autorope/donkeycar/docs/hardware/trooper-top_plate.dxf

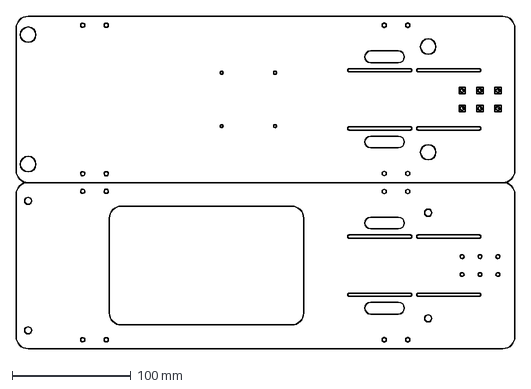
[picture p2: CAD file, 2017-01-28, last stored version]
docs/hardware/trooper-top_plate.dxf
420.0 x 280.0 mm
