autorope/donkeycar/docs/hardware/camera_holder.stl

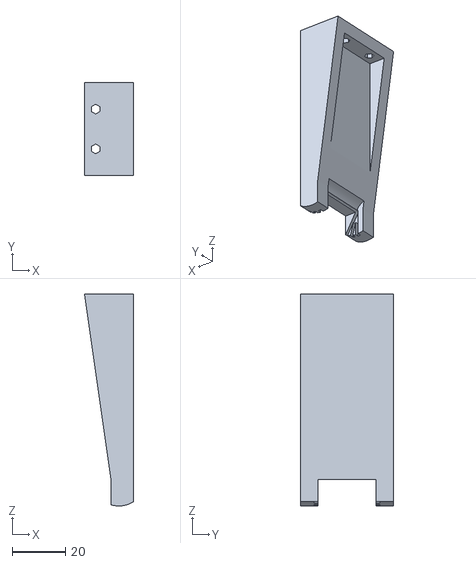
[picture p3: CAD file, 2017-01-10, last stored version]
docs/hardware/camera_holder.stl
18.5 x 35.0 x 80.0
