autorope/donkeycar/docs/hardware/hellion_conquest-roll_bars.stl

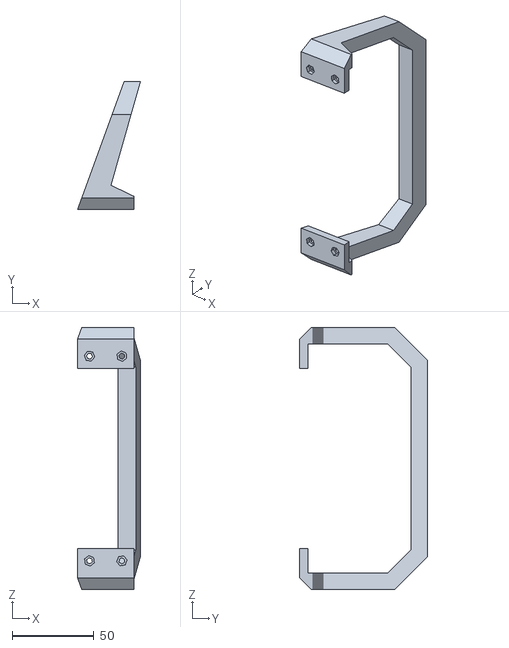
[picture p4: CAD file, 2017-01-10, last stored version]
docs/hardware/hellion_conquest-roll_bars.stl
38.4 x 78.0 x 160.0
