autorope/donkeycar/Hardware/Camera Holder.stl

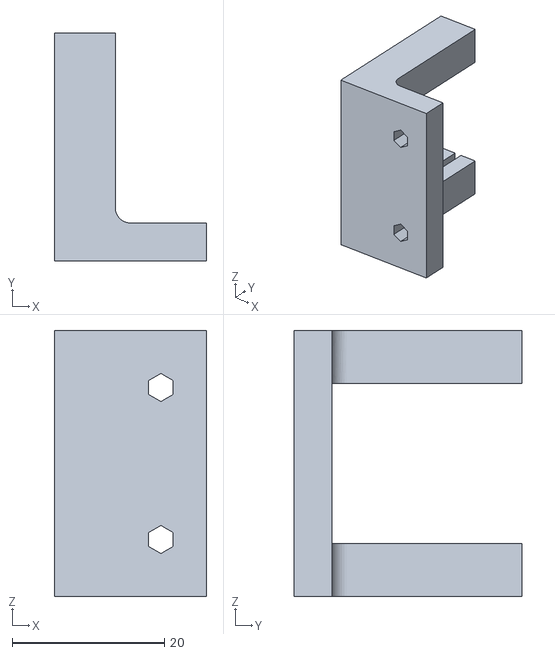
[picture p5: CAD file, 2017-01-10, last stored version]
Hardware/Camera Holder.stl
20.0 x 30.0 x 35.0
