autorope/donkeycar/(list of files, cad)

Other CAD files:
docs/hardware/hellion_conquest-base_plates.dwg
Hardware/Car Top Plate - Helion Conquest.dwg
Hardware/Top And Bottom Plate-Will Car.dwg
docs/hardware/hellion_conquest-top_plate.dwg
hardware/Top And Bottom Plate-Will Car.dwg
