autorope/donkeycar/(threads)

Thread 18 (2017-01-16):

Error while driving. Adafruit servo hat write error.

wroscoe, 2017-01-16:
After driving 10 minutes, the car stopped responding and updating images. This was the error from on the pi.

```
/usr/lib/python3/dist-packages/picamera/encoders.py:545: PiCameraResolutionRoun$
  width, height, fwidth, fheight)))
123
angle: -6   throttle: 46
remote client: {"angle": "-6", "throttle": "46"}
Traceback (most recent call last):
  File "demos/drive_pi.py", line 55, in <module>
    car.start()
  File "/home/pi/code/donkey/donkey/vehicles.py", line 39, in start
    self.steering_actuator.update(angle)
  File "/home/pi/code/donkey/donkey/actuators.py", line 73, in update
    self.pwm.set_pwm(self.channel, 0, pulse)
  File "/home/pi/code/donkey/env/lib/python3.4/site-packages/Adafruit_PCA9685/P$
    self._device.write8(LED0_ON_L+4*channel, on & 0xFF)
  File "/home/pi/code/donkey/env/lib/python3.4/site-packages/Adafruit_GPIO/I2C.$
    self._bus.write_byte_data(self._address, register, value)
  File "/home/pi/code/donkey/env/lib/python3.4/site-packages/Adafruit_PureIO/sm$
    self._device.write(data)
OSError: [Errno 5] Input/output error

```

kclim2, 2017-10-15:
We trying to use arduino to replace the PCA9685 and get similar i2c error. Ant tips to fix the error?

Closed 2017-02-11.

Thread 20 (2017-01-22):

Implement single mixer class instead of separate throttle/steering classes

yconst, 2017-01-22:
A single "mixer" class that handles command distribution to all actuators is more flexible than separate "throttle" and "steering" classes.
For instance in differential or skid steering one should be aware of both the throttle as well as the steering value to assign correct (PWM) values to the actuators

wroscoe, 2017-01-22:
Good point. I think the best place to add this would be as a new vehicle class that provided this awareness for skid steering vehicles in the drive loop. This library has so far focused on cars that steer by angling the front wheels but this would be a great addition. @adammconway may also have thoughts.

adammconway, 2017-01-22:
Hi @yconst are you considering implementing a car based on differential drive using Donkey? am I understanding the request properly? thanks!

yconst, 2017-01-23:
@adammconway yes indeed, I have a differential steering frame available and am thinking of "emulating" the constraints in "regular" car steering by limiting the difference in throttle to the motors on each side/making it proportional to collective throttle.

adammconway, 2017-01-23:
@yconst that is awesome, so glad you are looking to join us.

@wroscoe feels like differential drive should be a different setup... this goes back to how we abstract out the various hardware.  Downstream if we choose to add odometry and other sensors we will also have further differences.  I know that sensors and actuators are separate now, but I think it is possible we will see interplay between them as we add certain sensors.

wroscoe, 2017-01-23:
@yconst this would be great. We were looking to find a vehicle that could compete on the RGB(colored lines) track.

The place to put a new vehicle build would be below the BaseVehicle class here; https://github.com/wroscoe/donkey/blob/master/donkey/vehicles.py#L3 You could inherit the BaseVehicle class and change the drive loop to use the logic specific to the differential drive vehicle.

@adammconway There is no real difference between sensors and actuators. The files are used only for organization.

yconst, 2017-01-25:
@wroscoe , @adammconway I took the liberty of modifying the actuator code to accommodate for mixing. I've pushed the changes in my fork currently:
https://github.com/yconst/donkey/blob/actuator_mixer/donkey/actuators.py

I'm not sure, but I felt an additional level of abstraction between "vehicle" and "hardware" would make for better distribution of tasks. Thus came the mixer class.

There are also changes to the vehicle and demo classes to accommodate the new actuators class.

Please keep in mind, this is all just a concept, nothing is tested yet.

wroscoe, 2017-01-26:
Great!. I made a pull request for this change and will merge once we have both types of cars working on this branch.

yconst, 2017-01-28:
I fixed some errors in the files and separated them in different modules, ie added mixers.py.

Re. actuators, I saw that the current PWM classes inherited from the Adafruit controller base class. I thought that this could be better achieved by composition over inheritance, so in the latest commit I refactored the code a bit, and now the PWM classes take a "controller" as a init parameter. The controller is the fundamental hardware "driver" (in this case the Adafruit controller), and the PWM functionality is abstracted from the hardware.

This way, other controllers (e.g. I'm using a NAVIO hat) can be easily switched without needing to re-write the PWM workings.

Closed 2017-02-09.

Thread 23 (2017-01-25):

Update build instructions.

wroscoe, 2017-01-25:
Include
* How to pick a car + tested models.
* link to ami image
* Wiring diagram + pictures

yconst, 2017-01-27:
Are the current build instructions up to date? Installing to a RPi2 via the docs at https://github.com/wroscoe/donkey/blob/master/docs/01-build_a_car.md and then trying to run drive_pi.py shows an error about missing docopt. Any ideas?

wroscoe, 2017-01-27:
docopt should be installed when you run `pip install -e ../donkey[pi]` in your virtual environment.

That error should be fixable by installing docopt  in your virtual environment
`pip install docopt`

I'm updating the build instructions to be clearer but the current version should work.

wroscoe, 2017-01-27:
@yconst  Here is the in progress build doc. Please suggest update and add pictures. https://docs.google.com/document/d/11IPqZcDcLTd2mtYaR5ONpDxFgL9Y1nMNTDvEarST8Wk/edit#

yconst, 2017-01-27:
Thanks for sharing! I'll sure chime in if I have any suggestions, although I'm still getting to grips with the entirety of the project!

alanwells, 2017-02-07:
@wroscoe Thanks for this great project! I've got my car built up (based on an [ExceedRC Magnet 1/16 scale truck)](http://www.nitrorcx.com/51c853-savared-24-ghz.html) and steering mostly works (angles are a little off wheels move left/right), but throttle doesn't work at all. The error code on the ESC indicates abnormal throttle signal, so I'm thinking it's a PWM calibration issue. I noticed there was some stubbed out calibration code in the `actuators.py`, do you have any suggestions on where to start on figuring out the correct values?

Also, I have a few notes from going thru the donkey install process on car and server. Do you prefer to receive them as suggestions to the Google Doc or in comments here?

Here are a few pics of the build. The 1/16th scale is a bit cramped but it worked out OK. Happy to take better pics for the build document if it's helpful:

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

wroscoe, 2017-02-07:
That car looks awesome.

For doc suggestions please make them in the Google Doc. https://docs.google.com/document/d/11IPqZcDcLTd2mtYaR5ONpDxFgL9Y1nMNTDvEarST8Wk/edit#

@adammconway will know more about ESC settings but i'd using script that loops through all possible ESC values to find the correct range. If the motor is brushed it will likely need to be calibrated by setting full, 0, reverse throttle values. before using.

alanwells, 2017-02-08:
@wroscoe @adammconway got the throttle calibration issue sorted out. I was making the mistake of turning on the ESC before I had the pilot running on the pi, so the ESC couldn't self-calibrate. I added the Exceed Magnet to the tested vehicle list on the google doc.

Closed 2017-02-09.

Thread 55 (2017-03-02):

Improve small screen UI of vehicle control page

alanwells, 2017-03-02:
Here are some initial thoughts on improvements that I think could be made here:
- Switch to gyroscopic control of vehicle steering and throttle (instead of nipple.js), as this will free up significant screen real estate for other controls. The `DeviceOrientationEvent` API seems to have sufficient cross-platform browser support that it could be used reliably on most iOS and Android phones. More info here: https://developer.mozilla.org/en-US/docs/Web/API/DeviceOrientationEvent
- figure out what the "dead zone" of control should be at the middle of the throttle and steering ranges to make it easy to get to zero throttle/zero steering angle without requiring too precise of a device position. i found I had to figure this out with trial and error on an actual device to get a good feel for it
- optimize the layout for widescreen positioning (more intuitive to hold the phone horizontally when you are using the device position as a steering wheel)
- add an easily accessible start/stop button to the screen to avoid the car running off when you set the phone down :wink:
- Take advantage of the extra on-screen real estate to include controls for:
  - Pilot mode selection
  - Model selection
  - Start/Stop recording toggle

wroscoe, 2017-03-02:
This sounds so much better. Additional control to add is to start and name new session.

I think I'm getting worse ad driving with the current joystick.

Closed 2017-04-25.

Thread 57 (2017-03-02):

Implement odometry with hall effect sensor

alanwells, 2017-03-02:
The plan is to attempt an odometer setup inspired by [this post](https://sites.google.com/site/wayneholder/self-driving-rc-car/mechanical-odometry-and-speed-control).

Here's my initial take on how this might work:
- Mount hall effect sensor to car. @adammconway suggested attempting to sense the motor directly, which would imply mounting the sensor in an axial orientation relative to the motor.
- If we can't accurately sense the motor directly, use small magent(s) mounted on the drive shaft or a gear in the drivetrain and mount sensor in an appropriate place given the location of the magnets.
- Connect hall effect sensor signal pin to one of the Pi's GPIO pins that supports interrupt handling
- Connect hall effect power and ground to the corresponding pins on the servo hat

Reading the sensor:
- Configure the interrupt on the Pi with a [callback function](http://raspi.tv/2013/how-to-use-interrupts-with-python-on-the-raspberry-pi-and-rpi-gpio-part-2) (aka ISR - interrupt service routine) that is called when the sensor signal pin changes state. The minimum here would be to read a single state change (RISING or FALLING), additional precision could be achieved by configuring the interrupt to track both rising and falling changes.
- Inside the ISR, update variables for tracking state changes (those that will need to be read by the drive loop will need to be global):
  - (local) Timestamp of previous state change
  - (global) Time elapsed between previous state change and current state change
  - (global) Total count of state changes

Calculating distance and speed:
- Distance traveled will be informed by the relationship between the point in the drive train that is being monitored by the hall effect sensor and the physical distance traveled by the car for 1 cycle (or one half cycle if we monitor both rising and falling edges) of the hall effect sensor signal. We'll need some constant to tie these two together (something like "feet per hall sensor state change"), which will be vehicle specific. Perhaps this is a new addition to the vehicle config file?
- Velocity will be calculated using the distance above divided by the elapsed time that was recorded in the ISR. Calculating speed using the time elapsed from only the most recent sensor cycle would yield the most recent velocity, but we might find that averaging this over several cycles to yield an average velocity over a slightly longer time period would smooth out the data a bit. Let's start with the 1 cycle calculation and then we can adjust if needed.

Sending distance and velocity back to server:
- TBD @wroscoe do you have any thoughts here?

@wroscoe @adammconway does the above approach sound reasonable to you? Do you have preferences on the units used for distance and velocity?

adammconway, 2017-03-02:
Hi @alanwells, this seems to make sense... I will try something similar for the brushless motor, which might be easier because the rotor is actually a magnet.

As I have thought about how a brushed motor works, it may be hard to get this to work (at a specific location on the can, the coil probably only rotates 60 or 120 degrees, this may not be a big enough change in the b field to trigger the hall effect sensor.  Anyways... still worth experimenting.

What I found with my ESC tests for the brushless motor controller (not the sensored one) was that there is Hysteresis between acceleration and deceleration, this probably means that you will need to implement a pretty aggressive control loop.  I would suggest a PID loop, just keep in mind that this requires a lot of fiddling with the various Gains to get this to work.  I am happy to help with this/code the PID.

alanwells, 2017-03-03:
I failed to notice that the [hall effect sensor from SparkFun](https://www.sparkfun.com/products/9312) will need a level shifter to work directly with the pi's 3.3V logic level pins. I don't have the level shifter parts on hand, so I won't be able to test this tomorrow at the track day. I will bring the parts I ordered, if any of you have a level shifter ([something like this](https://www.sparkfun.com/products/12009)), we might be able to get it hooked up.

alanwells, 2017-03-03:
@adammconway Thanks for the advice here. I've never implemented a PID loop, your help would be much appreciated.

alanwells, 2017-05-08:
@adammconway @wroscoe I have my hall effect sensor mounted and the circuit is working w/ state changes triggered by magnets mounted on the drive shaft. Now it's on to the software side. I think there are at least four pieces to this:

1) Additions to vehicle.ini that enables odometry and defines the wheel circumference to use for distance calculations.
2) An interrupt that counts the wheel rotations and timing data using the output from the hall effect sensor and stores the data in a (global?) variable that can be accessed by the main drive loop
3) A method that calculates velocity based on the last n number of wheel revolutions (as tracked by the interrupt), the timestamps of those state changes, and the circumference of the wheel provided in vehicle.ini.
4) A PID controller class. I think this needs to take current PWM, current velocity, and target velocity as inputs, and should output the new PWM value.
5) Possibly some feedback mechanism to pass velocity (and distance traveled?) back to the server for display in the controller UI, and to be used for labeling images (so we can attempt to train the model to infer velocity w/o hall effect sensor).

Questions for you guys:
1) Does the above description sound reasonable? Are there any modifications that you would suggest?
2) Should we calculate velocity based on only the last rotation or average it over a number of rotations (possibly less precise but likely also less noisy?)
3) From an architecture perspective, it seems like the PID controller should be it's own class, which will then be an optional input into the initialization of vehicle object created [here](https://github.com/wroscoe/donkey/blob/master/scripts/drive.py#L62) in `drive.py` (optional because not every car will have odometry). Does this sound right?

adammconway, 2017-05-08:
I think a float that is something like rising and falling edges per meter or something like that would make sense… I can imagine designs that will have multiple pulses per revolution and also there is a gear ratio between input into the differential and output.

wroscoe, 2017-08-14:
I believe this was implemented with a rotory encoder and is included as a part.

Closed 2017-08-14.

Thread 76 (2017-03-22):

Error starting drive.py

rlyons20, 2017-03-22:
I've tested my motors, using the Adafruit example scripts, and everything is working.

When I get to the last step of starting the remote control, this is the response:

`Traceback (most recent call last):
  File "scripts/drive.py", line 32, in <module>
    mythrottlecontroller = dk.actuators.PCA9685_Controller(cfg['throttle_actuator_channel'])
  File "/home/bob/donkey/donkey/actuators.py", line 34, in __init__
    self.pwm = Adafruit_PCA9685.PCA9685()
  File "/home/bob/donkey/env/lib/python3.4/site-packages/Adafruit_PCA9685/PCA9685.py", line 75, in __init__
    self.set_all_pwm(0, 0)
  File "/home/bob/donkey/env/lib/python3.4/site-packages/Adafruit_PCA9685/PCA9685.py", line 111, in set_all_pwm
    self._device.write8(ALL_LED_ON_L, on & 0xFF)
  File "/home/bob/donkey/env/lib/python3.4/site-packages/Adafruit_GPIO/I2C.py", line 114, in write8
    self._bus.write_byte_data(self._address, register, value)
  File "/home/bob/donkey/env/lib/python3.4/site-packages/Adafruit_PureIO/smbus.py", line 236, in write_byte_data
    self._device.write(data)
OSError: [Errno 5] Input/output error`

wroscoe, 2017-03-22:
I haven't seen this error before but others (outside this project) have had that error:
* http://stackoverflow.com/questions/30325351/ioerror-errno-5-input-output-error-while-using-smbus-for-analog-reading-thr
* https://www.raspberrypi.org/forums/viewtopic.php?f=44&t=17295

I suspect you have a process already using the I2C that conflicts with the attempted write. Try restarting "sudo restart' the pi.

rlyons20, 2017-03-22:
I've restarted a bunch :(

I am using this stepper hat (https://www.adafruit.com/products/2348), instead of the one you spec in your build. Think that might be a problem?

wroscoe, 2017-03-22:
Yes. Thats the motor hat for a differential drive car (one that uses DC motors).

Closed 2017-03-23.

Thread 93 (2017-07-03):

JSON decoder error on startup, fixed by restarting server

twhume, 2017-07-03:
Occasionally when starting drive.py on the Pi, I would see the following error:

pi@raspberrypi:~/donkey $ python scripts/drive.py --remote http://172.20.10.5:8887
Detected running on rasberrypi. Only importing select modules.
Using TensorFlow backend.
center: 410
PiVideoStream loaded.. .warming camera
/usr/lib/python3/dist-packages/picamera/encoders.py:544: PiCameraResolutionRounded: frame size rounded up from 160x120 to 160x128
  width, height, fwidth, fheight)))
Exception in thread Thread-2:
Traceback (most recent call last):
  File "/usr/lib/python3.4/threading.py", line 920, in _bootstrap_inner
    self.run()
  File "/usr/lib/python3.4/threading.py", line 868, in run
    self._target(*self._args, **self._kwargs)
  File "/home/pi/donkey/donkey/remotes.py", line 79, in update
    self.state['milliseconds'],)
  File "/home/pi/donkey/donkey/remotes.py", line 140, in decide
    data = json.loads(r.text)
  File "/usr/lib/python3.4/json/__init__.py", line 318, in loads
    return _default_decoder.decode(s)
  File "/usr/lib/python3.4/json/decoder.py", line 343, in decode
    obj, end = self.raw_decode(s, idx=_w(s, 0).end())
  File "/usr/lib/python3.4/json/decoder.py", line 361, in raw_decode
    raise ValueError(errmsg("Expecting value", s, err.value)) from None
ValueError: Expecting value: line 1 column 1 (char 0)

I've not managed to get repro steps; I found that restarting the Docker container and then retrying the drive.py script with the same arguments worked.

wroscoe, 2017-08-14:
This is an issue when non-json chars or sequences are passed. I haven't seen this recently in the new version.

Closed 2017-08-14.

Thread 107 (2017-08-07):

Feature request - Servo control via PPM instead of I2C

dlarue, 2017-08-07:
There have been some comments about swapping in/out the stock RC controller and since there are only 2 servo controls used( steering / throttle ) an Arduino could do this.  But since the rPi has only 1 hardware PWM, it would be more efficient to stream the servo control via a single PPM stream. This way an Arduino could decode the PPM and drive the servo's.  And with a single digial I/O flag/pin the Arduino could read and use the stock RC receiver signals for training.

zlite, 2017-08-07:
That's what we do with OpenMV, and the Arduino allows both multichannel PWM
output and a wide range of inputs (analog, digital, serial, etc).  We
implement Firmata <https://www.arduino.cc/en/Reference/Firmata> on the
Arduino side, and recommend that be used as the the middleware standard for
I/O.

A standard Arduino Pi ha
<http://www.robotshop.com/en/arduino-adapter-raspberry-pi.html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>t
can work, although a custom shield like we designed for the OpenMV
<https://circuits.io/circuits/4446963-openmv-arduino-shield> simplifies the
wiring.

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

--
◤*CHRIS ANDERSON <https://twitter.com/chr1sa>*
    CEO
    3DR
    website <http://www.3dr.com/> | twitter <https://twitter.com/3drobotics>
 | facebook <http://www.facebook.com/3drobotics> | instagram
<http://www.instagram.com/3drobotics>

dlarue, 2017-08-07:
The more I thought about it, I think keeping I2C from the rPi makes sense since all I'm looking to do is add simple RC control back and if I can do it with a $3 ProMini and replace the Servo Driver($12) too then it's a feature improvement and cost cutter.  The RC control could also enable a remote kill switch via a 3rd channel.

As for adding sensors, an Arduino with Firmata sounds interesting. I'm only familiar with Firmata by using it with Snap4Arduino(Scratch for Arduino).  And idea to keep in the back pocket. Thanks.

Closed 2017-08-21.

Thread 112 (2017-08-21):

VNH5019 and direct control via GPIO

wallarug, 2017-08-21:
Hey,

I'm working on using a Polulu Dual VNH5019 Motor Driver Shield with the donkey car code.  How easy do you think it will be to integrate it to the actuators.py and the project as a whole?

I am in the process of writing a driver similar to the adafruit PCA9685 python library for the VNH5019.  However, the one key difference is that the VNH5019 does not have I2C... it would require using the Raspberry Pi GPIO directly.  From what I can see here, this has not been done before for this project.

I haven't had enough time to comb through all the code on here, so please point me in the right direction if this is functionality already implemented.

1. Can I implement my driver to use the GPIO pins directly (not I2C) with the existing code?
2. How / if the driving component would work under this method?

Thanks in advance.

PS:  Great project and body of code!

wroscoe, 2017-08-21:
This sounds doable and there are examples of accessing the GPIO channels from python. https://sourceforge.net/p/raspberry-gpio-python/wiki/BasicUsage/

To implement you'd create a new actuator part class like those listed here: https://github.com/wroscoe/donkey/blob/master/donkeycar/parts/actuators/actuators.py

Then just use that part in your car script instead of the current actuator. https://github.com/wroscoe/donkey/blob/master/donkeycar/templates/donkey2.py#L75

What are the advantages of this proposed change?

wallarug, 2017-08-22:
Hey @wroscoe ,

Thanks for getting back to me.

The only advantage of this proposed change is improved portability between different hardware for the project as a whole.   The VNH5019 is a very powerful motor driver (12 Amps) which could be helpful for people who want to make faster cars.  This could also open up the possibility for documentation for others to write drivers for other chips to work with the donkey car project.

I'm happy to implement this enhancement, since you have highlighted the relevant sections that can be changed above.  I will let you know once I am done and you can decide to include the enhancement or not.

wallarug, 2017-09-29:
Hey @wroscoe,

I've made significant progress on my driver for this device.  I'm just testing it at the moment to make sure that it works as expected.  I'll update you when it is working.

arunderwood, 2017-10-23:
@wallarug I'm currently working on wiring up a dual VNH2SP30 board to a PowerWheels car, so your progress on abstracting hardware support is very interesting to me.  I'm curious, what are you hooking the VNH5019 up to?

wallarug, 2017-10-23:
Hey @arunderwood ,

I have it all working and hocked up to the Raspberry Pi's GPIO pins.  I think my motor shield is playing up a bit.  If you could test it that would be great.

I've dumped all the code onto the repository here:  https://github.com/wallarug/donkey-vnh5019

Feel free to contact me if you need any help.

arunderwood, 2017-10-23:
@wallarug awesome!  I'm new to the Donkey codebase so it will take me a little bit to wrap my head around everything.

What are your thoughts on forking wroscoe/donkey and making the hardware abstraction changes on the fork?  That way it's easier for me/others checkout the code and run it all in one go, and those changes can be PR'ed back to mainline if we can get it to a state Will is happy with.

wallarug, 2017-10-28:
Hey @arunderwood ,

I'm happy to do that, but it will have to wait. I'll create a pull request and add all my code when I get some free time.

tawnkramer, 2019-06-12:
closing due to inactivity. please open if there is more to discuss.

Closed 2019-06-12.

Thread 118 (2017-09-07):

UnicodeDecodeError: 'utf-8' codec can't decode byte 0xe3 in position 3: invalid continuation byte

JCStarry, 2017-09-07:
I built a donkey car by myself ,and just fellow the steps on "http://www.donkeycar.com/" . I use donkey_2.image for raspberry pi3. I can run the "python3 manage.py  drive " normally and record data for training a autopilot model , but when I run " python3 manage.py train",always get a " UnicodeDecodeError". does any one meet the same error before? and how can I fix it , thank a lot!

(env)pi@raspberrypi:~/d2 $ python3 manage.py train --tub=tub_7_17-08-28 --model=models
Using TensorFlow backend.
Tub does exist
/home/pi/donkeycar/donkeycar/parts/ml/keras.py:56: UserWarning: The semantics of the Keras 2 argument `steps_per_epoch` is not the same as the Keras 1 argument `samples_per_epoch`. `steps_per_epoch` is the number of batches to draw from the generator at each epoch. Basically steps_per_epoch = samples_per_epoch/batch_size. Similarly `nb_val_samples`->`validation_steps` and `val_samples`->`steps` arguments have changed. Update your method calls accordingly.
  nb_val_samples=steps*.2)
/home/pi/donkeycar/donkeycar/parts/ml/keras.py:56: UserWarning: Update your `fit_generator` call to the Keras 2 API: `fit_generator(<generator..., validation_data=None, callbacks=[<keras.ca..., steps_per_epoch=10, verbose=1, validation_steps=2.0, epochs=100)`
  nb_val_samples=steps*.2)
Epoch 1/100
Exception in thread Thread-1:
Traceback (most recent call last):
  File "/usr/lib/python3.4/threading.py", line 920, in _bootstrap_inner
    self.run()
  File "/usr/lib/python3.4/threading.py", line 868, in run
    self._target(*self._args, **self._kwargs)
  File "/home/pi/env/lib/python3.4/site-packages/keras/utils/data_utils.py", line 560, in data_generator_task
    generator_output = next(self._generator)
  File "/home/pi/donkeycar/donkeycar/parts/stores/tub.py", line 214, in train_gen
    batch = next(batch_gen)
  File "/home/pi/donkeycar/donkeycar/parts/stores/tub.py", line 198, in batch_gen
    record_list.append(next(record_gen))
  File "/home/pi/donkeycar/donkeycar/parts/stores/tub.py", line 185, in record_gen
    record = self.get_record(i)
  File "/home/pi/donkeycar/donkeycar/parts/stores/tub.py", line 149, in get_record
    json_data = self.get_json_record(ix)
  File "/home/pi/donkeycar/donkeycar/parts/stores/tub.py", line 112, in get_json_record
    json_data = json.load(fp)
  File "/usr/lib/python3.4/json/__init__.py", line 265, in load
    return loads(fp.read(),
  File "/home/pi/env/lib/python3.4/codecs.py", line 313, in decode
    (result, consumed) = self._buffer_decode(data, self.errors, final)
UnicodeDecodeError: 'utf-8' codec can't decode byte 0xe3 in position 3: invalid continuation byte

 1/10 [==>...........................] - ETA: 128s - loss: 7.0849 - angle_out_loss: 7.8323 - throttle_out_loss: 0.3589Traceback (most recent call last):
  File "manage.py", line 148, in <module>
    train(tub, model)
  File "manage.py", line 124, in train
    kl.train(train_gen, None, saved_model_path=model_path)
  File "/home/pi/donkeycar/donkeycar/parts/ml/keras.py", line 56, in train
    nb_val_samples=steps*.2)
  File "/home/pi/env/lib/python3.4/site-packages/keras/legacy/interfaces.py", line 87, in wrapper
    return func(*args, **kwargs)
  File "/home/pi/env/lib/python3.4/site-packages/keras/engine/training.py", line 1809, in fit_generator
    generator_output = next(output_generator)
StopIteration

tawnkramer, 2017-09-18:
You will want to move the data set to your pc for training. Please check http://docs.donkeycar.com/guide/train_autopilot/

JCStarry, 2017-09-20:
Thanks for your reply ! !, I have tried to move the data set to my Ubuntu PC. I  have installed  latest donkeycar and tensorflow . but when I use the same commands to train a pilot model I always get the same error "UnicodeDecodeError: 'utf-8' codec can't decode byte 0xa0 in position 2: invalid start byte"

I don't how to do next , expecting any reply , thanks a lot!

JCStarry, 2017-09-20:
I also tried to install donkeycar and TensorFlow in virtualenv ,but same errors    = =!

tawnkramer, 2017-09-20:
You can not specify a dir as the output file.
```python3 manage.py train --tub=tub_7_17-08-28 --model=models```
should be
```python3 manage.py train --tub=tub_7_17-08-28 --model=mymodel.h5```

JCStarry, 2017-09-21:
Thanks for your reply！！I have tried the command as your advice，but the same “utf-8” error 。。QAQ
here is the detail。。= =!

`(tensorflow) jc@jc-pc:~/ProjectX/donkey_car/d6$ python3 manage.py train --tub=tub_7_17-08-28  --model=mymodel.h5
Using TensorFlow backend.
loading config file: /home/jc/ProjectX/donkey_car/d6/config.py
config loaded
Tub does exist
Epoch 1/100
2017-09-21 12:00:02.482846: W tensorflow/core/platform/cpu_feature_guard.cc:45] The TensorFlow library wasn't compiled to use SSE4.1 instructions, but these are available on your machine and could speed up CPU computations.
2017-09-21 12:00:02.482873: W tensorflow/core/platform/cpu_feature_guard.cc:45] The TensorFlow library wasn't compiled to use SSE4.2 instructions, but these are available on your machine and could speed up CPU computations.
2017-09-21 12:00:02.482880: W tensorflow/core/platform/cpu_feature_guard.cc:45] The TensorFlow library wasn't compiled to use AVX instructions, but these are available on your machine and could speed up CPU computations.
2017-09-21 12:00:02.482887: W tensorflow/core/platform/cpu_feature_guard.cc:45] The TensorFlow library wasn't compiled to use AVX2 instructions, but these are available on your machine and could speed up CPU computations.
2017-09-21 12:00:02.482895: W tensorflow/core/platform/cpu_feature_guard.cc:45] The TensorFlow library wasn't compiled to use FMA instructions, but these are available on your machine and could speed up CPU computations.
Exception in thread Thread-1:
Traceback (most recent call last):
  File "/usr/lib/python3.5/threading.py", line 914, in _bootstrap_inner
    self.run()
  File "/usr/lib/python3.5/threading.py", line 862, in run
    self._target(*self._args, **self._kwargs)
  File "/usr/local/lib/python3.5/dist-packages/keras/utils/data_utils.py", line 568, in data_generator_task
    generator_output = next(self._generator)
  File "/home/jc/ProjectX/donkey_car/d6/donkeycar/donkeycar/parts/stores/tub.py", line 222, in train_gen
    batch = next(batch_gen)
  File "/home/jc/ProjectX/donkey_car/d6/donkeycar/donkeycar/parts/stores/tub.py", line 206, in batch_gen
    record_list.append(next(record_gen))
  File "/home/jc/ProjectX/donkey_car/d6/donkeycar/donkeycar/parts/stores/tub.py", line 193, in record_gen
    record = self.get_record(i)
  File "/home/jc/ProjectX/donkey_car/d6/donkeycar/donkeycar/parts/stores/tub.py", line 157, in get_record
    json_data = self.get_json_record(ix)
  File "/home/jc/ProjectX/donkey_car/d6/donkeycar/donkeycar/parts/stores/tub.py", line 120, in get_json_record
    json_data = json.load(fp)
  File "/usr/lib/python3.5/json/__init__.py", line 265, in load
    return loads(fp.read(),
  File "/home/jc/tensorflow/lib/python3.5/codecs.py", line 321, in decode
    (result, consumed) = self._buffer_decode(data, self.errors, final)
UnicodeDecodeError: 'utf-8' codec can't decode byte 0xa0 in position 2: invalid start byte

  1/100 [..............................] - ETA: 138s - loss: 5.1415 - angle_out_loss: 5.7123 - throttle_out_loss: 0.3831Traceback (most recent call last):
  File "manage.py", line 172, in <module>
    train(cfg, tub, model)
  File "manage.py", line 145, in train
    kl.train(combined_gen(train_gens), combined_gen(val_gens), saved_model_path=model_path)
  File "/home/jc/ProjectX/donkey_car/d6/donkeycar/donkeycar/parts/ml/keras.py", line 61, in train
    validation_steps=steps*.2)
  File "/usr/local/lib/python3.5/dist-packages/keras/legacy/interfaces.py", line 87, in wrapper
    return func(*args, **kwargs)
  File "/usr/local/lib/python3.5/dist-packages/keras/engine/training.py", line 2011, in fit_generator
    generator_output = next(output_generator)
StopIteration`

tawnkramer, 2017-09-21:
Can you share your dataset somewhere on Dropbox or google drive? I'd like
to see if we get the same error.

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

JCStarry, 2017-09-22:
Thanks a lot!!
my dataset folder is tub_7_17-08-28,  below is the google drive link , the dataset is in a .zip file

[https://drive.google.com/open?id=0B5OxKaalqD0ARERHTVd5Q1pLclk](url)

tawnkramer, 2017-09-25:
I'm taking a look now. I was able to reproduce the problem. It looks like about 30 or so of your records from record_4530.json to 4345 have bad characters. Did you edit or run any scripts on your data after recording?

tawnkramer, 2017-09-25:
can you try a ```git pull``` in donkey and get latest. Then try regenerating your manage.py in a new dir with ```donkey createcar --path ~/d3```. Move your data to the ~/d3/data dir, then run the new command
```python manage.py clean --fix```. This command will find and remove bad records. Then try running training.

tawnkramer, 2017-09-25:
please do let us know if this is happening a lot for you. I haven't seen this reported before. Would be ideal to fix cause instead of removing bad records.

Closed 2017-09-29.

Thread 220 (2018-03-08):

Required parts: Usb battery link is broken

tmandekic, 2018-03-08:
Link for the usb battery is broken and I'm (a newbie in hardware assembly and) not sure what can I substitute it with.
Not working: https://www.amazon.com/gp/product/B00P7N0320?tag=donkeycar-20
Could please provide a link to usb battery that can be used for assembly?
Thanks in advance!

wroscoe, 2018-03-08:
Thanks. I'll fix this soon.

Bleyddyn, 2018-03-12:
Not sure where else to ask this. Do you know if that battery can be charged at the same time it's being used to power the Raspberry Pi? A lot of USB phone charging batteries don't work that way and the Amazon pages rarely if ever mention it. It's not a deal breaker but I find it's incredibly useful to be able to charge the battery while still working on the robot.

wroscoe, 2018-03-12:
This battery can not be charged at the same time as you use it. :\

scitronboy, 2018-03-15:
Bleyddyn, you shouldn't even need to do that. if you have it connected with
a USB cord in the first place, why don't you just use one USB cord to
charge the battery and a second USB cord for the raspberry pi??

Bleyddyn, 2018-03-15:
@scitronboy I may not be understanding what you're suggesting. I have mains->battery and battery->rPi at the same time. With my old-no-longer-available PowerGen battery that works. With lots of other batteries it doesn't. As soon as you plug mains power into the battery to start charging it, the battery shuts off its power to the rPi.

So in order to use other batteries I have to: shut down the rPi, rearrange USB cables so they are both plugged into mains and reboot the rPi, then when I want to switch back to battery power I need to shut down the rPi again, rearrange cables and reboot.

Closed 2018-03-08.

Thread 230 (2018-03-24):

Raspberry pi 3 B+ boot problem

onukadri, 2018-03-24:
Prebuilty zipped disk image is not work on Raspberry pi 3 B+. Flashes red light and wont boot.

wroscoe, 2018-03-24:
wow, you already have one. I'm working on updating the disk image and will post a script here.. https://github.com/wroscoe/donkey/blob/wr/disk_img_script/install/make_pi_disk_img.sh

onukadri, 2018-03-24:
I was waiting for this device and got one immediately. Thanks for fast
response.

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

onukadri, 2018-03-27:
hello again i have been getting this error "ImportError: numpy.core.multiarray failed to import", while using "donkey calibrate --channel 0" this line. i guess something wrong about numpy. i deleted and reinstalled numpy but no solution.

wroscoe, 2018-03-27:
https://stackoverflow.com/questions/20518632/importerror-numpy-core-multiarray-failed-to-import

try numpy 1.8?

onukadri, 2018-03-27:
https://stackoverflow.com/questions/17709641/valueerror-numpy-dtype-has-the-wrong-size-try-recompiling

Answer of RexFuzzle works for me. thanks

onukadri, 2018-03-27:
Now calibrate is working, my motor and servo are calibrated. however new error while "python manage.py drive" :

tensorflow.python.framework.errors_impl.NotFoundError: /home/pi/env/lib/python3.5/site-packages/tensorflow/contrib/data/python/ops/../../_prefetching_ops.so: undefined symbol: _ZN6google8protobuf8internal26fixed_address_empty_stringB5cxx11E

wroscoe, 2018-03-27:
It would be helpful to see where in donkey that was getting called. On my Pi B the drive script is working. Haven't tried autopilots yet with this TF 1.5.

onukadri, 2018-03-27:
tensorflow 1.4.1 works well. thanks

MoreAJ, 2018-05-13:
Hey guys completely new to Raspberry pi's and donkeycars and im glad to have seen this issue posted. I am having the same issue where the prebuilt zipped disk image is not booting with our Raspberry pi so it is blinking red. Power supply is goood, Wroscoe where can i find a newer/updated version of this file? Or how can i do this properly? I am a complete noob!! Thank you

chinaq, 2018-05-16:
I am having the same issue.

meurig, 2018-05-21:
Just to say I was getting a similar but slightly different error:

`tensorflow.python.framework.errors_impl.NotFoundError: /home/pi/env/lib/python3.5/site-packages/tensorflow/contrib/data/python/ops/../../_dataset_ops.so: undefined symbol: _ZN6google8protobuf8internal9ArenaImpl10AddCleanupEPvPFvS3_E`

Following onukadri's suggestion of uninstalling tensorflow (I was on 1.7.0) and installing tesorflow 1.4.1 fixed it.

```
pip uninstall tensorflow
tf_file=tensorflow-1.4.1-cp35-none-linux_armv7l.whl
wget https://github.com/lhelontra/tensorflow-on-arm/releases/download/v1.4.1/${tf_file}
pip install ${tf_file}
rm ${tf_file}
```

I wasn't using an image, but instead installed by using this script as a guide:
https://github.com/wroscoe/donkey/blob/wr/disk_img_script/install/make_pi_disk_img.sh

scitronboy, 2018-05-22:
I used that script too. Almost ready to test, we'll see if it works.... I installed tensorflow 1.7 I think, on raspbian stretch, so I don't know if that will work.

meurig, 2018-05-22:
I’m on stretch lite if that helps

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
--
Meurig

scitronboy, 2018-05-22:
It worked! I successfully installed opencv 3.4.1, tensorflow 1.4.1, and donkey on raspbian stretch.

wroscoe, 2018-07-31:
I've taken opencv out of the image. We're going pure tensor! :)  Here is the new install script... https://github.com/wroscoe/donkey/blob/dev/install/pi/install.sh

Closed 2018-07-31.

Thread 250 (2018-05-08):

Compability

MoreAJ, 2018-05-08:
Hey guys im new to Donkeycar and was hoping to get some feedback...i am aware of all the components needed to assemble this and would like to know if a Raspberry Pi 3 B+ will be compatible for doing this. I noticed some people use a Motherboard B or just a regular B model so i wanted to make sure a B+ will be fine. Please let me know!

MoreAJ, 2018-05-10:
Can anybody clarify this?

scitronboy, 2018-05-10:
Yes, donkey will work with a pi b+.

scitronboy, 2018-05-11:
See this commit: [Update the disk image to use tensorflow 1.7 and support pi3b+](https://github.com/wroscoe/donkey/pull/245)     Also, if your willing to put some work into it , you can make your own disk image with [this script](https://github.com/wroscoe/donkey/blob/wr/disk_img_script/install/make_pi_disk_img.sh). I had problems getting it working, mainly with compiling opencv, but I eventually got it.

MoreAJ, 2018-05-13:
thanks for the response scitronboy however, were having issues where we have been following the steps on donkeycar's website for setting up the Pi, and we cannot seem to find it on theWifi network on Ubuntu. We tried using the commands "findcar" "ping d2.local" "pingraspberrypi.local" in Ubuntu to try to locate the Raspberry pi. We did notice that the red light on the pi is flashing which i am not sure if it is supposed to. We loaded the SD card with the wifi text editor file containing our network name/pw and also completed the steps before it. Any idea as to why were having this issue? We are going to try plugging in a USB keyboard/mouse to see if it works. Let me know if you can give us some feedback! Thanks

scitronboy, 2018-05-13:
When you turn the pi on, you should see the green light turn in then start flickering. If you don't, it means the pi is not booting. If the green light flashes **solidly** a certain number of times then turns off, like on-off-on-off-on-off, it means that something is wrong with the sd card image. But, because of the red led flashing, it looks like you problem is power, not any of the above.

MoreAJ, 2018-05-13:
Oh i see that really explains alot...so it seems that the SD card image isnt working. Were complete noobs at this and currently trying to build this step by step. Im not sure where we went wrong but we followed the steps from Donkeycar's website as listed below:

**"Get the Raspberry Pi working.
Before we can do anything we have to get our car's computer connected to the internet. The fastest way is to use the disk image created for donkey cars.

The method for using a disk image to create a bootable SD card varies between operating systems. These instructions are for Ubuntu but you can see more instructions here.

Download prebuilt zipped disk image (1.1GB).
Unzip the disk image.
Plug your SD card into your computer.
Open the "Startup Disk Creator" application.
Select your source disk image as the one you unzipped earlier.
Select your SD card as the disk to use.
Click "Make startup disk".
Setup the Pi's WiFi for first boot
We can create a special file which will be used to login to wifi on first boot. More reading here, but we will walk you through it.

On Windows, with your memory card image burned and memory disc still inserted, you should see two drives, which are actually two partitions on the mem disc. One is labeled boot. On Mac and Linux, you should also have access to the boot partition of the mem disc. This is formated with the common FAT type and is where we will edit some files to help it find and log-on to your wifi on it's first boot.

Start a text editor: gedit on Linux. Notepad on Windows. TextEdit on a Mac.
Paste and edit this contents to match your wifi:
country=US
ctrl_interface=DIR=/var/run/wpa_supplicant GROUP=netdev
update_config=1

network={
    ssid="<your network name>"
    psk="<your password>"
}

Replace <your network name> with the ID of your network. Leave the quotes. I've seen problems when the network name contained an apostrophe, like "Joe's iPhone". Replace <your password> with your password, leaving it surrounded by quotes. If it bothers you to leave your password unencrypted, you may change the contents later once you've gotten the pi to boot and log-in.

Save this file to the root of boot partition with the filename wpa_supplicant.conf. On first boot, this file will be moved to /etc/wpa_supplicant/wpa_supplicant.conf where it may be edited later.
Setup Pi's Hostname
We can also setup the hostname so that your Pi easier to find once on the network. If yours is the only Pi on the network, then you can find it with

ping d2.local
once it's booted. If there are many other Pi's on the network, then this will have problems. If you are on a Linux machine, or are able to edit the UUID partition, then you can edit the /etc/hostname and /etc/hosts files now to make finding your pi on the network easier after boot. Edit those to replace raspberrypi with a name of your choosing. Use all lower case, no special characters, no hyphens, no underscores _.

sudo vi /media/userID/UUID/etc/hostname
sudo vi /media/userID/UUID/etc/hosts
Now you're SD card is ready. Eject it from your computer, put it in the Pi and plug in the Pi.**"

**So this is what we followed^ we took donkeys zipped disk image and extracted it then used Etcher to upload it onto the SD card. We then copied and pasted the network coding and created our own Network name and password. Im not sure what were doing wrong. Are we supposed to have Raspbian or Ubuntu downloaded onto the Pi board itself?

MoreAJ, 2018-05-14:
Id also like to note that we just bought the advised Anker battery on Donkeys website...so i do not think we should have issues with power anymore. I am starting to think it really is the disk image...is there an updated image somewhere??

wroscoe, 2018-05-14:
The disk image that came with my RPiB+ did the same thing and didn't work. I had to get a new SD card and make my own disk image to get around this power (?) issue.

Closed 2018-05-14.

Thread 292 (2018-08-19):

Problems with manage.py

miles-nash, 2018-08-19:
After executing 'python manage.py drive' this is what the terminal produced these messages.

'
/usr/lib/python3/dist-packages/h5py/__init__.py:34: FutureWarning: Conversion of the second argument of issubdtype from `float` to `np.floating` is deprecated. In future, it will be treated as `np.float64 == np.dtype(float).type`.
  from ._conv import register_converters as _register_converters
loading config file: /home/pi/mycar/config.py
config loaded
mmal: mmal_vc_component_create: failed to create component 'vc.ril.camera' (1:ENOMEM)
mmal: mmal_component_create_core: could not create component 'vc.ril.camera' (1)
Traceback (most recent call last):
  File "/home/pi/env/lib/python3.5/site-packages/picamera/camera.py", line 456, in _init_camera
    self._camera = mo.MMALCamera()
  File "/home/pi/env/lib/python3.5/site-packages/picamera/mmalobj.py", line 2279, in __init__
    super(MMALCamera, self).__init__()
  File "/home/pi/env/lib/python3.5/site-packages/picamera/mmalobj.py", line 633, in __init__
    prefix="Failed to create MMAL component %s" % self.component_type)
  File "/home/pi/env/lib/python3.5/site-packages/picamera/exc.py", line 184, in mmal_check
    raise PiCameraMMALError(status, prefix)
picamera.exc.PiCameraMMALError: Failed to create MMAL component b'vc.ril.camera': Out of memory

During handling of the above exception, another exception occurred:

Traceback (most recent call last):
  File "manage.py", line 190, in <module>
    drive(cfg, model_path = args['--model'], use_joystick=args['--js'], use_chaos=args['--chaos'])
  File "manage.py", line 46, in drive
    cam = PiCamera(resolution=cfg.CAMERA_RESOLUTION)
  File "/home/pi/env/lib/python3.5/site-packages/donkeycar/parts/camera.py", line 18, in __init__
    self.camera = PiCamera() #PiCamera gets resolution (height, width)
  File "/home/pi/env/lib/python3.5/site-packages/picamera/camera.py", line 431, in __init__
    self._init_camera(camera_num, stereo_mode, stereo_decimate)
  File "/home/pi/env/lib/python3.5/site-packages/picamera/camera.py", line 460, in _init_camera
    "Camera is not enabled. Try running 'sudo raspi-config' "
picamera.exc.PiCameraError: Camera is not enabled. Try running 'sudo raspi-config' and ensure that the camera has been enabled.
'

If anyone has any idea of how this happened and how to fix it it would be greatly appreciated.

alexa1287, 2018-08-20:
May be your camera is defective

distractedDave, 2018-08-24:
I see this both when the camera ribbon cable is backwards on one side, or when a ribbon cable gets broken.  Did you find the solution?

distractedDave, 2018-08-24:
Also this issue can happen if the screws on the camera are too tight and grounding out.

Closed 2018-08-25.

Thread 318 (2018-10-01):

Not able to use a physical joystick along with web server

huberemanuel, 2018-10-01:
I'm not able to use my physical joystick with web server, but it works fine when I use the "--js" option, but that disables the web server, according to the docs: "The default web controller may be replaced with a one line change to use a physical joystick part for input ...", where is this line, and how do I change it?

Temporarily fix:
go to manage.py and changes:
```
    if use_joystick or cfg.USE_JOYSTICK_AS_DEFAULT:
         ctr = JoystickController(max_throttle=cfg.JOYSTICK_MAX_THROTTLE,
                                  steering_scale=cfg.JOYSTICK_STEERING_SCALE,
                                  auto_record_on_throttle=cfg.AUTO_RECORD_ON_    THROTTLE)
     else:
         # This web controller will create a web server that is capable
         # of managing steering, throttle, and modes, and more.
         ctr = LocalWebController(use_chaos=use_chaos)

     V.add(ctr,
           inputs=['cam/image_array'],
           outputs=['user/angle', 'user/throttle', 'user/mode', 'recording'],
           threaded=True)
```
to:
```

    ctr = LocalWebController(use_chaos=use_chaos)
    V.add(ctr,
           inputs=['cam/image_array'],
           outputs=['user/angle', 'user/throttle', 'user/mode', 'recording'],
           threaded=True)
     ctr = JoystickController(max_throttle=cfg.JOYSTICK_MAX_THROTTLE,
                                  steering_scale=cfg.JOYSTICK_STEERING_SCALE,
                                  auto_record_on_throttle=cfg.AUTO_RECORD_ON_    THROTTLE)
     V.add(ctr,
           inputs=['cam/image_array'],
           outputs=['user/angle', 'user/throttle', 'user/mode', 'recording'],
           threaded=True)
```
In that way you add the two controller handlers, but the JoystickController needs to be the last. This is a temporally fix, not a bug fix!

paulo01012018, 2018-10-05:
That doesn't work with 2.5 and above, only with 2.4

scitronboy, 2018-10-15:
> "The default web controller may be replaced with a one line change to use a physical joystick part for input ...", where is this line, and how do I change it?

I think that line might be in config.py:

    USE_JOYSTICK_AS_DEFAULT = False

maybe you need to change it to:

    USE_JOYSTICK_AS_DEFAULT = True

scitronboy, 2018-10-16:
Yes, but have you tried starting the web server with `USE_JOYSTICK_AS_DEFAULT = True` enabled in the config?

huberemanuel, 2018-10-16:
Yeap, look at that code:
`    if use_joystick or cfg.USE_JOYSTICK_AS_DEFAULT:
         ctr = JoystickController(max_throttle=cfg.JOYSTICK_MAX_THROTTLE,
                                  steering_scale=cfg.JOYSTICK_STEERING_SCALE,
                                  auto_record_on_throttle=cfg.AUTO_RECORD_ON_    THROTTLE)
     else:
         # This web controller will create a web server that is capable
         # of managing steering, throttle, and modes, and more.
         ctr = LocalWebController(use_chaos=use_chaos)`
If you send the option '--js' or set in the config file `USE_JOYSTICK_AS_DEFAULT = True` it won't start the web server.

scitronboy, 2018-10-16:
I see...

What's wrong with your "temporary fix"? Why don't you create a PR for it?

huberemanuel, 2018-10-17:
Because it wasn't made to work in that way, a complete solution would involve changing the donkey architecture, that I may try in the future.

scitronboy, 2018-10-17:
Ok.

holysh1t, 2018-11-07:
What does '...disables the Webserver.' mean? Does it say 'device /dev/jd0' not found? or what?

scitronboy, 2018-11-07:
What?

holysh1t, 2018-11-07:
> What?

@scitronboy I did mean OP.

scitronboy, 2018-11-08:
Sorry @holysh1t  I misunderstood your question. "Disables the web server" means that donkey doesn't serve the web server (for you to drive your car with) to http://localhost:8887/

holysh1t, 2018-11-08:
@scitronboy No problem at all. Yes I also know that, but why doesn't it serve the webserver, there must be some sort of error message?

holysh1t, 2018-11-08:
@huberemanuel That can't be true, if I add the '--js' option it says "[...] device /dev/jd0 not found [...]"! I dont think that adding the parameter just stops the script from working.

scitronboy, 2018-11-09:
@holysh1t

> it says "[...] device /dev/jd0 not found [...]"!

I think that's just because the pi can't find the controller. If you plug in a valid joystick, the script should run normally without an error, it just won't start the webserver (because that's how it's designed in the code - _not_ because of an error).

huberemanuel, 2018-11-09:
@holysh1t what @scitronboy said is true, this isn't an error, just how the app is designed, but it sucks.

holysh1t, 2018-11-09:
@huberemanuel I missunderstood, sorry. That indeed sucks.

wroscoe, 2018-11-11:
This has a work around as described above. I also wrote an alternative part for the Wii u controller.... https://github.com/autorope/donkeypart_bluetooth_game_controller

Closed 2018-11-11.

Thread 328 (2018-10-19):

FileNotFoundError: [Errno 2] No such file or directory: '/dev/i2c-1

kelvinkoko, 2018-10-19:
When I start to run `python manage.py drive` I hit the following error  (boot from pi zero image)
```
(env) pi@donkeypi:~/mycar $ python manage.py drive
using donkey v2.5.1 ...
/usr/lib/python3/dist-packages/h5py/__init__.py:34: FutureWarning: Conversion of the second argument of issubdtype from `float` to `np.floating` is deprecated. In future, it will be treated as `np.float64 == np.dtype(float).type`.
  from ._conv import register_converters as _register_converters
loading config file: /home/pi/mycar/config.py
config loaded
PiCamera loaded.. .warming camera
Starting Donkey Server...
Traceback (most recent call last):
  File "manage.py", line 190, in <module>
    drive(cfg, model_path = args['--model'], use_joystick=args['--js'], use_chaos=args['--chaos'])
  File "manage.py", line 103, in drive
    steering_controller = PCA9685(cfg.STEERING_CHANNEL)
  File "/home/pi/env/lib/python3.5/site-packages/donkeycar/parts/actuator.py", line 18, in __init__
    self.pwm = Adafruit_PCA9685.PCA9685()
  File "/home/pi/env/lib/python3.5/site-packages/Adafruit_PCA9685/PCA9685.py", line 74, in __init__
    self._device = i2c.get_i2c_device(address, **kwargs)
  File "/home/pi/env/lib/python3.5/site-packages/Adafruit_GPIO/I2C.py", line 64, in get_i2c_device
    return Device(address, busnum, i2c_interface, **kwargs)
  File "/home/pi/env/lib/python3.5/site-packages/Adafruit_GPIO/I2C.py", line 97, in __init__
    self._bus = Adafruit_PureIO.smbus.SMBus(busnum)
  File "/home/pi/env/lib/python3.5/site-packages/Adafruit_PureIO/smbus.py", line 105, in __init__
    self.open(bus)
  File "/home/pi/env/lib/python3.5/site-packages/Adafruit_PureIO/smbus.py", line 130, in open
    self._device = open('/dev/i2c-{0}'.format(bus), 'r+b', buffering=0)
FileNotFoundError: [Errno 2] No such file or directory: '/dev/i2c-1'
```
But it can be easily fixed by
adding (or uncomment) `dtparam=i2c_arm=on`
in `/boot/config.txt`

Just would like to see is it a common issue

scitronboy, 2018-10-19:
Hello, it states in the donkey instructions that you must enable i2c in `raspi-config`.  Did you do that?

kelvinkoko, 2018-10-19:
@scitronboy Ah, I haven't done that. Thanks for the prompt reply!~ I found it in the faq now.
Originally I am following this: http://docs.donkeycar.com/guide/install_software/
But that part seems just mention to use `raspi-config` to expand file system. Do you think it is good to mention it is necessary to enable i2c in that page?

scitronboy, 2018-10-19:
I don't think it's necessary on that page, because the pre-built disk image should already have i2c enabled. Are you using the pre-built disk image? Also, try checking raspi-config: `sudo raspi-config` and then navigate to `interfacing options` and then check i2c. Is it enabled???

kelvinkoko, 2018-10-21:
Yes, i am using the pre-build image (for pi-zero) but i agree user can enable it in raspi-config easily even not enabled. let me close this issue

Closed 2018-10-21.

Thread 347 (2018-11-21):

Xbox One Controller for steering

niallmandal, 2018-11-21:
Does anyone know how to set up an Xbox One wireless controller to steer the donkey car while collecting training data? I am looking to fine tune manual steering. I have seen many ways to do this, I am just not sure how.  Do you know of any ways to do this directly, or as an add-on through the browser interacting with elements on the page?
i.e. chrome://flags/#enable-gamepad-extensions

wroscoe, 2018-11-21:
If this is a bluetooth controller you could try [this package](https://github.com/autorope/donkeypart_bluetooth_game_controller) to add it as a controller to your donkeycar. You'll probably need to create an updated config file that gives the button mapping for the xbox. I wrote this package for the WiiU.

The default config file: https://github.com/autorope/donkeypart_bluetooth_game_controller/blob/master/donkeypart_bluetooth_game_controller/wiiu_config.yml

wroscoe, 2018-11-21:
Updated the readme to show how to add support for a new joystick. https://github.com/autorope/donkeypart_bluetooth_game_controller/blob/master/README.md

niallmandal, 2018-11-21:
The link to the Wii U config file is invalid. Can you please fix this?

niallmandal, 2018-11-21:
can you explain how the config file works,  and how I should tackle editing it, please?

wroscoe, 2018-11-21:
When you have your joystick connected vai bluetooth, running the part.py script will print out the buttons and their codes as you press them. For example with the WiiU controller when you press the bottom left trigger the code 312 will show. If you see a different code you'll need to change that code that's mapped to that button to whatever code you see.

niallmandal, 2018-11-21:
When running part.py, an error is raised that looks like this

`FileNotFoundError: [Errno 2] No such file or directory: './donkeypart_bluetooth_game_controller/donkeyblue/wiiu_config.yml'`

Doesn't this mean that part.py is relying on a file that I am supposed to create?
(I switched to testing with a regular Wii remote and Nunchuk, but the error is still present)

niallmandal, 2018-11-21:
Not to mention, runnning part.py requires that the device is named "nintendo." This is why I had to switch to the Wii Controller. Am I doing something wrong?

wroscoe, 2018-11-22:
No, you're just the first person to add a new controller. I've pushed some updates that will ask you for a search term to find your controllers input device. I also added the wiiu_config.yml file for installs done without the -e flag.

niallmandal, 2018-11-22:
when do you think these updates will be done
.
.
.
sorry for the rush i’m building the car for a competition and training needs to happens soon :)

wroscoe, 2018-11-22:
What updates? You should have what you need to use it for a different BT controller. If its not related to this issues you can msg me on slack.

niallmandal, 2018-11-22:
the updates to the code. you said you pushed the updates. when will these updates be added? Or have they been already added?

niallmandal, 2018-11-22:
ohhh okay thank you! i will contact you over slack if i have any more questions or errors. Thank you so much

niallmandal, 2018-11-22:
So I ran the new files with a wii remote, and the same error is still here. What should I do?
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

Closed 2018-11-21.

Thread 360 (2018-12-09):

NameError: name 'JoystickController' is not defined

custom-build-robots, 2018-12-09:
Hello everyone,
since I installed the latest donkey car version 2.5.8 I am no longer able to use my PS4 controller connected via DualShock 4 USB Wireless Adaptor. In the past I had no problem to use the PS4 controller to steer my Donkey Car.

Below is the error I get since I updated today my Donkey Car. I downloaded the latest image for the Raspberry Pi 3 Model B+ and installed verything as described.

Update 1:
I think the controller.py file is missing? Maybe I missed something or this causes the error...

Update 2:
I copied an old controller.py file in the foler "~/env/lib/python3.5/site-packages/donkeycar/parts"
Changed the manage.py file and added this line:
from donkeycar.parts.controller import JoystickController

NOW MY PS4 CONTROLLER IS WOKING AGAIN...

ERROR MESSAGE:
(env) pi@donkeypi:~/mycar $ python manage.py drive
using donkey version: 2.5.8 ...
/usr/lib/python3/dist-packages/h5py/__init__.py:34: FutureWarning: Conversion of the second argument of issubdtype from `float` to `np.floating` is deprecated. In future, it will be treated as `np.float64 == np.dtype(float).type`.
  from ._conv import register_converters as _register_converters
loading config file: /home/pi/mycar/config.py
config loaded
PiCamera loaded.. .warming camera
Traceback (most recent call last):
  File "manage.py", line 176, in <module>
    drive(cfg, model_path=args['--model'], use_joystick=args['--js'], use_chaos=args['--chaos'])
  File "manage.py", line 48, in drive
    ctr = JoystickController(max_throttle=cfg.JOYSTICK_MAX_THROTTLE,
NameError: name 'JoystickController' is not defined

This picture shows the donkey car error message I now get:
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

If I start this little python program to test my PS4 controller it works perfct:

#!/usr/bin/env python
import struct
infile_path = "/dev/input/js0"
EVENT_SIZE = struct.calcsize("LhBB")
file = open(infile_path, "rb")
event = file.read(EVENT_SIZE)
while event:
    print(struct.unpack("LhBB", event))
    (tv_msec,  value, type, number) = struct.unpack("LhBB", event)
    event = file.read(EVENT_SIZE)

This picture shows the output of my python joystick test program:
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

Thank you very much for your help or ideas

Ingmar

ndnparis, 2018-12-16:
Hi,
I have the same issues with my PS3 joystick.
It works with other apps but not with donkeycar.
Hope someone could help us.

kevkruemp, 2019-01-19:
The newest update does appear to be missing the proper controller file. I will see if this can be remedied.

vihank, 2019-02-17:
> The newest update does appear to be missing the proper controller file. I will see if this can be remedied.

Has this issue been fixed yet?

jmonsalve15, 2019-04-07:
Hi @custom-build-robots, I am having the same issue but I don’t have the old versions of Donkey repo, can you share the missing file or show me from where could I download? I am pretty new and I getting struggles to found info here. Thanks

pitkane, 2019-05-02:
As Ingmar said, copying the file `controller.py` from older build kind of solves the problem.

```
cd ~/env/lib/python3.5/site-packages/donkeycar/parts/
wget https://github.com/autorope/donkeycar/blob/2.5.1/donkeycar/parts/controller.py

```

In `manage.py`
```
from donkeycar.parts.controller import JoystickController
```

tawnkramer, 2019-06-11:
please be on the lookout for donkey 3.0. This will have all the controller support in the main repo.

Closed 2019-06-11.

Thread 365 (2019-01-05):

python manage.py drive remote IO error

xzho2604, 2019-01-05:
Hi,
when I run python manage.py drive
I got the error below:

`Traceback (most recent call last):
  File "manage.py", line 176, in <module>
    drive(cfg, model_path=args['--model'], use_joystick=args['--js'], use_chaos=args['--chaos'])
  File "manage.py", line 103, in drive
    steering_controller = PCA9685(cfg.STEERING_CHANNEL)
  File "/home/pi/env/lib/python3.5/site-packages/donkeycar/parts/actuator.py", line 19, in __init__
    self.pwm = Adafruit_PCA9685.PCA9685()
  File "/home/pi/env/lib/python3.5/site-packages/Adafruit_PCA9685/PCA9685.py", line 75, in __init__
    self.set_all_pwm(0, 0)
  File "/home/pi/env/lib/python3.5/site-packages/Adafruit_PCA9685/PCA9685.py", line 111, in set_all_pwm
    self._device.write8(ALL_LED_ON_L, on & 0xFF)
  File "/home/pi/env/lib/python3.5/site-packages/Adafruit_GPIO/I2C.py", line 114, in write8
    self._bus.write_byte_data(self._address, register, value)
  File "/home/pi/env/lib/python3.5/site-packages/Adafruit_PureIO/smbus.py", line 256, in write_byte_data
    self._device.write(data)
OSError: [Errno 121] Remote I/O error`

Would appreciate if some one would help!
Cheers
Erik

scitronboy, 2019-01-05:
Is I2C enabled in the interfacing options in `raspi-config`?

xzho2604, 2019-01-14:
Hi scitronboy,

Thank you for your reply, I have enable I2C and the pi2 camera works but the wide angle camera from the donkey store would not work......

Thank you
Erik

tawnkramer, 2019-06-12:
Here's some tips on solving that error:
https://donkey.discourse.group/t/faq-troubleshooting/33/3?u=tawnkramer

Closed 2019-06-12.

Thread 366 (2019-01-09):

Questions about different software and hardware

filips123, 2019-01-09:
I want to use Donkeycar with my own car which uses different hardware that the official one.

I have few questions about that.

---

I use L298N motor driver. My parts are similar to that in [Raspberry Pi guide](https://projects.raspberrypi.org/en/projects/build-a-buggy), but I also have normal (not wide angle) Raspberry Pi camera.

Will that work? What I need to change to work?

---

To what angle should camera be tilted? What distance should be between car and nearest point in camera view? See bellow image for what I mean.

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

---

Is it possible to control car with my own software?

I want to have different website which will have support to control car, start and stop data recording (with also displaying how many frames and seconds is recording long) and start and stop drive. I also want to have buttons to transfer data and models between RPi and computer.

---

What data needs to be collected for training and in what format? Should just images be collected or should it also collect other data?

Can I make my own program that will collect data in required format for training?

---

My camera and motors are controlled in some specific way.

Is it possible that Donkeycar just get images from camera (in MJPEG stream or frame-by-frame stream) and just outputs in which directions should motors go? I want to control them in different ways.

---

Also, is it possible to detect traffic lights and signs and consider them in driving?

scitronboy, 2019-01-09:
Anything is possible! Yes, you can control the car with your own software, but obviously if you want to work with donkey as well as your own software you'll need to modify donkey to make it work with your software. You can use a different website/interface, but you're going to have to program it yourself.

In training, donkey collects images and throttle/steering data in the form of one JSON file for each frame. Yes, you can make your own training system, but, again, you're going to have to program it yourself. Same for all the rest of your question.

It is possible to detect traffic lights (for example with OpenCV); and other people have done it; but that functionality is not integrated into donkey right now. If you develop a good way of doing this on the pi feel free to submit a pull request.

I suggest that you look through all the code yourself and try to figure out how it works. Also I suggest that you build a donkey using the default setup and code _first_ before you start trying to make modifications. Ask if you have any questions.

filips123, 2019-01-09:
What about camera (see my original question)? Also, is it needed to change it's focus?

What are that throttle/steering data? How can I collect them myself?

Also, can you point me a bit where in the code are what things and what should I change?

scitronboy, 2019-01-09:
I don't know about the camera - you could probably just try yours.

As I already said, you should start by using the default donkey data collector.

What code do you want to change???

filips123, 2019-01-10:
I mean what code should be changed or added by me to integrate my website and programs with donkey. What functions should I call, where are they located...

scitronboy, 2019-01-10:
Start by watching the videos by @tawnkramer  that explain the donkey car parts system.

[Here is the first one.](https://www.youtube.com/watch?v=YZ4ESrtfShs)

filips123, 2019-01-10:
Thank you!

What are that throttle/steering data? How can I collect them myself?
From [the docs](http://docs.donkeycar.com/guide/calibrate/) I see that they are for ESC motors. I'm using different motors. Do I also need them?

scitronboy, 2019-01-10:
Once you actually build a car using the official instructions you can look at the data and figure the structure out. Then you will know how you need to store the data. The [code that stores the data](https://github.com/autorope/donkeycar/blob/dev/donkeycar/parts/datastore.py) is here.

You need the throttle-steering data always;it does not matter which car you use. If you are not using the standard car you will have to develop your own code to interface it to the donkey software. Many people have done this before (including me). What type of car do you have??? Do you already have a motor driver for it?

Also keep in mind that you can ask questions like this on the [slack channel](http://www.donkeycar.com/community.html).

filips123, 2019-01-11:
I will build my own custom car. I will use L298N motor driver.

filips123, 2019-06-12:
Thanks for closing this.
I can confirm that the car also works with other motors. I just had to update motor controllers and some other things.

Closed 2019-06-12.

Thread 369 (2019-01-24):

Power Raspberry Pi and Servo motor with one source

mahmoud891, 2019-01-24:
Hello everyone , i am trying to create my own Car , following the documentation part on how to do it , as i was preparing the Hardware part , i saw that there is one problem , there is written " do not connect Servo Motor directly to the 5v pin of Raspberry Pi because it is not safe " and instead they are using Power Bank ( Anker ) for powering the Raspberry Pi and Servo together . My question is : Would it be a problem if we power Raspberry Pi with Power Bank which has 5 Volts , and we connect Servo motor 4,8-6 V through PCA9685 to Raspberry Pi ? if Servo motor is 4,8 - 6 Volt and we supply it with Vin=5V there is 1 volt difference , is it dangerous ? Thank you in advance .

DocGarbanzo, 2019-02-12:
Hi Mahmoud,
The servo usually gets powered through the ESC which is connected to the PCA9685. It has an onboard voltage regulator (called BEC) providing the right voltage- I believe this is 5V -  and enough current (1A) to do so. The ESC is powered through your battery which is probably a 2S Lipo or similar. With a cheap small buck converter / voltage regulator you can tap into your battery and power the Pi. I am using https://rover.ebay.com/rover/0/0/0?mpre=https%3A%2F%2Fwww.ebay.co.uk%2Fulk%2Fitm%2F163095874791, I believe there are many options. This one allows for 3A, which looks to be on the safe side.

tawnkramer, 2019-06-12:
The Sombrero hat available in the donkeycar store makes this easy.

Closed 2019-06-12.

Thread 378 (2019-03-21):

[Errno 121] Remote I/O error

rongfeng-china, 2019-03-21:
Hello, I am trying to execute the donkey calibrate --channel 0 command but am getting the error: [Errno 121] Remote I/O error...

My car used to work, but this time it stop working. The I2C is enabled, and the wires seem to connect in the right way. Any idea? How to fix it? Thanks!

879099766, 2019-03-29:
According to doug on Slack, "make sure you have the I2C wires from the rPi to the PCA9685 correctly installed. The docs show pictures and not pin labels so you have to count the pins correctly and get the correct side of the 40 pin connector.  The I2C interface is 3.3V so please do not connect the 5V pins."

Link: https://donkeycar.slack.com/archives/C4HR56WN6/p1537679984000100?thread_ts=1537679739.000100&cid=C4HR56WN6

So, please search the issue on Slack before asking because it will save you lots of time. :)

Good luck with the troubleshooting.

tawnkramer, 2019-06-04:
we could use a FAQ with these common errors. Please let us know if you still need help. closing for now.

Closed 2019-06-04.

Thread 448 (2019-08-18):

TypeError: unsupported operand type(s) for -: 'NoneType' and 'int'

dmccreary, 2019-08-18:
Hi folks,

I am using the Donkey 3.1.0 on the Nvidia Nano under Ubuntu18.04 and I am getting the following error when I use the following UNIX command to drive the car to get test data:

$python manage.py drive --js

I am also testing the Logitech F710 joystick which may or may not be related to this error.  I have had a lot of problems getting it to work.

From what I can tell, this appears a type error in some map_range function.

Traceback (most recent call last):
  File "manage.py", line 553, in <module>
    meta=args['--meta'])
  File "manage.py", line 542, in drive
    max_loop_count=cfg.MAX_LOOPS)
  File "/home/dan/ws/donkeycar/donkeycar/vehicle.py", line 144, in start
    self.update_parts()
  File "/home/dan/ws/donkeycar/donkeycar/vehicle.py", line 194, in update_parts
    outputs = p.run(*inputs)
  File "/home/dan/ws/donkeycar/donkeycar/parts/actuator.py", line 181, in run
    self.left_pulse, self.right_pulse)
  File "/home/dan/ws/donkeycar/donkeycar/utils.py", line 219, in map_range
    y = ((x-X_min) / XY_ratio + Y_min) // 1
TypeError: unsupported operand type(s) for -: 'NoneType' and 'int'
GST_ARGUS:
PowerServiceHwVic::cleanupResources

krissdap, 2019-09-06:
Hi,

I also experienced same issue.
I was using PS4 controller, so the issue is not exclusive to your F710.
The other difference is I'm using Raspbian (2019-04-08-raspbian-stretch-lite), not Ubuntu.

```
  File "/home/pi/projects/donkeycar/donkeycar/utils.py", line 245, in map_range
    y = ((x-X_min) / XY_ratio + Y_min) // 1
TypeError: unsupported operand type(s) for -: 'NoneType' and 'int'
```

shijq23, 2019-09-15:
This can happen if drive without a model "python manage.py drive --js"
when drive mode switches to "local" or "local_angle", then None (angle) can be passed to PWMSteering run function.

A simple solution is to change class DriveMode to following

```
    class DriveMode:
        def run(self, mode,
                    user_angle, user_throttle,
                    pilot_angle, pilot_throttle):
            if mode == 'user':
                return user_angle, user_throttle
    
            elif mode == 'local_angle':
                return pilot_angle if pilot_angle else 0.0, user_throttle
    
            else:
                return pilot_angle if pilot_angle else 0.0, pilot_throttle * cfg.AI_THROTTLE_MULT if pilot_throttle else 0.0
```

Ezward, 2019-11-27:
@shijq23 I've created a pull request based on the fix you suggested.  https://github.com/autorope/donkeycar/pull/505

Closed 2020-02-14.

Thread 451 (2019-08-25):

Jestson Nano Crashing on Loading Camera

adricl, 2019-08-25:
So I am getting a crash with my Jeson Nano and Pi v2 Camera in Donkeycar 3.1.

The issue is around the capture height and width of the CSI Camera, I think it was to large for the output of my camera or something like that and produced a crash. I fixed it by reducing it to the output height and width.

So my question is the capture height and width supposed to be output height and width? Or is there speed improvements in using the full sensor data? @tawnkramer

Do you want me to pr a fix for this?

So in the following log I have printed the gstreamer nvidia commands.

Starting vehicle...
nvarguscamerasrc ! video/x-raw(memory:NVMM), width=3280, height=2464, format=(string)NV12, framerate=(fraction)20/1 ! nvvidconv flip-method=2 ! nvvidconv ! video/x-raw, width=(int)160, height=(int)120, format=(string)BGRx ! videoconvert ! appsink
Device name: Logitech Gamepad F710
GST_ARGUS: Creating output stream
CONSUMER: Waiting until producer is connected...
GST_ARGUS: Available Sensor modes :
GST_ARGUS: 3280 x 2464 FR = 21.000000 fps Duration = 47619048 ; Analog Gain range min 1.000000, max 10.625000; Exposure Range min 13000, max 683709000;

GST_ARGUS: 3280 x 1848 FR = 28.000001 fps Duration = 35714284 ; Analog Gain range min 1.000000, max 10.625000; Exposure Range min 13000, max 683709000;

GST_ARGUS: 1920 x 1080 FR = 29.999999 fps Duration = 33333334 ; Analog Gain range min 1.000000, max 10.625000; Exposure Range min 13000, max 683709000;

GST_ARGUS: 1280 x 720 FR = 59.999999 fps Duration = 16666667 ; Analog Gain range min 1.000000, max 10.625000; Exposure Range min 13000, max 683709000;

GST_ARGUS: 1280 x 720 FR = 120.000005 fps Duration = 8333333 ; Analog Gain range min 1.000000, max 10.625000; Exposure Range min 13000, max 683709000;

GST_ARGUS: Running with following settings:
   Camera index = 0
   Camera mode  = 0
   Output Stream W = 3280 H = 2464
   seconds to Run    = 0
   Frame Rate = 21.000000
GST_ARGUS: PowerService: requested_clock_Hz=35358400
GST_ARGUS: Setup Complete, Starting captures for 0 seconds
GST_ARGUS: Starting repeat capture requests.
CONSUMER: Producer has connected; continuing.
NvDdkVicConfigure Failed
nvbuffer_transform Failed
gst_nvvconv_transform: NvBufferTransform Failed
GST_ARGUS: Cleaning up
GST_ARGUS:
PowerServiceHwVic::cleanupResources
CONSUMER: Done Success
GST_ARGUS: Done Success

(python:6178): GStreamer-CRITICAL **: 17:29:20.603: gst_element_get_state: assertion 'GST_IS_ELEMENT (element)' failed
Exception in thread Thread-1:
Traceback (most recent call last):
  File "/usr/lib/python3.6/threading.py", line 916, in _bootstrap_inner
    self.run()
  File "/usr/lib/python3.6/threading.py", line 864, in run
    self._target(*self._args, **self._kwargs)
  File "/home/wombat/Documents/donkey_env_3/donkeycar/donkeycar/parts/camera.py", line 174, in update
    self.init_camera()
  File "/home/wombat/Documents/donkey_env_3/donkeycar/donkeycar/parts/camera.py", line 169, in init_camera
    self.poll_camera()
  File "/home/wombat/Documents/donkey_env_3/donkeycar/donkeycar/parts/camera.py", line 181, in poll_camera
    self.frame = cv2.cvtColor(frame, cv2.COLOR_BGR2RGB)
cv2.error: OpenCV(4.0.0) /home/wombat/Documents/temp/opencv-4.0.0/modules/imgproc/src/color.cpp:181: error: (-215:Assertion failed) !_src.empty() in function 'cvtColor'

tawnkramer, 2019-08-25:
The fix I found is to change the output resolution to 224 x 224. I don't
know why the driver crashes when we use the default 160 x 120.

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

adricl, 2019-08-25:
The master branch has a resolution of width=3280, height=2464. The dev branch has the resolution of 224 x 224. Do you want me to fix this?

tawnkramer, 2019-08-26:
No. Don’t change the capture resolution. Change the output resolution by
adjusting
IMAGE_W = 224
IMAGE_H = 224

In myconfig.py

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

BrianHenryIE, 2021-08-14:
I was having the same error with Donkey Car 4.2.1: `(Assertion failed) !_src.empty() in function 'cvtColor').`

I was able to use the `nvgstcapture-1.0` tool (as advised on Nvidia's [Taking Your First Picture with CSI or USB Camera](https://developer.nvidia.com/embedded/learn/tutorials/first-picture-csi-usb-camera) page) to troubleshoot that the camera itself was properly connected and working.

Resolution was correct in myconfig.py.

I didn't figure out the cause of the issue. I just flashed my SD card again and it worked immediately then.

Closed 2019-09-06.

Thread 459 (2019-09-28):

gstreamer issues with Nvidia Nano CSI Camera

wolfeidau, 2019-09-28:
The latest changes which were merged in https://github.com/autorope/donkeycar/commit/ee4674f71c81373b98f7ace9e5f6578fc45fe476 result in an opencv error indicating that the camera.get is returning empty frames.

Reverting this change restores my car to a working state.

Anyone else seeing issues with this change?

tawnkramer, 2019-09-28:
These changes came from looking at Nvidia’s jetson nano jetcar platform
code. You will need to change the image w and h in myconfig.py to 224 x
224.

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

wolfeidau, 2019-09-29:
@tawnkramer I ran "createcar" to initialise a new project and this didn't seem to work either, is there a way we can make these requirement more obvious in that `myconfig.py`?

Also would it be helpful to add a note here as well? https://github.com/autorope/donkeycar/blob/dev/docs/guide/create_application.md#camera-setup

macfly1202, 2019-09-29:
I encounter exact same issue. Thanks @tawnkramer for advice H,W : 224,224 !

wolfeidau, 2019-10-07:
I updated `myconfig.py` to use the 224 settings and the are :+1: as below
```
IMAGE_W = 224
IMAGE_H = 224
```

However due to the quantity of data I need to adjust training settings to disable loading all images in memory in `myconfig.py`. I was training with about 12k of images and I exhausted the ram on a laptop with 16GB of RAM.

This setting fixed it.
```
CACHE_IMAGES = False
```

macfly1202, 2019-10-07:
Following to this change on w,h image, another issue occurs with default model.

`  File "/home/jmp/Dropbox/github/donkeycar/car/donkeycar/donkeycar/parts/keras.py", line 164, in run
    outputs = self.model.predict(img_arr)
  File "/home/jmp/anaconda3/envs/donkey/lib/python3.7/site-packages/tensorflow/python/keras/engine/training.py", line 1096, in predict
    x, check_steps=True, steps_name='steps', steps=steps)
  File "/home/jmp/anaconda3/envs/donkey/lib/python3.7/site-packages/tensorflow/python/keras/engine/training.py", line 2382, in _standardize_user_data
    exception_prefix='input')
  File "/home/jmp/anaconda3/envs/donkey/lib/python3.7/site-packages/tensorflow/python/keras/engine/training_utils.py", line 362, in standardize_input_data
    ' but got array with shape ' + str(data_shape))
ValueError: Error when checking input: expected img_in to have shape (224, 224, 3) but got array with shape (120, 160, 3)
(donkey) jmp@deep:~/mysim$ ` This is quite easy to change but for the sake of good documentation and good parameter in model for Jetson Nano ...

macfly1202, 2019-10-09:
@tawnkramer yes for sure. It's a minor issue when use Jetson nano in case of copying myconfig to sim folder path.

wolfeidau, 2019-10-20:
@macfly1202 @tawnkramer I get the same error after training and attempting to use the model to drive. Same settings are used used for drive and training, now trying to chase down why this shape error is raised.

macfly1202, 2019-10-20:
@wolfeidau I set the standard setup for myconfig.py use with ```
# #CAMERA
CAMERA_TYPE = "CSIC"   # (PICAM|WEBCAM|CVCAM|CSIC|V4L|MOCK)
IMAGE_W = 160   # deft 160
IMAGE_H = 120    # 120
IMAGE_DEPTH = 3         # default RGB=3, make 1 for mono
CAMERA_FRAMERATE = DRIVE_LOOP_HZ ....DONKEY_GYM = True
DONKEY_SIM_PATH = "/home/jmp/Dropbox/github/donkeycar/simulator/20191007/DonkeySimLinux/donkey_sim.x86_64"
DONKEY_GYM_ENV_NAME = "donkey-generated-track-v0" # ("donkey-generated-track-v0"|"donkey-generated-roads-v0"|"donkey-warehouse-v0"|"donkey-avc-sparkfun-v0")``` on myconfig.py. Do it simple ! Nevertheless I will try to reshape later to use 224*224...

a652311279, 2019-10-31:
Thx sharing
i also has  the problem [**but got array with shape ' + str(data_shape)) ValueError: Error when checking input: expected img_in to have shape (120, 160, 3) but got array with shape (120, 160, 3)** ]
Since i changed the myconfig.py **image.w** and **image.h**  then i  collect data  and put in the google colab to traing . After trainng, i used the model to drive i got the error. So i need to modify the colab myconfig.py ?

wolfeidau, 2019-11-17:
Just an update, managed to get training and auto pilot running with a small change to the codebase.

https://github.com/wolfeidau/donkeycar/commit/3b68d578fda8d107ba549d58f2e284768fb56bc9

Need to figure out how to thread these values through from the configuration file.

One thing to note is this also increased the power use of the Jetson Nano so I am unable to use the micro usb connection and have switched to the barrel jack to supply more power. Device literally powers off once it starts inference.

Closed 2020-02-14.

Thread 531 (2020-01-19):

web broswer show nothing

xidianzhuxi, 2020-01-19:
after i run python3 manage.py drive。shell tell me go to the ip:8887 to control the car。
but i cant connet this web page just like this
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

nvtkaszpir, 2020-01-19:
Does it show anything more after `Init ESC`  message in the console?

xidianzhuxi, 2020-01-19:
nothing show after `Init ESC`

nvtkaszpir, 2020-01-19:
Then make sure you have followed the procedure in [creating an donkeycar app ](http://docs.donkeycar.com/guide/create_application/) and [calibrating steering](http://docs.donkeycar.com/guide/calibrate/) because it should show something like:
```
...
PWM Throttle created
Adding part PWMSteering.
Adding part PWMThrottle.
Tub does NOT exist. Creating new tub...
New tub created at: /home/pi/mycar/data/tub_2_20-01-19
Adding part TubWriter.
...
...
Starting vehicle at 20 Hz
```
And then it should show web intrface.

xidianzhuxi, 2020-01-19:
thanks,i fix it .one year ago,i build donkeycar on my own board and modify the actuator.py。i noticed that the new version seems to support imu?how can i use it?

xidianzhuxi, 2020-01-19:
sorry but a new problem i find that the web page i can not control.no use to press the button in red zone shows below .and i can not click to drag neither
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

nvtkaszpir, 2020-01-19:
On the left in `Mode & Pilot` select mode `User`.
On the top left `Control Mode` select `Joystick`.

Then you should be able to use other controls.

Also ensure not to have any special adblockers or noscript addons enabled.

xidianzhuxi, 2020-01-19:
I can select mode User in `Mode & Pilot` but i can not select `Joystick` on the top left `Control Mode`.
I press the key space and go to see the tub,no image and json file stored.F12 shows 4 js error.
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

xidianzhuxi, 2020-01-19:
by the way: i run `python3 manage.py drive --js`  all is well

CarloHan, 2020-06-09:
Hi, I have the same problem with you, the website shows nothing. May I ask how did you solve the problem? Thx!

Closed 2020-01-25.

Thread 545 (2020-02-19):

Camera feed not showing in browser

NicholaiStaalung, 2020-02-19:
Hello,

Trying to set up the donkey car but the camera feed is not showing
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

Specs:
Jetson nano with latest jetpack
I **did not** install in a virtual environment on the nano

I already troubleshooted some
ls -l /dev/video0 shows the camera

I tried https://medium.com/@dmccreary/getting-your-camera-working-on-the-nvida-nano-336b9ecfed3a and got a perfect feed

I inspected the page and thought maybe the feed came from a wrong source so i changed the source to /dev/video0 without luck

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

Im getting the following traceback in the terminal when im running python3 manage.py drive. I cant find any related issues on the jetson nano

> GST_ARGUS: Done Success
Exception in thread Thread-1:
Traceback (most recent call last):
  File "/usr/lib/python3.6/threading.py", line 916, in _bootstrap_inner
    self.run()
  File "/usr/lib/python3.6/threading.py", line 864, in run
    self._target(*self._args, **self._kwargs)
  File "/home/donkeycph/projects/donkeycar/donkeycar/parts/camera.py", line 172, in update
    self.init_camera()
  File "/home/donkeycph/projects/donkeycar/donkeycar/parts/camera.py", line 167, in init_camera
    self.poll_camera()
  File "/home/donkeycph/projects/donkeycar/donkeycar/parts/camera.py", line 179, in poll_camera
    self.frame = cv2.cvtColor(frame, cv2.COLOR_BGR2RGB)
cv2.error: OpenCV(4.1.0) /home/donkeycph/projects/cv2/opencv/modules/imgproc/src/color.cpp:182: error: (-215:Assertion failed) !_src.empty() in function 'cvtColor

NicholaiStaalung, 2020-02-19:
This solved it
https://custom-build-robots.com/raspberry-pi-robot-cars/autonomously-driving-nvidia-jetson-nano-ai-robot-car-configuration-of-the-donkey-car-framework/12137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

RossMelbourne, 2020-09-07:
I am having the same issue that this issue #545 has solved.  I tried the article from above which had a solution for this exact problem.  However the code changes mentioned do not work for me.

I also tried https://medium.com/@dmccreary/getting-your-camera-working-on-the-nvida-nano-336b9ecfed3a and got a perfect feed.

I am using the latest donkey v3.1.5.

I am using the recommended camera for the Jetson Nano which has the IMX219 Sensor.

Here is myconfig.py entries:
myconfig.com:
CAMERA_TYPE = "CSIC"
IMAGE_W = 224
IMAGE_H = 224

Here is the error:
Opening /dev/input/js0...
Device name: Nimbus
Starting vehicle at 20 Hz
OpenCV Error: Assertion failed (scn == 3 || scn == 4) in cvtColor, file /build/opencv-XDqSFW/opencv-3.2.0+dfsg/modules/imgproc/src/color.cpp, line 9716
Exception in thread Thread-1:
Traceback (most recent call last):
  File "/usr/lib/python3.6/threading.py", line 916, in _bootstrap_inner
    self.run()
  File "/usr/lib/python3.6/threading.py", line 864, in run
    self._target(*self._args, **self._kwargs)
  File "/home/rossm/robocar/donkeycar/donkeycar/parts/camera.py", line 174, in update
    self.init_camera()
  File "/home/rossm/robocar/donkeycar/donkeycar/parts/camera.py", line 169, in init_camera
    self.poll_camera()
  File "/home/rossm/robocar/donkeycar/donkeycar/parts/camera.py", line 181, in poll_camera
    self.frame = cv2.cvtColor(frame, cv2.COLOR_BGR2RGB)
cv2.error: /build/opencv-XDqSFW/opencv-3.2.0+dfsg/modules/imgproc/src/color.cpp:9716: error: (-215) scn == 3 || scn == 4 in function cvtColor

I also tried varying the myconfig.py to the default resolution and/or making the resolutions in camera.py match myconfig.py but no joy.

RossMelbourne, 2020-09-11:
I solved this problem by using the instructions here:  https://diyrobocars.com/installation-steps-for-donkeycar-on-jetson-nano-xavier/

I suggest updating the Donkeycar Docs to reflect this.

huntlin, 2022-05-23:
can you tell me how reslove camera problem?

Closed 2020-02-19.

Thread 554 (2020-03-11):

Can't Train DonkeyCar Using Website Instructions

hydernaqvi, 2020-03-11:
I'm at the top of the page at
https://docs.donkeycar.com/guide/train_autopilot/#train-a-model

I'm at the first part where I have to type in :
`rsync -rv --show-progress --partial pi@<your_pi_ip_address>:~/mycar/data/  ~/mycar/data/`

I keep getting the following response:

> rsync: --show-progress: unknown option
> rsync error: syntax or usage error (code 1) at main.c(1585) [client=3.1.2]

I'm going to try to to go ahead and remove the show progress part but it would be good to know why this isn't working

nvtkaszpir, 2020-03-11:
Please provide output of the command
```shell
rsync --version
```

hydernaqvi, 2020-03-11:
rsync  version 3.1.2  protocol version 31
Copyright (C) 1996-2015 by Andrew Tridgell, Wayne Davison, and others.
Web site: http://rsync.samba.org/
Capabilities:
    64-bit files, 64-bit inums, 32-bit timestamps, 64-bit long ints,
    socketpairs, hardlinks, symlinks, IPv6, batchfiles, inplace,
    append, ACLs, xattrs, iconv, symtimes, prealloc

rsync comes with ABSOLUTELY NO WARRANTY.  This is free software, and you
are welcome to redistribute it under certain conditions.  See the GNU
General Public Licence for details.

hydernaqvi, 2020-03-11:
This is the error I'm seeing now
> Unexpected remote arg: @192.168.137.141:~/mycar/data/
> rsync error: syntax or usage error (code 1) at main.c(1361) [sender=3.1.2]
I've been able to access the server using this ip address and the port 8887 on the browser so I don't think the ip address is the issue

nvtkaszpir, 2020-03-11:
empty username?

hydernaqvi, 2020-03-11:
I'm not sure what you mean. Apart from the IP address there's no suggestion I need to change anything else. All other settings are default

nvtkaszpir, 2020-03-11:
OK, indeed my question was a bit vague ;)
```
Unexpected remote arg: @192.168.137.141:~/mycar/data/
```
seems like you are missing username `pi` in the rsync command, such as:
```shell
rsync -rv --show-progress --partial @192.168.137.141:~/mycar/data/ ~/mycar/data/
```
versus
```shell
rsync -rv --show-progress --partial pi@192.168.137.141:~/mycar/data/ ~/mycar/data/
```

hydernaqvi, 2020-03-12:
Thank you so far I've made it past my earlier issues, but I've hit another bump. I'm not sure if I should start a new thread. When I run the next command to run all tubs for training
 using this command:
`python ~/mycar/manage.py train --model ~/mycar/models/mypilot.h5`

I get the following error towards the end:

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

hydernaqvi, 2020-03-12:
I'm not sure if it helps but I'm also seeing a lot of lines saying 0 pickles found

tawnkramer, 2020-03-12:
it looks like you might have a corrupt or zero length json file. I've seen
this happen from windows users mainly. Not sure what it up with the rsync
on that platform. But we may want to switch to an FTP based soln at some
point.

In the meantime, you can run the command 'donkey tubcheck ~/mycar/data/*
--fix' and see if that removes the problem records.

https://docs.donkeycar.com/utility/donkey/#check-tub

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

hydernaqvi, 2020-03-12:
I ran this as suggested:
`donkey tubcheck ~/mycar/data/*
--fix`

I got the following results with errors:

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

hydernaqvi, 2020-03-13:
To try something different I tried to run one tub for training by using the donkeycar instructions and simply placing the name of the tub folder into the suggested area. It ran but eventually gave an error that the path provided doesn't exist.

Then I navigated into the data folder and tried the same command again:
`(env) pi@raspberrypi:~/mycar/data $ python ~/mycar/manage.py train --tub tub_10_20-01-01 --model ./models/mypilot.h5
`
This ran for a bit again but eventually resulted in the following error

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

I'm really not sure what to do at this point and I could really use some advice

Side note: How can I remove all tubs and try again? Would that help?

nvtkaszpir, 2020-03-14:
Please don't run training on rpi, it has not enough memory to do it.
It's even stated in the error message you provided.

hydernaqvi, 2020-03-31:
@nvtkaszpir I was just trying all combinations I could to try and get it to work. I have a partner who worked on this using a Mac with different data and it worked. It could be a compatibility thing. I had hit the update command on my DonkeyCar and I wonder if I need a solution equivalent to replacing  `--show-progress` with `--progress`

I'll most likely delete everything and try starting from scratch in case I changed something that wasn't meant to be changed

Closed 2020-04-23.

Thread 567 (2020-03-24):

cant run PiCamera

9018, 2020-03-24:
(env) root@kali:~/projects/donkeycar# python /root/mycar/manage.py drive
using donkey v3.1.1 ...
loading config file: /root/mycar/config.py
loading personal config over-rides

config loaded
cfg.CAMERA_TYPE PICAM
cfg.CAMERA_TYPE PICAM
mmal: mmal_component_create_core: could not find component 'vc.camera_info'
Traceback (most recent call last):
  File "/root/mycar/manage.py", line 572, in <module>
    meta=args['--meta'])
  File "/root/mycar/manage.py", line 100, in drive
    cam = PiCamera(image_w=cfg.IMAGE_W, image_h=cfg.IMAGE_H, image_d=cfg.IMAGE_DEPTH)
  File "/root/projects/donkeycar/donkeycar/parts/camera.py", line 20, in __init__
    self.camera = PiCamera() #PiCamera gets resolution (height, width)
  File "/root/projects/donkeycar/picamera/picamera/camera.py", line 407, in __init__
    self._init_revision(options)
  File "/root/projects/donkeycar/picamera/picamera/camera.py", line 479, in _init_revision
    with mo.MMALCameraInfo() as camera_info:
  File "/root/projects/donkeycar/picamera/picamera/mmalobj.py", line 2425, in __init__
    super(MMALCameraInfo, self).__init__()
  File "/root/projects/donkeycar/picamera/picamera/mmalobj.py", line 698, in __init__
    prefix="Failed to create MMAL component %s" % self.component_type)
  File "/root/projects/donkeycar/picamera/picamera/exc.py", line 184, in mmal_check
    raise PiCameraMMALError(status, prefix)
picamera.exc.PiCameraMMALError: Failed to create MMAL component b'vc.camera_info': Function not implemented

9018, 2020-03-24:
i use the kaliarm64 on pi4
i use the https://github.com/raspberrypi/userland
i can run vcgencmd get_camera ； supported=1 detected=1
i can use raspistill -o image.jpg -rot 180

adeeb10abbas, 2020-05-06:
I struggled with the same problem for hours before the forehead-slap-worthy realization that I had the camera cable inserted upside down into the raspberry pi's slot :/ Thought I'd post that here in case it helps others :)

DocGarbanzo, 2022-10-27:
Closed due to inactivity

Closed 2022-10-27.

Thread 583 (2020-05-09):

Save gym data to tub files

Bleyddyn, 2020-05-09:
I wanted to be able save data returned by the DonkeyCar simulator into tub files. Rather than having to add a new entry for each item (reward, done, cte, etc) I added support for saving dictionaries to the tub format. I also added support in the drive code and the DonkeyGymEnv class.

My fork has diverged quite a lot so I haven't created a pull request but I can if there's interest.

My changes are in these two commits

https://github.com/Bleyddyn/donkeycar/commit/0964d0fd5b9f30cc893017d28f735bdc0df5724e
 https://github.com/Bleyddyn/donkeycar/commit/552493fd5d41dd45902d0808434fed7908ee229e

tawnkramer, 2020-06-04:
the default setup from donkey will write out data returned from the sim to tub files.

Bleyddyn, 2020-06-08:
I think I've checked everywhere in master that might have that code but I can't find it. Any suggestions where to look?

tawnkramer, 2020-06-08:
If you run the Donkeycar framework with the DONKEY_GYM = True in
myconfig.py then it will use the Tub manager to save data.

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

Bleyddyn, 2020-06-08:
No-one else seems to be interested in this so it's kind of a moot point, but I ran this find in both master and dev of autorope/donkeycar:

$ find . -name '*.py' -exec grep -H '\.info' {} \; | grep -v "logging.info" | grep -v "logger.info"
./donkeycar/parts/dgym.py:        self.info = { 'pos' : (0., 0., 0.)}
./donkeycar/parts/dgym.py:            self.frame, _, _, self.info = self.env.step(self.action)

So DonkeyGymEnv is collecting the info dictionary returned by the the simulator, but there's no code that I can find that's doing anything with it, like saving it to a Tub file.

joostaafjes, 2020-06-30:
This would be nice!! +1

wallarug, 2020-10-25:
Hey @Bleyddyn  do you still have issues with this in the latest Donkey V4.0 dev branch?   Happy to pick this one up.

Bleyddyn, 2020-10-25:
@wallarug Sorry I haven't checked out v4.0 yet. If there's any interest you're welcome to check out the commits I linked.

wallarug, 2020-11-01:
Hey @Bleyddyn ,

I've taken a good look at the changes you have proposed.   I've spent a lot of time the past few weeks working on exactly the same parts to get the 'extra' information back out to Donkey Car.

In particular, I wanted to speed variable out of that `info` array.

https://github.com/autorope/donkeycar/pull/673

I take a little bit of issue with the way you have done it here in your PR (because I made the same mistake as well when I first submitted a PR to get speed).  It doesn't conform to the same standard as all the other Donkey Car Parts.  All the other Donkey Car Parts that are sending back information from the simulator or a piece of hardware send back only single datatypes, not lists or dicts.  For example:  speed - float, throttle - float, angle - float, break - float, image - array.   No two things are sent back and if they are, they are send separately like:

this
```python3
return throttle, angle, brake
```

not
```python3
ret = [throttle, angle]
return ret, brake
```

To make your change standard, instead of sending back info, only send back what you need/want out of that object.  I could pass sending back coordinates in an array/list/dict/json because they will always need to be linked.

change to this style...
```python3
return self.frame, self.info['speed'], self.info['pos']
```

The other thing to note with this change - it is a breaking change.  It affects all the template files and removes backwards compatibility from previous manage.py's in Donkey Car.  I am not 100% of a fan of [my own changes](https://github.com/autorope/donkeycar/pull/673/commits/31e3f6b88d28becb63327fb14cc869cbc522d5d0) either but there doesn't appear to be a better way at this point to add the new features.

I did note you created another class - I still do not think this is the best way either to be merged into the core repository.  I am more in support of putting the changes in permanently to the existing part and forcing everyone to update.  I think it is a better long-term strategy.

Happy to take feedback on the above too, I am not the expert.

Bleyddyn, 2020-11-09:
I'm fine with returning individual pieces of data, although in my case it will start to get messy pretty quickly since I want: speed, cross track error, reward, done flag, and yaw (which I will have to add to the simulator at some point).

As for the template files, whether I return to using the baseline donkeycar code or stick with my fork, I'm certainly not going back to using the template files. I overwrote my changes too many times for that and I really think the majority of that code should be moved into the library and only referenced from the template code (e.g. https://github.com/Bleyddyn/donkeycar/blob/dev/donkeycar/drive/drive.py).

wallarug, 2020-11-09:
I highly recommend you update to a more current version of Donkey Car.  It looks like your repo is well over 480 commits behind.  3.1.0 is very old.  It will be very difficult for the maintainers to merge in any of your feature requests.

> As for the template files, whether I return to using the baseline donkeycar code or stick with my fork, I'm certainly not going back to using the template files. I overwrote my changes too many times for that and I really think the majority of that code should be moved into the library and only referenced from the template code (e.g. https://github.com/Bleyddyn/donkeycar/blob/dev/donkeycar/drive/drive.py).

I have been discussing this problem with a few of the maintainers and I believe they are moving back towards one template file again.  So this will not help yourself or anyone else who are making large changes.

Bleyddyn, 2022-01-22:
I'm not sure when it happened but it looks to me like at least some of the sim data are now being saved to v2 Tub files.

luigidiguglielmo-devel, 2022-03-05:
Commit #985 causes problems with saving gym data to tub files. I'm experiencing the very same issue described here:
https://github.com/autorope/donkeycar/issues/583#issuecomment-652028685

Everything works perfectly until #983.

Closed 2022-01-22.

Thread 586 (2020-05-25):

Jetson Nano (card-image-r32.4.2) and Tensorflow 1.13

filmo, 2020-05-25:
Following the [nano setup instructions](https://docs.donkeycar.com/guide/robot_sbc/setup_jetson_nano/) no longer seems to work with current links. In particular, the current (a/o 2020-05-25) SD card nv-jetson-nano-sd-card-image-r32.4.2 comes with Cuda 10.2 on it which is not compatible with the in the subsequent install of TF in the instructions.

`pip install --extra-index-url https://developer.download.nvidia.com/compute/redist/jp/v42 tensorflow-gpu==1.13.1+nv19.3
 `

**Question**: what is the correct archival SD card that is compatible with TF 1.13 ?

Alternatively, which version of TF is compatible with the current Cuda 10.2 and **_also_** works with the Donkey Car code base? (For example, could we use the TF 2.x family ? How about TF 1.15 instead of 1.13 ??)

tikurahul, 2020-05-25:
Nvidia updates it images every couple of months.
https://docs.nvidia.com/deeplearning/frameworks/install-tf-jetson-platform/index.html is the best place for information about how to install Tensorflow on Jetson.

Specifically the step you are looking for is:

```
pip install --pre --extra-index-url https://developer.download.nvidia.com/compute/redist/jp/v44 ‘tensorflow<2’
```

This should install TF 1.15.2 on the Nano. You should also refer to the above URL for the pre-requisites.

tawnkramer, 2020-06-04:
@tikurahul do you want to change the docs?

tikurahul, 2020-06-04:
I also need to fix `keras.py`. Will send you a PR today.

NathKorat, 2022-08-09:
you saved my life!!!!

Ezward, 2023-03-04:
Closing as obsolete.

Closed 2023-03-04.

Thread 594 (2020-06-10):

can't browser the website with "raspberrypi.local:8887"

CarloHan, 2020-06-10:
After running
`python manage.py drive`
I got these:
```(env) pi@raspberrypi:~ $ cd ~/mycar
(env) pi@raspberrypi:~/mycar $ python manage.py drive
using donkey v3.1.2 ...
loading config file: /home/pi/mycar/config.py
myconfig myconfig.py
loading personal config over-rides from myconfig.py

config loaded
cfg.CAMERA_TYPE PICAM
PiCamera loaded.. .warming camera
Adding part PiCamera.
Starting Donkey Server...... you can now go to raspberrypi.local:8887 to drive your car.
Adding part LocalWebController.
Adding part ThrottleFilter.
Adding part PilotCondition.
Adding part RecordTracker.
Adding part ImgPreProcess.
Adding part DriveMode.
Adding part AiLaunch.
Adding part AiRunCondition.
PWM Steering created
Init ESC
PWM Throttle created
Adding part PWMSteering.
Adding part PWMThrottle.
Tub does NOT exist. Creating new tub...
New tub created at: /home/pi/mycar/data/tub_4_20-06-10
Adding part TubWriter.
You can now go to <your hostname.local>:8887 to drive your car.
Starting vehicle at 20 Hz
/usr/lib/python3/dist-packages/picamera/encoders.py:544: PiCameraResolutionRounded: frame size rounded up from 160x120 to 160x128
  width, height, fwidth, fheight)))
```
I'm not sure if it's good or not, but I can't open the website with "raspberrypi.local:8887", or "IP:8887"
hope someone could help me, thank you so much!

krissdap, 2020-07-10:
The "raspberrypi.local" might work or not depends on your LAN settings.

But the other address shouldn't be "IP:8887".
"IP" part should be set of four numbers, separated by dot.
E.g. 192.168.1.100.

You could get the IP address by typing "ifconfig -a"
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
So for example, in this case we should use "http://192.168.1.128:8887"

krissdap, 2020-07-10:
And your other question, I don't think the SSH is frozen.
But the python script is running.
You could try pressing "Ctrl-C" on your keyboard, to see if it terminates the script.

DocGarbanzo, 2021-01-16:
@CarloHan - can you let us know if you solve the issue?

DocGarbanzo, 2022-10-27:
Closed due to inactivity.

co2131, 2024-04-17:
Hi we try https://10.18.217.170:8887 on our web browser and the page is also not working. Does anyone know how to get access to the web control?

Closed 2022-10-27.

Thread 595 (2020-06-10):

Adjusting default PWM Frequency

albTian, 2020-06-10:
Hi,

I'm on the calibration step now with my servo in channel 1 and throttle in channel 0. I can get my servos to rotate left and right using
`donkey calibrate --channel 1 --bus=1`
but nothing happens with my throttle when I run
`donkey calibrate --channel 0 --bus=1`.

Originally, the ESC for my motor takes a 100hz signal with a duty cycle between 10-20% and I verified that this works by using a function generator set to 100hz. **The default signal from the calibrate command is 60hz, and I'm wondering how to change that to 100hz for my car to work.**

Additionally, when I use my raspberry pi to calibrate, the light on my ESC flashes green which detects that the 'Throttle Trim is incorrectly set'.

For reference I am using a Rasberry Pi 3 with a Traxxas Slash 4x4

Thank you!!

albTian, 2020-06-11:
Found the solution, calibrate has a --pwmFreq parameter where the default is set to 60hz. I changed the default - found in projectName/donkeycar/donkeycar/management/base.py - to 100hz

Closed 2020-06-11.

Thread 608 (2020-07-28):

Reoganize parts folder and refactor large files

Ezward, 2020-07-28:
The parts folder is one the most important sets of source in the donkey project, but it is not well organized.  I am proposing two steps to make the parts folder more understandable and maintainable;
1. Move parts into sub-folders organized around robotics functions
2. Refactor large dumping ground files into smaller single-purpose files.
  - It is likely that after a refactor we will find a lot of code that really is not a 'part', in which case we would move that out of the parts folder.  For instance, we may want a machine-learning folder outside of the parts folder that deals with models and learning the models.  That kind of functionality should not in the 'parts' folder; probably on the inference call needs to be in the parts folder.

Here is an initial proposal.  This is a simple first cut; we could go deeper into each file and confirm it's destination.  Further, we could look at each file and decide how to refactor it and where those resulting files should live.

- Organize parts folder under broad robotics functions and refactor large files (or dumping ground files):
  - [perception]
    - [tachometry]
	  - encoder.py
	  - pigpio_enc.py
	- [imu]
	  - imu.py
	- [camera]
	  - camera.py 			// TODO: refactor each camera into it's own file
	  - realsense2.py
	  - realsense435i.py
	- [proximity]
	  - lidar.py
	- [obstacle]

  - [machine_learning]		// TODO: probably move most of machine_learning out of parts - leave only the actual parts that do inference in the parts folder
	- [pytorch]
	  - fastai.py
	- [tensorflow]
	  - keras.py			// TODO: refactor into smaller files
	  - tflite.py
	  - coral.py
	- [tensorrt]
	  - tensorrt.py
	- [augmentation]
	  - augment.py 			// TODO: refactor individual augmentations into their own files
	- behavoir.py
	- salient.py

  - [computer_vision]
    - image.py				// TODO: refactor into separate files - this is a dumping ground for loosely related parts
	- cv.py					// TODO: refactor into separate files inside a cv2 folder - some methods are not parts and should be moved out to general computer_vision folder

  - [localization]
    - [map]
	- [particle_filter]
	- [kalman_filter]

  - [planning]
    - [path]
	- [avoidance]

  - [control]
    - [actuation]
	  - actuator.py. 		// TODO: break out individual actuators into their own files
	  - launch.py
	  - serial_controller.py_
	- [gamepad]
	  - controller.py 		// TODO: break into base and separate files for each kind of joystick and separate file for joystick creator.
	- [voice_control]
	- [web_controller]
	- robohat.py			// TODO: refactor controller and driver into their own files
	- sombrero.py
	- teensy.py
	- throttle_filter.py
	- transform.py			// TODO: this has several unrelated classes/methods - refractor into their own files

  - [simulation]
	- dgym.py
	- simulation.py

  - [telemetry]
    - datastore.py
	- file_watcher.py
	- graph.py
	- led_status.py
	- network.py			// TODO: network pub/sub messaging: not sure if this is telemetry or related to control (has to do with gym remote control)
	- oled.py
	- ros.py

sctse999, 2020-07-29:
I like the idea of having a set of agreed development guidelines so we can keep things organized and easy to follow (so more ppl can contribute easier). I think having sub-folders is a good idea because we might have similar stuff that we want to group together. Test case is something that I concern most. Maybe we want to apply something similar to the test folder.

Ezward, 2020-07-29:
I agree about the test folder; it should reflect the structure of the src folder.  I will open another issue after we finalize the structure of the src folder.

wallarug, 2020-07-30:
I have some views on the structure.  It has been improved before.

I like this new structure but need to make a suggestion on the hardware / controller folder.  It in my view has always been confusing having _actuation_ and _control_ types for the parts and then custom boards separate.  As suggested in the post, they should be refactored into separate parts and stored in the appropriate directory.

You should not have hardware output controllers (PCA9685, Robo HAT MM1, etc) in the same folder as the remote controls.  It doesn't make sense and is confusing from a naming convention point of view.

The other suggestion I would like to propose is less directories than that which has been proposed.  Everything should be able to fall into one of five top level categories, as below to avoid having lots of things at the top level (as is the case with parts/ at the moment).

--
- **[actuation / hardware / outputs]**
  - [boards]
     - pca9685.py
     - sombreo.py
     - robohat.py
  - [other]
     - serial_controller.py
     - each individual actuator
  - [extra]
    - throttle_filter.py
    - transform.py

--
- **[compute]**
  - [tensorflow]
  - [pytorch]
  - [tensorrt]
  - [computer_vision]
  - [localization]

--
- **[control / inputs]**
  - [web_controller]
  - [boards]
    - robohat.py
  - [simulation]

--
- **[sensors / sensory]**
  - [vision]
    - camera.py
    - realsense.py
  - [proximity]
    -lidar.py
   - hcsr04.py
  - [motion]
    - imu.py
    - encoder.py

--
**- [telemetry / communication]**

I like where this is heading in general and open to see everyone else's suggestions.

Thread 620 (2020-08-23):

Bug in hello world example?

cdeil, 2020-08-23:
The example at http://docs.donkeycar.com/#hello-world has a line
```
V.add(tub, inputs=inputs)
```
but no variable `inputs` has been defined.

This will give a NameError, no?

Current code version is [here](https://github.com/autorope/donkeycar/blob/c983d7190a06bf852d46ac3356af703e03e02103/docs/index.md#hello-world).

sctse999, 2020-08-24:
Nice catch. Probably that won't run. Do you want to submit a PR for that?

cdeil, 2020-08-24:
I just got my car yesterday and haven't even assembled it yet, I don't know what the fix is here. @sctse999 - can you please do it?

tawnkramer, 2020-09-12:
looks fixed now

cdeil, 2020-09-13:
@tawnkramer - Please re-open this issue.

The example at https://github.com/autorope/donkeycar/blob/master/docs/index.md#hello-world that gets displayed at http://docs.donkeycar.com/#hello-world is unchanged and still broken.

It's currently this:
```
import donkey as dk

#initialize the vehicle
V = dk.Vehicle()

#add a camera part
cam = dk.parts.PiCamera()
V.add(cam, outputs=['image'], threaded=True)

#add tub part to record images
tub = dk.parts.Tub(path='~/mycar/data',
                   inputs=['image'],
                   types=['image_array'])
V.add(tub, inputs=inputs)

#start the vehicle's drive loop
V.start(max_loop_count=100)
```

Already the first import is broken, it's "donkeycar", not "donkey". Other things about this script are broken, too.

There is a working example using CVCam here: https://github.com/autorope/donkeycar#modify-your-cars-behavior

```
from donkeycar import Vehicle
from donkeycar.parts.camera import PiCamera
from donkeycar.parts.datastore import TubWriter

# initialize the vehicle
V = Vehicle()

IMAGE_W = 160
IMAGE_H = 120
IMAGE_DEPTH = 3

# add a camera part
cam = PiCamera(image_w=IMAGE_W, image_h=IMAGE_H, image_d=IMAGE_DEPTH)
V.add(cam, outputs=['image'], threaded=True)

#while cam.run() is None:
#    time.sleep(1)

# add tub writer part to record images
tub = TubWriter(path='./dat',
                inputs=['image'],
                types=['image_array'])
V.add(tub, inputs=['image'], outputs=['num_records'])

# start the vehicle's drive loop
V.start(rate_hz=10)
```

Following that example I tried this to make PiCamera work:
```
from donkeycar import Vehicle
from donkeycar.parts.camera import PiCamera
from donkeycar.parts.datastore import TubWriter

# initialize the vehicle
V = Vehicle()

IMAGE_W = 160
IMAGE_H = 120
IMAGE_DEPTH = 3

# add a camera part
cam = PiCamera(image_w=IMAGE_W, image_h=IMAGE_H, image_d=IMAGE_DEPTH)
V.add(cam, outputs=['image'], threaded=True)

#while cam.run() is None:
#    time.sleep(1)

# add tub writer part to record images
tub = TubWriter(path='./dat',
                inputs=['image'],
                types=['image_array'])
V.add(tub, inputs=['image'], outputs=['num_records'])

# start the vehicle's drive loop
V.start(rate_hz=10)
```
But it fails like this:
```
$ python b.py
using donkey v3.1.5 ...
PiCamera loaded.. .warming camera
Adding part PiCamera.
/usr/lib/python3/dist-packages/picamera/encoders.py:544: PiCameraResolutionRounded: frame size rounded up from 160x120 to 160x128
  width, height, fwidth, fheight)))
Tub does NOT exist. Creating new tub...
New tub created at: ./dat
Adding part TubWriter.
Starting vehicle at 10 Hz
Traceback (most recent call last):
  File "/home/pi/projects/donkeycar/donkeycar/vehicle.py", line 151, in start
    self.update_parts()
  File "/home/pi/projects/donkeycar/donkeycar/vehicle.py", line 199, in update_parts
    outputs = p.run(*inputs)
  File "/home/pi/projects/donkeycar/donkeycar/parts/datastore.py", line 447, in run
    self.put_record(record)
  File "/home/pi/projects/donkeycar/donkeycar/parts/datastore.py", line 228, in put_record
    img = Image.fromarray(np.uint8(val))
TypeError: int() argument must be a string, a bytes-like object or a number, not 'NoneType'
Shutting down vehicle and its parts...
Stopping PiCamera
Part Profile Summary: (times in ms)
+------+-----+-----+-----+-----+-----+-----+-------+
| part | max | min | avg | 50% | 90% | 99% | 99.9% |
+------+-----+-----+-----+-----+-----+-----+-------+
+------+-----+-----+-----+-----+-----+-----+-------+
```

@tawnkramer , @sctse999 or anyone - do you know how to write a working example with PiCamera?

Otherwise maybe removing the broken example and just pointing to the working one using CVCam in the README could be an option?

Closed 2020-09-12.

Thread 628 (2020-09-08):

Steering commands are reversed when using Web Controller

TCIII, 2020-09-08:
Ran into an interesting issue when testing the Robo HAT MM1 with and without using --js. I am running DC 3.1.5.

When I run manage.py drive --js the 2WD skid steering will correctly go left and right when the R/C controller steering wheel goes left and right and forwards and backwards when the R/C throttle trigger is pulled towards the grip handle and pushed forward away from the grip handle.

However when I use manage.py drive, the 2WD skid steering will incorrectly go right when I use the web controller circular mouse pointer (joystick) to go left and vice versa, but  correctly goes forward and backwards when I push the mouse pointer circle up and down.

The same thing occurs with my XBox gamepad and the web controller. If I push the left joystick forward and backwards, the 2WD skid steering correctly goes forward and backwards, but when I push the right joystick to the left, the 2WD skid steering incorrectly goes right and vice versa.

Since the Robo HAT MM1 correctly commands the 2WD skid  steering to go right and left tracking the R/C controller steering wheel when I run manage.py drive --js, it seems like the robohat.py code might be sending reversed steering commands to the Robo HAT MM1 when I am using the web controller interface to steer the 2WD chassis using either the mouse joystick or the XBox gamepad controller.

TCIII, 2020-09-12:
My testing has revealed that a certain section of the robohat.py steering code is incorrect.

sctse999, 2020-09-12:
Hi @TCIII , it would greatly help me to understand the issue if you can add a test case with your expected output in https://github.com/autorope/donkeycar/blob/dev/donkeycar/tests/test_robohat.py

If you are unsure how to do this, pm me in discord.

tawnkramer, 2020-09-12:
Since we are talking about that file, I just wanted to point out that it's
not testing anything at the moment. I disabled things because they were
failing when we didn't have a robohat. I added a blank function in there
that we can fill out to let us know we have the hardware so we can run the
tests.

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

TCIII, 2020-09-12:
@sctse999,
I believe the problem lies in the robohat.py code here:
if steering > 0:
                output_steering = dk.utils.map_range(steering,
                                                     0, 1.0,
                                                     self.STEERING_MID, 1000)
            else:
                output_steering = dk.utils.map_range(steering,
                                                     -1, 0,
                                                     2000, self.STEERING_MID)

Be changed to:
if steering > 0:
                output_steering = dk.utils.map_range(steering,
                                                     0, 1.0,
                                                     self.STEERING_MID, 2000)
            else:
                output_steering = dk.utils.map_range(steering,
                                                     -1, 0,
                                                     1000, self.STEERING_MID)

wallarug, 2020-10-18:
Did you ever finish fixing this up @TCIII  or is this something I still need to look at?

TCIII, 2020-10-18:
I reversed the left and right steering commands being sent to the Robo HAT MM1 and that corrected the problem I was having with the reversed steering when using the web controller with the Robo HAT MM1.
You can make the correction if you want to, but since I am the only one who has noticed it and corrected it for my purposes, maybe you should let it go as an exercise for other users?

Ezward, 2023-02-18:
@sctse999 Can I close this?

TCIII, 2023-02-18:
@Ezward,

Yes.
TCIII

Closed 2023-02-18.

Thread 719 (2021-01-03):

Chaining IMU and Servo Driver

jamesdi1993, 2021-01-03:
Hello,

I'm pretty new to electronics and circuit design, and my question might be naive. I couldn't figure out how to connect the IMU with the PI per the website instruction "Typically uses the I2C interface and can be chained off the default PWM PCA9685 board. This configuration will also provide power".

Specifically, what does chaining mean here?  As far as I know, both IMU and the PCA 9685 both use I2c buses for communication. My PI-2B only have 2 i2c pins so I can understand the necessity of sharing I2c bus here. However, the servo board has I2C as input, and should output PWB.  I'm a bit confused how to do this chaining of the IMU and the servo board because their input & output don't seem to match.

I tried to look up some tutorials online but the resources seem a bit scarce. If you have some resources for reference that would be greatly appreciated, too.

Thanks in advance!

DocGarbanzo, 2021-01-16:
Hi @jamesdi1993,

You can just connect the 2 devices (PCA 9685) and IMU in parallel. In fact the PCA (9685) has pins on both side, so you use one side to connect to your Pi and connect the IMU on the other side.

jamesdi1993, 2021-02-07:
Hi,

Thanks for your reply. I tried your suggestions and can see that my IMU is registered at address 68 when command "sudo i2cdetect -y 1".

However, when I run "python manage.py drive" it throws the following error:

using donkey v4.1.0 ...
loading config file: /home/pi/mycar/config.py
loading personal config over-rides from myconfig.py
PiCamera loaded.. .warming camera
Adding part PiCamera.
Starting Donkey Server...... you can now go to pi-james.local:8887 to drive your car.
Adding part LocalWebController.
Adding part PilotCondition.
Adding part DriveMode.
Traceback (most recent call last):
  File "manage.py", line 172, in <module>
    drive(cfg, model_path=args['--model'], model_type=args['--type'])
  File "manage.py", line 141, in drive
    busnum=cfg.PCA9685_I2C_BUSNUM)
  File "/home/pi/projects/donkeycar/donkeycar/parts/actuator.py", line 30, in __init__
    self.pwm = Adafruit_PCA9685.PCA9685(address=address)
  File "/home/pi/env/lib/python3.7/site-packages/Adafruit_PCA9685/PCA9685.py", line 75, in __init__
    self.set_all_pwm(0, 0)
  File "/home/pi/env/lib/python3.7/site-packages/Adafruit_PCA9685/PCA9685.py", line 111, in set_all_pwm
    self._device.write8(ALL_LED_ON_L, on & 0xFF)
  File "/home/pi/env/lib/python3.7/site-packages/Adafruit_GPIO/I2C.py", line 114, in write8
    self._bus.write_byte_data(self._address, register, value)
  File "/home/pi/env/lib/python3.7/site-packages/Adafruit_PureIO/smbus.py", line 322, in write_byte_data
    self._device.write(data)
OSError: [Errno 121] Remote I/O error

Do you know what additional steps I need to do to enable IMU?

jamesdi1993, 2021-02-08:
I was eventually able to integrate the IMU by connecting the power and ground with the Pi, and then connecting SDA and SCL with the other side of the PCA board.

Closed 2021-01-16.

Thread 735 (2021-01-12):

Having OSError: [Errno 121] Remote I/O error

Hyunwoo-Park-Yonsei, 2021-01-12:
When I type    python manage.py drive   and trying to go <your car's hostname.local>:8887 and control my car.
I got this error message.

using donkey v4.1.0-dev ...
loading config file: /home/pi/mycar/config.py
loading personal config over-rides from myconfig.py
PiCamera loaded.. .warming camera
Adding part PiCamera.
Starting Donkey Server...... you can now go to raspberrypi.local:8887 to drive your car.
Adding part LocalWebController.
Adding part PilotCondition.
Adding part DriveMode.
Traceback (most recent call last):
  File "manage.py", line 171, in <module>
    drive(cfg, model_path=args['--model'], model_type=args['--type'])
  File "manage.py", line 140, in drive
    busnum=cfg.PCA9685_I2C_BUSNUM)
  File "/home/pi/projects/donkeycar/donkeycar/parts/actuator.py", line 30, in __init__
    self.pwm = Adafruit_PCA9685.PCA9685(address=address)
  File "/home/pi/env/lib/python3.7/site-packages/Adafruit_PCA9685/PCA9685.py", line 75, in __init__
    self.set_all_pwm(0, 0)
  File "/home/pi/env/lib/python3.7/site-packages/Adafruit_PCA9685/PCA9685.py", line 111, in set_all_pwm
    self._device.write8(ALL_LED_ON_L, on & 0xFF)
  File "/home/pi/env/lib/python3.7/site-packages/Adafruit_GPIO/I2C.py", line 114, in write8
    self._bus.write_byte_data(self._address, register, value)
  File "/home/pi/env/lib/python3.7/site-packages/Adafruit_PureIO/smbus.py", line 322, in write_byte_data
    self._device.write(data)
OSError: [Errno 121] Remote I/O error

TCIII, 2021-01-13:
The error you are seeing is usually caused by the DC manag.py program not being able to communicate with the PCA9685 servo controller over the I2C bus. If you are using an Rpi 3/4 did you verify that the software was seeing the PCA9685 at hex address 0x40? If not that may be your problem.
However if you are not using a PCA9685 servo controller, then you have a problem unless the servo controller performs the same way and can be addressed like the PCA9685 then you can change the servo controller address in myconfig.py.

sctse999, 2021-01-26:
Please following the instruction and use `i2cdetect` to check the connectivity of PCA9685.

http://docs.donkeycar.com/guide/create_application/#configure-i2c-pca9685

I am closing this issue now. If you are still experiencing issue, feel free to reopen it.

Closed 2021-01-26.

Thread 742 (2021-01-13):

Epoch failure during train command

kelvham, 2021-01-13:
When the
`python ~/mycar/train.py --tub <tub folder names comma separated> --model ./models/mypilot.h5`
command  is ran (any form of it), the epochs start but eventually fail with error
`W tensorflow/core/kernels/data/generator_dataset_op.cc:103] Error occurred when finalizing GeneratorDataset iterator: Failed precondition: Python interpreter state is not initialized. The process may be terminated.
         [[{{node PyFunc}}]]` .

tikurahul, 2021-01-14:
Which version of TensorFlow are you using ? You should be using 2.2.0 or 2.3.0.

kelvham, 2021-01-14:
> Which version of TensorFlow are you using ? You should be using 2.2.0 or 2.3.0.

I am using 2.3.0

tikurahul, 2021-01-14:
Can you please do the following:

```
import tensorflow as tf
print(tf.__version__)
```

By opening a Python REPL in your environment. I have only seen this happen when using TF 1.15.

kelvham, 2021-01-14:
I'm sorry, I am brand new to Python, I think this is what you were looking for:

`(donkey) C:\Users\Kelvin>python
Python 3.7.9 (default, Aug 31 2020, 17:10:11) [MSC v.1916 64 bit (AMD64)] :: Anaconda, Inc. on win32
Type "help", "copyright", "credits" or "license" for more information.
>>> import tensorflow as tf
>>> print(tf.__version__)
2.3.0`

tikurahul, 2021-01-14:
I can see your virtualenv activated here. What happens when you try training now ?
Can you send us all the logs in the console ?

I have a feeling that you might be running out of memory so maybe try decreasing the batch size ?
Related: https://github.com/tensorflow/tensorflow/issues/24570

kelvham, 2021-01-14:
@tikurahul this is the consoles output when I try training
[console.txt](https://github.com/autorope/donkeycar/files/5816250/console.txt).

I actually was trying to run it with a smaller batch size but I could not find where/what file to edit to decrease the batch. I am brand new to all this stuff, so I am not sure what resources of the PC it uses, but I have an i7 8700k, GTX 1080, and 32 GB of RAM, so I did not think I would reach any limitations.

tikurahul, 2021-01-16:
Sorry, I am not sure what is going on in your case. I recommend opening a bug in the TF repo.

DocGarbanzo, 2021-01-16:
Can you try w/ latest TensorFlow 2.3.2: `pip install tensorflow==2.3.2`? Btw, you are not using your graphics card for training, you'd need to install `tensorflow-gpu` instead. But I suggest you fix the current problem first as the gpu setup can cause a lot of other issues. Memory-wise you should be absolutely fine.

kelvham, 2021-01-17:
@DocGarbanzo not sure exactly what went wrong here, but ended up with the same error.
[console with 2.3.2.txt](https://github.com/autorope/donkeycar/files/5825515/console.with.2.3.2.txt)

tikurahul, 2021-01-17:
With TF 2.x there is no `tensorflow-gpu`. Its all the same package.

Can you please try using the latest stable version ? That's `TF 2.4.0`.
https://www.tensorflow.org/versions has more info.

kelvham, 2021-01-17:
@tikurahul Same issue with 2.4.0
[console with 2.4.0.txt](https://github.com/autorope/donkeycar/files/5825560/console.with.2.4.0.txt)

tikurahul, 2021-01-17:
At this point I would recommend filing a bug with TF. I have a feeling that might be fastest way to get to the bottom of this.

custom-build-robots, 2021-01-20:
I switched back from TensorFlow 2.3.0 to TensorFlow 2.1.0 in my Windows Anaconda installation. Now I am getting a new error attached as picture.
The error is repeatable on different computers and different Anaconda installations. I used always the ubuntu.yml installation file and only changed the version for TensorFlow to `tensorflow==2.1.0`.
Not sure if I should open a new issue?
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

DocGarbanzo, 2021-01-22:
Can you please try and install TensorFlow 2.2.0 - that version is in the conda files and the setup file and it is the version that is tested and proven to work on OSX and Linux.

sctse999, 2021-01-26:
perhaps conda doesn't offer Tensorflow 2.2.0 on windows?

https://anaconda.org/anaconda/tensorflow/files?version=2.2.0&page=2

@custom-build-robots are you able to install TF 2.2.0 on your platform?

kelvham, 2021-01-26:
@DocGarbanzo @sctse999 I was using 2.2.0, but was told to upgrade.

sctse999, 2021-01-26:
> > Which version of TensorFlow are you using ? You should be using 2.2.0 or 2.3.0.
>
> I am using 2.3.0 @tikurahul

Were you using 2.2.0 or 2.3.0?

kelvham, 2021-01-26:
@sctse999 I was originally using 2.2.0, as default in the yml file. But, as you suspected, conda does not support 2.2.0, so I had to upgrade.

DocGarbanzo, 2021-01-26:
@kelvham - if there is no conda package for tf 2.2.0 under windows, then please install tf 2.2.0 with pip. We have to do the same thing on OSX. Which also means our `pc.yml` file needs to be split again into `ubuntu.yml` and `win.yml`.

kelvham, 2021-01-26:
@DocGarbanzo Sorry I may not completely understand how it all works, but I did install tf 2.2.0 using pip at one point yielding the same results.  I believe we talked about it over the Discord server which is why it’s not documented here. Nonetheless, I am going to try to run it with 2.2.0 again when I get the chance.

kelvham, 2021-01-28:
@DocGarbanzo, it looks like, it may have worked? No error message, but it stopped at epoch 39, is that normal?
[console with 2.2.0.txt](https://github.com/autorope/donkeycar/files/5888716/console.with.2.2.0.txt)

I copied my model file back to the car but when I try driving the car based on the model, I get another error.
[donkey model fail.txt](https://github.com/autorope/donkeycar/files/5888729/donkey.model.fail.txt)

DocGarbanzo, 2021-01-31:
Yep, training worked. On the RPi you need to install tf 2.2.0 as well. Our current docs (docs.donkeycar.com) unfortunately show the installation for tf 2.3.1. Please look up the docs under the `dev` branch - we just updated them yesterday - they contain the RPi install for 2.2.0 now.

mf01, 2021-02-08:
I can confirm this bug using DonkyCar 4.1.0 with Pythonh 3.8.5 and TensorFlow 2.4.1 on Win10.

**`Epoch 00014: val_loss did not improve from 0.00264
2021-02-08 10:24:48.692570: W tensorflow/core/kernels/data/generator_dataset_op.cc:107] Error occurred when finalizing GeneratorDataset iterator: Failed precondition: Python interpreter state is not initialized. The process may be terminated.
         [[{{node PyFunc}}]]`**

Closed 2021-01-31.

Thread 749 (2021-01-17):

Jetson Nano - Error "No module named imgaug" when starting the training

custom-build-robots, 2021-01-17:
Hi,
today I installed my jetson nano with the latest donkey car framework version. I did it by hand step by step and after that does not work I installed everythin new and used the `install-jp44.sh` script.
Driving around and collecting data worked after fixing two error.
The D`RIVE_TRAIN_TYPE = "SERVO_ESC"` was missing and the `CSIC_CAM_GSTREAMER_FLIP_PARM = 0` in the myconfig.py file.

Then I tried to start the training but no luck. I always got the errror:

```
(env) donkey@donkey:~/mycar$ python train.py --tubs=data/tub_test/,data/tub_2_21-01-16/,data/tub_1_21-01-16/,data/tub_3_21-01-16/ --model models/big.h5
________             ______                   _________
___  __ \_______________  /___________  __    __  ____/_____ ________
__  / / /  __ \_  __ \_  //_/  _ \_  / / /    _  /    _  __ `/_  ___/
_  /_/ // /_/ /  / / /  ,<  /  __/  /_/ /     / /___  / /_/ /_  /
/_____/ \____//_/ /_//_/|_| \___/_\__, /      \____/  \__,_/ /_/
                                 /____/

using donkey v4.1.0-dev ...
2021-01-17 17:25:59.245273: I tensorflow/stream_executor/platform/default/dso_loader.cc:48] Successfully opened dynamic library libcudart.so.10.2
Traceback (most recent call last):
  File "train.py", line 15, in <module>
    from donkeycar.pipeline.training import train
  File "/home/donkey/projects/donkeycar/donkeycar/pipeline/training.py", line 10, in <module>
    from donkeycar.pipeline.augmentations import ImageAugmentation
  File "/home/donkey/projects/donkeycar/donkeycar/pipeline/augmentations.py", line 3, in <module>
    import imgaug.augmenters as iaa
ModuleNotFoundError: No module named 'imgaug'
(env) donkey@donkey:~/mycar$ No module named 'imgaug'
```
Any idea whats wrong with my installation?

Thank you all very much for your help,
Ingmar

tikurahul, 2021-01-17:
We did not include `imgaug` in the list of required packages for the Nano, because we don't expect people to train on the Nano.

You need to install `imgaug` on the Nano. Unfortunately this package does not have prebuilt wheels on ARM64, which means this will take a while to compile.

https://github.com/aleju/imgaug is the package.

custom-build-robots, 2021-01-19:
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

Thank you @tikurahul I will try to install imgaug on the nano. At the moment I build (un-commented) the three imgaug lines in the training.py file. But it would be nice if the compiling will do the the job.

For me the problem is now understood / fixed.

Ezward, 2021-12-17:
@custom-build-robots Were you able to complete the training and then use the model on your nano?  The reason I ask is that we are having trouble when installing imgaug on Jetson Nano running Jetpack 4.6.  When we install imgaug the CSIC camera stops working.  It would be great to know your configuration if you were successful.  Thanks.

Closed 2021-01-19.

Thread 772 (2021-01-27):

Fatal error in actuator.py when run on NVIDIA Nano

TCIII, 2021-01-27:
Nano OS: Jetpack 4.5.1
DC: 4.1.0

Setting the DRIVE_TRAIN_TYPE = "DC_TWO_WHEEL" unfortunately causes "manage.py" to call part "actuator.py" which at line 576 imports "Rpi.GPIO as GPIO" which results in the following error: "RuntimeError: This module can only be run on a Raspberry Pi!"

Obviously this is not going to work on an NVIDIA Nano which requires "Jetson.GPIO to be imported.

Unless I missed something, there appears to be no checks in "actuator.py" as to which processor, Rpi or Nano, is being used and arbitrarily uses Rpi.GPIO when a Drive train type other than the default "SERVO_ESC" is selected.

zlite, 2021-01-27:
We don't actually have a config parameter that specifies which board this is running on. Is there a way we can query the OS to find out?

If not, we should add a cfg.PROCESSOR_TYPE to the master config

TCIII, 2021-01-27:
Good observation Chris, however the DC software had to have known the processor configuration or it wouldn't have issued the "RuntimeError: This module can only be run on a Raspberry Pi!" error.

The obvious solution to this import the default Rpi.GPIO unless the processor is a Nano and then import Jetson.GPIO

As a temporary solution is it possible for me to replace the Rpi.GPIO with Jeston.GPIO to keep my project moving along?

zlite, 2021-01-27:
Worth trying that. One way or another we'll have to have a Jetson GPIO solution

TCIII, 2021-01-27:
I found this on the Jetson.GPIO Github:

"11. PWM
See samples/simple_pwm.py for details on how to use PWM channels.

The Jetson.GPIO library supports PWM only on pins with attached hardware PWM controllers. Unlike the RPi.GPIO library, the Jetson.GPIO library does not implement Software emulated PWM. Jetson Nano supports 2 PWM channels, and Jetson AGX Xavier supports 3 PWM channels. Jetson TX1 and TX2 do not support any PWM channels.

The system pinmux must be configured to connect the hardware PWM controlller(s) to the relevant pins. If the pinmux is not configured, PWM signals will not reach the pins! The Jetson.GPIO library does not dynamically modify the pinmux configuration to achieve this. Read the L4T documentation for details on how to configure the pinmux."

The bottom line here is that unlike the Rpi GPIO Bus, the Nano GPIO Bus cannot support more than two PWM channels and there appears to be a fair amount of flag waving required to implement even those two channels.

Recommend that this issue be closed as the Nano is presently incapable of directly supporting PWM on its GPIO pins the same way as the Rpi family of SBCs and a notice added to the Nano DC docs concerning this PWM issue.

sctse999, 2021-01-28:
I didn't check if Jetson.GPIO share the same interface with Rpi.GPIO. If this is the case, what you need to do is to write a simple wrapper with a `try` block to import the correct library. Something like this:

```
try:
    import RPi.GPIO as GPIO
except:
    pass

try:
    import Jetson.GPIO as GPIO
except:
    pass
```

BrianHenryIE, 2022-03-06:
This happened me today, the solution was:

`pip uninstall RPi.GPIO`

Error was `python manage.py drive`:

```
________             ______                   _________      
___  __ \_______________  /___________  __    __  ____/_____ ________
__  / / /  __ \_  __ \_  //_/  _ \_  / / /    _  /    _  __ `/_  ___/
_  /_/ // /_/ /  / / /  ,<  /  __/  /_/ /     / /___  / /_/ /_  /
/_____/ \____//_/ /_//_/|_| \___/_\__, /      \____/  \__,_/ /_/
                                 /____/                      

using donkey v4.3.5 ...
Traceback (most recent call last):
  File "manage.py", line 24, in <module>
    from donkeycar.parts import actuator, pins
  File "/home/brian/projects/donkeycar/donkeycar/parts/actuator.py", line 13, in <module>
    from donkeycar.parts.pins import OutputPin, PwmPin, PinState
  File "/home/brian/projects/donkeycar/donkeycar/parts/pins.py", line 397, in <module>
    import RPi.GPIO as GPIO
  File "/home/brian/env/lib/python3.6/site-packages/RPi/GPIO/__init__.py", line 23, in <module>
    from RPi._GPIO import *
RuntimeError: This module can only be run on a Raspberry Pi!
```

Ezward, 2023-02-18:
This is caused by user error when installing; using the raspberry pi instructions on a jetson nano.  Simply uninstalling Rpi.GPIO fixes the issue.
```
pip uninstall RPi.GPIO
```

Closed 2023-02-18.

Thread 788 (2021-02-15):

OSError: [Errno 121] Remote I/O error whilst running "python manage.py drive"

Zayr0, 2021-02-15:
Hello, I'm stuck on this issue. I always get a remote I/O error whilst running "python manage.py drive".
I have activated i2c in the raspi-config and I also checked the wires from my pi going to the PiRacer board (i2c wires).
I can see the PCA9685 address using `i2cdetect -y 1` and I also am part of the i2c group. See below:
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
However, I still get this error. Any ideas/solutions? Thanks in advance!

BossZweifel, 2021-02-26:
Hi Zayr0, I am having now the exact same problem. What was your solution?

Zayr0, 2021-02-26:
Hi BossZweifel, for me it was that the i2c address of the PCA9685 was wrong (mycar/config.py), it was 60 which didn't exist in my i2c detect. However, I still can't properly steer and give throttle at the same time, as the program does not like it when you give it address 40 twice for both (even with different channels of the PCA board). But maybe you'll figure it out, good luck!

BossZweifel, 2021-02-27:
I put both on 0x40 now, specified the bus and calibrated it properly. While calibratiting, the servo was steering and the motor was turning as specified.
The python manage.py drive starts without an error. The webinterface is there and shows the slow camera feed.

But nothing happens when I give any inputs. I was really hoping to getting it to at least drive a bit today ...

Zayr0, 2021-02-27:
Yeah same. If you put one of them to a different address then 0x40 (but one that is detected by i2c detect) the other one does work. Maybe open it up as a separate issue on the issue page?

Closed 2021-02-19.

Thread 792 (2021-02-22):

When using the D435i with the Nano there is a noticeable lag in both steering and throttle.

TCIII, 2021-02-22:
SBC: NVIDIA Nano
OS: Jetpack 4.4.1
Ubuntu 18.04
DC: v 4.1.0
Camera: Intel D435i depth camera
Vehicle: Traxxas 4WD Slash with brushless ESC and motor

When using a PS4 gamepad for local control of my Donkey Car there is a noticeable lag in both the steering and throttle response of the car during "manage.py drive". I have experienced this lag in both DC v 3.1.5 and v 4.1.0.

I have investigated the lag in both the steering and the throttle response to determine whether it is the ESC or the Nano/PCA9685. I used a servo controller to test the Traxxas ESC and it responds correctly to the PWM range of 1.0 to 2.0 ms without hesitation. On the other hand I connected a PWM display to the throttle servo channel output on the PCA9685 to see what the throttle output was like during "manage.py drive". While using the PS4 gamepad I found that when I pushed the right joystick all the way up vertically, there was a definite delay (lag), sometimes short and sometimes long, before the throttle output PWM moved towards 2.0 ms. I experienced the same issue for reverse. There appears to be a definite issue with the drive loop's response to the PS4 gamepad throttle channel input and the appropriate output from the PCA9685 throttle channel output.
To make sure that there was not an issue with the PS4 gamepad communicating with the Nano, I paired and connected the PS4 to an identical Traxxas 4WD Slash running a Nano, but instead of a D435i depth camera it was using a Sainsmart 8 Mp color camera. I found that there was no lag between the steering and throttle outputs of the gamepad joysticks and the steering and throttle responses of the Slash steering servo and ESC motor controller.

Based upon my findings, it appears that there is some issue with the Nano when using the D435i depth camera in place of the usual Rpi or Sainsmart color cameras. I have a spare Sainsmart 8 Mp camera that I can use in place of the D435i depth camera to see if the gamepad to robot steering/throttle control latency is caused by the D435i depth camera being in the drive loop.

By disconnecting the D435i depth camera from the Nano and attaching a Sainsmart 8 Mp color camera to the Nano and updating "myconfig.py" to reflect the camera changeout, I verified that the Nano/Sainsmart combination does not have the steering/throttle latency issue that the Nano/D435i depth camera does. Restoring the Nano/D435i depth camera configuration and "myconfig.py" brought back the gamepad steering and throttle latency as I originally experienced. Even updating/upgrading Ubuntu did not cure the latency problem.

I have been working on the Nano/D435i camera project with a DC member in Australia who is using the same configuration, but is much farther ahead with the project than me. Attempts to contact him through Discord Direct Messages have been to no avail as he has been silent for three weeks so I do not have an experienced user who has performed data collection and training to fall back on.

Comments please.

zlite, 2021-02-22:
I've seen the same thing. I think the librealsense pipe polling module is not playing nicely with the donkey parts polling loop for some reason.  On the RPi 4, Realsense consistantly times out ("Frame not received in 5000").

Have you tried switching to 10w mode on the Nano to see if that makes a difference?

TCIII, 2021-02-22:
@zlite,

Since I am powering my Nano with an Anker 13 amp-hr battery I always run in the 10 watt four processor mode.

I hope that I hear from my FB DC friend in Australia soon as he has actually collected data and trained on the Nano using the same combination that I am using and might be able to shed some light on the latency issue.
The Realsense435i.py part was written by Ed Murphy almost two years ago and he does not appear to have a Github account.

TCIII, 2021-02-23:
@zlite,

Since the T265 tracking camera works without the latency issue on a Rpi 4B using the "path_follow.py" template, I believe that the cause of the latency is that "realsense435i.py" is capturing both video and IMU data which the T265 part did do. The T265 only used IMU data.
I am going to experiment by trying lower H and V widths at 30 Hz to see if reducing the window aperture will reduce the latency.

TCIII, 2021-02-23:
@zlite,

I have tried reducing the video frame window from the H =424, V=240 used by the member in Australia to no avail.
However, I did have a somewhat noticeable reduction in the latency by updating the D435i firmware from 5.12.2 to 5.12.9.

Additionally I have tried contacting Ed Murphy, the author of the "realsens435.py" part though his YouTube video comments found [here](https://www.youtube.com/watch?v=hzp6Yhgw9d0).

Ezward, 2021-02-23:
Hi @zlite .  The YouTube comment as a good idea!  So my first question is; how much latency are you seeing with 5.12.2 firmware and how much with 5.12.9 firmware?  As you probably could read in the issues I opened with Intel, making the RealSense pipeline work with RBG, Depth and IMU data was tricky; I did not see any Intel examples that tried to stream all of those simulatneously.  So I was in the 'get it to work' mode.  So there are probably optimizations that could be done.  The reading of the pipeline should be happening in a thread, so it should not block.

Ezward, 2021-02-23:
So, the driver I wrote uses two pipelines and that may be the issue; see https://github.com/IntelRealSense/librealsense/issues/6370#issuecomment-626398001  This issue describes how to setup callbacks in python: https://github.com/IntelRealSense/librealsense/issues/5417. I can take a look at this on the weekend.

TCIII, 2021-02-23:
@Ezward,

Thanks for chiming in, much appreciated.
Actually it was me, TCIII, who wrote the comment on your YouTube video.

Basically the latency symptoms occurred with both DC v 3.1.5 and v 4.1.0. When I run "manage.py drive" I have instant control of the car steering, however it is not smooth and kind of moves in increments from center to right or left if I push the PS4 gamepad left joystick from center all the way to the right or left horizontally.
As for the throttle, initially I have to push the PS4 gamepad right joystick all the way up vertically and wait about five seconds for the throttle to respond. After the initial delay, the throttle will respond fairly quickly to changes in the throttle joystick vertical position.
I believe that I noticed a reduction in latency and and increase in smoothness in the steering and throttle responses when I updated the D435i firmware from v 5.12.2 to v 5.12.9 today, but the initial latency to the initial throttle movement never changed.
I will be glad to work with you to investigate and reduce or eliminate the latency problem when using the Intel D435i with the DC OS.

TCIII, 2021-02-24:
@Ezward,

You appear to be using OpenCV in the "realsense435.py" part and OpenCV has undergone a number of upgrades since Apr 2019 that could possibly be causing an issue with your original code?

Ezward, 2021-02-25:
@TCIII the only thing I am doing with OpenCV is resizing and converting to grayscale.  It's not impossible that OpenCV has an issue, but I'm going to focus on the RealSense firmware, since I have seen a case where a firmware update basically broke IMU streaming.  I think the D435i variant is not well loved at Intel.  There are literally zero examples of streaming IMU, RGB and Depth simultaneously either in C++ or Python.  I had to figure that all myself.  I know this code is somewhat unstable; if it fails it usually fails at initialization while waiting for frames.  I don't like that API; one of the linked issues shows how to use callbacks in Python.  I think that would work better than waiting for frames.  So first I will look at reproducing the issue, then I will try firmware versions, then a will refactor using call backs.

TCIII, 2021-02-25:
@Ezward,

Thanks for the insights concerning OpenCV and the Intel D435i code examples, much appreciated. I understand your frustration.
I am available this weekend if you want a test subject available.

TCIII, 2021-03-03:
@Ezward

Did you have a chance to look at your "realsens435i.py" part last weekend as you said that you might possibly do?

Ezward, 2021-03-04:
@TCIII I'm sorry I did not get a chance.  I will get to it this weekend.

TCIII, 2021-03-04:
@Ezward

Thanks for the update, much appreciated.

Glad to be of help.

Presently I am just a novice Python programmer, but I will try and give your suggestion a shot.

Ezward, 2021-03-05:
Just `python realsense435i.py`, it will automatically look for a main.  You probably need the donkeycar virtual environment activated.

TCIII, 2021-03-05:
@Ezward,

Thanks for the input, much appreciated. I will give it a shot this weekend.

@zlite and I are working on getting the Slamtech RPLidar A1M8 integrated into the DC configuration using lidar.py also.

TCIII, 2021-03-05:
@Ezward,

Per your request, I ran python realsense435i.py from the parts directory and here is a sample of what was sent to the CLI via SSH:

"(env) thomas@thomas-desktop:~/projects/donkeycar/donkeycar/parts$ python3 realsense435i.py
The output images will be resized from (424, 240, 3) to (212, 120, 3).  This requires opencv.
Depth Scale is:  0.0010000000474974513
imu frame 1 in 0.38933682441711426 seconds:
        accel = (-0.009806649759411812, -9.110377311706543, -1.7750035524368286),
        gyro = (-0.005235987715423107, 0.0, 0.0)
imu frame 2 in 0.23500871658325195 seconds:
        accel = (-0.029419949278235435, -9.110377311706543, -1.794616937637329),
        gyro = (-0.003490658476948738, 0.001745329238474369, 0.0)
imu frame 3 in 0.23468327522277832 seconds:
        accel = (-0.029419949278235435, -9.110377311706543, -1.794616937637329),
        gyro = (-0.003490658476948738, -0.003490658476948738, 0.0)
imu frame 4 in 0.23511433601379395 seconds:"

Now, when I ran realsense435i.py from the Desktop and set "show_opencv_window = True, I got the same imu frame data plus two windows opened. One with the RGB camera video and one with the Depth camera.

Was this output what you were expecting with the "self test"?

Comments?

TCIII, 2021-03-08:
@Ezward

Did you have a chance to look at your "realsens435i.py" part this last weekend as you said that you might possibly do?

TCIII, 2021-03-13:
@Ezward,

Will you have a chance to look at your "realsens435i.py" part this weekend as you said that you might possibly do?

Ezward, 2021-03-14:
@TCIII , sorry for the silence.  I'm working on this now.
- Bummer that that turning off IMU did not have an effect; that was where I was going to look first.
- Yes, that is what the main() should do (not really a self test, but a self-hosting example where you can easily turn on and off options).  It's interesting that this appears to works smoothly, but the code does not work smoothly when running as a DonkeyCar part.  As a donkeycar part it is polled in a thread; the main thread simply returns that last values that the thread wrote when run_threaded() is called, but the same basic code is executing; I would expect to see stuttering frames if it was hesitating returning a frame.
- It sounds like I really need to duplicate the issue you are seeing before I go off and change anything.  I don't remember the same issue with my setup; I actually got my 1/10th build to do sub-10 second laps consistently, so steering and throttle where not an issue.  I'll see if I can make it happen with the same firmware you are using.
- One this that is worth saying; you should be using the USB cable that came with the camera or a certified SuperSpeed (SS) cable.  A random cable will cause lots of problems.  It doesn't sound like that is the issue you are seeing, but it is worth mentioning.

Ezward, 2021-03-15:
I've not been able to reproduce the issue with my setup; donkeycar 3.1 commit `77b1dc76`, Realsense SDK v2.32.1, firmware 05.12.03.00.   I don't have a PWM viewer, so I'm just looking at the response of throttle and steering by observing the car suspended in a box.  I see no difference between the 'MOCK' camera (no camera) and the 'D435' camera; both respond almost instantly to game controller inputs.  I'm using an XBox controller, but I would not think that matters.

My next step is to use Donkeycar 4.1 to try to duplicate.  Working on that now.

TCIII, 2021-03-15:
@Ezward,

Thank you for your update and progress, much appreciated.
I am using the USB cable that came with the D435i.
Are you using a Nano or an Rpi 4B?
If you are using a Nano, make sure that you are running Jetpack 4.4.3 and do not upgrade to Jetpack 4.5.1.
I have found that DC 4.2.0 (dev) running on v 4.5.1 is experiencing an illegal command core dump that is not recoverable and requires a complete reinstallation of Jetpack 4.5.1. Using DC v 4.1.0 will not cause an illegal command core dump error.

TCIII, 2021-03-26:
@Ezward,

Have you had a chance to see if you can duplicate the steering and throttle latency that I am seeing using DC 4.2.0 (dev) which would indicate that it is a DC software issue and not your "realsense435i.py" part?

TCIII, 2021-04-01:
@Ezward,

Bump?

TCIII, 2021-04-03:
@Ezward,

Zlite recommended that I update librealsense v 2.40 to v 2.44 which I have done.

Realsense Viewer recommended updating the D435i firmware from v 5.12.09 to v 5.12.12 which I did.

All three D435i channels (Stereo Module/RGB Camera/Motion Module/) are functional in the Realsense Viewer.

I really would appreciate it if you could continue to work with me on getting the Nano/D435i DC configuration to work without the latency/hesitation issue.

TCIII, 2021-04-04:
@Ezward,

I finally found a solution to the Nano/D435i DC configuration: You have to use a Xavier NX if you want to run without the startup latency and hesitation I have been experiencing with the Nano.

I started out using the same myconfig.py configuration as the Discord member in Australia, who was also using a Xavier NX/D435i DC configuration, where the Drive Loop frequency and the Camera Frame Rate were the same at 30 Hz.
After starting manage.py drive I found the steering response to my PS gamepad to be smooth and without latency or hesitation. The throttle still had an initial startup latency, however it was about one quarter as long as when running on the Nano.
After the initial throttle startup latency, the throttle responded without hesitation to input from my PS4 gamepad right joystick.

So I shutdown and changed the Camera Frame Rate to 60 Hz, as you have recommended, but kept the Drive Loop frequency at 30Hz, and started manage.py drive again.
This time there was no throttle startup latency and the throttle again responded without hesitation to input from my PS4 gamepad right joystick.

Based on the results of this testing using both the Xavier NX and the Nano, it has become obvious that it is necessary to use a Xavier NX to run with the D435i depth camera without steering or throttle latency or hesitation.

TCIII, 2021-04-18:
Today I ran a Nano 4GB running JP 4.5.1 and DC 4.1 with the D435i depth camera.
Running JP 4.5.1 resulted in the steering and throttle performing normally without latency or hesitation. The TubWriter average time was less than 30ms using a SandDisk 64GB Ultra micro SD card which is a far cry from the 1.5 seconds when running JP 4.4.1.
This empirical testing indicates that some versions of JP (4.4.1) prior to JP 4.5.1 would fall back to a SD card write speed of HS and not UHS at boot up and after a reboot.
Therefore a SD card with a minimum write speed of 10Mbs/sec will more than meet the DC TubWriter speed requirements.

Ezward, 2021-04-19:
@TCIII Thanks for posting this.  That explains a lot.  I had no luck reproducing the issue; my Nano is using a fast SD card (write it 40Mbs/sec) so I would not see the issue.  Booting from a solid state drive then should also work; https://www.jetsonhacks.com/2021/03/10/jetson-nano-boot-from-usb/

TCIII, 2021-04-19:
@Ezward,
It doesn't matter how fast your SD card is, JP 4.4.0/1 will only write at HS (High Speed) and not UHS (Ultra High Speed) speeds.
HS is limited to a maximum of 10Mbs/sec or slower which is not fast enough for the DC Drive_Loop given the amount of data being streamed from the D435i depth camera. The Drive_Loop needed a write speed around 20Mbs/sec (UHS) to not seriously affect the response of the Drive_Loop as I was observing with the steering and throttle latency/hesitation.

Closed 2021-04-18.

Thread 795 (2021-02-27):

Steering and Throttle issue i2c

BossZweifel, 2021-02-27:
Hi there,

I am using a raspberry pi 4 with the waveshare racer kit. My raspberry detects the following i2c addresses

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

As standard, 0x40 is used for steering, and 0x60 for throttle. As you can see, I don't have a 0x60 i2c address detected.

If I put both on 0x40, my web interface shows everything correctly but does not let me control the car. If I change the throttle to any other available address, my steering seems to work but my throttle does nothing.

While calibrating, the servo and motor were fully functional. This leads me to believe there is a problem with the i2c configuration.

Screenshots from config.py

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

Does anybody have a solution for this?
Thanks in advance!

TCIII, 2021-03-03:
@BossZweifel

First off "PCA9685_I2C_BUSNUM =" should be set to "None" for the Rpi.
Second, I doubt that the DC software is setup to work with two PCA9685s (such as ADDR1) at the same address.
You might want to pose your issue [here](https://discord.com/channels/662098530411741184/671604048218292233).

zlite, 2021-03-03:
Yes, I think you can use two devices with the same I2C address as long as they're on different buses, which are determined by which pins you connect them to on the Pi or Nano. (I2C1 and I2C2)

BossZweifel, 2021-03-06:
Updating to donkey v4.x helped in my case. I can now steer and throttle in the web interface. Seems like the old version is bugged.
Thanks for your help

Closed 2021-03-06.

Thread 850 (2021-04-24):

Logitech G27 steering wheel use different axe (0 in stead of 2) for steering -> should be configerable (Gamepad API)

joostaafjes, 2021-04-24:
I am using a Logitech G27 steering wheel and found out that it using axes 0 for steering in stead of 2 as used currently [main.js](https://github.com/autorope/donkeycar/blob/dev/donkeycar/parts/web_controller/templates/static/main.js#L293)

It would be nice to make this axes configurable (preferable in config.py/myconfig.py) but than this value should be propagated to the main.js in some way.

Created this little tool to find the HTML5 gamepad key mapping: https://github.com/joostaafjes/html5-gamepad-tester

sctse999, 2021-05-17:
Interesting. Can you submit a PR? I will look into this.

Ezward, 2021-06-12:
@joostaafjes we do have a joystick mapper.  See `Joystick Wizard` in [docs](https://docs.donkeycar.com/utility/donkey/).  It is a general facility for mapping any game controller that mounts on `/dev/input/js0`.  You create a mapping, then use `CONTROLLER_TYPE="custom"` in you config to use it.

TCIII, 2021-06-12:
@Ezward,

Executing Joystick Wizard on a Nano 4GB running JP 4.5.1 will cause an unrecoverable core dump due to an illegal instruction.

See issue [#807](https://github.com/autorope/donkeycar/issues/807)

Also, Joystick Wizard does not create the same hex keycodes as jstest does on a Nano.

Ezward, 2023-03-04:
I believe @TCIII you have successfully used the Joystick Wizard on the Jetson Nano.  I have also.  So that is a work-around.  Also, we intend to refactor the game controller system in a way that would allow a user to implement support for a new or unique controller simply by mapping the codes that come out of it.  https://github.com/autorope/donkeycar/issues/1097

So I am going to close this issue.

Closed 2023-03-04.

Thread 870 (2021-05-22):

Donkey Sim "Not Responding"

NevGithub0823, 2021-05-22:
Windows 10.
Donkey Sim works fine, but when I click the "Quit" button, it freezes and shows "Not Responding". Please help.

Maximellerbach, 2021-05-24:
Hi ! What version of the sim are you using ?
Just checked v21.04.15 and it works fine.

In order to close the app, you can also close just like a regular app using the top right close button of the window:
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

NevGithub0823, 2021-05-24:
I reinstalled the sim, and now the output says there's a
```
ValueError: Scene name mountain_track not in scene list ['generated_road', 'warehouse', 'sparkfun_avc', 'generated_track', 'roboracingleague_1', 'waveshare', 'mini_monaco', 'warren', 'thunderhill']
```
and
```
RuntimeError: cannot join current thread
```
The Quit button works before the Errors (1-2 seconds after the window opens, the error comes and the Quit button causes Not Responding).

NevGithub0823, 2021-05-24:
I am also using that version of donkey sim.

Maximellerbach, 2021-05-24:
Please chose a scene from that list, mountain_track isn't in this version of the sim, that's why it's throwing you an error. For the "Not responding" part, I will take a look at it

NevGithub0823, 2021-05-24:
> Please chose a scene from that list
I didn't choose mountain_track, it just says I did, idk why

Maximellerbach, 2021-05-27:
It's in your config file, you should find a variable named "GYM_ENV" or something like that, you need to change it to a valid track name

NevGithub0823, 2021-05-28:
please tell me which one?
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

Maximellerbach, 2021-05-28:
There is a list of env name in there, please choose any from it, for example: "donkey-generated-track-v0"
________________________________
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

NevGithub0823, 2021-05-28:
thanks, it fixed that error but the window is still not responding after I press quit.
also, "X" button also makes it do that... the only thing that works for me now is to force quit the app or to just ^C in powershell.

Maximellerbach, 2021-05-28:
Do you disconnect the client before closing the sim ?

Maximellerbach, 2021-05-28:
Try to close the script and then close the sim, not the other way around

Maximellerbach, 2021-06-01:
Please tell me if that worked, if it works, let's close this issue

NevGithub0823, 2021-06-01:
it works

Closed 2021-06-01.

Thread 882 (2021-06-12):

Donkey Car cannot be updated if the controller.py part has been modified (customized).

TCIII, 2021-06-12:
SBC: Nano 4GB
OS: JP 4.5.1
DC: 4.1.0

Issue:
I have had to modify (customize) the PS4 Joystick class hex keycodes in the controller.py part to obtain correct operation of the PS4 gamepad with my Nano 4GB.
When I attempted to update to DC 4.2.1, I received a message that the update was aborted because I had customized the controller.py part.

Immediate Solution:
The workaround was to completely delete the mycar and donkeycar directories and reinstall donkeycar 4.2.1 from scratch then customize the controller.py part PS4 Joystick class as necessary.

Long term Solution:
Would it be possible to allow DC to be updated even with a modified part through a YES or NO request and to continue on with the update instead of aborting it?

DocGarbanzo, 2021-06-12:
Git does not allow to merge (or pull) into your sandbox if you have modified files. If `controller.py` has wrong code, can you create a PR with the fix?

TCIII, 2021-06-12:
@DocGarbanzo,

Thankyou for your response, much appreciated.

Unfortunately Joystick Wizard does not generate the same hex keycodes, that appear in controller.py, for the PS4 as jstest does when using the Nano 4GB and the jstest hex keycodes are the only ones that work for the Nano.
The default hex keycodes for the PS4 in controller.py probably work for the Rpi, but definitely not for the Nano 4GB has been my experience. Therefore I have to create a modified (custom) PS4 Joystick class in controller.py so there is no fix short of creating a controller.py part specifically for the Nano.
Also, executing Joystick Wizard (donkeycar createjs) on a Nano 4GB running JP 4.5.1 will cause an unrecoverable core dump due to an illegal command (see issue [#807](https://github.com/autorope/donkeycar/issues/807)) so that a custom Joystick class cannot be created.

DocGarbanzo, 2021-06-16:
@TCIII - could you add a flag in the joystick controller classes constructor that can switch between nano and RPi and then add a different hex code mapping for corresponding platform? And submit that as a PR?

TCIII, 2021-06-17:
@DocGarbanzo,

Unfortunately I am not an experienced Python programmer.

My suggestion to handle this hex keycode issue with the Nano is a follows:
1) Add warning: Do not attempt to use the Joystick Wizard to create a "custom" joystick as running "donkey createjs" on the Nano will cause an unrecoverable core dump (see issue [#807](https://github.com/autorope/donkeycar/issues/807)).
2) Instead, install and run jstest to determine the correct gamepad hex keycodes for the Nano.
3) Use nano to edit and modify the desired gamepad hex keycodes in the "controller.py" part.
4) Verify that the gamepad in use will control the vehicle steering, throttle, etc. as expected.

DocGarbanzo, 2021-06-17:
@TCIII
I suggest the following:
1. We'll add this to the docs
2. Please upload your nano version of the file & I will code the change & submit a PR
3. Obsolete after 2
4. Obsolete after 2

If you could test the change when available on dev - that would be great.

TCIII, 2021-06-18:
@DocGarbanzo,

Per your request I am attaching my "controller.py" part that has the PS4Joystick class modified to work with the NVIDIA Nano and Xavier NX. The hex keycodes are based on those generated by jstest. The PS4Joystick class works for both the PS4 and the PS5.
[controller.zip](https://github.com/autorope/donkeycar/files/6678113/controller.zip)

Ezward, 2023-02-18:
@TCIII I believe we resolved this issue by using the Joystick Wizard to create a custom mapping for you.  Is that correct?  In any case I would like to close this issue as won't do; modifying something other than the files in the mycar folder must be done in a fork or branch.  So that fact that you could not update is as designed; it is a source control issue.

Ezward, 2023-02-18:
This is an issue of source control.

Closed 2023-02-18.

Thread 910 (2021-08-01):

Integrate 2D Lidar data into Donkeycar

Ezward, 2021-08-01:
This is a discussion issue.  The topic is how to integrate 2D lidar data, as from an RPLidar or YDLidar, into the DonkeyCar framework.  It is likely that this will result in a number of following-on issues to actually implement the design that we decide upon.   I'll start the discussion by adding a strawman as the first comment in this ticket.

Ezward, 2021-08-01:
# Integrating 2D Lidar data into Donkeycar

## The 2D Lidar data

A spinning lidar captures data in 360 degree arc around it.  It provides each data point as a distance from the lidar and the angle at which that reading was taken.  It has some maximum working range.  That range can be thought of as the radius of a circle where the lidar is at the center of that circle.  Beyond that range we may actually get some readings, but we treat those a noise.

The lidar's 'zero' angle is relative to itself and so is all the data that it provides to us (it's super narcissistic).  But we care about where the points are relative to the vehicle that the lidar is mounted on.  If we treat directly forward as 'zero' angle for the vehicle, then we need to know the offset of the zero angle on the lidar relative to the forward direction of the vehicle.  We can then adjust the angle component of each data point provided by the lidar to turn it into an angle relative to the vehicle.  It may well be that the way the lidar is mounted that the zero angle of the lidar exactly coincides with forward on the vehicle, but we should include this offset (which in that case would be zero) anyway so we have a more general model that can be applied to other lidars that may not have their zero in the same place.

## Plotting the 2D Lidar data
So once we turn the lidar data into a distance and angle relative to the vehicle, then we can use trigonometry to calculate (x,y) coordinates relative to the vehicle; the vehicle is defined as being at (0,0).

## A complication

Another thing to think about is the skew inherent in the data taken from a moving vehicle.  Remember that the each data point provided by the lidar is given as a distance from the lidar and the angle at which the lidar was pointing when it took the reading.  But if the lidar is on a moving vehicle, then the position from which each point is taken is changing.  The lidar has some rate at which it can make a full 360 degree sweep.  This is typically 5 to 10 hz.  If the vehicle is stopped, then all data points are from a circle with the same center.  However, as the vehicle moves, each point is taken from a different location.  If the vehicle is moving 1 meter per second, which is pretty slow for a race car, and the lidar is spinning at 5hz, then the lidar has moved 1/5 of a meter between taking the first point in a sweep and the last point.  There is additional skew that happens if the vehicle is turning.

## A solution

If we know the vehicle's position and orientation as it moves, then we can simply adjust each point provide by the lidar using the vehicle's position and orientation at the time that point was taken.

If we have good odometry, then we can apply a kinematic model that estimates the vehicles position and orientation as it moves. Such estimates are good over short distances and we only need them to be good over a meter or so.  If we have wheel encoders or an encoder on the drive motor, then we can use those.  If we have an IMU, then we can also use that for the same purpose.  Having both would be ideal.

But what if we don't have good odometry?  That is typical of a Donkeycar.  We know the throttle value and steering value, but we don't actually know the speed of the car.  However, with a little calibration we can roughly estimate the speed of the vehicle from the throttle value.  The calibration would involve taking some measurements over a known distance at different constant throttle values and measuring the time to traverse the distance.  Then we can do interpolation to estimate the speed.  That would provide a very rough estimate.  It is affected by the particular surface the vehicle is on and by the battery charge level.  If the vehicle is changing speeds, then this model also does not take into account the lag in acceleration and deceleration.  However, it is better than not doing any adjustment of the data.

We also need to calibrate the steering angle as well; measure the radius of a full right and full left turn; then we can interpolate to estimate turn angle given a steering value.

With those two things in place, we can then use the speed and steering angle as input to a kinematic model to estimate the vehicle's relative position and orientation over time.

## A Donkeycar 2D Lidar pipeline
Acquiring the data from the 2D lidar and transforming it into data useful to the CNN involves integrating a number of new parts into the vehicle pipeline.  2D Lidar pipeline involves 4 parts that work to gather data from the 2D Lidar, adjust for the changing position of the vehicle and render it to a bitmap so it can be saved to the tub.

1. Encoder Part:
If we have a motor encoder, then this part reads the motor encoder and writes the value and the time in nanoseconds at which the data was read.  Donkeycar does have an [encoder.py](https://github.com/autorope/donkeycar/blob/dev/donkeycar/parts/encoder.py) part that assumes that we have an arduino or similar microcontroller to read the encoder.  That part defines how encoder data is written to the pipeline.  We should try to use that if we can.

2. Kinematics Part:
This part takes as input the encoder reading (if we have an encoder), the throttle value and the steering value.  It uses the encoder reading if available or throttle otherwise, and the steering value along with other relevant configuration and calibration values and maintains an estimate of the vehicle's position and orientation.  It outputs the position and orientation to the data pipeline along with a high resolution timestamp (taken from the encoder value if available).  Donkeycar does not currently have this part, but it would be a great part to add; we could use it beyond the 2D Lidar pipeline for things like navigating around an obstacle.

3. 2D Lidar Part:
This part takes as input the kinematic data (position and orientation of the vehicle). This part also reads data from the 2D lidar.  It maintains a queue of all the points in the last 360 degrees of data; both the raw data received by the lidar and an adjusted value for the distance and angle from the vehicle that takes into account the kinematic data.  Each point should also be marked with a time in nanoseconds at which it was read.  The size of the data queue depends upon the resolution of the lidar (which should be configurable).  The part outputs the queue into the vehicle's data pipeline so it can be processed by other parts and possibly saved to the tub.

4. Lidar Imaging Part:
This part uses the 2D lidar queue, a lidar data bounding box, an input image and an image bounding box and renders the 2D lidar data as pixels on the image.  This image is output to the pipeline so later it can be saved to the tub.  I'm suggesting keeping the part that reads the lidar data separate from this image generation part so that a) we can implement different 2D lidar parts for different brands of Lidar without having to include the image code with them b) we can use the 2D lidar data in other ways (like obstacle detection) without outputing an image.
- The bounding box of lidar readings to be included in the image are configured in myconfig.py.  The bounding box units would be in meters.  So if our 2d lidar had a maximum range of 8 meters and we wanted all the data around the vehicle to be plotted, we would configure a bounding box (left, top, right, bottom) of (-8, 8, 8, -8) using cartesian coordinates and assuming the lidar as at (0,0).  By specifying a bounding box of (-8, 8, 8, 0) we could ignore all the points behind the vehicle.  Further, we could constrain the distance even more to eliminate data that is not important (that is too far away from the vehicle); for instance if we only cared about things up to 4 meters in front of the vehicle and 2 meters on each side we would specify this bounding box; (-2, 4, 2, 0)
- The image bouds are configured in myconfig.  This represents that area on the input image where the lidar data would be drawn.

We also want a part that will convert the normal RGB camera images into a bird's eye view image using a camera calibration matrix.  This bird's eye view would then be the input image for the Lidar Imaging Part and the resulting combined image would be input to the CNN.  See a more detailed discussion below.

## A Neural Network using 2D Lidar data
It may be that there are other neural network archictures that would use the 2D lidar data directly, but Donkeycar is built around a CNN that takes images in and outputs steering and throttle.  So if we stick with that, then we want to use the 2D lidar as an image and use this image as an input into the CNN.  I can think of two ways to do that.  One is pretty simple and one is more complex, but likely better.

One way to use the Lidar data is to concatenate the 2D lidar image with the camera image we already have.  So if we are capturing a 160x120 camera image, we would want our 2DLidar image to be the same width (120 pixels), then we would use OpenCV to 'stack' the two images and make them into a single image.  That single image would then be the input to our CNN.  Note that we would need to change the code that calculates the CNN to use the dimensions of this new image, not the dimensions of the camera image.  Further, when we drive on autopilot, we need to do this concatnation step and use the concatenated image to infer the steering and throttle.

I think a model build on that might be ok, but it's hard to know without testing it.  It definitely would slow things down a because the image would be larger.  Also, if you think about this, it's not super intuitive that this would work well. The two images are in two different 'spaces'; it would not be obvious to a person how these correllate and it might not be obvious to a CNN either.

Another way, which I think would be better, would be to overlay the 2D lidar image onto the camera image in a way where the lidar pixels are correctly placed in the image.  Each lidar data point represents a point is space around the vehicle where something exists, because it reflected that light.  We should be able to place the 2D lidar pixel onto the pixel in the camera image that represents the spot in 3D space that reflected that light.

I think there are two possible ways to do this; the first attempts to take the Lidar data and project it into the 3D space that the camera image represents.  The second method instead projects the camera image into a bird's eye view and then overlays the 2D lidar data on it.  These two alternatives are discussed in more detail.

Option A: we could project the Lidar data points onto the camera image, applying a 3D transform that positions the pixels correctly in the image.  To do this we must calibrate the camera and use that calibration to understand how to project the points in the 2D lidar data into the camera's world view.  Remember that each Lidar point represents a point in the 3D world space around the vehicle.  In this option, we take that 3D point and calculate the corresponding pixel in the camera image and draw it there.  This is kinda cool, but I don't think it is the best way to do this because of perspective; as a points get farther away, they are likely to occupy the same pixel as a nearby point because of perspective.  That means we start to lose data.

Option B: To avoid the perspective data loss issues, we could use the camera calibration values to reformat the camera image so it appears as a bird's eye view; like we are looking at it from above.  We essentially reformat the image so it looks like it was taken from directly above the Donkeycar.  Then it is basically trivial to overlay the 2D lidar data, because it already is like a bird's eye view.  We merge the pixels from the 2D Lidar image into the bird's eye camera view.  Even better, we can generate this bird's eye camera view before we render the 2D lidar image and rather then render a 2D lidar image to it's own bitmap, we draw the pixels directly on the bird's eye camera image.  That would be faster because we can avoid merging two bitmaps.

I think this bird's eye image would make the 2D lidar data much more powerful in predicting steering angle and throttle (assuming we slow down for obstacles).  This approach would require another part; a part that takes the camera calibration data and the camera image and generates a bird's eye camera image.  We would also make the Lidar Image Part accept an input image and rather than image dimensions, it would get a second bounding box that represents the area on the input image (the bird's eye camera image) where the 2D lidar data should be drawn.

I'm getting pretty excited about this second approach.  It has other benefits;
- We can use that bird's eye view and lidar data to do a good job of obstacle detection.  Since the bird's eye view will remove camera distortion, we can use it to calculate paths we want to drive in the world.
- In an indoor setting with walls (think a school), the 2D lidar alone could probably be used to calculate a decent network.  That would be a cool demo; create a network that drives around the perimeter of a room or the outside of a bulding by following a wall.  You could use it to solve a maze using wall following.

This approach does require another calibration step; calibrating the camera.  This is a well know process and there exist plenty of code samples in Python to generate the necessary calibration data.  Further, there is plenty of Python code out there to apply this calibration data to turn a camera image into a bird's eye view; this is a common process in many robotics projects.

Heavy02011, 2021-08-01:
Great preparation, Ed!

After digging a bit into lidars during the iros2020 race and currently trying to find the bug when trying to save sim lidar data into tubs (SIM_RECORD_LIDAR = True) I would like to add the following feature requests and offer to help:

1. Make the use of the lidar identical for the physical & sim world by establishing an identical pipeline / data format for lidar (I have a RP A2M8 at hand to test real & sim training)
2. ability to set position of cameraA, cameraB and lidar independent from each other. I would like the camera position a bit more up to avoid cropping images, like the camera position of the Old Guy Bots. Currently offset_x,y,z allow only one position, because they are collapsed into one position in TcpCarHandlers.cs in sdsim, as far as I experienced when trying to set them differently.
3. I hacked together a very crude part for detecting lanes and undistorting images to a top down view some time ago, much refactoring  needed before using. https://gist.github.com/Heavy02011/07320c09c1870ef1e3a00878801fdfc9

Maybe we can have a look to the Autoware.auto pipeline, https://www.apex.ai/autoware-course, see Lecture 7 | Object Perception: LIDAR, as well.

TCIII, 2021-08-01:
@Ezward,
Thanks for initiating the discussion ticket, much appreciated.

I presently have three Slamtec RPLidars available to support this effort: A1M8-R5, A1M8-R6 (latest firmware) and a A2M8 (latest firmware). I have one running on a Rpi 4B, one running on a Nano 4GB,  and the A2M8 running on a Xavier NX.
The lidar.py part (DC dev branch) works well sending distance data to the TubWriter based on a lowest to highest angel value data stream and is limited to a 90 - 180 degree forward field of view. Please note that the A1 versions start the 0 degree point at the motor end of the Lidar chassis and scans clockwise towards the turret end. The A2 starts the scan at the cable end of the mount and scans clockwise.
We might want to look at Dirk Prange's "Example" of sensor integration in the "Create your own Model" [guide](https://docs.donkeycar.com/dev_guide/model/) as a start?

TCIII, 2021-08-01:
@Ezward,

I really like option B as it would allow me to operate my robot chassis without the need for lanes, as in a traditional DC environment, and allow for autonomous movement around a outside or inside perimeter.

TCIII, 2021-08-01:
@Ezward,
Leave this open to useful links:

Paper on Lidar/camera [fusion](https://arxiv.org/ftp/arxiv/papers/1710/1710.06230.pdf)

Heavy02011, 2021-08-02:
fyi: Maxime did an update on gym-donkeycar for solving this: “ ability to set position of cameraA, cameraB and lidar independent from each other.” I will test this today.

Ezward, 2021-08-02:
@Heavy02011 thanks for those links.  I see in the gist that you are using the trapezoidal method for warping the image perspective; I think we should allow for that method as it is pretty easy to configure.  We can also allow the use of camera calibration matrix if the user has calibrated their camera as that also eliminates other distortions (like those from a wide angle lens).

TCIII, 2021-08-02:
> @Heavy02011 thanks for those links. I see in the gist that you are using the trapezoidal method for warping the image perspective; I think we should allow for that method as it is pretty easy to configure. We can also allow the use of camera calibration matrix if the user has calibrated their camera as that also eliminates other distortions (like those from a wide angle lens).

@Ezward,

How will this affect depth cameras like the Intel D435i depth camera as I would like to use the Slamtec A2M8 with that depth camera?
Also, how is the data from your realsense435i.py part integrated into the DC training pipeline?

Ezward, 2021-08-04:
In terms of the data format that is generated by the 2D Lidar part, I think it makes sense to save the all the data on each frame, even though we may only be getting some of it on each frame.  What I mean here is that because the lidar will stream in data in segments are it collects it, we will constantly be reading some subset of the 360 degrees.  However, we want to maintain a full array data with each frame we save to the tub.

So that means we want  to stream data in and update any prior data as the new data comes in.  The donkey pipeline is running 20hz or more and the lidar is only running somewhere between 4hz to 10hz. We don't want to wait for a whole 360 degrees of data before updating the data.  I think most 2D lidars will stream data and tell you the angle range that it represents, which will be some subset of the 360 degrees arc.

The ROS message for 2D lidar is here: http://docs.ros.org/en/noetic/api/sensor_msgs/html/msg/LaserScan.html .  The nice thing about this format is that it can hold some subset of the 360 degree arc or it can be used to hold all 360 degrees.

I can also see that we may want to tell the part that we only care about data from 0 to 180 degrees, for instance, so we are not writing more data that we will actually use.  Again, we can still update this range as it streams in.  We would just ignore data from 180 to 360 degrees in that case.

Ezward, 2021-08-04:
> How will this affect depth cameras like the Intel D435i depth camera as I would like to use the Slamtec A2M8 with that depth camera?
> Also, how is the data from your realsense435i.py part integrated into the DC training pipeline?

I would hope camera and lidar would be totally orthogonal; they should not interfere with each other.  Of course if you have both of these, you may have a bunch of redundant data and so are writing more data then you need, but it should work.  Short of some underlying driver incompatibilities anyway.

I'm going to try the 2d lidar without the D435; with just a normal RPi 160 degree camera.  But I don't see any reason why the D435 and RPLidar would interfere; unless we define RPLidar part as a camera; since we only configure one camera at a time, so the 2D Lidar part should not be defined as a camera.

Rather I think we should have a new kind of part for 2d planar lidar, then we can implement config and code for the various vendors.  So for cameras we have `CAMERA_TYPE`; maybe we can add a config for `2D_LIDAR_TYPE`.  Here I would create values for families of 2D lidars that share a basic driver api and underlying data format.  For instance, if all of your RPLidar models speak to the same driver and produce the same data format but the data may differ by :
* how dense the readings are,
* how fast the  lidar may spin,
* the max and min distance range is
If those are the only difference, then we can treat those as one lidar type, like  `2D_LIDAR_TYPE = RPLIDAR_2D`.  For YD lidar models, we would have `2D_LIDAR_TYPE = YDLIDAR`.  I have an Hitachi-LG LDS-LFDS2, so config would be `2D_LIDAR_TYPE = LDS`.

We would  have additional configuration common to all 2d lidars.  `2D_LIDAR_MIN_DISTANCE`, `2D_LIDAR_MAX_DISTANCE` in meters; which would be important for filtering out data.  We probably also need configuration for angle range we want to capture; `2D_LIDAR_MIN_ANGLE`, `2D_LIDAR_MAX_ANGLE` in radians; again go we can filter out data we don't care about.

I'm not sure how to handle configuring the number of samples we can expect in that desired range; that is determined by how fast the Lidar is spinning and the number of readings per rotation.  I believe readings per rotation are generally fixed, but the motor speed is commonly adjustable via PWM.  So perhaps we have config for `2D_LIDAR_PPR` (pulses per rotation), which will depend upon your specific lidar.  If we put that in configuration, the we can allow the driver to determine the best spinning rate and then calculate the number of readings it needs to save based on pulses per rotation and the spin rate it chooses.

TCIII, 2021-08-04:
@Ezward,

Yes, I was going to recommend that you look at zlite's lidar.py part to see how the data capture range is limited and how many Lidars are presently supported.
The Slamtec A1M8 configuration sets the 0 degree point at the motor end of the Lidar and proceeds in a clockwise sweep towards the turret end and then back to the motor starting point. The A2M8 configuration on the other hand has a brushless motor in the base and sets the ) degree point at where the cable exits the base and sweep clockwise around the base.
This [link](https://guitar.ucsd.edu/maeece148/index.php/2019SpringTeam1) may help visualize how the A1M8 scans.

Ezward, 2021-08-07:
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

I think we can detect the zero point on any 2D lidar; we simply look at that last reading we saved; if the current reading's angle is less than the previous reading's angle, then we have crossed the zero point.  We can double-buffer scan; when we cross zero we start a new buffer and move the last buffer (which should be a full 360) to a 'last-buffer' status.  Further, I think we can merge these two buffers in a way that gets us a single 360 degree scan, which may include points from the latest scan and points from the previous scan, but no redundant angles.  So I don't think we actually need the zero point provided by the RPLidar, but we do need to know where the lidar considers zero degrees relative to 'forward' so we can adjust the output of all lidars so they have zero as forward.

TCIII, 2021-08-07:
@Ezward,

Even though there is a YDLidar class in the lidar.py part, zlite told me that it was not presently functional.
The Slametc A1 and YD X4 Lidars are probably the only two reasonably priced Lidars around with both the A2M8 and YD G4 touching over $300 plus tax on Amazon.

TCIII, 2021-08-08:
@Ezward,

Lidar and Camera data fusion GitHub links:

[Lidar and Camera Fusion for 3D Object Detection based on Deep Learning for Autonomous Driving](https://github.com/ZiningWang/Sparse_Pooling/blob/master/avod/BDD_Lidar-camera%20Fusion.md)

[CLOCs: Camera-LiDAR Object Candidates Fusion for 3D Object Detection](https://github.com/pangsu0613/CLOCs)

[SFND 3D Object Tracking](https://github.com/yasenh/lidar-camera-fusion-ttc)

[Sensor Fusion NanoDegree- Camera Course](https://github.com/udacity/SFND_Camera) Looks to be the best

[lidar-camera-fusion](https://github.com/topics/lidar-camera-fusion) Lidar/Camera calibration

Ezward, 2021-08-10:
Here are a couple of libaries that can manipulate point clouds and do a few other things (like scene segmentation)
- https://pointclouds.org/
- http://www.open3d.org/

Ezward, 2022-10-03:
Discussion of Lidar odometry and deskewing lidar data (skewing that happens when scan data is acquired on a moving platform).  https://youtu.be/9FhKgAEQTOg  Here is the github for the KISS ICP library https://github.com/PRBonn/kiss-icp  This includes Python bindings.

Thread 912 (2021-08-04):

Cannot start 2D lidar if using a RealSense D435 camera

Ezward, 2021-08-04:
If you try to configure `CAMERA_TYPE="D435"` and `LIDAR_TYPE="RP"` simultaneously, the D435 part will NOT be correctly started when manage.py is run, but the RPLidar will not.  RPLidar works fine if camera is `MOCK`.

The problem is a bug in `manage.py` (created from `donkeycar/templates/complete.py`).  The code that configures that camera for some reason includes the lidar config.  So on line 90 of https://github.com/autorope/donkeycar/blob/dev/donkeycar/templates/complete.py we start configuration of the camera with the 'stereo' camera, then on line 113 we 'elif' camera is "D435", then on line 136 we 'else' the other cameras.  That 'else' block also contains the lidar configuration.  So if we configure the D435 then the else is never executed and so the lidar part is not configured.

Solution: move the code block starting on line 166, https://github.com/autorope/donkeycar/blob/5e2c5608fb6b1158300266613d10807369085e56/donkeycar/templates/complete.py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, to outside and after the else, so it gets executed no matter what kind of camera is being configured.

TCIII, 2021-08-04:
@Ezward,

This solution only works if you have not created mycar.

I believe that we can modify manage.py in the mycar directory to correct this issue?

TCIII, 2021-08-04:
@Ezward,

Okay, as a quick fix I moved the # add lidar code to after "V.add(cam, inputs=inputs, outputs=outputs, threaded=threaded)" and on the same indent as the "else" in manage.py and here is the result:

(env) thomas@thomas-desktop:~/mycar$ python manage.py drive
________             ______                   _________
___  __ \_______________  /___________  __    __  ____/_____ ________
__  / / /  __ \_  __ \_  //_/  _ \_  / / /    _  /    _  __ `/_  ___/
_  /_/ // /_/ /  / / /  ,<  /  __/  /_/ /     / /___  / /_/ /_  /
/_____/ \____//_/ /_//_/|_| \___/_\__, /      \____/  \__,_/ /_/
                                 /____/

using donkey v4.3.0 ...
loading config file: /home/thomas/mycar/config.py
loading personal config over-rides from myconfig.py
INFO:__main__:PID: 10323
cfg.CAMERA_TYPE D435
INFO:__main__:cfg.CAMERA_TYPE D435
Depth Scale is:  0.0010000000474974513
INFO:donkeycar.vehicle:Adding part RealSense435i.
adding RP lidar part
INFO:donkeycar.vehicle:Adding part RPLidar.
Starting Donkey Server...... you can now go to thomas-desktop.local:8887 to drive your car.
INFO:donkeycar.vehicle:Adding part LocalWebController.
INFO:donkeycar.vehicle:Adding part PS4JoystickController.
INFO:donkeycar.vehicle:Adding part ThrottleFilter.
INFO:donkeycar.vehicle:Adding part PilotCondition.
INFO:donkeycar.vehicle:Adding part RecordTracker.
INFO:donkeycar.vehicle:Adding part DriveMode.
INFO:donkeycar.vehicle:Adding part AiLaunch.
INFO:donkeycar.vehicle:Adding part AiRunCondition.
PWM Steering created
Init ESC
PWM Throttle created
INFO:donkeycar.vehicle:Adding part PWMSteering.
INFO:donkeycar.vehicle:Adding part PWMThrottle.
INFO:donkeycar.vehicle:Adding part TubWriter.
You can now move your joystick to drive your car.
Joystick Controls:
+------------------+--------------------------+
|     control      |          action          |
+------------------+--------------------------+
|      share       |       toggle_mode        |
|      circle      | show_record_count_status |
|     triangle     |   erase_last_N_records   |
|      cross       |      emergency_stop      |
|        L1        |  increase_max_throttle   |
|        R1        |  decrease_max_throttle   |
|     options      | toggle_constant_throttle |
|        R2        |     enable_ai_launch     |
| left_stick_horz  |       set_steering       |
| right_stick_vert |       set_throttle       |
+------------------+--------------------------+
Opening /dev/input/js0...
Device name: Wireless Controller
INFO:donkeycar.vehicle:Starting vehicle at 30 Hz
recorded 10 records
recorded 20 records
recorded 30 records
recorded 40 records
recorded 50 records
recorded 60 records
recorded 70 records
^CINFO:donkeycar.vehicle:Shutting down vehicle and its parts...
INFO:donkeycar.vehicle:Part Profile Summary: (times in ms)
INFO:donkeycar.vehicle:
+-----------------------+-------+------+-------+-------+-------+-------+-------+
|          part         |  max  | min  |  avg  |  50%  |  90%  |  99%  | 99.9% |
+-----------------------+-------+------+-------+-------+-------+-------+-------+
|     RealSense435i     |  1.40 | 0.14 |  0.24 |  0.21 |  0.33 |  0.55 |  1.24 |
|        RPLidar        | 14.69 | 0.02 |  0.70 |  0.59 |  0.84 |  3.47 | 11.32 |
|   LocalWebController  |  0.17 | 0.03 |  0.04 |  0.03 |  0.04 |  0.09 |  0.16 |
| PS4JoystickController |  0.91 | 0.03 |  0.10 |  0.09 |  0.15 |  0.44 |  0.90 |
|     ThrottleFilter    |  0.14 | 0.01 |  0.02 |  0.02 |  0.02 |  0.07 |  0.13 |
|     PilotCondition    |  0.23 | 0.01 |  0.01 |  0.01 |  0.01 |  0.04 |  0.15 |
|     RecordTracker     |  8.85 | 0.01 |  0.05 |  0.01 |  0.02 |  0.58 |  5.48 |
|       DriveMode       |  0.16 | 0.01 |  0.02 |  0.02 |  0.02 |  0.06 |  0.11 |
|        AiLaunch       |  0.29 | 0.01 |  0.02 |  0.02 |  0.02 |  0.05 |  0.18 |
|     AiRunCondition    |  0.09 | 0.01 |  0.01 |  0.01 |  0.01 |  0.05 |  0.08 |
|      PWMSteering      |  0.21 | 0.03 |  0.04 |  0.03 |  0.04 |  0.10 |  0.20 |
|      PWMThrottle      |  0.09 | 0.01 |  0.02 |  0.02 |  0.02 |  0.06 |  0.08 |
|       TubWriter       | 51.98 | 8.87 | 21.88 | 20.09 | 32.10 | 40.39 | 50.82 |
+-----------------------+-------+------+-------+-------+-------+-------+-------+
(env) thomas@thomas-desktop:~/mycar$ ^C

As you can see the TubWriter is taking an average of 21.88ms to write both the D435i andthe RPLidar which is probably way too long. My loop is running at 30Hz and not 20Hz so maybe going back to 20Hz might help somewhat.
Also I am using a Xavier NX SBC with a U3 speed 128GB micro SD card.
As a comparison, with just the D435i camera enabled, the average write time is 7.24ms and with just the RPLidar enabled, the average write time is 4.11ms.

DocGarbanzo, 2021-08-04:
@TCIII - can you check what the tubwriter performance is if you do not write the lidar data into the tub, while keeping everything else the same? I would be surprised if the additional data had any impact on the writing speed.

TCIII, 2021-08-04:
@DocGarbanzo,

The TubWriter is taking an average of 21.88ms to write both the D435i andthe RPLidar which may be too long. My loop is running at 30Hz and not 20Hz so maybe going back to 20Hz might help somewhat.
Also I am using a Xavier NX SBC with a U3 speed 128GB micro SD card.

As a comparison, with just the D435i camera enabled, the average write time is 7.24ms and with just the RPLidar enabled, the average write time is 4.11ms.

Ezward, 2021-08-04:
@TCIII I'm hoping you can do a pull request that I can code review and merge via github.  This will get you into the flow of contributing.  The process is;

- Fork the github repo.  You can do this from the github page https://github.com/autorope/donkeycar .  In the upper right there is a 'Fork' section; click on that and it will create a version of the repo in _your_ github account.
- Clone your forked version using from _your_ github account to your computer (using the `Code` button on the repo page).
- checkout the dev branch, `git checkout dev`
- make sure you have the latest `git pull dev`
- make your changes to `donkeycar/template/complete.py`; that is the file that becomes manage.py when you do the `donkey createcar` command.
- test it (create a new car and make sure it works as you want)
- commit and push your changes to your branch.
- go to the main donkeycar github repo and create a "New Pull Request" using the button (or you might see that there is a message showing your changes in your fork and offering to create a pull request, you can use that shortcut if it is offered).
- do the pull request from your branch in your fork to the dev branch in the autorope/donekeycar repo.
- then let me know and I will code review the pull request.

Here is a video that describes the process; https://www.youtube.com/watch?v=a_FLqX3vGR4

If you run into any issues, let me know.

TCIII, 2021-08-04:
@Ezward,

I edited the complete.py template from my branch as required with GitHub Desktop, but I cannot figure out how to get it back to my branch so I can test it.

TCIII, 2021-08-04:
@Ezward,

Okay, I deleted my present donkeycar and mycar directories and download donkeycar from my fork.
Donkeycar installed without issue.
I then created mycar and edited myconfig.py as required.
I then ran manage.py drive successfully without receiving any errors.
Both the D435i and the RPLidar parts ran without issue.

Time for a pull request.

DocGarbanzo, 2021-08-05:
Fixed in #913 - which is now merged.

Closed 2021-08-05.

Thread 914 (2021-08-06):

Empirical testing suggests that the lidar.py part range data output may not be accurate

TCIII, 2021-08-06:
SBC: NVIDIA Xavier NX
OS: JP 4.5.1
DC: v 4.3 (dev)

The following hardware was used for the empirical testing:
Rpi 4B/RPLidar A1M8_R6 (firmware 1.29)/Sainsmart OM5647 camera
Nano 4GB/RPLidar A1M8-R5 (firmware 1.25)/Sainsmart IMX219 camera
Xavier NX/RPLidar A2M8v(firmware 1.28)/D435i depth camera

The center of the RPLidar scanner was placed 46.5 inches (118 cm) from a mocha colored wall and using DC v 4.3, around 60 records were recorded for each of the three scanners.

The A1M8_R5, which is running the oldest Slamtec firmware, was probably the most accurate with several recorded distances of over 115 cm and a consistent starting range between 79 - 83 cm and consistent ending range between 118 - 121cm. Also the recorded ranges were reasonably consistent from index number to index number. The R5 recorded ~161 ranges.
The A1M8_R6 and the A2M8 were the least accurate without a single value at or over 100 cm though the range accuracy from index value to index value was reasonable. The R6 recorded ~113 ranges.
The A2M8 produced the least amount of range data. There were ~23 ranges recorded.

[catalog_0_A1_R5_465_1.catalog.txt.zip](https://github.com/autorope/donkeycar/files/6945471/catalog_0_A1_R5_465_1.catalog.txt.zip)
[catalog_0_A1_R6_465_1.catalog.txt.zip](https://github.com/autorope/donkeycar/files/6945474/catalog_0_A1_R6_465_1.catalog.txt.zip)
[catalog_0_A2_465_2.catalog.txt.zip](https://github.com/autorope/donkeycar/files/6945475/catalog_0_A2_465_2.catalog.txt.zip)
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

TCIII, 2021-08-06:
Conclusions:
The Adafruit RPLidar library works well with the latest version of the Slamtec RPLidar firmware (1.29) and the older firmware version (1.25).
I would  question the accuracy of the range sorting process in Chris' lidar.py part, which is a composite of several different lidar software sources, when used with the different Slamtec RPLidar versions.
The reason I say this is I have done the following:
Set up a target that is 46.5 inches (118cm) from the A2M8 RPLidar and is ~12 inches wide. The A2M8 RPLidar is pointed directly head-on at the target.
Used a range display python program to view the range data produced by the A2M8.
The range data starts at 0 mm since the zero degree point starts at the cable end of the scanner chassis (the back of the scanner) which faces the front end of the car and is a distance of less than 150 mm which the scanner firmware ignores.
The scanner then moves though a 360 degree scan back to 0 mm range at the zero degree point at the back of the scanner.
During the scanner sweep  at least  seven or more ranges of around 1,180mm (1195.25, 1194.5, 1191.75, 1188.75, 1186.25, 1183.75, 1182.5) or 118cm appeared in the data which indicates that the scanner ranged on the target setup at 118cm from the scanner center point.
The range data in the A2M8_Range_Data is not all inclusive of a 360 degree sweep.
[A2M8_Range_Data.zip](https://github.com/autorope/donkeycar/files/6945486/A2M8_Range_Data.zip)

TCIII, 2021-08-06:
I then proceeded to go through the same exercise with a RPLidar A1M8-R6 (firmware 1.29).
This time I copied what I believe to be a full scan's worth of range data.
Once again the A1M8, like the A2M8 recorded the following ~1180mm (118cm) range to the target at the 180 deg point of the scan within the total data array: 1202.5,
1200.5, 1200.75, 1198.75, 1198.75, 1197.75, 1195.5, 1195.0, 1195.5, 1197.75, 1199.75]
[1200.0, 1205.5, 1210.0, 1210.5

[A1M8_R6_Range_Data.zip](https://github.com/autorope/donkeycar/files/6945536/A1M8_R6_Range_Data.zip)

TCIII, 2021-08-06:
The above empirical testing definitely validates the Adafruit RPLidar library functionality and the fact that both the A1M8 and the A2M8 Slamtec RPLidars function as intended by the Manufacturer.
It is also further proof that there are definite issues with the way Chris' lidar.py part processes the range data from the different versions of the Slamtec RPLidars.

Ezward, 2021-08-10:
See my RPLidar experiments at https://github.com/Ezward/rplidar

I did some work to see if we could stream in measurements rather that wait for an entire 360 degree scan.  See `stream_lidar.py` for an example that streams measurements as they are aquired.  This will do filtering, but it does not sort.

I used this to look at the performance characteristics of the RPLidar A1M8-R6 using scan defaults.

Here is an example where I streamed 10 full scans, then I used grep to count the number of points in each scan.  Scan 0 usually has about 250 or more points.  Subsequent scans have 267 or 268 measurements.  This is using the default scan settings and including zero readings.

```
$ python stream_lidar.py -n 10 -d 0 >stream.log
$ cat stream.log | grep scan | wc -l
$ cat stream.log | grep '"scan": 0,' | wc -l
255
$ cat stream.log | grep '"scan": 1,' | wc -l
268
$ cat stream.log | grep '"scan": 2,' | wc -l
268
$ cat stream.log | grep '"scan": 3,' | wc -l
267
$ cat stream.log | grep '"scan": 4,' | wc -l
268
$ cat stream.log | grep '"scan": 5,' | wc -l
267
$ cat stream.log | grep '"scan": 6,' | wc -l
268
$ cat stream.log | grep '"scan": 7,' | wc -l
267
$ cat stream.log | grep '"scan": 8,' | wc -l
268
$ cat stream.log | grep '"scan": 9,' | wc -l
267
$ cat stream.log | grep '"scan": 10,' | wc -l
267
```

I added time to each measurement as they came in.  Here are the first and last points in scan 1:

```
(venv) pi@raspberrypi:~/projects/rplidar $ head -n 8 stream.1.log
{
  "scan": 1,
  "time": 1628576979.515709,
  "distance": 0.0,
  "angle": 359.21875,
  "x": 0.0,
  "y": -0.0
}
(venv) pi@raspberrypi:~/projects/rplidar $ tail -n 8 stream.1.log
{
  "scan": 1,
  "time": 1628576979.652241,
  "distance": 0.0,
  "angle": 357.78125,
  "x": 0.0,
  "y": -0.0
}
```

The difference there is 0.136532068 seconds or 136.5ms.  So with scan defaults the rate for full scans is 1/0.136532068 = 7.3 scans per second.

Scan 1 has 266 measurements.

```
$ cat stream.log | grep '"scan": 1,' | wc -l
266
```

So that is 266/0.136532068 = 1948 measurements per second.  That surprises me because the marketing material says the device can do 8000 measurements per second.

It seems that the points are _almost_ sorted by angle as delivered, but not quite.  Here is an example from scan 1 where the points are not delivered in order. I think this is why there is logic in the donkey part to sort them.  However, I don't really see any reason why we need them sorted.  However, this does defeat that logic I was going to use to detect the start of a scan where you would just check for a new measurement whose angle is less than the previous measurement.  You can see in the code that I did use the 'new_scan' boolean provided by the lidar.

```
{
  "scan": 1,
  "time": 1628576979.6257262,
  "distance": 0.0,
  "angle": 284.46875,
  "x": 0.0,
  "y": -0.0
}
{
  "scan": 1,
  "time": 1628576979.6261306,
  "distance": 0.0,
  "angle": 292.96875,
  "x": 0.0,
  "y": -0.0
}
{
  "scan": 1,
  "time": 1628576979.6282256,
  "distance": 1686.5,
  "angle": 287.15625,
  "x": 497.48129249332277,
  "y": -1611.4572950032443
}
```

So there is probably a little work to see if we can up the scan rate to 10hz and increase the density of the data points.

TCIII, 2021-08-10:
@Ezward,

Because of the ambiguity of where the 0/360 degree reference is on the Slamtec RPLidars, I believe it is in our best interests to reach a consensus on where the Slamtec RPLidars' 0/360 degree physical reference point actually is before moving forward.
Comments?

TCIII, 2021-08-10:
@Ezward,
"So that is 266/0.136532068 = 1948 measurements per second. That surprises me because the marketing material says the device can do 8000 measurements per second."
I suspect that the 8000 measurements/second rate is arrived at using the Slamtec SDK on a I7 or faster PC?

Ezward, 2021-08-10:
> 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
> 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

So I think you are saying is that zero degrees is marked on the diagrams using the x-axis arrow, in  both cases pointing down.  And also, since you would normally mount the lidar on a car with those facing at the back of the car, then the forward angle is actually 180 degrees.  Thanks for figuring this out.  So that means we need a configuration property for the angle offset so we can normalize angles to that zero is always forward.  In addition, the lidar is spinning clockwise, so angles are increasing opposite of what we would expect using standard math.

This second thing; the direction of the lidar spin, seems to be an attribute of the lidar model.  So we can bake that into the code for that lidar model.  I would think we want angles to increase in a counter-clockwise direction so normal math rules apply.  So we would adjust the angle `angle = (360 - (angle % 360)) % 360`

The first thing, the position of the zero angle relative to the forward direction of the car, depends upon both on the lidar model and how the user mounts that lidar on their car.  So that needs to be put into configuration and we need to adjust angles before we output them so that zero is always forward on the car.  Assuming we have angles that increase in a counter-clockwise direction; `angle = (angle - FORWARD_ANGLE + 360) % 360

@TCIII does that sound like it is consistent with your findings?

TCIII, 2021-08-10:
@Ezward,

I don't agree that the "forward angle is at 180 degrees" for the following reasons:

Based on the following angle/range data, captured by your lidar_test.py program, when using a target 13 inches wide that is centered directly in front of the A1M8 scanner and is 46.5 inches (118X.X - 119X.X mm) from the center of the scanner:

 [(0.109375, 1186.0), (1.046875, 1186.25), (2.484375, 1188.0), (3.890625, 1190.5), (4.15625, 1190.0), (5.34375, 1192.75), (6.765625, 1197.75), (352.953125, 1194.75), (353.96875, 1196.75), (354.0625, 1199.75), (355.34375, 1190.0), (356.78125, 1188.5), (357.03125, 1188.0), (358.21875, 1186.75), (359.6875, 1185.25)]

I would say that the A1M8 start of scan (0/360 deg) is at the front of the scanner on a centerline running from the motor end through the scanner axis and out the front of the scanner.

I say this because  the 0 degree through 6 degree ranges are around 118X to 119X mm and the 352 degree through the 359 degree ranges are 118X -119X mm. The first thing the scanner sees at 0 degrees, during the clockwise rotation, is the target at 118X mm and when beyond 6 degrees falls off the target at 119X mm. Then, after rotating clockwise towards the front of the scanner chassis, the scanner sees the target again at 352 through 359 degrees where the range varies from 119X through 118X mm as the scanner moves from the left edge of the target towards the center of target at 0 degrees to start the scan over again in the clockwise direction.

If the forward angle is at 180 degrees, how do you explain the 0 degree range of 1186.0 mm which is almost the same distance (118X mm) that the target is from the scanner at the front of the scanner?

Here are the ranges that the A1M8 scanner saw starting at 180 degrees: (180.9375, 107.75), (181.703125, 107.75), (182.375, 108.0), (183.890625, 108.0), (184.515625, 108.0), (185.140625, 108.0), (186.875, 108.25), (187.265625, 108.5), 0, 0, 0, 0, 0, 0, 0, 0, 0, 0, (198.40625, 4886.5). Directly behind the scanner is a two inch wide post that supports the Sainsmart WFOV camera above the scanner, which probably accounts for the 0 mm range at 188 degrees because the support post is about 10.8 cm from the center of the scanner and well within the minimum range of 15 cm.

Comments?

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

Ezward, 2021-08-11:
I don't understand what is front or back of scanner, but I think you are saying the zero heading is pointing up in the diagrams (opposite of what I was saying).  That makes sense.  I think everything I suggested related to configurations properties still holds.  In this case, if the A1M8 is pointed so the motor faces the back of the car, then the zero heading is facing directly front and so FORWARD_ANGLE would be zero.  If the A2 has it's interface lead pointing towards the back of the car, then again the FORWARD_ANGLE would be zero.  That all makes sense since that is the most intuitive way to mount the lidars.

TCIII, 2021-08-11:
@Ezward,

That is a good summation. I agree with the Lidar physical mounting references.

I look at it this way:

 The A1M8 angle/range data recorded the target at 0 degrees when the laser in the scanner was looking forward at the target at a recorded 0 degrees. Now comes the tricky part. Is 0 degrees at the motor end of the chassis or is it at the front end of the chassis with the laser in the scanner looking forward?

Chris and the UCSD 2019 Team students assumed that 0 degrees started at the motor end and the number of degrees increased towards the 180 degree point which would be looking out the front of the vehicle, however where was the laser looking at 0 and 180 degrees? They offered no evidence of where it was looking.

We know for a fact, through empirical testing, that the laser is looking forward when the target range is recorded at 0 degrees and is looking backwards towards the motor end when the target range is recorded at 180 degrees.

Therefore I believe that we can pick whichever end of the chassis we want for the 0 degrees point as long as we stick with the convention we ultimately choose.  If we chose the motor end then when angle and range is recorded at 0 degrees the laser is looking forward and when angle and range is recorded at 180 degrees the laser is looking backwards. The logic is still the same if we chose the front end for the 0 degrees point which makes the motor end the 180 degrees point. I personally like the front end to be the 0 degrees point as it jibes with the Slamtec A1M8 diagram irrespective of where the "X" leg is pointing as this is probably a ROS convention.

Comments?

Ezward, 2021-08-12:
I agree we should recommend that user's mount their lidar in this 'natural' way where zero heading is pointing forward, but that is not mandatory.  We can provide the FORWARD_ANGLE configuration property so they can adjust if they mounted it in a different way.

Ezward, 2021-08-14:
See my RPLidar experiments at https://github.com/Ezward/rplidar

I did some work to see if we could stream in measurements rather that wait for an entire 360 degree scan.  See `stream_lidar.py` for an example that streams measurements as they are aquired.  This will do filtering, but it does not sort.

I used this to look at the performance characteristics of the RPLidar A1M8-R6 using scan defaults.

Here is an example where I streamed 10 full scans, then I used grep to count the number of points in each scan.  Scan 0 usually has about 250 or more points.  Subsequent scans have 267 or 268 measurements.  This is using the default scan settings and including zero readings.

```
$ python stream_lidar.py -n 10 -d 0 >stream.log
$ cat stream.log | grep scan | wc -l
$ cat stream.log | grep '"scan": 0,' | wc -l
255
$ cat stream.log | grep '"scan": 1,' | wc -l
268
$ cat stream.log | grep '"scan": 2,' | wc -l
268
$ cat stream.log | grep '"scan": 3,' | wc -l
267
$ cat stream.log | grep '"scan": 4,' | wc -l
268
$ cat stream.log | grep '"scan": 5,' | wc -l
267
$ cat stream.log | grep '"scan": 6,' | wc -l
268
$ cat stream.log | grep '"scan": 7,' | wc -l
267
$ cat stream.log | grep '"scan": 8,' | wc -l
268
$ cat stream.log | grep '"scan": 9,' | wc -l
267
$ cat stream.log | grep '"scan": 10,' | wc -l
267
```

I added time to each measurement as they came in.  Here are the first and last points in scan 1:

```
(venv) pi@raspberrypi:~/projects/rplidar $ head -n 8 stream.1.log
{
  "scan": 1,
  "time": 1628576979.515709,
  "distance": 0.0,
  "angle": 359.21875,
  "x": 0.0,
  "y": -0.0
}
(venv) pi@raspberrypi:~/projects/rplidar $ tail -n 8 stream.1.log
{
  "scan": 1,
  "time": 1628576979.652241,
  "distance": 0.0,
  "angle": 357.78125,
  "x": 0.0,
  "y": -0.0
}
```

The difference there is 0.136532068 seconds or 136.5ms.  So with scan defaults the rate for full scans is 1/0.136532068 = 7.3 scans per second.

Scan 1 has 266 measurements.

```
$ cat stream.log | grep '"scan": 1,' | wc -l
266
```

So that is 266/0.136532068 = 1948 measurements per second.  That surprises me because the marketing material says the device can do 8000 measurements per second.

It seems that the points are _almost_ sorted by angle as delivered, but not quite.  Here is an example from scan 1 where the points are not delivered in order. I think this is why there is logic in the donkey part to sort them.  However, I don't really see any reason why we need them sorted.  However, this does defeat that logic I was going to use to detect the start of a scan where you would just check for a new measurement whose angle is less than the previous measurement.  You can see in the code that I did use the 'new_scan' boolean provided by the lidar.

```
{
  "scan": 1,
  "time": 1628576979.6257262,
  "distance": 0.0,
  "angle": 284.46875,
  "x": 0.0,
  "y": -0.0
}
{
  "scan": 1,
  "time": 1628576979.6261306,
  "distance": 0.0,
  "angle": 292.96875,
  "x": 0.0,
  "y": -0.0
}
{
  "scan": 1,
  "time": 1628576979.6282256,
  "distance": 1686.5,
  "angle": 287.15625,
  "x": 497.48129249332277,
  "y": -1611.4572950032443
}
```

So there is probably a little work to see if we can up the scan rate to 10hz and increase the density of the data points.

Ezward, 2021-08-14:
I did find another issue regarding accuracy of the current RPLidar implementation the LidarPlot part that plots the lidar.  The LidarPlot assumes that angles increase counter-clockwise as is normal in mathematics.  However, the RPLidar spins in a clockwise direction and so angles appear to increase clockwise.  So the calculation of the (x, y) Cartesian coordinate pair in LidarPlot is not correct for RPLidar.  I'm currently creating a new part that addresses that issue, but that is also a source of error is anyone was depending upon that plot (or otherwise assuming that the angles were valid in most mathematical models).

TCIII, 2021-08-14:
@Ezward,

Excellent work to say the least. I tried your stream_lidary.py program and it worked flawlessly and returned results similar to yours.

Ezward, 2023-02-18:
@TCIII PR https://github.com/autorope/donkeycar/pull/918 merged my new lidar stuff.  Can we close this issue?

TCIII, 2023-02-18:
@Ezward,
Yes.

Closed 2023-02-18.

Thread 921 (2021-08-20):

Adding velocity to the model

Ezward, 2021-08-20:
Adding velocity to the model

We have encoder parts that can estimate the vehicle's distance and  speed.  So how would we use that information?  Ultimately we want to do a better job of managing the vehicles speed.  (We may also want to use this for kinematics/path planning and obstacle avoidance, that that will be a separate issue) .  Our linear model current uses throttle as a proxy for speed.  This can work provide that the data has throttle values that correlate well to where the user is on the track.  This worked really well for me on the old track mostly because I kept full throttle most of the time, so the model pretty much always predicted full throttle.  I never really slowed very much, so the model worked.  However, the new track is more challenging and has very tight turns, so the driver must modulate the throttle much more than on the old track; this makes predicting a high dynamic range of throttle values to be much more important.  This turns out to be very difficult.  For instance, I gathered a lot of data on the new track, but because of all the turns and loops my throttle was all over the place.  The resulting model is terrible at predicting throttle.  For instance, there are places I would essentially 'coast' to slow down; those are near zero throttle but velocity would only decrease slowly.

So throttle is not as good a parameter as velocity.  Velocity is also more independent of battery level, presuming we stay within the operational range.  Velocity is also more independent of the particular kind of DonkeyCar.  So models based on velocity can be shared to better effect.  Models based on velocity have the potential to be much better on the new track than those based on throttle.  So I think adding velocity to the model is a great idea but there is a little more to do to really get the value out of it

The parameter we would want to include in the model is not the encoder count or distance; we want velocity.  The current encoder parts already output velocity; we may want to enhance this a little to allow for smoothing velocity over a short time.  We also need timestamps so we can line up this data with other data in the pipeline; the encoder part will produce distance, velocity and a timestamp.  The velocity may or may not be smoothed depending on how the encoder part is configured.

For the model we would replace the throttle parameter with velocity; we would keep the steering  parameter.  So the model will train on images tagged with steering angle and velocity and will infer steering angle and velocity given an image.

Once we can measure velocity and infer a desired velocity,  then we want to be able to make the car drive at the desired velocity.  We need to  add closed-loop speed control to the vehicle.  So we would have a part that, given a velocity in the working range, would maintain that speed by increasing or decreasing the throttle to make the measured speed match the target speed.  I do that in this [project](https://github.com/Ezward/Esp32CameraRover2/blob/1950891a3437999a661dcd6acf1a15e289df5a7b/src/wheel/drive_wheel.cpp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).  DriveWheel::_pollSpeed(), (note: this is C++), this reads the encoder value at the current time and uses it to calculate a velocity using prior encoder values.  It then compares the measured velocity to the target velocity and increases or decreases the throttle PWM to try to match the target velocity. (This is a very simple constant step controller; it has the advantage of being very easy to calibrate, but it is slow to react.  We probably want to use a PID controller for racing.)

So tasks are
1. modify encoder parts, ArduinoEncoder and RotaryEncoder in [encoder.py](https://github.com/autorope/donkeycar/blob/dev/donkeycar/parts/encoder.py):
- output distance, velocity and a timestamp for every measurement.  We want all of that data because we may use it in subsequent parts of the pipeline (for instance, in a kinematics part)
- Produce a smoothed velocity given a time span to average over.  If time span is not specified, then no smoothing is done (acts like current parts).
- Add the SPEED_SMOOTHING_MS to configuration parameters.

2. Modify the pipeline in complete.py
- When constructing the encoder, pass the speed smoothing parameter if it is configured.
- Change pipeline so the encoder part outputs the distance, velocity and timestamp into the pipeline (it currently only outputs velocity)
- Change the pipeline so that the image, steering and velocity are written to the tub in drive mode.

3. Starting with the linear model, create a new model where we use velocity rather than throttle as a scalar input and output.  This should be very easy.  This will need another model name, like LINEAR_VELOCITY, so it can coexist with the current model. We maintain the steering angle parameter; so the model will infer both steering angle and velocity.
- modify cfg_complete.py so this new model type can be chosen.

4. Modify the pipeline so that if LINEAR_VELOCITY is the chosen model, it outputs steering and velocity to the pipeline when in auto-pilot mode.

5. Create a new part that implements closed loop velocity control.
- This part will take in a target velocity and the current throttle.
- The part will calculate a new throttle value designed to achieve the target velocity.  We probably want to implement this as a PID controller.  We may also want to do feed-forward, although we may get fast-startup from the AI Launcher.
- The part will output the new throttle value that will be used later in the pipeline.

6. Update the pipeline so that if the LINEAR_VELOCITY model is the chosen model and we are in autopilot mode, it will construct a velocity controller part and insert it into the pipeline such that it can get the target velocity and current throttle as input, and it can output a throttle value that will be used by the motor actuator part; it should be inserted just [before the DriveMode part](https://github.com/autorope/donkeycar/blob/02b41a0d079f3dea0d5d8f6000f9e074cae45519/donkeycar/templates/complete.py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)

Optional
- there is a small issue in the RotaryEncoder part; it uses a single channel of the encoder.  So this means it does not understand direction.  Worse, it is susceptible to jitter when the vehicle is stopped; the encoder can be in a position where very slight movements of the vehicle send out signals; these are noise and do not represent real movement.  If this happens with a single-channel encoder then these may be counted, making the system think the vehicle is moving when it is not.  For simple optical encoders we may only have a single channel.  However, it is common to have a quadrature encoder with two channels.  Quadrature encoders are less prone to this kind of noise.  Further, a quadrature encode knows about direction, so it can increment or decrement distance correctly.  This may not be a big deal given our problem domain; we don't really stop or go backwards during a race; that is why it is optional

TCIII, 2021-08-20:
@Ezward,

I have purchased a single output encoder similar to the one in the DC odometry/encoder guide. I have a large 6WD robot chassis where the center two wheels are not powered and have the capability of attaching an encoder wheel that can work with the single output encoder. I also have a smaller 6WD chassis where I can replace one of the center motors with a motor/quadrature encoder and use an Adafruit Metro Mini to read the encoder A/B outputs and provide odometry input to the Rpi via a USB connection. So I can test both single and quadrature encoders.

Ezward, 2021-08-22:
Note that the 'path follower' template, that uses the RealSense T265, uses and encoder and a part called OdomDist that uses ticks from the encoder part to calculate distance; https://github.com/autorope/donkeycar/blob/b1af0aacf488c938231912f89c4bfa5c2b11c649/donkeycar/templates/path_follow.py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

TCIII, 2021-08-22:
@Ezward,

Interesting.

I have run the path_follow.py template on both a Nano 4GB and a Rpi 4B 4GB and found that the AI became easily confused and lost if the path was nothing more than an a big oval track. Attempting to use the AI on a path that used right and left turns was a no go and I abandoned the path_follower.py template as unusable.

Ezward, 2021-08-28:
The first step is to refactor the various encoder parts.  They have redundant distance and velocity calculations.  One of them does velocity smoothing, the others do not.

- separate tachometer and odometer functions into separate parts, so we can support multiple encoder hardware types but have a single way to calculate distance and speed.
- The 3 tachometer parts read encoders, using pulses-per-revolution config to calculate revolutions of the encoder.
- A single odometer part reads encoder revolutions, using meters per revolution config, calculate distance in meters and velocity in meters per second.
- The odometer part can provide a smoothed velocity.

In a future pull requests we will add unicycle and bicycle kinematic models.  So we want to support multiple encoders and odometers, so we can support differential drive in the pipeline.  The two odometers would be input to the unicycle kinematic model.

TCIII, 2021-08-29:
@Ezward,

I received the US Digital quadrature motor encoder in the mail today and found that the installation instructions, on the Lynmotion website, are sorely lacking in relation to successfully installing the encoder on the back of the motor. I knew this already so it was no surprise.
The spacer ring used to mount the encoder assembly on the back of the motor initially did not fit flush to the motor back surface due to the spacer ring sitting on top of the motor power terminal bosses. Filing clearance dimples in the bottom of the spacer ring edge solved that problem. The spacer ring is now glued to the back of the motor. After the CA had set I proceeded to finish the encoder installation by attaching the encoder pwb to the encoder mount, pressing on the encoder wheel to what I thought was an appropriate distance from the sensor and then pushing on the back cover.

I then used the Arduino IDE to compile the encoder.ino program for my Adafruit Metro Mini, but received an error about "no encoder type specified". So I found that I had to install this Arduino Library: https://www.arduino.cc/reference/en/libraries/encoder/. After that the program complied without error and downloaded to my Adafruit Metro Mini. I then attached the encoder cables to the Mini and plugged in the USB connector so I could use the Arduino IDE serial terminal to view the Mini output. Using a small wrench to turn the motor shaft I observed both positive and negative pulse output values from the US Digital motor encoder via the Mini USB output.

With one revolution of the motor geared output shaft, I observed about 12,666 encoder forward pulses. The motor has a 30:1 gear reduction and the encoder outputs 4,000 pulses/mtr rev so the 12,666 pulses per motor output shaft revolution correlates well with the expected encoder output of ~12,000.

TCIII, 2021-08-29:
@Ezward,

I installed a single-ended encoder (https://www.amazon.com/DAOKI-Measuring-Optocoupler-Arduino-Encoders/dp/B081W2TY6Q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) on one of the center unpowered wheels on my large 6WD robot chassis. I used a stepped ream to enlarge the disk hole to around 6 mm which provided a nice snug fit. An 11 mm standoff with a 1/8 inch spacer provided a solid mounting point for the encoder board such that there is around 0.020 of an inch clearance between the outer circumference of the disk and the top of the encoder module.
The US Digital quadrature encoder for one of the center motors on my smaller 6WD robot chassis should be here this week and will be an easy installation on the back of the center motor.

Here is the result of running DC manage.py drive with input from the single ended encoder:

Stopping Rotary Encoder
        Distance Travelled: 5.1869 meters
        Top Speed: 1.555 meters/second

My calculated value for 10 turns of the encoder wheel is 5.185  meters and that closely matches the reported "Distance Travelled: 5.1869 meters".
My particular encoder wheel/encoder appears to function as expected.

The single ended encoder wheel/encoder assembly recommended in the DC Odometry/encoder guide had complaints about the output being noisy and it was recommended to install a 33k ohm resistor between the LM393 comparator output and the "+" input. My encoder board does not have a feedback resistor either, but that does not appear to affect the accuracy of its output.

Ezward, 2021-09-14:
The new encoder parts are almost done.  Now we need closed loop speed control.  We have to have closed loop speed control before we even bother with training a model with velocity.  The most common way to do this is with a PID controller; I find it hard to calibrate a PID controller, but when calibrated well it responds to velocity changes quickly and minimizes oscillating around the target velocity.  The simplest and easiest speed control is with what is called a constant-step controller which is basically; 1) measure speed with encoder 2) if slower than target then increment throttle by some constant; if faster than target then decrement speed by some constant. However, it is very slow to reach the target unless you add another thing; feed-forward.  With feed forward you build a curve of throttle to velocity and then when starting from zero you calculate the initial throttle from the curve so that it starts fast.  After that you use the constant step controller (or even a PID controller).  However, once underway the constant step controller does not respond quickly to large changes in velocity.  Also the throttle/velocity curve becomes more inaccurate as the battery drains.
So I will probably make the closed loop speed control plug-able and start with constant step controller.  You can see how to calibrate a constant step controller with feed forward here; https://www.youtube.com/watch?v=ciDCUUx8MXI

Ezward, 2021-09-22:
The new encoder parts are close to being ready.  This branch https://github.com/autorope/donkeycar/tree/921-next-generation-odometer-parts includes code that supports dual encoders for differential drive setups.  The code also includes Arduino sketches for single-channel and quadrature encoders with debouncing and supports multiple encoders from a single Arduino.  It also includes a Unicycle model kinematics part that estimates the pose for a differential drive robot; for now that is simply used to get the distance and speed average of the two wheels; the pose estimation will likely to be more useful in the path_follow.py template.

Ezward, 2021-10-10:
The new encoder parts are close to being ready.  This branch https://github.com/autorope/donkeycar/tree/921-next-generation-odometer-parts includes code that supports dual encoders for differential drive setups.  The code also includes Arduino sketches for single-channel and quadrature encoders with debouncing and supports multiple encoders from a single Arduino.  It also includes a Unicycle and Bicycle model kinematics parts that estimate the pose for a the robot using the odometry input.  This is used in the path_follow template as another source of pose.  That template now has the T265 as optional.  You can still use the template if you only have odometry.  If you have odometry and the T265, then odometry is used to improve the T265 pose estimates.

Ezward, 2021-10-10:
I just pushed a large set of changes that include a new Keras model that infers forward velocity and angular velocity.  We now have inverse kinematics parts (both bicycle and unicycle) that can take the forward and angular velocities and turn these into wheel velocities and/or steering angle.  Finally,  there is also a simple speed controller, so we can used these inferred velocities to control the robot's speed precisely by using the odometry input to measure the robot's actual velocity, then modify the throttle to make the actual velocity match the desired target velocity.  This latest commit is still a very early ALPHA and is unlikely to actually work, since there has been no integration testing yet.  Further, I need to document the necessary configuration and calibration steps necessary to make this all work.

Ezward, 2023-02-18:
The new encoder->tachometer->odometer->kinematics pose estimation pipeline has landed, see PR https://github.com/autorope/donkeycar/pull/1089  So we now have a way to get an estimate of forward velocity from the encoders. So what is left;
- implement a close-loop speed controller to adjust throttle to match a target velocity.
- create a model that uses velocity rather than throttle. Really this is the same as the throttle model; it will train and infer on values -1 to 1, but it must carry around the meta that can be used to normalize velocity into the range and unnormalize that range back to velocity, so the output of inference is a real velocity.

Thread 925 (2021-08-23):

In the complete.py template mm_per_tick is hard coded with the value 0.306096 in the "HAVE_ODOM" cfg.

TCIII, 2021-08-23:
The robot wheel that I have an encoder attached to is 6.5 inches in diameter for a circumference of  20.42 inches. The encoder wheel has 20 slots so there are 1.02 inches/tick or 25.93 mm/tick. Therefore one rotation of the wheel should equal 518.69 mm and 10 rotations of the wheel should equal 5,185.94  mm or a little over 5 meters.

If I start manage.py drive and rotate the wheel 10 rotations while collecting records, I consistently get  between 0.06 - 0.07 meters of travel after shutting down "manage.py drive" when I should have a little over 5 meters.

I can set "MM_PER_TICK =" in myconfig.py and I am using 25.9347. In the RotaryEncoder class the default is "mm_per_tick=0.306096".

No matter what value I set for "MM_PER_TICK =" in either myconfig.py or the RotaryEncoder class, the distance travelled is always 0.06 m for 10 turns of the wheel when it should be a little over 5 meters.

If I do the following: (0.306096 mm/tick X 20 ticks/revolution) X 10 revolutions, I get 61.21 mm or 0.0612 meters of travel.
If I do the following: (0.306096 mm/tick X 20 ticks/revolution) X 5 revolutions, I get 30.61 mm or 0.0306 meters of travel.

The 0.0612 meters is approximately the distance I get when I run manage.py drive to collect records and turn the wheel 10 times. The 0.0306 meters is approximately the distance I get when I run manage.py drive to collect records and turn the wheel 5 times.

Therefore I believe that the code is using "mm_per_tick=0.306096" no matter what value is input in MM_PER_TICK =" in myconfig.py.

TCIII, 2021-08-23:
Ed Murphy reviewed the HAVE_ODOM cfg in the complete.py template and found that "mm_per_tick=0.306096" is hard coded in "enc = RotaryEncoder(mm_per_tick=0.306096, pin = cfg.ODOM_PIN, debug = cfg.ODOM_DEBUG)".

Recommended solution:

Change "mm_per_tick=0.306096" to "mm_per_tick=cfg.MM_PER_TICK"

Ezward, 2021-08-24:
I started working on this.  the pin input and the poll delay are also not being set correctly.  The other encoder (Arduino) also does not get its mm_per_tick set correctly.   One takes throttle as in input (so it can set direction of the tick change correctly for a single-channel encoder), but does not use it.  There is an encoder driver in another file; https://github.com/autorope/donkeycar/blob/dev/donkeycar/parts/pigpio_enc.py, that only outputs ticks.  there is a separate part to take in the ticks and output odometry.  So I think we want to rationalize these parts.  I started working on the two parts in encoder.py and saw they have different ways of calculating the distance and speed; basically they repeat the same basic logic, but diverge.  This would not happen if they only output ticks and the odometry part took that in and calculated distance and speed.  So, I think the right thing to do is to simplify these parts to only output ticks and elevate the odometry part to it's own file.  It will take in the encoder ticks and derive distance and speed from them; so this logic will be in one place and separate from any hardware considerations.  So this in more than a one liner, but still relatively small.  It's a good refactor.

TCIII, 2021-08-24:
@Ezward,

Sounds good to me.

Please let me know if I can be of any assistance vetting the new encoder code and any additional supporting parts.

Ezward, 2021-09-04:
Fixed by https://github.com/autorope/donkeycar/issues/925

Closed 2021-09-04.

Thread 938 (2021-09-22):

PIDController integral error may be incorrect

Ezward, 2021-09-22:
See https://github.com/autorope/donkeycar/blob/85958e59431ed142c40da1966f8b8654b60daacf/donkeycar/parts/transform.py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

- the totalError term does not include the current error
- the totalError term is being multiplied by delta-time, implying that the delta-time is constant.  That may not be be true.  I think it would be more accurate to make totalError the sum of all errors times their interval.  So
```
  self.totalError += err * dt
  alpha += -self.Ki * self.totalError
```

I think we should also bound this total error OR keep a history queue of error values and bound that queue so we only use error from last 'n' iterations.

If error changes sign (we have 'crossed' our target value), then we would be justified is clearing the total error.  For example, if the total error is accumulated on one side of the target value, then we make an adjustment that puts us on the other side of the target value, then that accumulated error no longer make sense as it would 'push away' from the target value, rather that make us converge on the target value.  As it relates to the path_follow.py template, if cross track error has us to the right of the target, then we are accumulating error on that side of the target.  If in the next frame we see that error has changed sign (we are now to the left of the target), then the accumulated error could possibly moves us farther to the left; we should zero because our error has changed sign.

In the path_follow.py template, the PIDController is used to calculate a new steering value.  The implied target value is zero (no steering change, go straight).  If crosstrack error is positive (we are to the 'right' of our path0 we want to steer left, so steering value is negative; -1 >= steering > 0.  If crosstrack error is negative (we are  the left of our path) we want to steer right, so steering  value is positive; 0 < steering <= 1.  The control relationship is a 'reverse' relationship.  This is baked into the PID code by effectively multiplying the constants by -1 when they are applied.  For example, note how the Ki term is negated when it is applied `curr_alpha += -self.Ki * (self.totalError * dt)`.  That makes this PIDController less general than it could be.  I suggest that we have a boolean argument that declares whether the control relationship is reverse or not, rather than have this assumed to be reverse.  The other alternative is to allow negative constants; we would need to look deeper to see if there any other pieces that assume positive constants only (like UI where they might be input, or in the twiddle() parameter optimizer.

TCIII, 2021-10-03:
I had an extremely difficult time attempting to determine the correct P, I, and D values for my robot chassis when using the DC path_follow.py template.
Using traditional guidelines to determine the correct P, I, and D values resulted in only marginal robot chassis performance when attempting to navigate a given path.

Ezward, 2021-10-08:
I think it is probably worth adding a simple step controller to the path_follow template, since that type of controller is much easier to calibrate.  This will work well if steering angles tend to be shallow and smooth.  We can make this or the PID controller a choice in the config file.

Ezward, 2023-02-17:
We have good success with the current PID controller.  Closing this a won't do.

Closed 2023-02-17.

Thread 940 (2021-09-27):

PCA9685 calibration needed

fengye, 2021-09-27:
Note this is different from calibrate the steering and throttle of the build. This issue is about the calibration of the actual signal of the PCA9685 output.

Current PCA9685 board has numerous manufacturer now, Adafruit (https://www.adafruit.com/product/815), Seeed(https://wiki.seeedstudio.com/Grove-16-Channel_PWM_Driver-PCA9685/), Waveshare(https://www.waveshare.com/servo-driver-hat.htm) and Aliexpress clones for example. Different manufacturer has different errors introduced by many factors during design/manufacturing. One of the results is the output PWM frequency isn't accurate, sometimes far from acceptable, if you test it with an oscilloscope.

Here's what found comparing steering signal output by a 50Hz RC receiver, and a signal produced by an PCA9685 variant(https://www.waveshare.com/Servo-Driver-HAT-B.htm)

RC receiver signal neutral(1500us):
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

RC receiver signal leftmost(1000us):
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

RC receiver signal rightmost(2000us):
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

The math goes like this:
It's a receiver produce 50Hz signals, so a full duty cycle is 1/50 = 0.02s = 20ms = 20000us. A traditional leftmost, neutral, rightmost signal width would be 1.0ms(1000us), 1.5ms(1500us) and 2.0ms(2000us) respectively.

As seen from the result, they were nearly perfect for a $10 receiver. It almost align with the 1000-1500-2000us time. However for the PCA9685 without calibration:

PCA9685 signal neutral:
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

PCA9685 signal leftmost:
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

PCA9685 signal rightmost:
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

So the uncalibrated PCA9685 neutral signal was around 1300us, leftmost was around 900us, rightmost was around 1850us, which are far from acceptable IMO. Even the captured frequency is 5Hz off from the 50Hz one. BTW I measured those values using `donkey calibrate` command and convert the pwm width to the integer value PCA9685 library accepts. That is, 307(from 1500/2000 * 4096), 205(from 1000/20000 * 4096), and 410(from 2000/20000 * 4096), with `pwmFreq` set to 50.

This is also documented in Adafruit's CircuitPython PCA9685 documents(https://circuitpython.readthedocs.io/projects/pca9685/en/latest/api.html#adafruit_pca9685.PCA9685):
```
The internal reference clock is 25mhz but may vary slightly with environmental conditions and manufacturing variances. Providing a more precise reference_clock_speed can improve the accuracy of the frequency and duty_cycle computations. See the calibration.py example for how to derive this value by measuring the resulting pulse widths.
```

The difference in PWM frequency might not seems to be a problem if you calibrate the steering and throttling pwm values and stick with it. However, if you're switching to another PCA9685 board, or using a RC controller + Arduino signal translator to train the car then you'll instantly find the steering and throttling are wrong. Maybe it's time to switch over CircuitPython's PCA9685 library.

Ezward, 2023-02-18:
In the docs we go through a higher level calibration process.  Using that process the user can choose the values for reverse, neutral and forward throttle and left and right steering.  They gather data and train on the same PCA9685, so a low level calibration of the PCA9685 does not seem to be warranted.  It would only be necessary if we wanted throttle values to transfer from car to car.  We don't need that.  Eventually we will have closed-loop speed control in which case transferable velocity is what we want.  We expect that close-loop speed control will be robust to small variations in the PCA9685.

Closed 2023-02-18.

Thread 945 (2021-10-11):

Refactor motor drivers

Ezward, 2021-10-11:
Our motor drivers are pretty tightly bound to the libraries used to control PWM and GPIO pins.  This makes it hard to re-use code when building a new driver.

I'm in the process of enabling donkeycar software on a Duckiebot robot homebrew clone [here](https://github.com/Ezward/diyduckie).  It uses an TB6612FNG motor controller which is pin compatible with an L298N.  However, due to the evolution of the Duckiebot platform, one of it's motors get's it's enable signals from GPIO and the other from a PCA9685.  The other motor get's it's enable signals from GPIO and PWM from PCA9685.

This would all be actually pretty easy to handle if we had our motor drivers accept a more generic interface for setting GPIO and PWM signals.  We could implement versions for the RPi.GPIO library, PiGPIO library and the PCA9685.  We could even write a version that controls this via an arduino using I2c or serial.

- Create abstract base classes for  LogicPin and PwmPin.
- Create concrete implementations for RPi.GPIO (and so Jetson.GPIO),  PCA9685 and PiGPIO
- Refactor motor drivers to take instances of LogicPin and PwmPin rather than raw pin numbers.
- update templates to instantiate instances of LogicPin and PwmPin when constructing drivetrain parts.

I would also refactor the templates by extractng the drivetrain construction from complete.py and making this a function that can be called by any template.  Then we could give other templates the flexibility to choose drivetrains, even if we only add a default in their config.

Add more documentation on how to wire the motor drivers.  Each of our choices for motor implies a certain kind of hardware and wiring.  It would be useful to add a little more documentation and references on this.  Links to product descriptions on Amazon and Aliexpress tend to go stale very quickly, so we should focus on finding datasheets and tutorials that are likely to stay live longer.

This article does a very detailed job of describing the possible connections to an L298N https://www.etechnophiles.com/l298n-motor-driver-pin-diagram/  However, it does not explicitly describe how only the duty cycle inputs are used and the enable pins are not used.  The links to the product pages are 404ing.  I'm assuming this driver is for a 'mini' L298N.  That board uses just 4 wired to hookup 2 motors as this driver assumes.  Here is an article on how t use this with an arduino; https://www.instructables.com/Tutorial-for-Dual-Channel-DC-Motor-Driver-Board-PW/   Basically, the input pins are also used as PWM/duty cycle pins.  I assume you can use a full L298N module in this mode by leaving the enable pins jumpered and sending PWM via the input pint.

Ezward, 2021-10-31:
I've checked in code to the branch to address #2 & #4 from my prior comment.

#2. There is now a drivetrain named PWM_STEERING_THROTTLE and a generalized pulse controller called PulseController that use the pins.py pin provider api to send servo style PWM pulses to Servo/ESC style RC car drivetrains.

#4. I've ported the @deprecated decorator from another branch and marked a bunch of stuff in actuators.py as deprecated.  I've also left large comments on those classes that explain why they are deprecated and an explanation to how we might proceed if we wanted to keep them in the code.  I think one in particular, the Arduino Firmata support, is worth putting into the pins.py pin provider api, but I don't want to block getting this code tested and merged.  We can make that a separate issue if we want to move forward with that.

Ezward, 2021-11-12:
Add two more drivetrains to support L298 2pin + server and L298 3pin + servo.  L298 2pin + servo would replace the current 'SERVO_HBRIDGE_PWM' drivetrain.  L298 3pin + servo would be new, but we do have a user out there that needs this.

Ezward, 2021-12-21:
Testing

for each hardware configuration:
- run `python manage.py` and open the web ui
- verify the drive wheels turn in the correct direction when moving forward and that the speed of the wheel is proportional to the amount of throttle.
- verify the drive wheels turn in the correct direction when reversing.
- verify the front wheels turn in the correct direction and proportional to the user's input

## Configurations:

1. Confirm that older configuration still works: Raspberry Pi, Steering Servo + ESC (standard RC car)
- Hardware: Raspberry Pi 3 or 4, PCA9685, ESC, Servo
- DRIVE_TRAIN_TYPE = "I2C_SERVO" using PCA9685.
- Set the PCA9685 pin assignments for your PCA9685 in myconfig.py in the `#STEERING` and `#THROTTLE` sections

2. Verify the same configuration but using PCA9685 pin specifiers, works
- Hardware: Raspberry Pi 3 or 4, PCA9685, ESC, Servo
- DRIVE_TRAIN_TYPE = "PWM_STEERING_THROTTLE"
- Set the pin specifiers for PCA9685 in the `# PWM_STEERING_THROTTLE` section, like
  - PWM_STEERING_PIN = "PCA9685.1:40.0"  # PCA9685, I2C bus 1, address 0x40, channel 0
  - PWM_THROTTLE_PIN = "PCA9685.1:40.1"  # PCA9685, I2C bus 1, address 0x40, channel 1
- Verify the documentation branch describes the how to format pin specifiers for this configuration.

3. Verify configuration using GPIO pins for PWM:
- Hardware: Raspberry Pi 3 or 4, ESC, Servo
- DRIVE_TRAIN_TYPE = "PWM_STEERING_THROTTLE"
- Set the pin specifiers for GPIO in the `# PWM_STEERING_THROTTLE` section, like
  - PWM_STEERING_PIN = "RPI_GPIO.BOARD.33"  # GPIO board mode pin 33
  - PWM_THROTTLE_PIN = "RPI_GPIO.BOARD.35"  # GPIO board mode pin 35
- Verify the documentation branch describes the how to format pin specifiers for this configuration.
- Verify that the documentation branch describes how to activate PWM output on the Raspberry Pi GPIO bus and which two pins can generate hardware PWM (on the RPi 4).

4. Confirm that older configuration still works: Raspberry Pi, Steering Servo + ESC (standard RC car)
- Hardware: Raspberry Pi 3 or 4, PCA9685, ESC, Servo
- DRIVE_TRAIN_TYPE = "I2C_SERVO" using PCA9685.
- Set the PCA9685 pin assignments for your PCA9685 in myconfig.py in the `#STEERING` and `#THROTTLE` sections

5. Verify the same configuration but using PCA9685 pin specifiers, works
- Hardware: Raspberry Pi 3 or 4, PCA9685, ESC, Servo
- DRIVE_TRAIN_TYPE = "PWM_STEERING_THROTTLE"
- Set the pin specifiers for PCA9685 in the `# PWM_STEERING_THROTTLE` section, like
  - PWM_STEERING_PIN = "PCA9685.1:40.0"  # PCA9685, I2C bus 1, address 0x40, channel 0
  - PWM_THROTTLE_PIN = "PCA9685.1:40.1"  # PCA9685, I2C bus 1, address 0x40, channel 1
- Verify the documentation branch describes the how to format pin specifiers for this configuration.
- Verify that the documentation branch describes how to activate PWM output on the Jetson Nano GPIO bus and which two pins can generate PWM.

Ezward, 2021-12-23:
I have verified configuration `8. Verify Differential Drive configuration with PCA9685 on Jetson Nano`.  Using this robot https://github.com/Ezward/diyduckie which was originally designed to run ROS, but with this new feature in donkey I can run donkey on it now.

Ezward, 2021-12-23:
I have verified this configuration `7. Verify Differential Drive configuration 3 pin HBridge on Jetson Nano` usng this robot https://github.com/Ezward/diyduckie , but with all control signals moved from the PCA9685 to the Jetson Nano bus.  This is the configuration.
```
DRIVE_TRAIN_TYPE = "DC_TWO_WHEEL_L298N" # I2C_SERVO|DC_STEER_THROTTLE|DC_TWO_WHEEL|DC_TWO_WHEEL_L298N|SERVO_HBRIDGE_PWM|PIGPIO_PWM|MM1|MOCK

HBRIDGE_L298N_PIN_LEFT_FWD = "RPI_GPIO.BCM.16"  # BCM.16 == BOARD.36
HBRIDGE_L298N_PIN_LEFT_BWD = "RPI_GPIO.BCM.20"  # BCM.20 == BOARD.38
HBRIDGE_L298N_PIN_LEFT_EN = "RPI_GPIO.BCM.12"   # BCM.12 == BOARD.32 - NOTE: ENABLE pwm using /opt/nvidia/jetson-io/jetson-io.py

HBRIDGE_L298N_PIN_RIGHT_FWD = "RPI_GPIO.BCM.5"  # BCM.5 == BOARD.29
HBRIDGE_L298N_PIN_RIGHT_BWD = "RPI_GPIO.BCM.6"  # BCM.6 == BOARD.31
HBRIDGE_L298N_PIN_RIGHT_EN = "RPI_GPIO.BCM.13"  # BCM.13 == BOARD.33 - NOTE: ENABLE pwm using /opt/nvidia/jetson-io/jetson-io.py
```

I enabled pwm on board pin 13 and board pin 12 using this documentation https://github.com/autorope/donkeydocs/blob/945-refactor-motor-drivers/docs/parts/pins.md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

Ezward, 2022-01-03:
I updated the test comment to include testing the RC Hat on a Raspberry Pi with a servo and esc and an RC controllers.  Those are configurations #9 and #10.  I tested both of them and they worked.

Ezward, 2022-01-05:
merged code PR https://github.com/autorope/donkeycar/pull/951 and docs PR https://github.com/autorope/donkeydocs/pull/25

Closed 2022-01-05.

Thread 948 (2021-10-26):

Enable odometry/kinematics pose estimation in the path_follow.py template

Ezward, 2021-10-26:
path_follow.py allows the user to record a path and then have the vehicle drive that path.  The drive mode will record waypoints on the path that the user manually drives (this should be a closed loop).  The autopilot mode will then drive this path over and over.

Currently, path_follow.py template is dedicated to using the Intel RealSense T265; there are no other supported ways to record points on the path or to follow the recorded path.  There are other ways to provide pose estimates to create a path.  The most straight forward is odometry coupled with forward kinematics for pose estimation.  We could also use IMU data and fuse this with other sources.  This would also be the template to add RTK GPS support.

For now, this ticket will generalize the path_follow.py template to support odometry and forward kinematics (both unicycle and bicycle) for pose estimates.  While I am at it, I will generalize support for drive-trains so it shares the same code as the complete.py template (it is currently limited to `I2C_SERVO`).  This would then allow any kind of supported robot architecture to use the path_follow.py

1. Generalize drive-train support so path_follow.py can use the same drive trains as complete.py
2. Implement odometry and forward kinematics (both unicycle and bicycle) for pose estimation.
3. Refactor the template so either T265 or odometry can be used.  The reason I make them exclusive is that the best way to use odometry with the T265 is to use their api.
4. Also, I've done a lot of this work already and I know that the coordinate system used by the T265 is a little weird, so we need to settle on a coordinate system and document it so that all sources of pose use the same coordinate system and initial pose assumptions so that we can fuse the data.

This is a first step in making the path_follow.py template a more usable and powerful template.  It represents a different way to navigate a track; using a map rather than a neural network.  This is how the best performers at the DIYRobocars races do it.  Ultimately we want to add more ways to localize the robot, a more general map format, utilities for calculating an optimal path and more algorithms for following that path.

Ezward, 2022-03-28:
Step #2. is implemented in https://github.com/autorope/donkeycar/pull/1003

Ezward, 2022-03-28:
Related to #4, the T265 uses a coordinate system that is common to virtual reality where the z-axis and x-axis form the driving plane.  It is more common in robotics to use a coordinate system where the x-axis and y-axis form the driving plane.  The T265 coordinates can be converted to this system with a simple transformation.

Ezward, 2022-10-08:
the gps_logger branch  has code for kinetics and speed control in parts/tachometer.py, parts/odometer.py, parts/kinematics.py, parts/velocity.py.  The state is that
- speed control is not yet used.
- Kinematics works for path following, although the pose estimation, while repeatable so it can be used for path follow, is not accurate, so it cannot be fused to with other pose estimates.

Encoders and kinematics can be used to record and follow a path since it is repeatable, but it is not actually correct.  If you plot the path you can see it way oversteers and so creates a 'looping' looking path.  So neither position nor heading is actually correct.  My theory is that because I've separated out the parts so much and they are either running on the vehicle loop or in separate threads, we don't get very fast and consistent updates.  Really we want updates at more like 100hz than 20hz for kinematics to be accurate.

So if that theory is correct, then the thing to do is make a more monolithic part that handles encoders->tachometry->odometer->kinematics in a single pipeline (a single part) that can then be run in it's own thread so it goes as fast as possible.

So we can use the current parts and wrap them in an another part to turn them into a monolithic pipeline. The start that part in a thread.

The issue I believe is that

Ezward, 2023-02-06:
See PR https://github.com/autorope/donkeycar/pull/1089 for latest.  Status is that this branch has been successfully testing with MOCK encoder implementation for both Bicycle and Unicycle configurations and has been successfully tested in the real world using Unicycle configuration.  I'm just fixing the unit tests which broked due to the refactor, then the PR can be opened.

Ezward, 2023-02-17:
Completed in PR https://github.com/autorope/donkeycar/pull/1089

Closed 2023-02-17.

Thread 949 (2021-10-27):

Port drive trains and camera configurations to other templates

Ezward, 2021-10-27:
The complete.py template supports a lot of drive trains.  Other templates are hard coded for a specific drive train, but would otherwise be generally useful.  The same goes for camera configuration.

For instance, the cv_control.py template implements an autopilot that does not need to be trained. It uses opencv to follow the center line.  That is a nice template, but it is hard-coded to a 'standard' donkey using an RaspberryPi, a PICAM and an RC car drive train with steering servo and ESC.  It's can't be used as is if you are using GPIO to generate the control signals.  If you have a USB camera, you can't use the template.

This ticket is to pull out the drive train and camera configurations from complete.py and and put them into methods that can be called from any template.  Then make those calls in the following templates;
- basic.py
- complete.py
- cv_control.py
- path_follow.py
- just_drive.py (drivetrain only)

The benefit here is that these lesser used templates become more broadly applicable to the various kinds of donkeycars that can be built.  If you look at these templates, you can see the cover a lot of ground in terms of approaches to autonomy.

Ezward, 2022-10-12:
Word done so far
- [x] refactored complete.py to allow code to be shared in https://github.com/autorope/donkeycar/pull/1042
- [x] updated path_follow to use these methods in https://github.com/autorope/donkeycar/pull/1046
- [ ] update the cv_template.py to use use the camera, controller and drivetrain methods from complete.py TBD

Ezward, 2023-03-04:
Completed now that the computer vision template has been merged; Issue https://github.com/autorope/donkeycar/issues/1085 and PR https://github.com/autorope/donkeycar/pull/1091

Closed 2023-03-04.

Thread 956 (2021-11-28):

manage.py drive failing

beeplove, 2021-11-28:
`python manage.py drive` is failing with the following error:

```
using donkey v4.2.1 ...
loading config file: /home/beeplove/mycar/config.py
loading personal config over-rides from myconfig.py
INFO:root:PID: 7160
INFO:root:cfg.CAMERA_TYPE CSIC
cfg.CAMERA_TYPE CSIC
INFO:donkeycar.vehicle:Adding part CSICamera.
Adding part CSICamera.
Starting Donkey Server...... you can now go to jetson-nano.local:8887 to drive your car.
INFO:donkeycar.vehicle:Adding part LocalWebController.
Adding part LocalWebController.
INFO:donkeycar.vehicle:Adding part ThrottleFilter.
Adding part ThrottleFilter.
INFO:donkeycar.vehicle:Adding part PilotCondition.
Adding part PilotCondition.
INFO:donkeycar.vehicle:Adding part RecordTracker.
Adding part RecordTracker.
INFO:donkeycar.vehicle:Adding part DriveMode.
Adding part DriveMode.
INFO:donkeycar.vehicle:Adding part AiLaunch.
Adding part AiLaunch.
INFO:donkeycar.vehicle:Adding part AiRunCondition.
Adding part AiRunCondition.
PWM Steering created
Init ESC
PWM Throttle created
INFO:donkeycar.vehicle:Adding part PWMSteering.
Adding part PWMSteering.
INFO:donkeycar.vehicle:Adding part PWMThrottle.
Adding part PWMThrottle.
Traceback (most recent call last):
  File "manage.py", line 719, in <module>
    meta=args['--meta'])
  File "manage.py", line 681, in drive
    tub_writer = TubWriter(tub_path, inputs=inputs, types=types, metadata=meta)
  File "/home/beeplove/projects/donkeycar/donkeycar/parts/tub_v2.py", line 112, in __init__
    self.tub = Tub(base_path, inputs, types, metadata, max_catalog_len)
  File "/home/beeplove/projects/donkeycar/donkeycar/parts/tub_v2.py", line 28, in __init__
    read_only=read_only)
  File "/home/beeplove/projects/donkeycar/donkeycar/parts/datastore_v2.py", line 249, in __init__
    self._read_contents()
  File "/home/beeplove/projects/donkeycar/donkeycar/parts/datastore_v2.py", line 325, in _read_contents
    self.inputs = json.loads(self.seekeable.readline())
  File "/usr/lib/python3.6/json/__init__.py", line 354, in loads
    return _default_decoder.decode(s)
  File "/usr/lib/python3.6/json/decoder.py", line 339, in decode
    obj, end = self.raw_decode(s, idx=_w(s, 0).end())
  File "/usr/lib/python3.6/json/decoder.py", line 357, in raw_decode
    raise JSONDecodeError("Expecting value", s, err.value) from None
json.decoder.JSONDecodeError: Expecting value: line 1 column 1 (char 0)
```

TCIII, 2021-11-28:
@beeplove,

Processor?
OS?
I am seeing python 3.6 while Rpi Buster is using 3.7.
Are you running a Nano? If so what JP version?

beeplove, 2021-12-03:
I was using the wrong version of TensorFlow.

Ezward, 2021-12-03:
@beeplove can we close this issue?

beeplove, 2021-12-04:
Yes, please

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

Closed 2021-12-03.

Thread 961 (2021-12-03):

Protect LineFollower from None cam_img

Ezward, 2021-12-03:
User anbello is getting an error trying to start the cv_control template.:
```
Traceback (most recent call last):
  File "/home/pi/projects/donkeycar/donkeycar/vehicle.py", line 151, in start
    self.update_parts()
  File "/home/pi/projects/donkeycar/donkeycar/vehicle.py", line 199, in update_parts
    outputs = p.run(*inputs)
  File "./manage.py", line 80, in run
    max_yellow, confidense, mask = self.get_i_color(cam_img)
  File "./manage.py", line 59, in get_i_color
    scan_line = cam_img[iSlice : iSlice + self.scan_height, :, :]
TypeError: 'NoneType' object is not subscriptable
```

My theory is that when the template first starts, the camera is not 'warmed' so it doesn't immediately return an image, which causes the LineFollower to fail.  We should 1) warm the camera (wait until it starts providing frames) 2) protect LineFollower from a None image by just returning.
- Add a check in line 80 of https://github.com/autorope/donkeycar/blob/3297771078ad7d9dd52f6497f55f3f831cd9f31b/donkeycar/templates/cv_control.py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, if cam_img is not None: and put all the the code except for that last return statement inside the if statement.
- Add the camera warming code as in complete.py

Discovered bug: cv_control.py will not run on a headless OS install because it tries to open a window with debug info using opencv.  The fix is to make this debug window optional.

Tasks
- [x] Add camera warming code to PiCamera
- [x] Add camera warming code to Webcam
- [x] Add camera warming code to CISCamera
- [x] Make cv_control.py debug window optional

Testing
- [x] reproduce reported bug in cv_control.py template on Raspberry Pi with 'PICAM' configuration with dev branch (commit a26bb7300e0c6ee348876a08491ee172c169203e)
- [x] verify cv_control.py bug cannot be repeated using fix branch with camera warming fix for PiCamera, 'PICAM' configuration on Raspberry Pi

Note: these tests require installation of 'imgaug' on the donkeycar, which is an optional install `pip install imgaug`
- [x] reproduce newly found bug in 'CROP' image transform configuration in complete.py dev branch (commit a26bb7300e0c6ee348876a08491ee172c169203e) on Raspberry Pi with 'PICAM' camera
- [x] reproduce 'CROP' transform bug in dev branch  (commit a26bb7300e0c6ee348876a08491ee172c169203e) on Jetons Nano 2GB with 'CSIC' camera configuration
- [x] verify complete.py 'CROP' transform bug cannot be repeated using fix branch and PICAM camera on Raspbery Pi
- [ ] verify complete.py 'CROP' transform bug cannot be repeated using fix branch and CSIC camera on Jetson Nano
- [x] verify complete.py 'CROP' transform bug cannot be repeated using fix branch and WEBCAM camera  (not requires optional install of pygame; `sudo apt-get install libsdl2-mixer-2.0-0 libsdl2-image-2.0-0 libsdl2-2.0-0`, `pip install pygame`

- [x] Verify that cv_control.py template can run without debug window on headless OS.  Tested on Raspberry Pi with PICAM configuration and headless Raspberry Pi OS (tested via ssh without HDMI connected)

Ezward, 2021-12-03:
It looks like the picam already handles it's own warming; perhaps it should wait until frames get returned. https://github.com/autorope/donkeycar/blob/3297771078ad7d9dd52f6497f55f3f831cd9f31b/donkeycar/parts/camera.py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

Ezward, 2021-12-03:
The cv_control.py template adds the picamera but NOT in threaded mode  https://github.com/autorope/donkeycar/blob/3297771078ad7d9dd52f6497f55f3f831cd9f31b/donkeycar/templates/cv_control.py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  So that means it is calling the run() method on the camera part.  That method does NOT set self.frame.  It should probably set self.frame and return that if it does not get a frame from the camera.

Ezward, 2021-12-09:
https://github.com/autorope/donkeycar/tree/963-install-jetson-gpio

Ezward, 2021-12-13:
I get a related bug using the complete.py template and a model that uses 'CROP' transformation.  In that case it appears that imgaug get's a None image and becomes unhappy
```
INFO:donkeycar.vehicle:Starting vehicle at 20 Hz
/usr/lib/python3/dist-packages/picamera/encoders.py:544: PiCameraResolutionRounded: frame size rounded up from 160x120 to 160x128
  width, height, fwidth, fheight)))
Traceback (most recent call last):
  File "/home/pi/projects/autorope/donkeycar/donkeycar/vehicle.py", line 154, in start
    self.update_parts()
  File "/home/pi/projects/autorope/donkeycar/donkeycar/vehicle.py", line 202, in update_parts
    outputs = p.run(*inputs)
  File "/home/pi/projects/autorope/donkeycar/donkeycar/pipeline/augmentations.py", line 120, in run
    aug_img_arr = self.augmentations.augment_image(img_arr)
  File "/home/pi/env/lib/python3.7/site-packages/imgaug/augmenters/meta.py", line 766, in augment_image
    type(image).__name__),)
TypeError: %d format: a number is required, not str
INFO:donkeycar.vehicle:Shutting down vehicle and its parts...
```
If I run the fix branch https://github.com/autorope/donkeycar/tree/961-protect-from-empty-camera-image   then the error goes away.  So fixing the camera parts to make sure they return non-none images fixes more than one kind of bug.

Ezward, 2021-12-13:
I was able to repeat the cv_control bug using the current dev branch (commit a26bb7300e0c6ee348876a08491ee172c169203e) .  I then switch the donkeycar project folder to the fix branch, https://github.com/autorope/donkeycar/tree/961-protect-from-empty-camera-image and the error went array.  So this confirms that the issue was with a None image and the fix branch fixes that.  I need to test with CISC camera and Web cam as well.

Ezward, 2021-12-14:
Got the imgaug error on a Jetson Nano with CSIC camera config trying to run a model that uses 'CROP' configuration using the complete.py template and the dev branch;
relevant configuration in myconfig.py:
```
CAMERA_TYPE = "CSIC"   # (PICAM|WEBCAM|CVCAM|CSIC|V4L|D435|MOCK|IMAGE_LIST)
IMAGE_W = 160
IMAGE_H = 120
IMAGE_DEPTH = 3         # default RGB=3, make 1 for mono

TRANSFORMATIONS = ['CROP']
ROI_CROP_TOP = 45               # the number of rows of pixels to ignore on the top of the image
```
`python manage.py drive --type=tflite_linear --model=models/linear_crop_multiply.tflite` results in
```
INFO:donkeycar.vehicle:Starting vehicle at 20 Hz
Traceback (most recent call last):
  File "/home/ed/projects/donkeycar/donkeycar/vehicle.py", line 154, in start
    self.update_parts()
  File "/home/ed/projects/donkeycar/donkeycar/vehicle.py", line 202, in update_parts
    outputs = p.run(*inputs)
  File "/home/ed/projects/donkeycar/donkeycar/pipeline/augmentations.py", line 120, in run
    aug_img_arr = self.augmentations.augment_image(img_arr)
  File "/home/ed/env/lib/python3.6/site-packages/imgaug/augmenters/meta.py", line 766, in augment_image
    type(image).__name__),)
Exception in thread Thread-1:
Traceback (most recent call last):
  File "/usr/lib/python3.6/threading.py", line 916, in _bootstrap_inner
    self.run()
  File "/usr/lib/python3.6/threading.py", line 864, in run
    self._target(*self._args, **self._kwargs)
  File "/home/ed/projects/donkeycar/donkeycar/parts/camera.py", line 174, in update
    self.init_camera()
  File "/home/ed/projects/donkeycar/donkeycar/parts/camera.py", line 169, in init_camera
    self.poll_camera()
  File "/home/ed/projects/donkeycar/donkeycar/parts/camera.py", line 181, in poll_camera
    self.frame = cv2.cvtColor(frame, cv2.COLOR_BGR2RGB)
cv2.error: OpenCV(4.5.4) /tmp/pip-req-build-bbq4c33o/opencv/modules/imgproc/src/color.cpp:182: error: (-215:Assertion failed) !_src.empty() in function 'cvtColor'

TypeError: %d format: a number is required, not str

INFO:donkeycar.vehicle:Shutting down vehicle and its parts...
stopping CSICamera
```

Ezward, 2021-12-17:
https://github.com/autorope/donkeycar/pull/967

Ezward, 2021-12-18:
We are unable to test 'CROP' with CSIC camera on the Jetson Nano because of a bug in imgaug on the Jetson Nano; see [Issue 970](https://github.com/autorope/donkeycar/issues/970).  We can verify that the CSIC camera passes the warm up phase and returns frames.  So the 'CROP' code would work if imgaug worked and given we have confirmed 'CROP' works on RaspberryPi with PICAM and we have not actually changed any 'CROP' code, then we can presume that it would work on the Nano if imgaug is fixed.

Ezward, 2021-12-23:
Merged https://github.com/autorope/donkeycar/pull/967

Closed 2021-12-23.

Thread 970 (2021-12-17):

Installing imgaug on Jetson Nano breaks CSIC camera

Ezward, 2021-12-17:
This has been found using Jetpack 4.6.  In order to use the 'CROP' transformation with an autopilot the imgaug dependency needs to be installed into the environment.  It installs without issue.  however, once installed the CSIC camera will no longer return frames.  This is not an issue in RaspberryPi.  I'm not sure if it is an issue in earlier versions of Jetpack.

Using 'CROP' is a best practice when training an autopilot.  So it is a problem that one of our supported platforms cannot use it. Worse, the error that is produced provides no help in understanding the underlying issue.  We should try to find a fix or work-around for this issue.

- Determine if earlier versions of jetpack also suffer from this issue
- Determine if there is an specific version of imgaug or one of it's dependencies that can be installed to avoid this issue.
- If we can't find a way to make imgaug work then open a issue for implementing CROP and trapezoidal masks that don't use imgaug. There is an alternative library that used to use imgaug but has removed it because of this bug.  It may be a good replacement for us https://github.com/albumentations-team/albumentations#list-of-augmentations

It has also been determined that this breaks training on the nano, since the training code always tries to import imgaug.  If it cannot import then it fails.  If we do the pip install then it gets an runtime illegal instruction error.  So a fix for that, if we don't get the imgaug replaced, is to fix the training code to only import imgaug if it is used.  That may require some mock stub of the imgaug api we use; so if imgaug fails to import then use a mock that warns the user that augmentations are disabled.

Ezward, 2021-12-17:
See this related issue https://github.com/autorope/donkeycar/issues/749

Ezward, 2021-12-20:
when installing imgaug on the nano, I see a series of these errors while it is trying to install
```
WARNING: Discarding https://files.pythonhosted.org/packages/44/ec/4eddbf9d17a917c51fb4ad159aa7137f506681e91ab559cf87d120e1d78d/Shapely-1.7.0.tar.gz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 (from https://pypi.org/simple/shapely/). Command errored out with exit status 1: python setup.py egg_info Check the logs for full command output.
  Using cached Shapely-1.6.4.post2.tar.gz (225 kB)
  Preparing metadata (setup.py) ... error
  ERROR: Command errored out with exit status 1:
   command: /home/ed/env/bin/python -c 'import io, os, sys, setuptools, tokenize; sys.argv[0] = '"'"'/tmp/pip-install-dnuepv9f/shapely_3a52b345fc0746389fb9807cad9cd11a/setup.py'"'"'; __file__='"'"'/tmp/pip-install-dnuepv9f/shapely_3a52b345fc0746389fb9807cad9cd11a/setup.py'"'"';f = getattr(tokenize, '"'"'open'"'"', open)(__file__) if os.path.exists(__file__) else io.StringIO('"'"'from setuptools import setup; setup()'"'"');code = f.read().replace('"'"'\r\n'"'"', '"'"'\n'"'"');f.close();exec(compile(code, __file__, '"'"'exec'"'"'))' egg_info --egg-base /tmp/pip-pip-egg-info-204d_l62
       cwd: /tmp/pip-install-dnuepv9f/shapely_3a52b345fc0746389fb9807cad9cd11a/
  Complete output (11 lines):
  Failed `CDLL(libgeos_c.so.1)`
  Failed `CDLL(libgeos_c.so)`
  Traceback (most recent call last):
    File "<string>", line 1, in <module>
    File "/tmp/pip-install-dnuepv9f/shapely_3a52b345fc0746389fb9807cad9cd11a/setup.py", line 80, in <module>
      from shapely._buildcfg import geos_version_string, geos_version, \
    File "/tmp/pip-install-dnuepv9f/shapely_3a52b345fc0746389fb9807cad9cd11a/shapely/_buildcfg.py", line 167, in <module>
      fallbacks=['libgeos_c.so.1', 'libgeos_c.so'])
    File "/tmp/pip-install-dnuepv9f/shapely_3a52b345fc0746389fb9807cad9cd11a/shapely/_buildcfg.py", line 161, in load_dll
      libname, fallbacks or []))
  OSError: Could not find library geos_c or load any of its variants ['libgeos_c.so.1', 'libgeos_c.so']
  ----------------------------------------
```
I apperas to be looking for geos_c.so.  running this fixes those errors
```
sudo apt-get install libgeos-dev
```
However, it does not fix the camera issue, it still won't startup.

Ezward, 2021-12-20:
This is a simple way to reproduce the but that does not include all the donkeycar code.

```
$ sudo apt-get install libgeos-dev
$ cd ~/projects
$ git clone https://github.com/JetsonHacksNano/CSI-Camera.git
$ cd ~/projects/CSI-Camera
$ rm -rf env
$ python3 -m virtualenv -p python3 env --system-site-packages
created virtual environment CPython3.6.9.final.0-64 in 1417ms
  creator CPython3Posix(dest=/home/ed/projects/CSI-Camera/env, clear=False, no_vcs_ignore=False, global=True)
  seeder FromAppData(download=False, pip=bundle, setuptools=bundle, wheel=bundle, via=copy, app_data_dir=/home/ed/.local/share/virtualenv)
    added seed packages: pip==21.3.1, setuptools==59.2.0, wheel==0.37.0
  activators BashActivator,CShellActivator,FishActivator,NushellActivator,PowerShellActivator,PythonActivator
$ . env/bin/activate
$ python --version
Python 3.6.9

$ python simple_camera.py
nvarguscamerasrc ! video/x-raw(memory:NVMM), width=(int)1280, height=(int)720, format=(string)NV12, framerate=(fraction)60/1 ! nvvidconv flip-method=0 ! video/x-raw, width=(int)1280, height=(int)720, format=(string)BGRx ! videoconvert ! video/x-raw, format=(string)BGR ! appsink
GST_ARGUS: Creating output stream
CONSUMER: Waiting until producer is connected...
GST_ARGUS: Available Sensor modes :
GST_ARGUS: 3264 x 2464 FR = 21.000000 fps Duration = 47619048 ; Analog Gain range min 1.000000, max 10.625000; Exposure Range min 13000, max 683709000;

GST_ARGUS: 3264 x 1848 FR = 28.000001 fps Duration = 35714284 ; Analog Gain range min 1.000000, max 10.625000; Exposure Range min 13000, max 683709000;

GST_ARGUS: 1920 x 1080 FR = 29.999999 fps Duration = 33333334 ; Analog Gain range min 1.000000, max 10.625000; Exposure Range min 13000, max 683709000;

GST_ARGUS: 1640 x 1232 FR = 29.999999 fps Duration = 33333334 ; Analog Gain range min 1.000000, max 10.625000; Exposure Range min 13000, max 683709000;

GST_ARGUS: 1280 x 720 FR = 59.999999 fps Duration = 16666667 ; Analog Gain range min 1.000000, max 10.625000; Exposure Range min 13000, max 683709000;

GST_ARGUS: 1280 x 720 FR = 120.000005 fps Duration = 8333333 ; Analog Gain range min 1.000000, max 10.625000; Exposure Range min 13000, max 683709000;

GST_ARGUS: Running with following settings:
   Camera index = 0
   Camera mode  = 5
   Output Stream W = 1280 H = 720
   seconds to Run    = 0
   Frame Rate = 120.000005
GST_ARGUS: Setup Complete, Starting captures for 0 seconds
GST_ARGUS: Starting repeat capture requests.
CONSUMER: Producer has connected; continuing.
[ WARN:0] global /home/nvidia/host/build_opencv/nv_opencv/modules/videoio/src/cap_gstreamer.cpp (933) open OpenCV | GStreamer warning: Cannot query video position: status=0, value=-1, duration=-1
^CTraceback (most recent call last):
  File "simple_camera.py", line 66, in <module>
    show_camera()
  File "simple_camera.py", line 55, in show_camera
    keyCode = cv2.waitKey(30) & 0xFF
KeyboardInterrupt
GST_ARGUS: Cleaning up
CONSUMER: Done Success
GST_ARGUS: Done Success

$ pip install imgaug
Collecting imgaug
  Using cached imgaug-0.4.0-py2.py3-none-any.whl (948 kB)
Requirement already satisfied: six in /usr/local/lib/python3.6/dist-packages (from imgaug) (1.15.0)
Collecting opencv-python
  Using cached opencv_python-4.5.4.60-cp36-cp36m-manylinux_2_17_aarch64.manylinux2014_aarch64.whl (39.0 MB)
Requirement already satisfied: scipy in /usr/lib/python3/dist-packages (from imgaug) (0.19.1)
Collecting imageio
  Using cached imageio-2.13.3-py3-none-any.whl (3.3 MB)
Collecting scikit-image>=0.14.2
  Using cached scikit_image-0.17.2-cp36-cp36m-linux_aarch64.whl
Collecting Shapely
  Using cached Shapely-1.8.0-cp36-cp36m-linux_aarch64.whl
Requirement already satisfied: numpy>=1.15 in /usr/local/lib/python3.6/dist-packages (from imgaug) (1.19.4)
Requirement already satisfied: matplotlib in /usr/lib/python3/dist-packages (from imgaug) (2.1.1)
Collecting Pillow
  Using cached Pillow-8.4.0-cp36-cp36m-manylinux_2_17_aarch64.manylinux2014_aarch64.whl (3.0 MB)
Collecting tifffile>=2019.7.26
  Using cached tifffile-2020.9.3-py3-none-any.whl (148 kB)
Collecting PyWavelets>=1.1.1
  Using cached PyWavelets-1.1.1-cp36-cp36m-manylinux2014_aarch64.whl (4.3 MB)
Collecting networkx>=2.0
  Using cached networkx-2.5.1-py3-none-any.whl (1.6 MB)
Collecting scipy
  Using cached scipy-1.5.4-cp36-cp36m-manylinux2014_aarch64.whl (24.5 MB)
Collecting decorator<5,>=4.3
  Using cached decorator-4.4.2-py2.py3-none-any.whl (9.2 kB)
Installing collected packages: Pillow, decorator, tifffile, scipy, PyWavelets, networkx, imageio, Shapely, scikit-image, opencv-python, imgaug
  Attempting uninstall: decorator
    Found existing installation: decorator 4.1.2
    Not uninstalling decorator at /usr/lib/python3/dist-packages, outside environment /home/ed/projects/CSI-Camera/env
    Can't uninstall 'decorator'. No files were found to uninstall.
  Attempting uninstall: scipy
    Found existing installation: scipy 0.19.1
    Not uninstalling scipy at /usr/lib/python3/dist-packages, outside environment /home/ed/projects/CSI-Camera/env
    Can't uninstall 'scipy'. No files were found to uninstall.
Successfully installed Pillow-8.4.0 PyWavelets-1.1.1 Shapely-1.8.0 decorator-4.4.2 imageio-2.13.3 imgaug-0.4.0 networkx-2.5.1 opencv-python-4.5.4.60 scikit-image-0.17.2 scipy-1.5.4 tifffile-2020.9.3
(env) ed@diydonkeybot:~/projects/CSI-Camera$ python simple_camera.py
nvarguscamerasrc ! video/x-raw(memory:NVMM), width=(int)1280, height=(int)720, format=(string)NV12, framerate=(fraction)60/1 ! nvvidconv flip-method=0 ! video/x-raw, width=(int)1280, height=(int)720, format=(string)BGRx ! videoconvert ! video/x-raw, format=(string)BGR ! appsink
Unable to open camera
```

Ezward, 2021-12-20:
Here's a twist; I can reproduce the bug without installing imgaug.  Just install opencv-python:
```
$ cd ~/projects/CSI-Camera
$ rm -rf env
$ python3 -m virtualenv -p python3 env --system-site-packages
created virtual environment CPython3.6.9.final.0-64 in 1169ms
  creator CPython3Posix(dest=/home/ed/projects/CSI-Camera/env, clear=False, no_vcs_ignore=False, global=True)
  seeder FromAppData(download=False, pip=bundle, setuptools=bundle, wheel=bundle, via=copy, app_data_dir=/home/ed/.local/share/virtualenv)
    added seed packages: pip==21.3.1, setuptools==59.2.0, wheel==0.37.0
  activators BashActivator,CShellActivator,FishActivator,NushellActivator,PowerShellActivator,PythonActivator
$ . env/bin/activate
$ python simple_camera.py
nvarguscamerasrc ! video/x-raw(memory:NVMM), width=(int)1280, height=(int)720, format=(string)NV12, framerate=(fraction)60/1 ! nvvidconv flip-method=0 ! video/x-raw, width=(int)1280, height=(int)720, format=(string)BGRx ! videoconvert ! video/x-raw, format=(string)BGR ! appsink
GST_ARGUS: Creating output stream
CONSUMER: Waiting until producer is connected...
GST_ARGUS: Available Sensor modes :
GST_ARGUS: 3264 x 2464 FR = 21.000000 fps Duration = 47619048 ; Analog Gain range min 1.000000, max 10.625000; Exposure Range min 13000, max 683709000;

GST_ARGUS: 3264 x 1848 FR = 28.000001 fps Duration = 35714284 ; Analog Gain range min 1.000000, max 10.625000; Exposure Range min 13000, max 683709000;

GST_ARGUS: 1920 x 1080 FR = 29.999999 fps Duration = 33333334 ; Analog Gain range min 1.000000, max 10.625000; Exposure Range min 13000, max 683709000;

GST_ARGUS: 1640 x 1232 FR = 29.999999 fps Duration = 33333334 ; Analog Gain range min 1.000000, max 10.625000; Exposure Range min 13000, max 683709000;

GST_ARGUS: 1280 x 720 FR = 59.999999 fps Duration = 16666667 ; Analog Gain range min 1.000000, max 10.625000; Exposure Range min 13000, max 683709000;

GST_ARGUS: 1280 x 720 FR = 120.000005 fps Duration = 8333333 ; Analog Gain range min 1.000000, max 10.625000; Exposure Range min 13000, max 683709000;

GST_ARGUS: Running with following settings:
   Camera index = 0
   Camera mode  = 5
   Output Stream W = 1280 H = 720
   seconds to Run    = 0
   Frame Rate = 120.000005
GST_ARGUS: Setup Complete, Starting captures for 0 seconds
GST_ARGUS: Starting repeat capture requests.
CONSUMER: Producer has connected; continuing.
[ WARN:0] global /home/nvidia/host/build_opencv/nv_opencv/modules/videoio/src/cap_gstreamer.cpp (933) open OpenCV | GStreamer warning: Cannot query video position: status=0, value=-1, duration=-1
^CTraceback (most recent call last):
  File "simple_camera.py", line 66, in <module>
    show_camera()
  File "simple_camera.py", line 55, in show_camera
    keyCode = cv2.waitKey(30) & 0xFF
KeyboardInterrupt
GST_ARGUS: Cleaning up
CONSUMER: Done Success
GST_ARGUS: Done Success

$ pip install opencv-python
Collecting opencv-python
  Using cached opencv_python-4.5.4.60-cp36-cp36m-manylinux_2_17_aarch64.manylinux2014_aarch64.whl (39.0 MB)
Requirement already satisfied: numpy>=1.19.3 in /usr/local/lib/python3.6/dist-packages (from opencv-python) (1.19.4)
Installing collected packages: opencv-python
Successfully installed opencv-python-4.5.4.60

$ python simple_camera.py
nvarguscamerasrc ! video/x-raw(memory:NVMM), width=(int)1280, height=(int)720, format=(string)NV12, framerate=(fraction)60/1 ! nvvidconv flip-method=0 ! video/x-raw, width=(int)1280, height=(int)720, format=(string)BGRx ! videoconvert ! video/x-raw, format=(string)BGR ! appsink
Unable to open camera
```

Ezward, 2021-12-20:
I've been able to repeat this bug with the base Jetpack 4.6 python which is python3.6.9, and with python3.7.5 and python3.8.0

Ezward, 2021-12-20:
It works 'out-of-the-box' with no virtual environment, so this is what it is using for opencv:
```
ed@diydonkeybot:~/projects/CSI-Camera$ python3
Python 3.6.9 (default, Dec  8 2021, 21:08:43)
[GCC 8.4.0] on linux
Type "help", "copyright", "credits" or "license" for more information.
>>> import cv2
>>> print(cv2)
<module 'cv2' from '/usr/lib/python3.6/dist-packages/cv2/python-3.6/cv2.cpython-36m-aarch64-linux-gnu.so'>
>>> print(cv2.__version__)
4.1.1
```

Ezward, 2021-12-20:
this works in the virtual environment is we don't try to install opencv-python
```
ed@diydonkeybot:~/projects/CSI-Camera$ rm -rf env
ed@diydonkeybot:~/projects/CSI-Camera$ python3 -m virtualenv -p python3 env --system-site-packages
created virtual environment CPython3.6.9.final.0-64 in 1291ms
  creator CPython3Posix(dest=/home/ed/projects/CSI-Camera/env, clear=False, no_vcs_ignore=False, global=True)
  seeder FromAppData(download=False, pip=bundle, setuptools=bundle, wheel=bundle, via=copy, app_data_dir=/home/ed/.local/share/virtualenv)
    added seed packages: pip==21.3.1, setuptools==59.2.0, wheel==0.37.0
  activators BashActivator,CShellActivator,FishActivator,NushellActivator,PowerShellActivator,PythonActivator
ed@diydonkeybot:~/projects/CSI-Camera$ . env/bin/activate
(env) ed@diydonkeybot:~/projects/CSI-Camera$ python --version
Python 3.6.9
(env) ed@diydonkeybot:~/projects/CSI-Camera$ python simple_camera.py
nvarguscamerasrc ! video/x-raw(memory:NVMM), width=(int)1280, height=(int)720, format=(string)NV12, framerate=(fraction)60/1 ! nvvidconv flip-method=0 ! video/x-raw, width=(int)1280, height=(int)720, format=(string)BGRx ! videoconvert ! video/x-raw, format=(string)BGR ! appsink
GST_ARGUS: Creating output stream
CONSUMER: Waiting until producer is connected...
GST_ARGUS: Available Sensor modes :
GST_ARGUS: 3264 x 2464 FR = 21.000000 fps Duration = 47619048 ; Analog Gain range min 1.000000, max 10.625000; Exposure Range min 13000, max 683709000;

GST_ARGUS: 3264 x 1848 FR = 28.000001 fps Duration = 35714284 ; Analog Gain range min 1.000000, max 10.625000; Exposure Range min 13000, max 683709000;

GST_ARGUS: 1920 x 1080 FR = 29.999999 fps Duration = 33333334 ; Analog Gain range min 1.000000, max 10.625000; Exposure Range min 13000, max 683709000;

GST_ARGUS: 1640 x 1232 FR = 29.999999 fps Duration = 33333334 ; Analog Gain range min 1.000000, max 10.625000; Exposure Range min 13000, max 683709000;

GST_ARGUS: 1280 x 720 FR = 59.999999 fps Duration = 16666667 ; Analog Gain range min 1.000000, max 10.625000; Exposure Range min 13000, max 683709000;

GST_ARGUS: 1280 x 720 FR = 120.000005 fps Duration = 8333333 ; Analog Gain range min 1.000000, max 10.625000; Exposure Range min 13000, max 683709000;

GST_ARGUS: Running with following settings:
   Camera index = 0
   Camera mode  = 5
   Output Stream W = 1280 H = 720
   seconds to Run    = 0
   Frame Rate = 120.000005
GST_ARGUS: Setup Complete, Starting captures for 0 seconds
GST_ARGUS: Starting repeat capture requests.
CONSUMER: Producer has connected; continuing.
[ WARN:0] global /home/nvidia/host/build_opencv/nv_opencv/modules/videoio/src/cap_gstreamer.cpp (933) open OpenCV | GStreamer warning: Cannot query video position: status=0, value=-1, duration=-1
^CTraceback (most recent call last):
  File "simple_camera.py", line 66, in <module>
    show_camera()
  File "simple_camera.py", line 52, in show_camera
    ret_val, img = cap.read()
KeyboardInterrupt
GST_ARGUS: Cleaning up
CONSUMER: Done Success
GST_ARGUS: Done Success
(env) ed@diydonkeybot:~/projects/CSI-Camera$ python
Python 3.6.9 (default, Dec  8 2021, 21:08:43)
[GCC 8.4.0] on linux
Type "help", "copyright", "credits" or "license" for more information.
>>> import cv
Traceback (most recent call last):
  File "<stdin>", line 1, in <module>
ModuleNotFoundError: No module named 'cv'
>>> import cv2
>>> print(cv2.__version__)
4.1.1
```

Ezward, 2021-12-20:
Thanks @TCIII for finding this issue in the imgaug github, https://github.com/aleju/imgaug/issues/737

That indicated that the pip wheel install of imgaug will install opencv-python.  My own testing above shows this will conflict with the Jetpack opencv and will cause the camera error.

So I'm going to trying installing from source as indicated in that imgaug issue.
```
pip install imgaug --no-binary imgaug
```

Ezward, 2022-01-09:
The maintainer of the imgaug library has said they will not fix their installer.  So we should implement our augmentations another way.  There is an alternative library that used to use imgaug but has removed it because of this bug.  It may be a good replacement for us https://github.com/albumentations-team/albumentations#list-of-augmentations

Ezward, 2022-01-15:
[PR #978](https://github.com/autorope/donkeycar/pull/978) is a temporary workaround (read HACK) that mocks out the augmentations if imgaug dependency is not installed.  It is not installed by default on the Nano.  So this will prevent the camera issue.  It warns the user at runtime if they use a configuration that utilized augmentations.

## This temporary hack should be removed when we replace the imaug library with another implemenation.

naisy, 2022-01-25:
@Ezward You can uninstall opencv-python after installing imgaug 0.4.0

In my Dockerfile:
```
########################################
# imgaug 0.4.0
########################################
RUN  . ~/.virtualenv/$DONKEY_VERSION/bin/activate \
    && pip install six numpy scipy Pillow matplotlib scikit-image imageio Shapely \
    && pip install --no-dependencies imgaug \
    && pip install imagecorruptions \
    && pip uninstall -y opencv-python
```

Ezward, 2023-03-08:
see PR https://github.com/autorope/donkeycar/pull/1111

Ezward, 2023-03-22:
Replace imgaug with augmentations.  PR https://github.com/autorope/donkeycar/pull/1111

Closed 2023-03-22.

Thread 984 (2022-01-20):

The Jetson Nano will be able to provide the necessary GPIO pin support?

Anton890304, 2022-01-20:
Hi!
The official instructions for the latest release of Donkeycar  is written: "The Jetson Nano does not provide the necessary GPIO pin support". https://docs.donkeycar.com/parts/rc/

However, I saw the Jetson.GPIO Python library, which promises API support as RPi.GPIO on the Jetson community page. https://forums.developer.nvidia.com/t/pigpio-support-on-nano/74744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

I have little skills in Python, and I still can't find a solution to this issue. I just want to ask you.

Does this mean that there will be a donkey car - dev. version where we can connect the RC receiver directly to the GPIO on Jetson Nano?

adricl, 2022-01-26:
Donkeycar on the jetson nano talks to the PCA9685 via the i2c gpio pins. You don't need the gpio interface as the jetson exposes these pins via the Linux i2c kernel interface.

Ezward, 2022-02-07:
Output on the Jetson GPIO works.  PWM works if you enable hardware PWM, so you can drive motors; see the docs https://docs.donkeycar.com/parts/pins/#generating-pwm-from-the-jetson-nano  Input, like reading encoders, does not work well; in that case use an arduino to read the encoders.  This branch implements that; https://github.com/autorope/donkeycar/tree/921-next-generation-odometer-parts  We hope to have the merges in a couple of weeks (at Feb 19 2022 race if we can).

Ezward, 2022-02-07:
@Anton890304 please let us know if this answers your question.  We would like to close this issue.

Ezward, 2022-02-12:
A little more background on the jetson GPIO issue.  TLDR; fix requires a pull request in Jetson.GPIO library.

Jetson.GPIO
- Jetson.GPIO works for well for output pins.
- For PWM pins you must go through the process on enabling hardward PWM, then you can get PWM signals on two pins.
- Input pins work fine in polled mode.
- Input pins work fine in interrupt mode IFF your are only running on Python's main thread (so no background threads) AND if your callback function never throw and exception. I have tested interrupt driven input pins successfully in several contexts;
  - In ROS (specifically on a Duckietown DuckieBot) I have successfully read two mono-encoders using interrupts.  The ROS node is running it's own process and so the Python code is not threaded; it is dedicated to just publishing the ticks it gets based on the interrupt callbacks.
  - In Donkeycar the pins.py self test can be configured to use an interrupt to read a pin.  I have attached this to the input of high resolution (350 ppr) wheel encoders successfully.  In this case the self test is not threaded.
  - In Donkeycar the tachometer.py self test can be configured to use an encoder that reads a GPIO using the pins.py api and an interrupt driven input pin.  This works well.  In this case the self test is not thread.
- Input pins in interrupt mode do not work at all in the general Donkeycar framework.  Specifically I cannot get tachometer.py to work, even though the self test works.  What happens is that it will get one callback successfully then never get any other callbacks.  I believe this is because of all the other threaded parts.  Having read the code, I think there are bugs in the Jetson.GPIO that cause the thread that reads the GPIO bail out if 1) the callback causes any exception 2) it gets a thread interrupt at an inopportune time. In either of these cases the thread will get killed an no callbacks will get called anymore.  So I think this happens in the donkey environment because we have a lot of background threads and so the GPIO thread is receiving thread interrupts, which it is not handling gracefully.  The Jetsion.GPIO thread is basically a state machine and if it get's interrupted at the wrong time the state get's messed up.
- No one seems to be working on Jetson.GPIO at the moment.  I think it would not take much effort to protect the GPIO thread so it worked in the donkey environment.  That would require a pull request.
- For now I added an Arduino Nano to my robot and use it to read the quadrature encoders and it works great.

Anton890304, 2022-02-13:
@Ezward Thank you very much for your detailed answer!

Closed 2022-02-07.

Thread 989 (2022-02-07):

Steering does not work when using drive , but does in calibration .  Earlier commit works .

c1505, 2022-02-07:
#### Issue description
Steering does not work when using drive , but does in calibration and it works when using an earlier commit.  Seeing that another person in discord reported the same problem and that [downgrading to 4.2.1 fixed it](https://discord.com/channels/662098530411741184/671604048218292233/935889345460699176) , I tried a more recent commit `d5b91301ff904873e70b9caba72823fe3454feb6`.  It fixed the problem.  I am using a Jetson nano 2gb and the other person has a raspberry pi so it seems to not be related to the particular board used.  I went back and reinstalled dev and created a new car to make sure that the problem replicated for me before opening this issue.

#### Steps to reproduce the issue

1.  Follow software setup as described here for the [jetson nano ](https://docs.donkeycar.com/guide/robot_sbc/setup_jetson_nano/)
2. create donkeycar from template
3. perform calibration and modify myconfig.py
4. changes to myconfig.py for my car
```
PCA9685_I2C_BUSNUM = 1
CAMERA_TYPE = "CSIC"   # (PICAM|WEBCAM|CVCAM|CSIC|V4L|D435|MOCK|IMAGE_LIST)
IMAGE_W = 224
IMAGE_H = 224
PCA9685_I2C_BUSNUM = 1
STEERING_LEFT_PWM = 460         #pwm value for full left steering
STEERING_RIGHT_PWM = 260        #pwm value for full right steering
THROTTLE_FORWARD_PWM = 420      #pwm value for max forward throttle
THROTTLE_STOPPED_PWM = 370      #pwm value for no movement
THROTTLE_REVERSE_PWM = 320      #pwm value for max reverse throttle
```
5. initiate driving from the car folder `python manage.py drive`
6. navigate to browser
7. press j multiple times to try to turn wheels left
8. press k multiple times to try to turn wheels right
9. also tested on mobile with the touch interface

#### What's the expected result?

- wheels turn

#### What's the actual result?

- wheels do not turn

#### Additional details / screenshot

- the webrowser UI shows changes to the steering, but no changes happen in the car.  The throttle still works.
- the working commit `d5b91301ff904873e70b9caba72823fe3454feb6` is from December 30th of 2021.  I have not tested other commits yet.  I figured that someone more familiar with the code would be able to narrow down where the problem originated better than me.
- the jetson nano install instructions is the only one that says to install from `dev`.  The rest say to install from master which seems like it is the same as the most recent release and I am assuming would have also worked for me.
- Should the docs say to install from `dev` or `master` for the jetson nano and what should it be for the other devices? @Ezward it looks like you made that change . If you could provide feedback, that would be helpful.

Ezward, 2022-02-07:
So that change got made to docs because we almost always tell folks to use dev when they have a problem.  However, I believe you have found a pretty big bug in dev; we have duplicated this in another branch that branched from dev.  As a work around, I think the I2C_SERVO drivetrain will work; it worked in that other branch.  Thanks for reporting this bug.

Ezward, 2022-02-07:
I'm going to revert that change to docs because it will lead folks to a bad experience.

c1505, 2022-02-08:
Thanks for the fast response @Ezward .  This is a really cool project!  I appreciate the work you all are doing improving it and keeping it going 🥇

TCIII, 2022-02-08:
@c1505

I am a DC Maintainer and have duplicated your issue using DRIVE_TRAIN_TYPE = "PWM_STEERING_THROTTLE" with both a gamepad (PS4) and the webui when running the 'path_follow.py' template.
I have throttle control, but no steering control.
If I set DRIVE_TRAIN_TYPE = "I2C_SERVO" I have throttle and steering control with both the gamepad and the webui.

TCIII

Ezward, 2022-02-11:
I believe what is going on here is that the PWM_STEERING_PIN configuration values is used in several DRIVETRAIN_TYPE configurations, each with a different default value.  If you just set the DRIVETRAIN_TYPE = "PWM_STEERING_THROTTLE", but don't uncomment the PWM_STEERING_PIN value, then the default of a different drivetrain get's used.

So a workaround is to just uncomment PWM_STEERING_PIN in the PWM_STEERING_THROTTLE sections.

I will create a real fix and make a pull request for dev.

Ezward, 2022-03-02:
Proposed fix is in this branch.  https://github.com/autorope/donkeycar/tree/989-namespace-drivetrain-configurations  @c1505 Corey if you get a change to try this it would be appreciated.

c1505, 2022-03-02:
@Ezward Thanks !  I'll give it a try today or tomorrow. Want to open a draft PR as well to have the automated tests kick off and to make the changes more easily visible ?

c1505, 2022-03-05:
Sorry I had a busy week and am away this weekend. I will give it a shot Monday.  Thanks again for the fix!

BrianHenryIE, 2022-03-07:
I tried:

```
git checkout -b 989-namespace-drivetrain-configurations origin/989-namespace-drivetrain-configurations
```

with no other changes and it did not work.

> just uncomment PWM_STEERING_PIN in the PWM_STEERING_THROTTLE sections.

That worked. Thank you.

Ezward, 2022-03-07:
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
@BrianHenryIE can you give me a little more info on this; what did you do?  Did you create a new mycar?  Did you update your prior mycar using `donkey createcar --overwrite --path <yourcar>`?  Did it fail the exact same way or a different way?
Thanks

BrianHenryIE, 2022-03-07:
I did not create a new mycar, nor did I update. (my existing mycar was vanilla – I had reinstalled from scratch as I tried to troubleshoot).

The fail was in the same way, i.e. no error message, just no working steering when launched.

Ezward, 2022-03-07:
> I did not create a new mycar, nor did I update. (my existing mycar was vanilla – I had reinstalled from scratch as I tried to troubleshoot).
>
> The fail was in the same way, i.e. no error message, just no working steering when launched.

Ok, then it failed because there was no change to myconfig.py; so it failed in the same way.  The issue is with how myconfig.py was being generated (with duplicate values in different sections).  Thank you for the details.

Ezward, 2022-06-17:
Yes, need to update docs to instruct user to uncomment the entire dictionary block for the chosen drivetrain.  What would be better is that they are just uncommented to start, since they do not conflict.  Then setting the DRIVETRAIN_TYPE will just choose the right one.  I'll look and see if we can do that.

Closed 2022-10-12.

Thread 991 (2022-03-06):

Add gps part and integrate into path_follow template

Ezward, 2022-03-06:
The path follow template is currently dedicated to the T265 tracking camera.  We would like to make it a more general localization template.  We are also running outdoor races now, so the perfect addition would be a gps part that can produce positions in meters.
- [x] create gps part that can produced timestamped positions in meters
- [x] Integrate the gps readings into the path follow template
  - [x] use gps positions as pos/x and pos/y
  - [x] create a mode in path_follow to record waypoints that allows capturing of multiiple gps positions, then calculates a centroid and guassian.   Recording of the waypoint as a centroid and a  guassian, so we can use the probability to decide if we have reached the endpoint.
- [x] merge into main branch (see  https://github.com/autorope/donkeycar/issues/991#issuecomment-1242763724)
  - [x] https://github.com/autorope/donkeycar/pull/1042
  - [x] https://github.com/autorope/donkeycar/pull/1046

Ezward, 2022-03-06:
Here is a pull request for the gps part https://github.com/autorope/donkeycar/pull/992

Ezward, 2022-06-25:
There is more work on gps in this branch; https://github.com/autorope/donkeycar/tree/921-path-follow-in-simulator.  We've added another [gps part](https://github.com/autorope/donkeycar/blob/050009fbf09675e5034bbe04763187ca234528db/donkeycar/parts/gps.py#L18)  which delivers the most recent position reading, rather the list of readings since the last update.  This is then integrated into the [path follow](https://github.com/autorope/donkeycar/blob/050009fbf09675e5034bbe04763187ca234528db/donkeycar/templates/path_follow.py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) template.   I've gotten a standard donkeycar (Ackerman steering, servo/esc) to do a shitty job of recording and following a path, but it does follow it.  The path looks correct; I probably just need better PID parameters.

Ezward, 2022-06-25:
I have the gps following the path (still need to do a better job on PID, but it is clearly following the line), but it get's lost when it get's back to the start.  This gives a little insight.  The only device that does not get lost when it get's back to the start is the T265; I believe that is because the T265 has loop closure build into it's algorithm.  So we need to fix this; if we are back at the origin point then we should restart the path explicitly.

Ezward, 2022-06-25:
Here is an issue to improve the path recording and path follow.  https://github.com/autorope/donkeycar/issues/1025

Ezward, 2022-09-10:
Path follow with GPS has been successfully implemented and tested.  Now it is time to get it merged into main.

This is the branch used to implement path follow [921-gps-logger](https://github.com/autorope/donkeycar/tree/921-gps-logger).  You can see it is 129 commits ahead of main.  So there are a lot of changes to make this work.  We need a set of staged PRs to get this into main and have each stage small enough to be testable.

1. Refactor complete.py and pull out the code that adds camera, drive train, game controller, odometry/imu, and simulator into their own methods that are then called by the `drive()` method.
    - this makes the drive method much shorter and easier to read
    - this makes it clear where to change code when modifying any of these parts
    - this makes is possible to share these methods with other templates.  In particular we want to the path_follow template to use these methods so it can support all cameras and drivetrains, rather than the specific camera and drivetrain is supports now.
    - This work is done in this branch [Refactor-templates-to-share-common-parts](https://github.com/autorope/donkeycar/tree/Refactor-templates-to-share-common-parts).  A pull request will be opened.  This needs to be tested; since it makes changes to the complete.py template, which is the template basically everyone uses, we need to make sure it does not break anything.

2. The GPS part has also been refactored to pull out the code that reads from the serial port.  This can be pulled out as it's own branched and merged.
    - This simplifies the GPS part so it only deals with parsing NMEA sentences.
    - This makes the part much more testable, since we can simply submit NMEA sentences to it to test it.
    - A new part has been created that will read lines from the serial port.  This can be used by any part that needs to read data from a serial port.  This means we don't need to include serial port code in every part that uses a serial port. Rather, this new part reads from the serial port and the parts that want to consume that lines get them from vehicle memory.
    - Open another PR that updates the GPS part and associated parts; the serial_port.py part and get that merged.

3. Complete the process by updating the path_follow.py template to use the new GPS part as a source of pose estimates.
    - Use GPS pose estimates this to record waypoints.
    - Use GPS pose estimates to calculate cross-track error and follow the path.
    - The user experience is designed to be like the complete.py template; there is a data acquisition phase (record waypoints) and an autopilot phase (follow the path).

Ezward, 2022-10-10:
See Pull Request https://github.com/autorope/donkeycar/pull/1046

Ezward, 2023-01-15:
Merged

Closed 2023-01-15.

Thread 996 (2022-03-09):

JPG files don't recording in the data folder

Anton890304, 2022-03-09:
I found the issue in Donkey Car version 4.3.5 from the dev branch. Dataset writing doesn't work. JPG files don't recording in the data folder.
In the Donkey Car web interface, the (Start Recording [r]) button doesn't  switch to recording mode. At that time in the JupyterLab terminal I see only: `INFO:donkeycar.parts.web_controller.web:{'recording': False}`
When toggling recording on/off on the gamepad in the JupyterLab terminal, I see only: `recording: False`

- Hardware - JetsonNano
- myconfig.py parameter `AUTO_RECORD_ON_THROTTLE = True`

DocGarbanzo, 2022-03-15:
Hi @Anton890304, are you also driving? Because you will only record images when you use throttle. Also, what do you mean by JupyterLab terminal?

Anton890304, 2022-03-16:
> Привет @Anton890304 , ты тоже за рулем? Потому что вы будете записывать изображения только при использовании газа. Кроме того, что вы подразумеваете под терминалом JupyterLab?

I push the throttle, but recording doesn't work.
Yes i use JupyterLab + web interface - :8887/drive

Anton890304, 2022-03-16:
@DocGarbanzo
I push the throttle, but recording doesn't work.
Yes i use JupyterLab + web interface - :8887/drive

BrianHenryIE, 2022-03-20:
I have the same issue on a fresh Donkey install on Jetson Nano (not a fresh Ubuntu install).

Same problem existed with PS4 controller, but this output is web controller. The only changes in `myconfig.py` are the camera and `PCA9685_I2C_BUSNUM = 1`.

```
(env) brian@briannano:~/projects/donkeycar$ python ~/mycar/manage.py drive
________             ______                   _________      
___  __ \_______________  /___________  __    __  ____/_____ ________
__  / / /  __ \_  __ \_  //_/  _ \_  / / /    _  /    _  __ `/_  ___/
_  /_/ // /_/ /  / / /  ,<  /  __/  /_/ /     / /___  / /_/ /_  /
/_____/ \____//_/ /_//_/|_| \___/_\__, /      \____/  \__,_/ /_/
                                 /____/                      

using donkey v4.3.7 ...
WARNING:donkeycar.parts.pins:pigpio was not imported.
loading config file: /home/brian/mycar/config.py
loading personal config over-rides from myconfig.py
INFO:__main__:PID: 9427
cfg.CAMERA_TYPE CSIC
INFO:__main__:cfg.CAMERA_TYPE CSIC
GST_ARGUS: Creating output stream
CONSUMER: Waiting until producer is connected...
GST_ARGUS: Available Sensor modes :
GST_ARGUS: 3264 x 2464 FR = 21.000000 fps Duration = 47619048 ; Analog Gain range min 1.000000, max 10.625000; Exposure Range min 13000, max 683709000;

GST_ARGUS: 3264 x 1848 FR = 28.000001 fps Duration = 35714284 ; Analog Gain range min 1.000000, max 10.625000; Exposure Range min 13000, max 683709000;

GST_ARGUS: 1920 x 1080 FR = 29.999999 fps Duration = 33333334 ; Analog Gain range min 1.000000, max 10.625000; Exposure Range min 13000, max 683709000;

GST_ARGUS: 1640 x 1232 FR = 29.999999 fps Duration = 33333334 ; Analog Gain range min 1.000000, max 10.625000; Exposure Range min 13000, max 683709000;

GST_ARGUS: 1280 x 720 FR = 59.999999 fps Duration = 16666667 ; Analog Gain range min 1.000000, max 10.625000; Exposure Range min 13000, max 683709000;

GST_ARGUS: 1280 x 720 FR = 120.000005 fps Duration = 8333333 ; Analog Gain range min 1.000000, max 10.625000; Exposure Range min 13000, max 683709000;

GST_ARGUS: Running with following settings:
   Camera index = 0
   Camera mode  = 5
   Output Stream W = 1280 H = 720
   seconds to Run    = 0
   Frame Rate = 120.000005
GST_ARGUS: Setup Complete, Starting captures for 0 seconds
GST_ARGUS: Starting repeat capture requests.
CONSUMER: Producer has connected; continuing.
[ WARN:0] global /home/nvidia/host/build_opencv/nv_opencv/modules/videoio/src/cap_gstreamer.cpp (933) open OpenCV | GStreamer warning: Cannot query video position: status=0, value=-1, duration=-1
INFO:donkeycar.parts.camera:CSICamera opened...
INFO:donkeycar.parts.camera:...warming camera
INFO:donkeycar.parts.camera:CSICamera ready.
INFO:donkeycar.vehicle:Adding part CSICamera.
Starting Donkey Server...... you can now go to briannano.local:8887 to drive your car.
INFO:donkeycar.vehicle:Adding part LocalWebController.
INFO:donkeycar.vehicle:Adding part ThrottleFilter.
INFO:donkeycar.vehicle:Adding part PilotCondition.
INFO:donkeycar.vehicle:Adding part RecordTracker.
INFO:donkeycar.vehicle:Adding part DriveMode.
INFO:donkeycar.vehicle:Adding part AiLaunch.
INFO:donkeycar.vehicle:Adding part AiRunCondition.
INFO:donkeycar.parts.actuator:PWM Steering created
INFO:donkeycar.parts.actuator:Init ESC
INFO:donkeycar.parts.actuator:PWM Throttle created
INFO:donkeycar.vehicle:Adding part PWMSteering.
INFO:donkeycar.vehicle:Adding part PWMThrottle.
Using catalog /home/brian/mycar/data/catalog_0.catalog
INFO:donkeycar.vehicle:Adding part TubWriter.
You can now go to <your hostname.local>:8887 to drive your car.
INFO:donkeycar.vehicle:Starting vehicle at 20 Hz
INFO:tornado.access:304 GET /drive (fe80::c75:5368:eb1a:3d6e%wlan0) 15.38ms
INFO:tornado.access:200 GET /static/jquery-3.1.1.min.js (fe80::c75:5368:eb1a:3d6e%wlan0) 17.98ms
INFO:tornado.access:200 GET /static/nipple.js (fe80::c75:5368:eb1a:3d6e%wlan0) 12.91ms
INFO:tornado.access:200 GET /static/bootstrap/3.3.7/js/bootstrap.min.js (fe80::c75:5368:eb1a:3d6e%wlan0) 13.96ms
INFO:tornado.access:200 GET /static/main.js (fe80::c75:5368:eb1a:3d6e%wlan0) 14.50ms
INFO:tornado.access:200 GET /static/ui/1.12.1/jquery-ui.min.js (fe80::c75:5368:eb1a:3d6e%wlan0) 82.18ms
INFO:tornado.access:101 GET /wsDrive (fe80::c75:5368:eb1a:3d6e%wlan0) 1.96ms
New client connected
^CINFO:donkeycar.vehicle:Shutting down vehicle and its parts...
INFO:donkeycar.parts.camera:Stopping CSICamera
GST_ARGUS: Cleaning up
CONSUMER: Done Success
GST_ARGUS: Done Success
INFO:donkeycar.vehicle:Part Profile Summary: (times in ms)
INFO:donkeycar.vehicle:
+--------------------+------+------+------+------+------+------+-------+
|        part        | max  | min  | avg  | 50%  | 90%  | 99%  | 99.9% |
+--------------------+------+------+------+------+------+------+-------+
|     CSICamera      | 0.46 | 0.02 | 0.03 | 0.03 | 0.04 | 0.07 |  0.19 |
| LocalWebController | 5.26 | 0.04 | 0.08 | 0.05 | 0.13 | 0.61 |  2.42 |
|   ThrottleFilter   | 0.07 | 0.02 | 0.02 | 0.02 | 0.02 | 0.04 |  0.07 |
|   PilotCondition   | 0.08 | 0.01 | 0.01 | 0.01 | 0.02 | 0.04 |  0.07 |
|   RecordTracker    | 0.14 | 0.01 | 0.01 | 0.01 | 0.02 | 0.03 |  0.10 |
|     DriveMode      | 0.17 | 0.02 | 0.02 | 0.02 | 0.03 | 0.05 |  0.16 |
|      AiLaunch      | 0.08 | 0.01 | 0.02 | 0.02 | 0.02 | 0.04 |  0.06 |
|   AiRunCondition   | 0.09 | 0.01 | 0.01 | 0.01 | 0.02 | 0.02 |  0.07 |
|    PWMSteering     | 0.11 | 0.02 | 0.03 | 0.03 | 0.04 | 0.06 |  0.10 |
|    PWMThrottle     | 0.07 | 0.01 | 0.02 | 0.02 | 0.03 | 0.04 |  0.07 |
+--------------------+------+------+------+------+------+------+-------+
(env) brian@briannano:~/projects/donkeycar$ ls -l ~/mycar/data
total 12
-rw-rw-r-- 1 brian brian    0 Mar 20 15:15 catalog_0.catalog
-rw-rw-r-- 1 brian brian  111 Mar 20 15:15 catalog_0.catalog_manifest
drwxrwxr-x 2 brian brian 4096 Mar 20 15:15 images
-rw-rw-r-- 1 brian brian  236 Mar 20 15:15 manifest.json
(env) brian@briannano:~/projects/donkeycar$ ls -l ~/mycar/data/images
total 0
```

The "start recording" button in the web interface never changed (brief flash) when I clicked it:

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

And when I clicked the button on the PS4 controller in an earlier attempt, this was the output:

```
auto record on throttle is enabled.
recording: False
```

Anton890304, 2022-03-21:
@BrianHenryIE
Did you install the Donkey Car following the instructions from [docs.donkeycar.com](https://docs.donkeycar.com/guide/robot_sbc/setup_jetson_nano/) or the instructions from [https://github.com/autorope/donkeycar/blob/main/install/nano/install-jp44.sh](https://github.com/autorope/donkeycar/blob/main/install/nano/install-jp44.sh) ?

I installed Donkey Cart following the instructions https://github.com/autorope/donkeycar/blob/main/install/nano/install-jp44.sh

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

Consequently. I have installed the recommended versions, but the Recording does not work.

**What do you think is the problem?**

BrianHenryIE, 2022-03-21:
The `/jp/v44` on that install .sh file is older than the docs which uses `jp/v45`, so I did not follow that.

For the most part, I did follow docs.donkeycar.com. But, as I said above, I'm trying to add a new part with higher requirements so I did not follow them strictly.

If I were you, I would follow docs.donkeycar.com instructions. It sounds like neither of use followed them properly, so it would be a good way to narrow down was it our own fault.

Best yet, if we export our broken environment with:

```
pip freeze > issue996.txt
```

Then once it is working we can figure what package difference caused the issue.

Ezward, 2022-03-23:
It's possible it is a bug that got added with this pull request https://github.com/autorope/donkeycar/pull/985  That PR was to make the webui and the game controllers play nice together.  There was a lot of state passed around that had to be synchonized; it's possible I messed up the recording state.

Ezward, 2022-03-23:
I think the issue may be with that PR;  line 258 of donkeycar/parts/web_controller/web.py;    [ self.application.recording = data.get('recording', self.application.recording) ](https://github.com/autorope/donkeycar/blob/58979613c723aadf6b2fa98b4a43743e18ab1641/donkeycar/parts/web_controller/web.py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)  should probably be
```
        if data.get('recording') is not None:
            self.application.recording = data['recording']
            self.application.recording_latch = self.application.recording
```

That value is not getting latched, and so it getting overwritten.  @BrianHenryIE  or @Anton890304 Please try making that change and see if it works for you.

Ezward, 2022-04-05:
There is a duplicate of this issue here: https://github.com/autorope/donkeycar/issues/1005

Anton890304, 2022-04-06:
@Ezward Thank you very much))))

Ezward, 2022-04-07:
The fix is employed in this PR https://github.com/autorope/donkeycar/pull/1007 which is now merged.

Closed 2022-04-07.

Thread 998 (2022-03-21):

RuntimeError: This module can only be run on a Raspberry Pi! RPi._GPIO .  Jetson Nano

c1505, 2022-03-21:
## Issue Description
If you upgrade from the last release to the recent one, there is an error that prevents calibration or running the car on the jetson nano.  This shouldn't be a problem for people who are coming from a completely fresh setup or those that were are upgrading from something after December 11th when RPi.GPIO was removed as a dependency for the nano https://github.com/autorope/donkeycar/pull/964/files .

### configurations affected
#### software
* donkeycar 4.3.6 release
* donkeycar main branch.  latest commit `58979613c723aadf6b2fa98b4a43743e18ab1641`
* donkeycar main branch.  possibly all commits after `d5b91301ff904873e70b9caba72823fe3454feb6`

#### hardware
* jetson nano
## Steps to reproduce the issue

* Jetson nano setup as described in docs before the recent release(Install from master rather than main)
```
git checkout master
pip3 install -e .[nano]
```
* Upgrade to the recent release
```
git checkout tags/4.3.6
pip3 install -e .[nano]
```
* Create a new car or upgrade an existing car
* Run calibration or drive

## What's the expected result?
* can calibrate car
* can drive car
## What's the actual result?
* error message for calibration
* error message for drive

## Additional details / error messages
```bash
(env) jetbot@jetbot:~/21mar_release_test$ donkey calibrate --channel 1 --bus=1
________             ______                   _________      
___  __ \_______________  /___________  __    __  ____/_____ ________
__  / / /  __ \_  __ \_  //_/  _ \_  / / /    _  /    _  __ `/_  ___/
_  /_/ // /_/ /  / / /  ,<  /  __/  /_/ /     / /___  / /_/ /_  /
/_____/ \____//_/ /_//_/|_| \___/_\__, /      \____/  \__,_/ /_/
                                 /____/                      

using donkey v4.3.6 ...
Traceback (most recent call last):
  File "/home/jetbot/env/bin/donkey", line 33, in <module>
    sys.exit(load_entry_point('donkeycar', 'console_scripts', 'donkey')())
  File "/home/jetbot/projects/donkeycar/donkeycar/management/base.py", line 614, in execute_from_command_line
    c.run(args[2:])
  File "/home/jetbot/projects/donkeycar/donkeycar/management/base.py", line 239, in run
    from donkeycar.parts.actuator import PCA9685
  File "/home/jetbot/projects/donkeycar/donkeycar/parts/actuator.py", line 13, in <module>
    from donkeycar.parts.pins import OutputPin, PwmPin, PinState
  File "/home/jetbot/projects/donkeycar/donkeycar/parts/pins.py", line 397, in <module>
    import RPi.GPIO as GPIO
  File "/home/jetbot/env/lib/python3.6/site-packages/RPi/GPIO/__init__.py", line 23, in <module>
    from RPi._GPIO import *
RuntimeError: This module can only be run on a Raspberry Pi!
```

## Possible solutions
* @BrianHenryIE mentioned here https://github.com/autorope/donkeycar/issues/772#issuecomment-1060051135 to uninstall RPi.GPIO `pip uninstall RPi.GPIO` .  That fixes this particular problem.
  * Could just close this issue with that known fix for those that are upgrading, make an announcement in the release, mention it in docs
* Add the uninstall line to the install scripts that @Ezward is working on https://github.com/autorope/donkeycar/issues/990
* Find a workaround in the code so that this doesn't try to use ` RPi.GPIO` when it shouldn't on the nano.  For me, it seems to handle it fine on commit `d5b91301ff904873e70b9caba72823fe3454feb6`, but not after.  This seems like probably more work than it is worth to do it this way though.

Ezward, 2022-07-13:
If you are on a nano and you have this bug the workaround is to `pip uninstall RPi.GPIO` and `pip install Jetson.GPIO`.  This is fixed in latest main (4.3.19).  Pi install RPi.GPIO, nano installs Jetson.GPIO.
```
      extras_require={
          'pi': [
              'picamera',
              'Adafruit_PCA9685',
              'adafruit-circuitpython-lis3dh',
              'adafruit-circuitpython-ssd1306',
              'adafruit-circuitpython-rplidar',
              'RPi.GPIO',
              'imgaug'
          ],
          'nano': [
              'Adafruit_PCA9685',
              'adafruit-circuitpython-lis3dh',
              'adafruit-circuitpython-ssd1306',
              'adafruit-circuitpython-rplidar',
              'Jetson.GPIO',
          ],
```

Closed 2022-07-13.

Thread 1001 (2022-03-24):

Donkey Car car app template is monolithic and does not support different car configurations easily

DocGarbanzo, 2022-03-24:
# Replace the car config with a modular user-friendly design

## Issue description
Currently we ship a couple of templates with Donkey Car but for the majority of applications the `complete.py` is used. It contains all possible cameras, drive trains with motor controllers, input controllers, etc, etc. In reality though a user has a car with only one camera type, one drive train, and will likely use only one controller to drive it. For the donkey gym environment we also don't need to support all the different hardware parts as the code runs on the host computer.  We have a separate `simulator.py` template, but I believe this is not used. And there seems to be quite an overlap in duplicated code.

## Proposal
* Scrap the template approach where we provide a monolithic car app, but instead allow a creation of the car app through a simple user-friendly car and part description list in form of a yaml file
* Add a graphical representation of the data flow between input and output data shared between the car part in order to more easily spot inconsistencies if inputs and outputs are not correctly causally connected
* Provide a couple of small standard template files that are easily understandable and which non-sophisticated users are confident to edit, say if they have a standard car, but just want to add a different camera, say the `CvCam` instead of the `PiCamera`.

## Approach
### Car template
Yaml is easy to read and manipulate. Here is a car template for a simple car that uses a mock camera, the web controller and writes data to the tub.
```yaml
parts:
  - mockcamera:
      outputs: [cam/image_array]
      threaded: true
  - localwebcontroller:
      inputs: [cam/image_array, tub/num_records]
      outputs: [user/angle, user/throttle, user/mode, recording]
      threaded: true
  - webfpv:
      inputs: [cam/image_array]
      threaded: true
  - tubwriter:
      arguments:
        inputs: [cam/image_array, user/angle, user/throttle, user/mode]
        types: [image_array, float, float, str]
      inputs: [cam/image_array, user/angle, user/throttle, user/mode]
      outputs: [tub/current_index]
      run_condition: recording
```
### The car builder
The car builder reads the yaml file and creates the car. In addition it also creates a graphical representation of the car as a dot file and renders it. Here is what the above car looks like:

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

Here, the variables that are flowing from outputs to inputs are given through solid lines, and variable that connect from outputs to run conditions are represented by dotted lines. Variables that are output, but don't go anywhere are arriving in the 'Unused' part. Variables that are inputs only are currently missing in the graph. They would create a run time error, I'll add them to the graph to prevent building ill-defined car apps.

### Features
In general we prefer to have a simple template with few `if/else` options, but sometimes you might want to switch on a part or not so we support a field `add_only_if`. In order to connect the template with the configuration parameters we support the syntax `cfg.ABC` in order to access these parameters in the configuration. Lets make the `WebFpv` from above configurable:
```yaml
parts:
  ...
  - webfpv:
      add_only_if: cfg.USE_FPV
      inputs: [cam/image_array]
      threaded: true
  ...
```
Debugging the data flow in the car is easy, let's take the template above and put a typo into the output variable of the web controller: `user/throttle` -> `usr/throttle` and rebuild the car:
```yaml
parts:
  ...
  - localwebcontroller:
      inputs: [cam/image_array, tub/num_records]
      outputs: [user/angle, usr/throttle, user/mode, recording]
      threaded: true
  ...
```
This is the corresponding visualisation:
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
We see, the output `usr/throttle` goes into the `Unused` part. So even before running the car and observing that the recodings will have no throttle values we can see that the template will not work as expected.

### The code
The code requires the donkey parts to be derived from a common interface that register the constructor (by default) or a `create` class function upon class compilation. The `create()` function reads  the config and allow for overwrites, but for simple parts it is not required, because the yaml template allow to pass constructor parameters optionally. In the above example the `WebFpv` was added through a `create` method, but we could alternative add it like:
```yaml
  - webfpv:
      arguments:
        port: cfg.WEB_CONTROL_PORT
        mode: cfg.WEB_INIT_MODE
      inputs: [cam/image_array]
      threaded: true
```
It leads to a cleaner design though to hide the initialisation parameters from the user if these are stored as config parameters. But because the yaml file is a configuration file itself, the users can edit and store for their cars, we could set any such parameters in car config directly, like:
```yaml
  - webfpv:
      arguments:
        port: 8890
        mode: 'user'
      inputs: [cam/image_array]
      threaded: true
```
This would make a lot of configuration parameters obsolete.

### Supporting own user parts
We add a dynamic loading of a `myparts.py` file in the `mycar` directory. This will allow users to write an own Donkey Car part w/o messing with any of the project code, which usually requires having your own GH account, forking the project, etc, etc. I will add a simple example of the required code to drive a single LED from the PCA9685 pwm driver board, which for example, would switch on, once you are in recording mode. The following steps would be required to get this part added:
1) Adding the new part to the yaml file, like:
```yaml
  - led:
      inputs: [recording]
```
And in the `myparts.py`:
```python
class LED(Createable):
  def __init(output_pin=''):
    super().__init(output_pin=output_pin)
    # some more code here

  def run(recording):
     # some code here

  @classmethod
  def create(cls, cfg, kwargs):
    # some code here
```
Because the new part is derived from `Createable`  (the `create()` method is optional) and the yaml entry is well defined, the part would be recognised by the vehicle and it will print in the graphical representation.

Ezward, 2022-03-25:
I really like this direction.  I really like that the user could spin-up a vehicle without needing any Python or even a configuration file.  There a few things to think about.

The yaml approach, without some other support, will require the user to read a lot of python to figure out which parts are available and what are their constructor arguments, inputs and outputs.  The user, who we want to insulate from the needing to know the internals of the Python code, must read each part's python code to know what are the constructor arguments, the run() methods arguments (the inputs) and the run method's return values (the outputs).  So in this model we are actually requiring the user to read the python and pull out this information before they can create their yaml file.  In some ways that is worse than the current situation, which for the most part only requires uncommenting and editing the myconfig.py file.  However, with more documentation and/or tooling we can overcome that issue.

The myconfig.py file is currently a de-facto yellow pages for parts and their configuration.  If a part doesn't have an entry in myconfig.py it may never get used.  If we move this new approach then we won't rely on a monolithic configuration file (and that is good), but how does a user know what parts are available and how to configure them?

- Perhaps we can do some introspection of a part to figure out what the arguments, inputs and outputs are.  All of that would be much easier if we added type annotations to the parts.
- Perhaps we simply maintain a directory of parts.  This could be very simple to implement.  It could be hierarchical; so we can group parts by their uses, independent of what python file they are implemented in.  The directory would define the arguments, inputs and outputs and provide a lot more description that we could get simply by introspection.
- Perhaps we define a comment block format for a part that can then be scraped to provide this information.  That has the advantage that it would keep the documentation with the part. Any author of a new part could simply add this comment part to have their part incorporated into the directory.  We could make this part of a part's code review.
- If we know the constructor arguments and inputs and outputs for a given part, we could create a editor that would allow the user to pick a part and drop it in the vehicle.  I think about how donkey ui could support the entire work flow for donkey car, include vehicle definition and configuration.  Super cool to think about.

How do we handle more than one instance of a part?
- For example we support a 'stereo' camera setup that uses two instances of the camera driver.
- Another example are dual encoders for a differential drive car.
- I've also written a logging part that can log any data in the vehicle memory (so we can dynamically add logging without modifying a part); it would be common to have more than one of these instantiated.
- maybe it is not an issue; we construct the part and add it to the vehicle.  After that we don't address the part directly anyway.  So it may naturally drop out of what you have proposed.

I don't want any of the questions I have raised to diminish how important this proposal is.  Donkeycar is targeted at relatively sophisticated beginners and even they often get stuck.  This approach could open up autonomous racing/robotics to a lot more people and I would think with much less pain.

cfox570, 2022-03-25:
The current monolithic approach is geared towards beginners and those who are not python coders.   The approach should initially be geared towards those who are able to take a deeper dive into the code to build there own parts.

I have prototyped a "template" that uses this method.

- Works with the existing parts and vehicle.py without modification.
- Added an enable property in the yaml so that it is easy to disable the inclusion of a part. But I like the "add_only_if" suggestion as well.
- Supports two instances of a part just like the standard manage.py.
- Can use 'cfg' as a standard way to access the config parameters.
- Moved each of the parts embedded into manage.py parts  separate helper module.

I am using the code below today and have found it great to debugand change part configuration.   Seeing the inputs and outputs all in one place is great as I change the parts in use.

### Here is the YAML:

`
    donkeycar.parts.controller:
        enable: True
        class: LocalWebController
        args:
            port: cfg.WEB_CONTROL_PORT
            mode: cfg.WEB_INIT_MODE
        inputs:  [cam/image_array, tub/num_records]
        outputs: [user/angle, user/throttle, user/mode, recording]
        thread: True

    donkeycar.parts.fx.helpers:
        enable: True
        class: PilotCondition
        args: {}
        inputs:  [user/mode]
        outputs: [run_pilot]

    donkeycar.parts.fx.helpers:
        enable: True
        class: AI_Pilot
        args:
            cfg: cfg
        inputs:  [cam/image_array]
        outputs: [pilot/angle, pilot/throttle]
        run_condition: run_pilot

    donkeycar.parts.launch:
        enable: True
        class: AiLaunch
        args:
            launch_duration: cfg.AI_LAUNCH_DURATION
            launch_throttle: cfg.AI_LAUNCH_THROTTLE
            keep_enabled:    cfg.AI_LAUNCH_KEEP_ENABLED
        inputs: [user/mode, pilot/throttle]
        outputs: [pilot/throttle]

    donkeycar.parts.fx.helpers:
        enable: True
        class: DriveMode
        args:
            cfg: cfg
        inputs:  [user/mode, user/angle, user/throttle, pilot/angle, pilot/throttle]
        outputs: [angle, throttle]

    donkeycar.parts.dgym:
        enable: True
        class: DonkeyGymEnv
        args:
            sim_path: cfg.DONKEY_SIM_PATH
            host:     cfg.SIM_HOST
            env_name: cfg.DONKEY_GYM_ENV_NAME
            conf:     cfg.GYM_CONF
            delay:    cfg.SIM_ARTIFICIAL_LATENCY
        inputs:  [angle, throttle, brake]
        outputs: [cam/image_array]
        thread: True

    donkeycar.parts.tub_v2:
        enable: True
        class: TubWriter
        args:
            base_path: cfg.DATA_PATH
            inputs:   [cam/image_array, user/angle, user/throttle, user/mode]
            types:    [image_array, float, float, str]
            metadata: []
        inputs:  [cam/image_array,user/angle, user/throttle, user/mode]
        outputs: [tub/num_records]
        run_condition: recording

`

### Here is the replacement for manage.py:

`#__________________________________ ASSEMBLE THE VEHICLE________________________

def assemble(cfg):
    #Initialize car
    V = dk.vehicle.Vehicle()

    # Load the YAML file specifying the parts
    with open(cfg.PARTS_PATH) as file:
        try:
            dict = yaml.safe_load(file)
        except yaml.YAMLError as exception:
            logger.error(exception)
            return None

    parts = dict.get("parts")
    if parts is None:
        logger.error("parts.yml is missing the parts key")
        raise Exception()
        
    for mod_name, definition in parts.items():
        # decode definition
        theclass = None
        theargs = None
        theinputs = None
        theoutputs = None
        threaded = None
        theruncondition = None
        enable = None

        for prop, value in definition.items():
#             print(prop,value)
            if prop == 'class':
                theclass = value
            elif prop == 'args':
                for key, dat in value.items():
                    if dat[0:3] == 'cfg':
#                         print (f'{dat}: {eval(dat)}')
                        value[key] = eval(dat)
                theargs = value
            elif prop == 'inputs':
                theinputs = value
            elif prop == 'outputs':
                theoutputs = value
            elif prop == 'thread':
                threaded = value
            elif prop == 'run_condition':
                theruncondition = value
            elif prop == 'enable':
                enable = value
                if not enable:
                    break # stop processing the entry
            else:
                logger.error(f'key "{prop}" is unknown')
                raise Exception()
        
        if enable is None:
            logger.error(f'Definition: enable is missing ')
            raise Exception()
        if not enable:
            continue
        if theclass is None:
            logger.error(f'Definition: the class is missing ')
            raise Exception()    
        if theargs is None:
            logger.error(f'Definition: the args are missing ')
            raise Exception()    
        if theinputs is None:
            logger.error(f'Definition: the inputs are missing ')
            raise Exception()
        if theoutputs is None:
            logger.error(f'Definition: the outputs are missing ')
            raise Exception()
        if threaded is None:
            threaded = False
    
        # import module <mod_name>
        module = importlib.import_module(mod_name)
        logger.info(f'{module.__name__} imported.')

        #create part object from <class_name>
        part_class = getattr(module, theclass)
#         if theargs == None:
#             part = part_class()
#         else:
#             part = part_class(**theargs)
#         part = part_class() if theargs == None else part_class(**theargs)
        part = part_class(**theargs)
        logger.info(f'    {theclass} part created') # from {type(part.super())
#         logger.info(f'      with {theargs}')

        #add part to vehicle
        V.add(part, inputs=theinputs, outputs=theoutputs, threaded=threaded, run_condition=theruncondition)
        logger.info(f'    ... added to vehicle')
#         logger.info(f'    Inputs  {theinputs}')
#         logger.info(f'    Outputs {theoutputs}')

        if theclass == 'MyJoystickController':
            part.set_deadzone(cfg.JOYSTICK_DEADZONE)
            part.print_controls()
   
    return V

#__________________________________ MAIN _________________________________________
if __name__ == '__main__':

    # load configuration and check command line options
    args = docopt(__doc__)
    configuration = dk.load_config(myconfig=args['--myconfig'])
    if args['--type']:
         configuration.DEFAULT_MODEL_TYPE = args['--type']
    if args['--model']:
        configuration.MODEL_PATH = args['--model']

    # assemble vehicle with configuration parameters
    logger.info('\nAssembling vehicle from parts...')
    vehicle = assemble(configuration)
    if vehicle is not None:
        # start the vehicle
        logger.info('Start your engines...')
        vehicle.start(rate_hz=configuration.DRIVE_LOOP_HZ, max_loop_count=configuration.MAX_LOOPS)

    logger.info('Vehicle end.\n')

`

DocGarbanzo, 2022-03-25:
Hi @Ezward and @cfox570,
Thanks for that very detailed feedback, you have really understood the approach and possible problems / shortcomings and non-addressed questions. Let me address all of these items here:

1) Perhaps we can do some introspection of a part to figure out what the arguments, inputs and outputs are. All of that would be much easier if we added type annotations to the parts.
_The arguments are recorded in the factory that registers all parts. They can and will be used in order to facilitate an easy construction, such that the user doesn't have to know them. Type annotations are good, but here we probably need doc strings to explain what they are meant to be. I'm figuring out how to get the docstring arguments passed through. Inputs/outputs are really just string labels to pass the data through the car. We have chosen to use some standard names like `cam/image_array` etc. I was not thinking of restricting them, but we could give it a thought._

2) Perhaps we simply maintain a directory of parts. This could be very simple to implement. It could be hierarchical; so we can group parts by their uses, independent of what python file they are implemented in. The directory would define the arguments, inputs and outputs and provide a lot more description that we could get simply by introspection.
_The parts are all registered in the factory, and through the module structure they form some hierarchy. It would be easier to keep these in sync than adding another hierarchy independently of that. I'd rather suggest to move some parts between files or directories, to create a clear structure. I think the code should be as hierarchical as the parts themselves (cameras, sensors, actuators, etc,)_

3) Perhaps we define a comment block format for a part that can then be scraped to provide this information. That has the advantage that it would keep the documentation with the part. Any author of a new part could simply add this comment part to have their part incorporated into the directory. We could make this part of a part's code review.
_Yes_

4) If we know the constructor arguments and inputs and outputs for a given part, we could create a editor that would allow the user to pick a part and drop it in the vehicle. I think about how donkey ui could support the entire work flow for donkey car, include vehicle definition and configuration. Super cool to think about.
_I obviously thought about this. It could be donkey UI using drop down menus, but I think we can easily reverse engineer a dot graph, so you could draw your vehicle in a graphical app, like dagitty or so (there are also interactive dot builders). We build the yaml from the dot file and then create the car from the yaml. It's possible but requires a bit of research. The donkey UI with drop downs is more straight-forward, I can do this._

5) How do we handle more than one instance of a part?
_You can just repeat any part as often as you want. Each entry creates an own instance (it's a list not a dict)_
```yaml
parts:
  - mockcamera:
      outputs: [cam/image_array_l]
      threaded: true
  - mockcamera:
      outputs: [cam/image_array_r]
      threaded: true
```
@cfox570 - your stuff looks fantastic and clear. It's straight forward and very similar to what I have done. There is one line in your code which doesn't make sense to me (maybe I'm not seeing it):
```python
   part = part_class(cfg)
```
You seem to be passing the config to the part constructor, but most parts have dedicated arguments. However, in my factory based version I do propose to implement a `create` function optionally that takes the `cfg` as an argument. This will hide all kind of intricate lookup and iterative object constructions from the user who simply want's to create the part. Anyway, what you have done is basically the exact same idea in a bit more basic form. And what you are implying is, that with such an approach we don't need a car template python file any longer, as your code above can just be part of the donkey library. Instead a car config is a just a yaml.

Let me know if you want to join me on bringing this into Donkey Car, then I will push my branch into autorope and we can work on that together.

cfox570, 2022-03-25:
I apologize I pasted an older version.  In this version,
```
        part = part_class(**theargs)
```

  Here is the complete code I am currently using below.

I recommend you think about a two stage process.
1. interim version that works with current parts. So we don't need to change everything at once.
2.Long term version that includes introspection.

```
#!/usr/bin/env python3
"""
Assemble and drive a donkeycar.
Parts are specified in parts.yml in the order they need to execute.

Usage:
    ymldriver.py [--myconfig=<filename>] [--model=<model>] [--type=(linear|categorical|tflite_linear|tensorrt_linear)]

Options:
    -h --help               Show this screen.
    --myconfig=filename     Specify myconfig file to use. [default: myconfig.py]
    --model=model           Path to model. The default value is MODEL_PATH in the config file
    --type=type             Type of model. The default value is DEFAULT_MODEL_TYPE in the config file

"""
import logging
import importlib
from docopt import docopt
import donkeycar as dk
import yaml

logger = logging.getLogger(__name__)
logging.basicConfig(level=logging.INFO)

#__________________________________ ASSEMBLE THE VEHICLE________________________

def assemble(cfg):
    #Initialize car
    V = dk.vehicle.Vehicle()

    # Load the YAML file specifying the parts
    with open(cfg.PARTS_PATH) as file:
        try:
            dict = yaml.safe_load(file)
        except yaml.YAMLError as exception:
            logger.error(exception)
            return None

    parts = dict.get("parts")
    if parts is None:
        logger.error("parts.yml is missing the parts key")
        raise Exception()
        
    for mod_name, definition in parts.items():
        # decode definition
        theclass = None
        theargs = None
        theinputs = None
        theoutputs = None
        threaded = None
        theruncondition = None
        enable = None

        for prop, value in definition.items():
#             print(prop,value)
            if prop == 'class':
                theclass = value
            elif prop == 'args':
                for key, dat in value.items():
                    if dat[0:3] == 'cfg':
#                         print (f'{dat}: {eval(dat)}')
                        value[key] = eval(dat)
                theargs = value
            elif prop == 'inputs':
                theinputs = value
            elif prop == 'outputs':
                theoutputs = value
            elif prop == 'thread':
                threaded = value
            elif prop == 'run_condition':
                theruncondition = value
            elif prop == 'enable':
                enable = value
                if not enable:
                    break # stop processing the entry
            else:
                logger.error(f'key "{prop}" is unknown')
                raise Exception()
        
        if enable is None:
            logger.error(f'Definition: enable is missing ')
            raise Exception()
        if not enable:
            continue
        if theclass is None:
            logger.error(f'Definition: the class is missing ')
            raise Exception()    
        if theargs is None:
            logger.error(f'Definition: the args are missing ')
            raise Exception()    
        if theinputs is None:
            logger.error(f'Definition: the inputs are missing ')
            raise Exception()
        if theoutputs is None:
            logger.error(f'Definition: the outputs are missing ')
            raise Exception()
        if threaded is None:
            threaded = False
    
        # import module <mod_name>
        module = importlib.import_module(mod_name)
        logger.info(f'{module.__name__} imported.')

        #create part object from <class_name>
        part_class = getattr(module, theclass)
        part = part_class(**theargs)
        logger.info(f'    {theclass} part created') # from {type(part.super())
        # add part to vehicle
        V.add(part, inputs=theinputs, outputs=theoutputs, threaded=threaded, run_condition=theruncondition)
        logger.info(f'    ... added to vehicle')

        if theclass == 'MyJoystickController':
            part.set_deadzone(cfg.JOYSTICK_DEADZONE)
            part.print_controls()
   
    return V

#__________________________________ MAIN _________________________________________
if __name__ == '__main__':

    # load configuration and check command line options
    args = docopt(__doc__)
    configuration = dk.load_config(myconfig=args['--myconfig'])
    if args['--type']:
         configuration.DEFAULT_MODEL_TYPE = args['--type']
    if args['--model']:
        configuration.MODEL_PATH = args['--model']

    # assemble vehicle with configuration parameters
    logger.info('\nAssembling vehicle from parts...')
    vehicle = assemble(configuration)
    if vehicle is not None:
        # start the vehicle
        logger.info('Start your engines...')
        vehicle.start(rate_hz=configuration.DRIVE_LOOP_HZ, max_loop_count=configuration.MAX_LOOPS)

    logger.info('Vehicle end.\n')

```

cfox570, 2022-03-25:
I would definitely like to help out in developing the code. Let know when you push the branch.

Ezward, 2023-03-04:
@DocGarbanzo I suggest we change this issue to `Allow declarative construction of vehicle`

Thread 1005 (2022-04-03):

4.3.6.1 is not recording data

Ezward, 2022-04-03:
version: tag/4.3.6.1
RaspberryPi 4
Relevant config:
- `CAMERA_TYPE = "PICAM"`
- `DRIVE_TRAIN_TYPE = "PWM_STEERING_THROTTLE"`
- `CONTROLLER_TYPE = 'xbox'`
- `JOYSTICK_MAX_THROTTLE = 1 `
- `AUTO_RECORD_ON_THROTTLE = True`
- `JOYSTICK_DEADZONE = 0.1`
- `RECORD_DURING_AI = False`
- `AUTO_CREATE_NEW_TUB = False`

Ran with a fresh install of 4.3.6.1.  I had auto-save with throttle on; the configuration in myconfig.py that causes recording whenever the throttle is non-zero: `AUTO_RECORD_ON_THROTTLE = True`.  I drove a number of laps to create new data.  during that time I used the 'x' button to delete mistakes.  The results was that it created the catalog and images folder, but collected no data.  **The catalog was zero bytes and the images folder was empty.**

zlite, 2022-04-04:
I'm running 4.3.8 and it's saving the data correctly for me

DocGarbanzo, 2022-04-04:
Thanks @zlite - @Ezward, this is your #989 which fixes it then. That's the only 'real' difference between the two version (i.e. HEAD of main and 4.3.6.1)

Ezward, 2022-04-05:
This is actually a duplicate of another issue and that issue has a proposed fix https://github.com/autorope/donkeycar/issues/996#issuecomment-1075800626

Ezward, 2022-04-05:
> I'm running 4.3.8 and it's saving the data correctly for me

@zlite What controller are you using when you test with 4.3.8?

DocGarbanzo, 2022-04-05:
@Ezward - do you suggest that I should use the patch in #996 in the 4.3.6 branch instead of PR #989? I can do that.

Ezward, 2022-04-07:
The problem is addressed by this pull request https://github.com/autorope/donkeycar/pull/1007 which is now merged.

Ezward, 2022-04-10:
I'm reopening this issue.  I've tested with 4.6.10 after a user complained on discord that this was still broken.  They are correct, AUTO_RECORD_ON_THROTTLE is broken; it does not record when that is True and the game controller is used to drive; it creates the metadata files, but they are zero length and it creates the images folder, but is remains empty.  Also toggling manual recording with the game controller when AUTO_RECORD_ON_THROTTLE is on is broken.  I am able to toggle recording using the webui.  I am unable to toggle recording using the game controller.  It does get the button press, but it will not toggle the mode.  someone had tested the fix and said it worked, but apparently that is not true.  In addition, if I set AUTO_RECORD_ON_THROTTLE = False, the the game controller button says it turned on recording, but it can never toggle it off.  Also in that condition, the game controller never records any data, but the webui will if you use the virtual joypad.  So it is more than toggling the mode that is broken.

Closed 2022-05-03.

Thread 1006 (2022-04-04):

PWM_STEERING_THROTTLE generates I2C errors

zlite, 2022-04-04:
For some reason the new PWM_STEERING_THROTTLE parameter, which replaces `pigpio_pwm` is trying to call the I2C driver, which creates a conflict if that's already being used for the OLED screen. This option should not be using I2C at all AFAIK

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

Ezward, 2022-04-04:
Here is what I think is happening.  We are using some older packages for PCA9685 and newer ones for the OLED screen
```
              'Adafruit_PCA9685',
              'adafruit-circuitpython-lis3dh',
              'adafruit-circuitpython-ssd1306',
```
The older PCA9685 library uses a different dependent library to talk to the I2C bus and I believe it is conflicting with the circuit python library that does the same thing.  There is a newer PCA9685 library that plays nice https://github.com/adafruit/Adafruit_CircuitPython_PCA9685

We probably need to change out our older implementation to the newer one.

Ezward, 2022-04-04:
@zlite can you share your full PWM_STEERING_THROTTLE configuration here?

zlite, 2022-04-06:
I didn't change anything. Just used the defaults (and it failed with that I2C error)

Ezward, 2022-04-06:
>

So @zlite you are using a standard donkeycar with PCA9685 and you have also enabled the OLED `USE_SSD1306_128_32 = False` ?  I'm tryting to get to a place where I can repeat the issue and I'm not there yet.

zlite, 2022-04-06:
No, I'm not using a PC9685. I'm using the RC Hat with the pigpio driver

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

--
◤ CHRIS ANDERSON
     3DR | CEO
     website <https://www.3dr.com/> | linkedin
<https://www.linkedin.com/company/3d-robotics> | twitter
<https://www.twitter.com/3drobotics>

Ezward, 2022-04-06:
@zlite  The defaults in config.py are for a standard donkeycar with PCA9685.  You will want to use the configuration described in`software setup` link.  I used that setup with my RC Hat and it works well.

That being said, the OLED should work on a standard donkeycar with PCA9685 and it seems it does not.  I'll try to reproduce that error on my test rig.

zlite, 2022-04-07:
Okay, now I'm totally confused. This is what the myconfig.py file says:
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

So I did what it said, and used PWM_STEERING_THROTTLE. And then got a lot of I2C (thus PCA9685) errors. Why is an I2C servo driver board part of a GPIO PWM library???  GPIO PWM is supposed to be *instead* of I2C servo boards

Ezward, 2022-04-07:
Output pins can be sourced from GPIO (using either the RPi.GPIO libarary or the PiGPIO) library and/or they can be sourced via a PCA9685.  We use pin specifiers that define where the signal is sourced.  So a pin specifier is a string that specifies 1) the pin source (pin provider) 2) parameters particular to the pin provider 3) the pin number.  so "PCA9685.0:40.1" specifies a pin 1 on the PCA9685 on bus 0 at address 0x40.  "RPI_GPIO.BOARD.13" specifies the a gpio board pin number 13 using the RPi.GPIO library.  "PIGPIO.BWM.12" specifies gpio pin number 13 using Broadcom numbering scheme sourced using the PiGPIO libary.  We may expose output pins in this way via arduino in the future.  A given drive train can source pins in different ways without requiring separate drivers.  That is explained in the docs, but clearly it is a little too hidden.  It can be found here. https://docs.donkeycar.com/parts/pins/

So what would help is if you could attach your configuration that you are using to this issue, then I can provide very specific advice and we can fixup the docs to make sure no one else gets confused (you are not the first by the way, so I know we need to do some work on this).

zlite, 2022-04-07:
My config is attached, which is basically just the default.

I understand that you're saying you've merged the I2C and GPIO modules, and now I should be specifying those pins as follows
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

I can do that, but this whole process has made using PWM quite a bit more complicated (and, as you say, poorly documented)

Isn't there an easier way for people to just specify whether they want to use I2C or GPIO and let the defaults do the rest of the work?

[myconfig.txt](https://github.com/autorope/donkeycar/files/8447068/myconfig.txt)

zlite, 2022-04-08:
BTW, making the above change results in a different conflict (now with my I2C OLED screen:
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

Ezward, 2022-04-09:
The error is saying that there are mixed pin addressing modes in use; Adafruit Blinka is using BCM numbering, the drivetrain is using board number.  You could switch BCM addressing for your drivetrain; that would solve that conflict.  Instead, I would use PiGPIO library for the steering pin and throttle pin output.   You are already using it for input pins for reading the receiver and you would use it if you were reading an encoder, so you should just use it everywhere.  PIGPIO required BCM numbering, so you will need to switch the pin numbers to reflect that addressing scheme.

zlite, 2022-04-10:
Switching to BCM numbering for the PWM output did resolve the OLED problem, but only the steering pin (BCM 13) works and even it has a very different center position from the defaults we had with pigpio (the steering is offset 50% to the left). The throttle pin (18) does not. Both work normally with pigpio on the same pins.
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

Thread 1016 (2022-05-27):

OSError: [Errno 121] Remote I/O error while calibrating

fswalden, 2022-05-27:
When initially calibrating the car, I receive this error "OSError: [Errno 121] Remote I/O error," the meaning of which is unclear to me. I am using a Jetson nano, and the address presented using "sudo i2cdetect -r -y 1" is the same address as the one I put in my myconfig.py folder. Any advice on possible causes or solutions to this problem would be greatly appreciated.

fswalden, 2022-05-27:
Now I'm getting a different error, "RuntimeError: Could not determine default I2C bus for platform." While I might have other issues, it's currently not recognizing that I edited the myconfig.py file. Is there something I could be doing wrong there?

TCIII, 2022-05-28:
@fswalden,

Did you set "PCA9685_I2C_BUSNUM = 1" since you are using a Nano?
If you did and you are still getting the I/O error, then you may have a defective PCA9685 servo controller or a bad I2C connections.

TCIII

fswalden, 2022-05-29:
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

Yeah, I set the bus number and the address number. However, when I look through the error messages and warnings, it seems like it isn't recognizing that. Am I missing something in terms of getting my myconfig.py to have its code reflected in the output? Sorry, I'm a bit new to all this. Thanks!

TCIII, 2022-05-29:
@fswalden,

If `sudo i2cdetect -r -y 1` detected the address of your PCA9685, then your I2C connection as well as the health of the PCA9685 should not be suspect.
What I2C pin numbers are you using on your Nano?
What version of DC are you using? Are you using the "master" branch?
Does your myconfig.py file look like this:
PCA9685_I2C_ADDR = 0x40  (or whatever the hex address should be)
PCA9685_I2C_BUSNUM = 1
and not this:
# PCA9685_I2C_ADDR = 0x40  (or whatever the hex address should be)
# PCA9685_I2C_BUSNUM = 1

TCIII

fswalden, 2022-05-29:
@TCIII

The required code is not commented, no. I used the nano command to edit it and then used the write function to save the changes on myconfig.py. The circuit board does show up with an address of 0x17, which I put in my code. It's probably something really simple I'm doing wrong because I've never worked with this type of thing before, but nonetheless I don't know what that little thing is yet, so I'm pretty desperate. I'm in the master branch, and I'm not sure the answer to the first question, but I'll have a look on Tuesday when I have access to it again. Thanks for the advice, I'll look into it as much as possible. Good to know that the circuit board should be working.

TCIII, 2022-05-29:
@fswalden,

The stock PCA9685 has a default address of 0x40 so I suspect that you do not have a PCA9685 servo controller and that is why you are getting the I/O errors as the DC software is expecting to communicate with a PCA9685.

TCIII

fswalden, 2022-05-29:
@TCIII

I did not assemble the car, so I'm kind of having to piece it together. You're probably right about that. Do you know of a way around it, given that I know the bus number and the address?

TCIII, 2022-05-29:
@fswalden,

I really can't help without knowing what the servo controller is in your car.
Please give me a link to the car you purchased so I can see what was used.

TCIII

fswalden, 2022-05-31:
I can't really find anything that says exactly what the controller is. The car is the XIAOR Geek XR-F2 Donkeycar with Jetson Nano. It's very difficult to get any information since I didn't buy the car and much of the online information I've found is in Chinese.

TCIII, 2022-05-31:
@fswalden,

They appear to be using a BTS7960 motor controller chip which is really not a typical ESC used in R/C cars.

Here is a [link](https://www.xiaorgeek.com/Study/Study/catalog/cid/32) to their tutorials.

I suspect that if you follow their tutorial for getting this car up and running with the DC software you should be okay.

Regards,
TCIII

fswalden, 2022-05-31:
@TCIII

Thank you!

TCIII, 2022-05-31:
@fswalden,

I think that you will find in the tutorial that you have to use the XIOR version of donkey car and not the one from the DC website.

Regards,
TCIII

Ezward, 2023-02-18:
I'm going to close this.  The car is not supported by mainline Donkeycar.  Support will have to come from the manufacturer.

Closed 2023-02-18.

Thread 1020 (2022-06-15):

Car cannot run in a straight line

mseld, 2022-06-15:
The car cannot run in a straight line and I'm looking for something like `STEERING_MID` to adjust it

```py
DRIVE_TRAIN_TYPE = "PWM_STEERING_THROTTLE"

PWM_STEERING_THROTTLE = {
    "PWM_STEERING_PIN": "PCA9685.1:40.1",   # PWM output pin for steering servo
    "PWM_STEERING_SCALE": 1.0,              # used to compensate for PWM frequency differents from 60hz; NOT for adjusting steering range
    "PWM_STEERING_INVERTED": False,         # True if hardware requires an inverted PWM pulse
    "PWM_THROTTLE_PIN": "PCA9685.1:40.0",   # PWM output pin for ESC
    "PWM_THROTTLE_SCALE": 1.0,              # used to compensate for PWM frequence differences from 60hz; NOT for increasing/limiting speed
    "PWM_THROTTLE_INVERTED": False,         # True if hardware requires an inverted PWM pulse
    "STEERING_LEFT_PWM": 460,               #pwm value for full left steering
    # STEERING_MID_PWM 400
    "STEERING_RIGHT_PWM": 290,              #pwm value for full right steering
    "THROTTLE_FORWARD_PWM": 420,            #pwm value for max forward throttle
    "THROTTLE_STOPPED_PWM": 370,            #pwm value for no movement
    "THROTTLE_REVERSE_PWM": 320,            #pwm value for max reverse throttle
}
```

sctse999, 2022-06-15:
https://docs.donkeycar.com/guide/calibrate/

sctse999, 2022-06-15:
Follow the doc. This is probably not a bug therefore I am closing the issue now. Reopen if I misunderstand your question.

Ezward, 2022-06-15:
The midpoint is assumed to be the average of the two steering values.  So that means you need to be calibrated such that the left and right wheels are at the same angles (relative to straight ahead) at their maximum steering.  Calibration is a little tricky; make sure you are picking the value that just barely makes the servo whine, then back off by 1 until it stops whining.  Do this for both left and right.  Generally you will find that if you add the left and right PWM values and divide by two you should get something very close to 370.  If you do not you may not be evenly calibrated between left and right.  So in our case (460 + 290) / 2 = 375, so it is close, but I would apply the 'just until it whines' methodology I suggested.

Closed 2022-06-15.

Thread 1025 (2022-06-25):

Add an improved path recoding and follow algorithm

Ezward, 2022-06-25:
We've done work to incorporate RTK gps into the path follow template.  See https://github.com/autorope/donkeycar/issues/991

I have the gps following the path (still need to do a better job on PID, but it is clearly following the line), but it get's lost when it get's back to the start.  This gives a little insight.  The only device that does not get lost when it get's back to the start is the T265; I believe that is because the T265 has loop closure build into it's algorithm.  I think our algorithm is getting lost because we tend to collect some weird points at the end of a path recording session.  This is proposal to clean that up.

Our current path follow completely ignores heading; it only looks at cross track error.  That is not as good as using heading.  Think of it this way; if the vehicle is at position (x,y) and off the line (so there is some error to be corrected) then there may be 3 states; the vehicle is pointed away from the line so if it continues on that heading it would get farther from the line and so the error would increase OR it can be tracking exactly parallel to the line so if it continues on that heading the error will not change and it will never achieve the line OR it can be pointing toward the line in which case it if continues on that heading then the error will decrease and it will achieve the line.  So even though the vehicle is at the same position with the exact same cross-track error we would want to apply very different control signals to the vehicle.

I used heading every explicitly in the go-to-goal behavior of the [ESP32CameraRover](https://github.com/Ezward/Esp32CameraRover2/blob/3cb95bc326873d1e354887132699924332c0c7e8/src/rover/goto_goal.cpp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); it only looks at the points to be achieved and does not use any line between waypoints.  It knows where it is (based on encoders/kinematics) and it knows the position of the waypoint to be achieved.  It then calculates the line between itself and the waypoint.  That is the heading it needs to achieve the waypoint (that is the direction it must point in order to intersect with the waypoint as it moves forward).   It then compares it's current heading to the heading to be achieved and uses this error to decide if it should turn left or right or just keep straight.  The idea is that as long as you are pointing towards the waypoint and are making progress then you will achieve the waypoint.  It does not care what the last waypoint was.

That is a very different algorithm then we are using now in donkeycar.

There is another parameter we care about; what does it mean to 'achieve' the waypoint; in reality a point is infinitely small.  So we really treat the waypoint as a point and a radius with creates a circular area; when the robot is within this area we say it has achieved the waypoint.  So how do we choose the radius for a waypoint.  What I did was to calculate the minimum distance I could actually measure using the encoders.  So that involved figuring out how far the vehicle would travel between two ticks; that is the shortest distance that could be measured.  I used that as the radius.  That worked well because teh ESP32 rover is differential drive that can turn in place so it's turn radius is infinite.  We don't do that in donkeycar; we can't turn in place; we can pivot on one wheel, but that can get you stuck trying to achieve the waypoint.  It's even worse for a car-like (Ackerman steering) vehicles which could just start orbiting the waypoint.
Of course GPS is a little different because it's accuracy is different between devices and even changes for a given device over short periods of time.  You can actually get the GPS's estimate of it's accuracy and so we could use that and dynamically change the waypoint radius if we wanted to.  But I think it would probably be better to just warn the user if the gps's accuracy drops below what we need.

So I think I would make the radius of the waypoint a configuration property, so we can change it.  It probably needs to be no more than 1/2 the minimum distance between any two waypoints.

With this insight in mind we may want to change the way we record waypoints so that we get a sensible looped path and so we don't record waypoints that may confuse the algorithm.  Rather then just record a waypoint when we had driven a given distance, we should record a waypoint when we are a given distance from the last waypoint we recorded.  These are subtly different; if you turn in a tight circle you may never get very far from the last waypoint, but you will drive more than the minimum waypoint distance .  Such a set of close waypoints would confuse the algorithm.

This also leads to an algorithm for path closure when recording waypoints:
- record the origin as the first waypoint.
- start the vehicle moving, when it is 2x the waypoint radius from the origin record the second waypoint.
- continue recording waypoint in this way
  - if the vehicle is within 2x the waypoint radius of the origin, then stop recording waypoints (close the path).
  - otherwise, when the vehicle is more than 2x the waypoint radius from the last recorded waypoint, record a new waypoint.
  - the user may stop recording early by saving the path before it is closed.

That algorithm for choosing waypoints seems like it would work well even for our current path follow algorithm.

If we have reliable heading then the path follow algorithm could be improved:
- set the target waypoint to achieve to the origin waypoint
- continue path follwing in this way
  - if we are within 1 radius of the waypoint then we have achieved the waypoint
    - if we are at the last waypoint, then select the origin waypoint as the waypoint to be achieved
    - otherwise select the next waypoint in the list as the waypoint to be achieved.
  - calculate the heading* from the vehicle's current position to the waypoint.
  - Subtract the vehicle's current heading from the heading to waypoint to get the heading error.
  - If the heading error is zero (subject to some tolerance) then do not change the vehicle's steering.
  - If the heading error is negative, then steer right
  - If the heading error is positive, then steer left

So how much should we change the steering give the heading error? We could use a constant value when changing the steering; that would be called a constant step controller.  It works ok if things are not changing too fast.  That does not require any configuration (except maybe choosing the constant delta steering angle, which we could put in configuration).  Alternatively we could use a PID algorithm to choose the appropriate change in steering angle; that requires tuning the PID but it could respond faster.  So I would suggest that we default to the first and let them turn on the PID optionally.

Note that we can modify the behavior when we get back to the origin waypoint; be default we keep going and just keep looping. We could also just let the user stop at the origin.

Note that we could modify the behavior that happens when we get back to the origin waypoint; by default we keep going and just keep looping through the waypoints. Alternatively we could let the user stop at the origin.  That choice could be in configuration.

Of course, for this to work you need a good heading estimate.  GPS, even RTK gps, may not provide a great heading; we need to test this.  We can update the current NMEA parser to also parse out the heading, then we can drive a rectangle and see how this changes.  We can compare this against what we would get if we calculated heading using prior gps reading(s).  We likely will need to implement an IMU and sensor fusion to keep a good heading, especially because GPS can glitch; if we have a reliable magnetometer then that would also be helpful.  If we have encoders available then we can also use kinematic pose estimation as a component of the fusion.

TCIII, 2022-06-25:
@Ezward,

Nice analysis and proposed solutions and limitations.

I have a 2WD robot chassis equipped with both a T265 and dual high resolution quadrature encoders so I will be available for testing any updates to the `path_follow.py` template.

I also have two GPS modules, a Matek SAM-M8Q and a Sparkfun NEO-M9N with an active antenna, that I can use to test non-RTK GPS modules with the `path_follow.py` template on a big 6WD robot chassis that is also equipped with dual mono encoders.

Regards,
TCIII

Thread 1028 (2022-06-29):

Lidar support

duttasantanuGH, 2022-06-29:
Planning to add an Lidar (https://docs.donkeycar.com/parts/lidar/) to Jetson Nano based Jetracer Pro (Waveshare - https://www.waveshare.com/jetracer-pro-ai-kit.htm).

Can anyone help us to understand if we need to make any other connection apart from USB power mentioned in the documentation? Also any others tips/advise will be highly appreciated.

Any suggestions on Lidar model etc. will also be highly appreciated. Thanks in advance.

Ezward, 2022-06-29:
Please let us know how this turns out.

TCIII, 2022-06-30:
@duttasantanuGH,

You do realize that there is presently no training models that use RPLidar data for navigation?

Therefore, do you plan to write your own training model and share it with the DC community?

Regards,
TCIII

duttasantanuGH, 2022-07-02:
@TCIII and @Ezward
I was thinking in I install the donkey car from dev branch, I would get a installation which supports lidar (as per https://docs.donkeycar.com/parts/lidar/). The data reading from lidar and feeding lidar data as input to training and then during autopilot mode as well based on training data will be supported. Is that the case or am I missing something? (Do I need to do as suggested here https://www.hackster.io/bluetiger9/stereo-vision-and-lidar-powered-donkey-car-575769)?
Will appreciate help here.

TCIII, 2022-07-02:
@duttasantanuGH,

Ezward started the [integration of the lidar.py part into a DC training model](https://github.com/autorope/donkeycar/issues/910) over a year ago and he is still not done.

It is presently on hold.

Regards,
TCIII

Ezward, 2022-07-04:
@duttasantanuGH There is support for Lidar in that the data is saved.  I do not think there is a model that uses it however.

duttasantanuGH, 2022-07-20:
I followed the steps as suggested by Ezward. On execution of python donkeycar/parts/lidar.py (intention is only to test the lidar if it is working - connecting and sending the data), I am getting the following error:
using donkey v4.3.16 ...
future feature annotations is not defined (board.py, line 24)
Will appreciate help in resolving the the error.

TCIII, 2022-07-20:
@duttasantanuGH,
What branch of DC are you using? The `main branch` or `next-gen-lidar-parts branch`?
There is no `board.py part` in either the main branch or the `next-gen-lidar-parts branch`.

I assume that you are following these [instructions](https://docs.donkeycar.com/parts/lidar/) to install and use your Lidar with DC?

Could you please copy and paste the CLI output of `manage.py drive` where you get the error to help facilitate troubleshooting your issue.

TCIII

duttasantanuGH, 2022-07-20:
Yes I followed the [instructions](https://docs.donkeycar.com/parts/lidar/).
I have used main branch. I saw that dev branch is not there. Do you want me to try next-gen-lidar-parts branch (I faced other issues when I tried out next-gen-lidar-parts branch. But I can try again if needed)
Here is output requested:
using donkey v4.3.16 ...
WARNING:donkeycar.parts.pins:pigpio was not imported.
INFO:donkeycar.config:loading config file: /home/jetson/mycar/config.py
INFO:donkeycar.config:loading personal config over-rides from myconfig.py
INFO:__main__:PID: 7804
cfg.CAMERA_TYPE CSIC
INFO:__main__:cfg.CAMERA_TYPE CSIC
GST_ARGUS: Creating output stream
CONSUMER: Waiting until producer is connected...
GST_ARGUS: Available Sensor modes :
GST_ARGUS: 3264 x 2464 FR = 21.000000 fps Duration = 47619048 ; Analog Gain range min 1.000000, max 10.625000; Exposure Range min 13000, max 683709000;

GST_ARGUS: 3264 x 1848 FR = 28.000001 fps Duration = 35714284 ; Analog Gain range min 1.000000, max 10.625000; Exposure Range min 13000, max 683709000;

GST_ARGUS: 1920 x 1080 FR = 29.999999 fps Duration = 33333334 ; Analog Gain range min 1.000000, max 10.625000; Exposure Range min 13000, max 683709000;

GST_ARGUS: 1640 x 1232 FR = 29.999999 fps Duration = 33333334 ; Analog Gain range min 1.000000, max 10.625000; Exposure Range min 13000, max 683709000;

GST_ARGUS: 1280 x 720 FR = 59.999999 fps Duration = 16666667 ; Analog Gain range min 1.000000, max 10.625000; Exposure Range min 13000, max 683709000;

GST_ARGUS: 1280 x 720 FR = 120.000005 fps Duration = 8333333 ; Analog Gain range min 1.000000, max 10.625000; Exposure Range min 13000, max 683709000;

GST_ARGUS: Running with following settings:
   Camera index = 0
   Camera mode  = 5
   Output Stream W = 1280 H = 720
   seconds to Run    = 0
   Frame Rate = 120.000005
GST_ARGUS: Setup Complete, Starting captures for 0 seconds
GST_ARGUS: Starting repeat capture requests.
CONSUMER: Producer has connected; continuing.
[ WARN:0] global /home/nvidia/host/build_opencv/nv_opencv/modules/videoio/src/cap_gstreamer.cpp (933) open OpenCV | GStreamer warning: Cannot query video position: status=0, value=-1, duration=-1
INFO:donkeycar.parts.camera:CSICamera opened...
INFO:donkeycar.parts.camera:...warming camera
INFO:donkeycar.parts.camera:CSICamera ready.
INFO:donkeycar.vehicle:Adding part CSICamera.
adding RP lidar part
Traceback (most recent call last):
  File "manage.py", line 853, in <module>
    meta=args['--meta'])
  File "manage.py", line 187, in drive
    lidar = RPLidar(lower_limit = cfg.LIDAR_LOWER_LIMIT, upper_limit = cfg.LIDAR_UPPER_LIMIT)
  File "/home/jetson/projects/donkeycar/donkeycar/parts/lidar.py", line 272, in __init__
    from adafruit_rplidar import RPLidar
  File "/home/jetson/env/lib/python3.6/site-packages/adafruit_rplidar.py", line 38, in <module>
    from busio import UART
  File "/home/jetson/env/lib/python3.6/site-packages/busio.py", line 16, in <module>
    import adafruit_platformdetect.constants.boards as ap_board
  File "/home/jetson/env/lib/python3.6/site-packages/adafruit_platformdetect/__init__.py", line 10, in <module>
    from .board import Board
  File "/home/jetson/env/lib/python3.6/site-packages/adafruit_platformdetect/board.py", line 24
    from __future__ import annotations
    ^
SyntaxError: future feature annotations is not defined
GST_ARGUS: Cleaning up
CONSUMER: Done Success
GST_ARGUS: Done Success

TCIII, 2022-07-20:
@duttasantanuGH,

Unfortunately I never used the Lidar in the `main` branch and only worked with the `next-gen-lidar-parts` branch.

I have an A1M8 running successfully on a NVIDIA Nano 4GB running JP4.6 using the `next-gen-lidar-parts` branch.

What issues did you experience with the `next-gen-lidar-parts` branch?

TCIII

Ezward, 2022-07-20:
Sounds like may be using Python 3.6?  I would update to python 3.8.  We have started adding type annotations in the code and they require a newer version of python.

TCIII, 2022-07-20:
@duttasantanuGH,

Do you have `pip3 install glob2` installed?

TCIII

duttasantanuGH, 2022-07-20:
@TCIII - Yes I have installed glob2.
@Ezward - It would help. Kindly let me know once you update.

TCIII, 2022-07-20:
@duttasantanuGH,

Do you have user write permissions set for the NVIDIA USB ports?

TCIII

duttasantanuGH, 2022-07-21:
@TCIII and @Ezward - Thanks. I am using a headless version and doing a ssh -Y for getting the display
2 issues I am facing now:
**Issue 1**: I had installed libcanberra-gtk-module and now the error is resolved but when I run `python donkeycar/parts/lidar.py`, the "lidar on jetson-desktop" is appearing for a brief spell but it crashing in few seconds.
**Issue 2:** When I am running manage.py drive, the car is getting initiated to drive but when I trying to drive with joystick, it is crashing with the following Warning message and more importantly the **following error message**:
_Warning message - /home/jetson/projects/donkeycar/donkeycar/parts/lidar.py:323: DeprecationWarning: elementwise comparison failed; this will raise an error in the future.
  if angles_ind != []:_
**Error message**
Traceback (most recent call last):
  File "/home/jetson/projects/donkeycar/donkeycar/vehicle.py", line 154, in start
    self.update_parts()
  File "/home/jetson/projects/donkeycar/donkeycar/vehicle.py", line 202, in update_parts
    outputs = p.run(*inputs)
  File "/home/jetson/projects/donkeycar/donkeycar/parts/keras.py", line 109, in run
    np_other_array = np.array(other_arr) if other_arr else None
ValueError: The truth value of an array with more than one element is ambiguous. Use a.any() or a.all()
INFO:donkeycar.vehicle:Shutting down vehicle and its parts...
INFO:donkeycar.parts.camera:Stopping CSICamera
INFO:donkeycar.parts.controller:button: a_button state: 0
GST_ARGUS: Cleaning up
CONSUMER: Done Success
GST_ARGUS: Done Success
Exception in thread Thread-2:
Traceback (most recent call last):
  File "/usr/lib/python3.6/threading.py", line 916, in _bootstrap_inner
    self.run()
  File "/usr/lib/python3.6/threading.py", line 864, in run
    self._target(*self._args, **self._kwargs)
  File "/home/jetson/projects/donkeycar/donkeycar/parts/lidar.py", line 307, in update
    for scan in scans:
  File "/home/jetson/env/lib/python3.6/site-packages/adafruit_rplidar.py", line 508, in iter_scans
    for new_scan, quality, angle, distance in iterator:
  File "/home/jetson/env/lib/python3.6/site-packages/adafruit_rplidar.py", line 433, in iter_measurements
    raw = self._read_response(dsize)
  File "/home/jetson/env/lib/python3.6/site-packages/adafruit_rplidar.py", line 258, in _read_response
    data = self._serial_port.read(dsize)
  File "/home/jetson/env/lib/python3.6/site-packages/serial/serialposix.py", line 575, in read
    buf = os.read(self.fd, size - len(read))
TypeError: an integer is required (got type NoneType)

TCIII, 2022-07-22:
@duttasantanuGH,

I suggest that you run the `lidar.py main` from the desktop and see if that is functional and then move on to trying to run headless.

TCIII

duttasantanuGH, 2022-07-23:
@TCIII
Thanks for your suggestion. I was a good idea to try out in host ubuntu machine. I could figure out the stupid error (read laziness) on my side for not looking at default arguments ("number" and line 881 of lidar.py (`while scan_count < args.number`). This was making the lidar run last for few seconds. Now that part is solved
I could now connect Lidar with Jetson nano and get the lidar data as part data collection.
I understand from the earlier comment that there is no training model available at present to consume lidar data and subsequently help in navigation.

duttasantanuGH, 2022-07-26:
@Ezward & @TCIII
Please note the following data that I am getting as part of "catalog_0.catalog" file:
**For image with clear pathway for car:**
{"_index": 4, "_session_id": "22-07-25_0", "_timestamp_ms": 1658771315188, "cam/image_array": "4_cam_image_array_.jpg", "lidar/dist_array": [3, 2, 1, 0], "user/angle": 0.0, "user/mode": "user", "user/throttle": 0.033509323404644915}
**For image with obstruction in front of the car:**
{"_index": 4, "_session_id": "22-07-25_0", "_timestamp_ms": 1658771370749, "cam/image_array": "4_cam_image_array_.jpg", "lidar/dist_array": [29, 30, 15, 16, 17, 14, 18, 13, 12, 19, 20, 21, 11, 10, 22, 9, 23, 8, 24, 7, 25, 6, 26, 28, 5, 27, 4, 3, 2, 1, 0, 31, 33, 32], "user/angle": 0.0, "user/mode": "user", "user/throttle": 0.25}

Few questions - if you can kindly help me with responses:
#1 Can you please throw some light why the lidar/dist array are of varying length in two cases?
# 2 Any thoughts on how to interpret this data in terms of distance?
# 3 Any further thoughts how this lidar data into a model as these are of varying length?

Will apreciate very much your response on this.

Ezward, 2022-10-03:
@duttasantanuGH sorry for the long delay.  We respond very quickly in the discord community, but I do like the detail that is captured here in the issue.  So perhaps must ping me in the community when you add something to the issue.  I am Ezward in the discord.

Now in terms of the values; the code says they are distances.  I think there is supposed to be one per degree of rotation, starting at the minimum angle you have set in configuration, up to the max.  I don't know why the arrays can be of different length.  Perhaps @zlite knows; he knows the RPLidar driver code better than I.

Thread 1032 (2022-07-26):

On Mac donkey car error with "donkey/lib/libbcm_host.so' (no such file)" when I run python manage.py drive

unnatis07, 2022-07-26:
Logs
python manage.py drive
________             ______                   _________      
___  __ \_______________  /___________  __    __  ____/_____ ________
__  / / /  __ \_  __ \_  //_/  _ \_  / / /    _  /    _  __ `/_  ___/
_  /_/ // /_/ /  / / /  ,<  /  __/  /_/ /     / /___  / /_/ /_  /
/_____/ \____//_/ /_//_/|_| \___/_\__, /      \____/  \__,_/ /_/
                                 /____/                      

using donkey v4.3.6.3 ...
WARNING:donkeycar.parts.pins:RPi.GPIO was not imported.
WARNING:donkeycar.parts.pins:pigpio was not imported.
INFO:numexpr.utils:NumExpr defaulting to 8 threads.
loading config file: /Users/vense03/mysim/config.py
loading personal config over-rides from myconfig.py
INFO:__main__:PID: 36298
cfg.CAMERA_TYPE PICAM
INFO:__main__:cfg.CAMERA_TYPE PICAM
Traceback (most recent call last):
  File "manage.py", line 853, in <module>
    meta=args['--meta'])
  File "manage.py", line 142, in drive
    cam = PiCamera(image_w=cfg.IMAGE_W, image_h=cfg.IMAGE_H, image_d=cfg.IMAGE_DEPTH, framerate=cfg.CAMERA_FRAMERATE, vflip=cfg.CAMERA_VFLIP, hflip=cfg.CAMERA_HFLIP)
  File "/Users/vense03/Unnati/donkeycar/donkeycar/parts/camera.py", line 22, in __init__
    from picamera.array import PiRGBArray
  File "/Users/vense03/opt/miniconda3/envs/donkey/lib/python3.7/site-packages/picamera/__init__.py", line 72, in <module>
    from picamera.exc import (
  File "/Users/vense03/opt/miniconda3/envs/donkey/lib/python3.7/site-packages/picamera/exc.py", line 41, in <module>
    import picamera.mmal as mmal
  File "/Users/vense03/opt/miniconda3/envs/donkey/lib/python3.7/site-packages/picamera/mmal.py", line 47, in <module>
    from .bcm_host import VCOS_UNSIGNED
  File "/Users/vense03/opt/miniconda3/envs/donkey/lib/python3.7/site-packages/picamera/bcm_host.py", line 47, in <module>
    _lib = ct.CDLL('libbcm_host.so')
  File "/Users/vense03/opt/miniconda3/envs/donkey/lib/python3.7/ctypes/__init__.py", line 364, in __init__
    self._handle = _dlopen(self._name, mode)
OSError: dlopen(libbcm_host.so, 0x0006): tried: '/Users/vense03/opt/miniconda3/envs/donkey/lib/libbcm_host.so' (no such file), '/Users/vense03/opt/miniconda3/envs/donkey/lib/libbcm_host.so' (no such file), '/Users/vense03/opt/miniconda3/envs/donkey/lib/python3.7/lib-dynload/../../libbcm_host.so' (no such file), '/Users/vense03/opt/miniconda3/envs/donkey/lib/libbcm_host.so' (no such file), '/Users/vense03/opt/miniconda3/envs/donkey/bin/../lib/libbcm_host.so' (no such file), 'libbcm_host.so' (no such file), '/usr/local/lib/libbcm_host.so' (no such file), '/usr/lib/libbcm_host.so' (no such file), '/Users/vense03/mysim/libbcm_host.so' (no such file)

cfox570, 2022-07-26:
Are you running on a Raspberry Pi, Windows, Linux, Mac?   Miniconda install is recommended for Windows, Linux, Mac.  And you have specified the picamera to run.

unnatis07, 2022-07-27:
I am running it on Mac.

I am following steps listed here : https://docs.donkeycar.com/guide/simulator/

Earlier, since I noticed that it was looking for picamera, I did this step (although its not listed in the steps)
export READTHEDOCS=True
pip install picamera

post this, I executed
conda activate donkey

and then
python manage.py drive  : and This step is where I get the error posted above.

cfox570, 2022-07-27:
Did you also follow these instructions: https://docs.donkeycar.com/guide/host_pc/setup_mac/ ?
Did you set DONKEY_GYM = True in myconfig.py?  This replaces the Picamera setting. You do not need picamera installed for the Mac.  If you are still having a problem, I suggest you attach the myconfig.py file with your settings.

I also suggest you join the Discord server for help instead of posting here.  You will likely receive alot more responses.
https://www.donkeycar.com/community.html

Ezward, 2022-10-29:
@unnatis07 It seems you have the RaspberryPi camera selected in your myconfig.py file; that will not work on a Mac.  You want to choose either 'MOCK' for no camera or 'CVCAM' to use opencv to access a webcam or laptop camera (you must have installed the optional opencv dependencies to do this).

Ezward, 2022-10-29:
@unnatis07 Is this still a problem for you?  It sounds like a configuration issue.  I would like to close this issue; please give us an update.

unnatis07, 2022-10-29:
Thanks Ed. Its not an issue anymore. I solved it but dont recall specifics. Thanks again. On Oct 28, 2022, at 9:02 PM, Ed Murphy ***@***.***> wrote:
@unnatis07 Is this still a problem for you?  It sounds like a configuration issue.  I would like to close this issue; please give us an update.

—Reply to this email directly, view it on GitHub, or unsubscribe.You are receiving this because you were mentioned.Message ID: ***@***.***>

Closed 2023-03-01.

Thread 1040 (2022-09-10):

Evolve the GPS path follow template

Ezward, 2022-09-10:
We have implemented a template that used GPS to record a path and follow it.  This is the issue [#991 Add gps part and integrate into path_follow template](https://github.com/autorope/donkeycar/issues/991) describing the work and what is left to do.  This is the branch that implements it [921-gps-logger](https://github.com/autorope/donkeycar/tree/921-gps-logger).  As noted in [issue #991](https://github.com/autorope/donkeycar/issues/991), there are three steps for getting this merged into the main branch.  The first of these steps is included below.  As these are merged the list will be updated with testing for the subsequent PRs.

1. Test refactor of complete.py template (The DNN template)
    - Success criteria; The refactored complete.py should work the same as  the current main branch (no new functionality was added, this is just a refactor).
    - Any instructions in docs.donkeycar.com should work.  If there are discrepancies then we should open an issue to either change the code or update the docs at the time we merge this branch into main.
    - Report any bugs (add issues in github)
    - Work with developer to fix bugs and close issues.
    - do this for the other 2 stages are described in [issue #991](https://github.com/autorope/donkeycar/issues/991) as PRs become available.

2.  Experiment with various GPS receiver technologies
    - compare RTK, RTK with dead reckoning and non-RTK, non-RTK with dead reckoning gps receivers.  See this [article](https://ezward.github.io/gps/) for how to setup RTK for this purpose
    - how many laps (how much time) can you go with non-RTK gps before drift inteferes?
    - Which technologies perform better in a time trial?
    - what is the highest performing setup?
    - what is the most cost effective setup?

3.  Improve path follow 1
    - The current algorithm uses cross-track error and a PID to turn towards line to follow; no heading is involved.
    - How do optimal PID values vary with velocity?
    - What recommendations can we makes for starting PID values and for a process to identify optimal values?
    - Observer the behavior of the vehicle if it moves too far way from line to follow; the vehicle will get stuck in a tight turn an never achieve the line to follow.  Why does this happen?  What changes could be made to recover from this state?
    - What happens if the path to follow crosses itself?  What changes can be made to reliably drive on such paths?

4. Improve path follow 2
    - The current algorithm uses cross-track error and a PID to turn towards line to follow; no heading is involved.
    - How could we add in heading?
      - software only (delta of current and previous GPS location)
      - hardware 6 axis acc/gyro like MPU6500
      - hardware 9 axis acc/gyro/mag like MPU9250 (see https://quadmeup.com/mpu6000-vs-mpu6050-vs-mpu6500/ for comparison)
      - wheel encoders and a kinematic model.
    - How do these complement GPS?  How would data from these sources be use in conjunction with GPS positions?
    - Implement one or more of these sources of heading and add this to the vehicles current pose estimate. (x, y) -> (x, y, heading).

5. Improve path follow 3
    - Once we have heading, we can use more sophisticated path follow algorithms, like pure pursuit.
    - implement pure pursuit using one or more of the techologies identified in #2 using a constant velocity.
    - how does pure pursuit compare to cross-track error; what are benefits and how are failure modes different?

6. Pure Pursuit with waypoint velocity
   - Rather than each waypoint being a simple (x,y) coordinate, add a target velocity to achieve at that waypoint (x, y, velocity).
   - If wheel encoders are available, then closed loop velocity control can be added to achieve these target velocities.
   - In the absence of wheel encoders, a software only approach where velocity is calculated from the current and previous pose estimate.
   - develop a control algorithm to accelerate/decelerate to achieve the target velocity at each waypoint.
   - how precise does the velocity estimate and control need to be to deliver benefits?
   - compare this to cross-track/pid and constant velocity pure pursuit;
       - which can achieve lower (faster) lap times?

7. Pre-calculate an optimal trajectory
    - given a map that indicates the driveable area (perhaps as paths for the left and right borders of the track), calculate an optimal path for the vehicle to follow.
    - try minimizing distance traveled in one lap
    - try minimizing curvature of path in one lap
    - try maximizing single-point velocity that can be achieved.

TCIII, 2022-09-10:
@Ezward,

An excellent path forward to be able to integrate both heading and IMU functions and possibly wheel encoders with GPS be it just GPS or GPS + RTK.
I presently have a Traxxas E-Maxx Truck chassis running a Rpi 3B+/Robo HAT MM1 M4 configuration. The Robo HAT has a built in MPU9250 at hex address 0x69. Unfortunately it will be difficult to add wheel encoders to my E-Maxx.
However I do have a large 6WD chassis with wheel encoders and a small 6WD chassis with motor wheel encoders. The 6WD chassis are not fast, but have used both wheel encoders and GPS to validate the `path_follow.py` template from the DC `921-gps-logger` branch.

Here is a [link](https://youtu.be/_PI20CWPxes) to a video of my Traxxas E-Max running a Sparkfun NEO-M9N GPS with an active antenna on a ground plane. At the time the video was shot the E-Maxx batteries were running low and a cloud cover was coming in as the E-Maxx had performed better during previous runs.

Regards,
TCIII

Ezward, 2023-02-06:
IMU pose estimation and IMU/GPS fusion resources:

- https://pypi.org/project/droneposelib/. dronepose lib is a python library that will make pose estimates based on IMU data.
- https://pypi.org/project/imusensor/ library to make reading the IMU easy.  Look at the acknowledgements at the bottom of the page.
- https://github.com/micropython-IMU/micropython-fusion micro-python library implements Madgwick
- https://github.com/xioTechnologies/Fusion AHRS fusion in C with Python bindings.  Includes some error rejection.
- https://github.com/smahajan07/sensor-fusion Python fuse GPS with IMU for position and orientation estimation
- https://ahrs.readthedocs.io/en/latest/index.html  Collection of Python AHRS (Attitude and Heading Reference Systems) methods for combining IMU and GPS etc.

Thread 1041 (2022-09-14):

Setup a car with DC_STEER_THROTTLE using DC Adafruit Motor Hat (PCA9685)

AlcorDust, 2022-09-14:
Hi, i bought a cheap RC car which uses 2 DC motors, one for steering and one for throttle.
I installed the donkeycar software on Raspberry 3, and i also iunstalled the motor hat requirements. I managed to make the motor hat work with a simple python script.

Now i'm trying to configure mycar editing the myconfig.py file. I selected DRIVE_TRAIN_TYPE = "DC_STEER_THROTTLE", but when i run the drive command i can't make the car move, but i can see the live camera output.

I took a look at the manage.py file, and seems like the DRIVE_TRAIN_TYPE = "DC_STEER_THROTTLE" only uses the L298N controller:

`
elif cfg.DRIVE_TRAIN_TYPE == "DC_STEER_THROTTLE":
        dt = cfg.DC_STEER_THROTTLE
        steering = actuator.L298N_HBridge_2pin(
            pins.pwm_pin_by_id(dt['LEFT_DUTY_PIN']),
            pins.pwm_pin_by_id(dt['RIGHT_DUTY_PIN']))
        throttle = actuator.L298N_HBridge_2pin(
            pins.pwm_pin_by_id(dt['FWD_DUTY_PIN']),
            pins.pwm_pin_by_id(dt['BWD_DUTY_PIN']))
`

How can i link the drive train type with the Adafruit Motor Hat?

Thanks in advance

Ezward, 2022-09-15:
The Adafruit motor driver uses a TB6612 hbridge rather than an L298 hbridge.  We do have a driver for this; https://github.com/autorope/donkeycar/blob/c61de767b2af4bcd673534f9d28054f098a52f16/donkeycar/parts/actuator.py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, but it's not exposed in the configuration and not used in the complete.py template.  You could add it to your manage.py yourself.

AlcorDust, 2022-09-19:
>

Thank you!
I edited the file manage.py and then i added and selected the option in myconfig.py
Do you know where i can find the indexes for `STEERING_MOTOR` and `THROTTLE_MOTOR`?

Ezward, 2022-10-26:
@AlcorDust did that work?  Can we close this issue?

Closed 2023-02-18.

Thread 1047 (2022-10-11):

Update path_follow to support velocity target on a waypoint

Ezward, 2022-10-11:
The current path_follow algorithm searches for the nearest waypoint to it's current position, then chooses the next waypoint in the path and uses those two points to create a line; it then determines which side of the line it is on and how far from the line it is and uses that as the input to a PID that decides which direction to turn in and how much to turn.  Throttle is held constant at some value > 0 and <= 1.0 specified in configuration.

Because throttle is constant, in practice we set it to limit the speed to what we can handle driving around the tightest corner.  That means we are much slower on a long straight then we could be, or conversely we are too fast heading into a corner and so may overshoot.

Modify the waypoint data structure to include a target throttle to be achieved at that waypoint.  Modify the vehicle loop in the path_follow.py template to set the throttle based on the waypoint that we are headed to (so the next waypoint from the closest one, as described above).  Allow this to be overridden by a constant throttle if it is specified in the configuration; if no constant throttle is specified then use the throttle values in the waypoints (path) file.

zlite, 2022-10-11:
Nice! I've been hoping variable throttle would come and here it is! It's the only way to be competitive

TCIII, 2022-10-12:
@Ezward,

My 4WD Traxxas E-Maxx can easily do 12-15 m/sec on the straightaways, but would tip over on the curves at that velocity.
Presently I run the E-Maxx at around 3.2 m/sec to avoid tipping over on the curves.
Reducing the vehicle velocity on the curves to a sustainable level and increasing the velocity to a predefined maximum on the straightaways would make for some very interesting racing competition.

TCIII

TCIII, 2022-10-12:
@zlite,

Doesn't ArduRover already have a variable throttle for straightaways and curves (turns)?

TCIII

evanphilipsmith, 2022-10-28:
@Ezward I'm with a team of students at UCSD using donkeycar for a class project. We're interested in GPS path following and would like to try and implement a solution to address this issue. Just wanted to put it out there so you know we are working on it! 😄

TCIII, 2022-10-28:
@evanphilipsmith,

I am TCIII, a DC Maintainer, and I have a Traxxas E-Maxx Truck Chassis test vehicle running the DC `main branch` and using the `path_follow.py` template that employs input from a Sparkfun NEO-M9N GPS module with an actve 32db gain antenna.

I will be available to test and validate any code branches that add velocity, heading, and IMU input to the GPS CTE input mix.

Regards,
TCIII

TCIII, 2022-11-12:
@evanphilipsmith,

[Improve](https://github.com/autorope/donkeycar/issues/1060) DC imu.py part.

TCIII

Closed 2023-02-03.

Thread 1048 (2022-10-12):

Update path_follow to use heading

Ezward, 2022-10-12:
The current path_follow algorithm searches for the nearest waypoint to it's current position, then chooses the next waypoint in the path (the target waypoint) and uses those two points to create a line; it then determines which side of the line it is on and how far from the line it is and uses that as the input to a PID that decides which direction to turn in and how much to turn.  Throttle is held constant (based on configuration).

Note that the input to the PID is the cross-track error.  The vehicle's current heading is not considered.

Modify the code to keep an estimate of the vehicle's heading.  Use this heading estimate to calculate the heading error relative to the line connecting the vehicle and the target waypoint (the next waypoint after the nearest waypoint, as described above).  Use that heading error as the input to the PID that controls steering.  So for instance, if the car's heading would take it to the left of the target waypoint, then we would want to turn right to point at the target waypoint.  If the car's heading would take it to the right of the target waypoint, then we would want to turn left to point at the target waypoint.  As long as we are always pointing at the target waypoint and we are making progress, then we will achieve the waypoint.

TCIII, 2022-10-12:
@Ezward,

An excellent plan.
I believe that the inclusion of Heading in the steering solution will help to maintain vehicle tracking on long straightaways and help to prevent off track drifting.

TCIII

TCIII, 2022-10-28:
@Ezward,

I am TCIII and I have a Traxxas E-Maxx Truck Chassis test vehicle running the DC `main branch` and using the `path_follow.py` template that employs input from a Sparkfun NEO-M9N GPS module with an actve 32db gain antenna.

I will be available to test and validate any code branches that add velocity, heading, and IMU input to the GPS CTE input mix.

Regards,
TCIII

aldenyue, 2022-11-14:
@Ezward Hi Edward, me and group of students at UCSD are using Donkey Car and would like to help out with this issue. We plan on using a Sparkfun NEO-M9N GPS module to obtain heading.

TCIII, 2022-11-15:
@aldenyue,

Besides the Sparkfun NEO-M9N on my Traxxas E-Maxx test vehicle, I have a Robo HAT MM1 that includes a mpu9250 IMU.

I tested it recently and all of the sensors are fully functional.

TCIII

aldenyue, 2022-11-30:
@TCIII

We are trying to figure out how to get accurate heading from our Sparkfun NEO-M9N. Have you head any success in getting accurate heading measurements? We are thinking of fusing sensor data from our GPS and a separate IMU.

Alden

TCIII, 2022-11-30:
@aldenyue,

From the UBlox NEO-M9N Integration Manual "The NEO-M9N firmware does not support the dead reckoning position fix type."
I take this to mean that you cannot determine "Heading" (dead reckoning) when using the NEO-M9N.

Sparkfun does have a ["dead -reckoning" GPS](https://www.sparkfun.com/products/16329) available, however it utilizes the older NEO-M8U GPS which is somewhat inferior to the NEO-M9N. "The NEO-M8U takes advantage of u-blox's Untethered Dead Reckoning (UDR) technology."

I was expecting to integrate an IMU with the GPS position data since we already have the NEO-M9N GPSs. My GPS testbed vehicle is equipped with a mpu9250 IMU mounted on a Robo HAT MM1 M4 besides the Sparkfun NEO-M9N GPS.

I am not a Python coder, but do understand Python structure enough to make on the fly corrections to python programs when there are obvious errors.

I am a System Engineer and will be glad to work with you to integrate IMU sensor fusion in the present GPS path_follow template.

Here is a very good [tutorial](https://dingyan89.medium.com/three-methods-of-vehicle-lateral-control-pure-pursuit-stanley-and-mpc-db8cc1d32081) on improving lateral control when employing a basic CTE algorithm.

A little research into GPS + IMU sensor fusion:

1) [Link](https://www.mathworks.com/help/fusion/ug/imu-and-gps-fusion-for-inertial-navigation.html)
2) [Link](https://github.com/smahajan07/sensor-fusion)
3) [The whole shebang](https://github.com/topics/imu?l=python)
4) [Link](https://libs.garden/python/search?q=sensor+fusion)

Observations:
Most GPS +IMU sensor fusion seem to implement a Kalman Filter.
The GPS location is a Gaussian distribution about the vehicles actual location.

TCIII

Ezward, 2022-11-30:
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

@aldenyue You might try estimating heading using the last two or so positions you get from the gps.  The NMEA sentences also contain a heading estimate; see the GPRMC/GNRMC sentence that we decode to get the (x,y) position; http://aprs.gids.nl/nmea/#rmc  It also provides a field called "True course" or "Track made good in degrees True"; For a ground vehicle this is equivalent to heading (provided you are not drifting!).  Note there is also "Speed over ground in knots" for velocity if you care and want to do some closed loop speed control.  Note that this course over ground is only as good as the GPS hardware that estimates it; so for a GPS that does not have an integrated IMU then it may be of similar accuracy and latency to the using the last two known GPS points.

This can be made much better by integrating an IMU, especially if it has a magnetometer and you can isolate the magnetometer from the variable magenetic field generated by the motor and servo (hint; put it on a mast).

TCIII, 2022-12-02:
@Ezward,
 How do you figure that "The NMEA sentences also contain a heading estimate; see the GPRMC/GNRMC sentence that we decode to get the (x,y) position;"?
When: "The NEO-M9N firmware does not support the dead reckoning position fix type."

TCIII

TCIII, 2022-12-02:
@aldenyue,

Any progress this week?

TCIII

aldenyue, 2022-12-03:
@TCIII

Sorry but we won't be able to make any more progress :(.  Our group doesn't have enough time this quarter to figure out heading for our final project, so we're pivoting to a different idea that we'll be able to finish.

Alden

Ezward, 2022-12-03:
> @Ezward, How do you figure that "The NMEA sentences also contain a heading estimate; see the GPRMC/GNRMC sentence that we decode to get the (x,y) position;"? When: "The NEO-M9N firmware does not support the dead reckoning position fix type."
>
> TCIII

It's explained in the comment; at the worst it can just use the last two gps readings to estimate courts over ground.

Ezward, 2023-09-06:
Note that the kinematics models have been landed in the main branch at https://github.com/autorope/donkeycar/blob/main/donkeycar/parts/kinematics.py.  The Bicycle model has been tested with the path_follow template and works well.  The Unicycle model is not well tested in the real world but has unit tests.

Thread 1051 (2022-10-16):

Support picamera2 python library for libcamera on RasperryPi OS Bullseye

Ezward, 2022-10-16:
The legacy camera library no longer work on bullseye unless it is configured using raspi-config.  That is a short term solution, but eventually most software will support the newer libcamera/picamera2 apis.
- implement a picamera2 based camera part
- if possible, make this choice transparent to the donkeycar user, so that choose `PICAM` as the camera type will work in picamera2 is available or fall back to picamera if it is not.

Ezward, 2022-10-16:
On Bullseye there is an error attempting to install the optional OpenCV dependencies:
```
$ sudo apt-get install libilmbase-dev libopenexr-dev libgstreamer1.0-dev libjasper-dev libwebp-dev libatlas-base-dev libavcodec-dev libavformat-dev libswscale-dev libqtgui4 libqt4-test
Reading package lists... Done
Building dependency tree... Done
Reading state information... Done
Package libqtgui4 is not available, but is referred to by another package.
This may mean that the package is missing, has been obsoleted, or
is only available from another source

E: Package 'libqtgui4' has no installation candidate
E: Unable to locate package libqt4-test
```

Ezward, 2022-10-16:
There were a couple of warnings doing the `install -e .[pi]`
```Installing collected packages: pyusb, sysv-ipc, rpi-ws281x, pyftdi, Adafruit-PureIO, Adafruit-PlatformDetect, typing-extensions, adafruit-circuitpython-requests, Adafruit-Blinka, adafruit-circuitpython-typing, adafruit-circuitpython-busdevice, pillow, wcwidth, tifffile, PyWavelets, networkx, imageio, utm, tornado, simple-pid, Shapely, scikit-image, pynmea2, pyfiglet, progress, PrettyTable, paho-mqtt, opencv-python, h5py, docopt, Adafruit-GPIO, adafruit-circuitpython-register, adafruit-circuitpython-framebuf, imgaug, donkeycar, Adafruit-PCA9685, adafruit-circuitpython-ssd1306, adafruit-circuitpython-rplidar, adafruit-circuitpython-lis3dh
  Attempting uninstall: typing-extensions
    Found existing installation: typing-extensions 3.7.4.3
    Not uninstalling typing-extensions at /usr/lib/python3/dist-packages, outside environment /home/ed/env
    Can't uninstall 'typing-extensions'. No files were found to uninstall.
  Attempting uninstall: pillow
    Found existing installation: Pillow 8.1.2
    Not uninstalling pillow at /usr/lib/python3/dist-packages, outside environment /home/ed/env
    Can't uninstall 'Pillow'. No files were found to uninstall.
  Running setup.py develop for donkeycar
Successfully installed Adafruit-Blinka-8.5.0 Adafruit-GPIO-1.0.3 Adafruit-PCA9685-1.0.1 Adafruit-PlatformDetect-3.32.0 Adafruit-PureIO-1.1.9 PrettyTable-3.4.1 PyWavelets-1.4.1 Shapely-1.8.5.post1 adafruit-circuitpython-busdevice-5.2.3 adafruit-circuitpython-framebuf-1.4.14 adafruit-circuitpython-lis3dh-5.1.18 adafruit-circuitpython-register-1.9.14 adafruit-circuitpython-requests-1.12.8 adafruit-circuitpython-rplidar-1.2.10 adafruit-circuitpython-ssd1306-2.12.11 adafruit-circuitpython-typing-1.8.2 docopt-0.6.2 donkeycar h5py-3.7.0 imageio-2.22.2 imgaug-0.4.0 networkx-2.8.7 opencv-python-4.6.0.66 paho-mqtt-1.6.1 pillow-9.2.0 progress-1.6 pyfiglet-0.8.post1 pyftdi-0.54.0 pynmea2-1.18.0 pyusb-1.2.1 rpi-ws281x-4.3.4 scikit-image-0.19.3 simple-pid-1.0.1 sysv-ipc-1.1.0 tifffile-2022.10.10 tornado-6.2 typing-extensions-4.4.0 utm-0.7.0 wcwidth-0.2.5
```
they are probably ok.

Ezward, 2022-10-16:
A more serious issue is that the version of tensorflow we try to install will not install on bullseye
```$ pip install https://github.com/lhelontra/tensorflow-on-arm/releases/download/v2.2.0/tensorflow-2.2.0-cp37-none-linux_armv7l.whl
Looking in indexes: https://pypi.org/simple, https://www.piwheels.org/simple
ERROR: tensorflow-2.2.0-cp37-none-linux_armv7l.whl is not a supported wheel on this platform.
```

Ezward, 2022-10-16:
So I tried using these instructions; https://qengineering.eu/install-tensorflow-2.2.0-on-raspberry-pi-4.html
However, they failed; can't install cython or liblapack because no package candidates.  Then I say this warning at the top of the page:
```TensorFlow 2.2.0 is not supported by Bullseye due to Python 3.9.
Only use the 32-bit Buster operating system with Python 3.7.
Bullseye supports TensorFlow 2.5 and above on a 64-bit RPi.
```
So unless we are moving to tensorflow 2.5, then we cannot support bulleye.

Ezward, 2022-10-16:
just attempting to install using pip does not work either
```$ pip install tensorflow
Looking in indexes: https://pypi.org/simple, https://www.piwheels.org/simple
ERROR: Could not find a version that satisfies the requirement tensorflow
ERROR: No matching distribution found for tensorflow
```

Ezward, 2022-10-16:
For now I think I could ignore tensorflow for the purposes of creating the new camera driver, but I also don't see a need for the new camera driver if we cannot actually run on bullseye because of tensoflow.

TCIII, 2022-10-19:
@Ezward,

I have successfully installed tf 2.7 and OpenCV 4.5.3 on a Rpi 3B+ running the Bullseye 64 bit OS.

Tensorflow was installed using this [tutorial](https://qengineering.eu/install-tensorflow-2.7-on-raspberry-64-os.html).

OpenCV was installed using this [tutorial](https://qengineering.eu/install-opencv-4.5-on-raspberry-64-os.html).
I recommend using a 64GB or larger SD card and make the swap file at least 4GB or larger.
Expect the OpenCV build and installation to take around six and 1/2 hours.

TCIIII

Thread 1053 (2022-10-22):

fix auto-record on throttle for robothat MM1 controller

Ezward, 2022-10-22:
Reported by user `fooOO` in [discord]( https://discord.com/channels/662098530411741184/671604048218292233/1032996525497929748)

"Hi, Has anyone using RoboHAT MM1 and donkeycar 4.3.23? As I have configed the myconfig to record with throttle, but seems like it's not triggering the recording.
...
I did follow the instructions to give the right permission and disabled the nvgetty and I could use RC to control the car and in the Jetson nano serial monitor also output correct pwm info, I think it might be caused by something updated in the donkeycar 4.x, as it used to work with donkeycar 3.x.

BTW I have tried by using the start record button on the web console it seems working properly, so I might just stick to this method."

Ezward, 2022-10-22:
I reviewed the code and it looks like we did not address the robothat controller when we added the code to make the game controllers and web controller cooperate with setting drive mode (user/autosteering/autopilot) and recording mode.  So I ported the code from the joystick controller into the robothat controller.  That is in branch [robothat-auto-record-on-throttle](https://github.com/autorope/donkeycar/tree/robothat-auto-record-on-throttle)

wallarug, 2022-10-22:
Hey @Ezward ,

It's been a few years now since I added this functionality.   So what exactly is still broken that may need my review?

It looks like you have already got a patch/fix in place.

CC: @peterpanstechland (foo00)

Ezward, 2022-10-22:
@wallarug Thanks for commenting.  We added code a while back to make the game controllers and web controller cooperate when changing the drive mode and recording mode.  We did not address the robothat at that time.  This PR https://github.com/autorope/donkeycar/pull/1055 fixes that by porting the code from the game controller to the robothat controller.  Basically we need to latch any  change that is made by the user so it can overrwrite the incoming state in run_threaded() sometime later.  This branch has been tested and shown to fix the issue.

Ezward, 2022-10-26:
Original poster reports that is is fixed https://discord.com/channels/662098530411741184/671604048218292233/1034481825202049157

Closed 2022-10-26.

Thread 1060 (2022-11-12):

Update the imu.py part to improve sensor performance especially the magnetometer

TCIII, 2022-11-12:
Presently the `imu.py` part does not attempt to calibrate and set the calibration of the mpu9250 sensors, especially for the magnetometer.

The magnetometer soft and hard iron distortion can be determined by calibration and set into the mpu9250 greatly improving the accuracy of the magnetometer relative to its operating environment.

Reference: [Intelligent-Vehicle-Perception](https://github.com/Intelligent-Vehicle-Perception/MPU-9250-Sensors-Data-Collect/blob/master/examples/basic-usage/master-only-mode.py)

TCIII

Ezward, 2023-02-06:
Here are some links for integrating IMU and for fusing IMU with GPS

- https://pypi.org/project/droneposelib/. dronepose lib is a python library that will make pose estimates based on IMU data.
- https://pypi.org/project/imusensor/ library to make reading the IMU easy.  Look at the acknowledgements at the bottom of the page.
- https://github.com/micropython-IMU/micropython-fusion micro-python library implements Madgwick
- https://github.com/xioTechnologies/Fusion AHRS fusion in C with Python bindings.  Includes some error rejection.
- https://github.com/smahajan07/sensor-fusion Python fuse GPS with IMU for position and orientation estimation

Ezward, 2023-02-15:
Here is some python code I generated with ChatGPT to use an MPU9250 to generate pose.  Note that I specifically asked to use the mpu9250_jmdev package because that is what we have installed in Donkeycar already, but perhaps there is a better package?

```
#
# Q: write Python code using the mpu9250_jmdev package to do dead reckoning with an MPU9250 imu and include orientation as roll, pitch, yaw
# A: Here's an example of how you can use the mpu9250_jmdev package to do dead reckoning with an MPU9250 IMU and include orientation information as roll, pitch, and yaw.
# This code initializes the MPU9250, sets the orientation to landscape, and sets the sample rate to 100 Hz. It then uses a loop to continuously integrate the acceleration and angular velocity to get the velocity and position. # The orientation is represented as a quaternion and is converted to roll, pitch, and yaw using the quaternion_to_euler_angles function from the mpu9250_jmdev package. The position, velocity, and orientation information are then printed.
#
import mpu9250_jmdev
import time
import numpy as np

# Initialize the MPU9250
imu = mpu9250_jmdev.IMU()

# Set the sample rate to 100 Hz
imu.mpu.requested_rate = 100

# Set the orientation to landscape
imu.orientation = mpu9250_jmdev.Orientation.LANDSCAPE

# Initialize variables for position, velocity, and orientation
pos = np.array([0.0, 0.0, 0.0])
vel = np.array([0.0, 0.0, 0.0])
quat = np.array([1.0, 0.0, 0.0, 0.0])

# Get the time of the first measurement
last_time = time.time()

while True:
    # Get the current acceleration, angular velocity, and orientation
    accel = imu.acceleration
    gyro = imu.gyro
    quat = imu.quaternion

    # Convert the orientation to roll, pitch, yaw
    roll, pitch, yaw = mpu9250_jmdev.quaternion_to_euler_angles(quat)

    # Get the current time
    curr_time = time.time()
    dt = curr_time - last_time

    # Integrate the acceleration to get the velocity
    vel = vel + accel * dt

    # Integrate the velocity to get the position
    pos = pos + vel * dt

    # Do something with the position, velocity, and orientation information
    print("Position:", pos)
    print("Velocity:", vel)
    print("Orientation (roll, pitch, yaw):", roll, pitch, yaw)

    # Update the last time
    last_time = curr_time

    # Wait for the next measurement
    time.sleep(0.01)

```

Ezward, 2023-02-15:
Here is code that only assumes a a 6 axis acc/gyro like an MPU6050 (so no magnetometer).  In integrates (x, y, z) position.  Note that we can simply use prior position and the new position to estimate the orientation.

The code is in Rust, but it's obvious what it is doing.

```
//
// Q: Write rust code for the Raspberry Pi Pico to do dead reckoning with an MPU9250 imu
// A: Here's an example implementation in Rust that implements dead reckoning using an MPU9250 IMU on a Raspberry Pi Pico:
//
use embedded_hal::blocking::delay::DelayMs;
use embedded_hal::spi::{Mode, Phase, Polarity};
use mpu9250::{Mpu9250, SlaveAddr};
use raspberry_pico::{CorePeripherals, Peripherals};
use rppal::spi::Spi;
use std::thread;
use std::time::Duration;

pub fn run(peripherals: Peripherals, core: CorePeripherals) {
    let spi = Spi::new(peripherals.SPI0, SlaveAddr::default(), Mode::Mode0, 8.mhz(), Polarity::IdleLow, Phase::CaptureOnFirstTransition).unwrap();
    let delay = raspberry_pico::Delay {};
    let mut mpu9250 = Mpu9250::new(spi, delay).unwrap();
    mpu9250.accel_config().unwrap();
    mpu9250.gyro_config().unwrap();

    let mut x = 0.0;
    let mut y = 0.0;
    let mut z = 0.0;
    let mut vx = 0.0;
    let mut vy = 0.0;
    let mut vz = 0.0;
    let dt = 0.01;

    loop {
        let accel_data = mpu9250.accel().unwrap();
        let gyro_data = mpu9250.gyro().unwrap();

        let ax = accel_data.x as f32 / 9.80665;
        let ay = accel_data.y as f32 / 9.80665;
        let az = accel_data.z as f32 / 9.80665;

        let gx = gyro_data.x as f32 * 0.0174533;
        let gy = gyro_data.y as f32 * 0.0174533;
        let gz = gyro_data.z as f32 * 0.0174533;

        vx += ax * dt;
        vy += ay * dt;
        vz += az * dt;

        x += vx * dt + 0.5 * ax * dt * dt;
        y += vy * dt + 0.5 * ay * dt * dt;
        z += vz * dt + 0.5 * az * dt * dt;

        thread::sleep(Duration::from_millis((dt * 1000.0) as u64));
    }
}
```

Ezward, 2023-02-15:
Here is an alternative the explicity calculates orientation (pitch, roll, yaw) by integrating the gyro.  Note this is not based on a specific library.

```
#
# Q: write Python code to do dead reckoning with an MPU9250 imu including magnetometer and print (x, y, z) position, (ax, ay, ax) velocity and orientation; print orientation as roll, pitch, yaw.
# A: Here is an example code in Python for dead reckoning with an MPU9250 IMU including magnetometer:
# Note that this code assumes that you have an MPU9250 library that provides functions to read the accelerometer, gyro, and magnetometer data. The code also assumes that the correct orientation can be obtained from the magnetometer data, but the implementation of this correction is not shown here.
#
import time
import math

# Assuming MPU9250 library has been imported

# initialize MPU9250
imu = MPU9250()
imu.initialize()

# Set initial position, velocity, and orientation
x, y, z = (0, 0, 0)
vx, vy, vz = (0, 0, 0)
roll, pitch, yaw = (0, 0, 0)

# Set delta time (time between updates)
delta_t = 0.01 # seconds

while True:
    # Read accelerometer, gyro, and magnetometer data as 3 element arrays (x, y, z)
    accel = imu.getAccel()
    gyro = imu.getGyro()
    mag = imu.getMag()

    # Convert accelerometer data to position
    x += vx * delta_t + 0.5 * accel[0] * delta_t**2
    y += vy * delta_t + 0.5 * accel[1] * delta_t**2
    z += vz * delta_t + 0.5 * accel[2] * delta_t**2

    # Convert gyro data to orientation
    roll += gyro[0] * delta_t
    pitch += gyro[1] * delta_t
    yaw += gyro[2] * delta_t

    # Correct orientation using magnetometer data (not shown here)

    # Update velocity based on accelerometer data
    vx += accel[0] * delta_t
    vy += accel[1] * delta_t
    vz += accel[2] * delta_t

    # Print position, velocity, and orientation
    print("Position: ({:.2f}, {:.2f}, {:.2f})".format(x, y, z))
    print("Velocity: ({:.2f}, {:.2f}, {:.2f})".format(vx, vy, vz))
    print("Orientation: Roll={:.2f}, Pitch={:.2f}, Yaw={:.2f}".format(roll, pitch, yaw))

    time.sleep(delta_t)
```

Ezward, 2023-02-15:
code to convert a quaternion to euler angles (pitch, roll, yaw)
```
#
# Q: Write the quat2euler function required in the previous response
# A: Here's the quat2euler function that can be used to convert quaternion representation of orientation to roll, pitch, yaw representation:
#
def quat2euler(w, x, y, z):
    roll = math.atan2(2 * (w * x + y * z), 1 - 2 * (x**2 + y**2))
    pitch = math.asin(2 * (w * y - z * x))
    yaw = math.atan2(2 * (w * z + x * y), 1 - 2 * (y**2 + z**2))
    return (roll, pitch, yaw)
```

Ezward, 2023-02-15:
Here is code that used the Madgewick algorithm to fuse acc/gyro/mag into a more accurate orientation.  This can be combined with prior examples and integrate acc to produce position so we can estimate a full (x, y, orientation) pose with a more accurate orientation.
```
#
# Q: write Python code using the mpu9250_jmdev package to do dead reckoning with an MPU9250 imu including magnetometer and print position, velocity and orientation; print orientation as roll, pitch, yaw.
# A: Here's an example code in Python that demonstrates how to do dead reckoning with an MPU9250 imu including magnetometer and print position, velocity, and orientation as roll, pitch, yaw:
# Note: This code assumes you have already installed the mpu9250_jmdev package
#
import mpu9250_jmdev
import time

mpu = mpu9250_jmdev.MPU9250()

try:
    while True:
        accel = mpu.read_accel_data()
        gyro = mpu.read_gyro_data()
        mag = mpu.read_mag_data()

        # Use the Madgwick filter to calculate orientation
        orientation = #
# Q: write Python code using the mpu9250_jmdev package to do dead reckoning with an MPU9250 imu including magnetometer and print position, velocity and orientation; print orientation as roll, pitch, yaw.
# A: Here's an example code in Python that demonstrates how to do dead reckoning with an MPU9250 imu including magnetometer and print position, velocity, and orientation as roll, pitch, yaw:
# Note: This code assumes you have already installed the mpu9250_jmdev package
#
import mpu9250_jmdev
import time

mpu = mpu9250_jmdev.MPU9250()

try:
    while True:
        accel = mpu.read_accel_data()
        gyro = mpu.read_gyro_data()
        mag = mpu.read_mag_data()

        # Use the Madgwick filter to calculate orientation
        orientation = mpu9250_jmdev.MadgwickAHRS.MadgwickAHRSupdateIMU(gyro['x'], gyro['y'], gyro['z'], accel['x'], accel['y'], accel['z'])

        # Calculate roll, pitch, yaw
        roll = orientation[0]
        pitch = orientation[1]
        yaw = orientation[2]

        # Print the results
        print("Accelerometer data: X={0}, Y={1}, Z={2}".format(accel['x'], accel['y'], accel['z']))
        print("Gyroscope data: X={0}, Y={1}, Z={2}".format(gyro['x'], gyro['y'], gyro['z']))
        print("Magnetometer data: X={0}, Y={1}, Z={2}".format(mag['x'], mag['y'], mag['z']))
        print("Orientation: Roll={0}, Pitch={1}, Yaw={2}".format(roll, pitch, yaw))

        # Wait for some time
        time.sleep(0.5)

except KeyboardInterrupt:
    pass
(gyro['x'], gyro['y'], gyro['z'], accel['x'], accel['y'], accel['z'], mag['x'],mag['y'],mag['z'])

        # Calculate roll, pitch, yaw
        roll = orientation[0]
        pitch = orientation[1]
        yaw = orientation[2]

        # Print the results
        print("Accelerometer data: X={0}, Y={1}, Z={2}".format(accel['x'], accel['y'], accel['z']))
        print("Gyroscope data: X={0}, Y={1}, Z={2}".format(gyro['x'], gyro['y'], gyro['z']))
        print("Magnetometer data: X={0}, Y={1}, Z={2}".format(mag['x'], mag['y'], mag['z']))
        print("Orientation: Roll={0}, Pitch={1}, Yaw={2}".format(roll, pitch, yaw))

        # Wait for some time
        time.sleep(0.5)

except KeyboardInterrupt:
    pass
```

Ezward, 2023-02-15:
Note that the prior examples do not include necessary calibration.  See this issue https://github.com/autorope/donkeycar/issues/1071

Ezward, 2023-05-23:
```
import mpu9250_jmdev
import time

# Initialize the MPU9250
mpu = mpu9250_jmdev.MPU9250()

# Initialize variables for position, velocity, and orientation
position = [0.0, 0.0, 0.0]
velocity = [0.0, 0.0, 0.0]
orientation = [0.0, 0.0, 0.0]

# Get the time of the first measurement
last_time = time.time()

try:
    while True:
        # Get the accelerometer, gyroscope, and magnetometer data
        accel = mpu.get_accel_data()
        gyro = mpu.get_gyro_data()
        mag = mpu.get_mag_data()

        # Get the current time
        curr_time = time.time()
        dt = curr_time - last_time

        # Integrate the acceleration to get the velocity
        velocity[0] += accel['x'] * dt
        velocity[1] += accel['y'] * dt
        velocity[2] += accel['z'] * dt

        # Integrate the velocity to get the position
        position[0] += velocity[0] * dt
        position[1] += velocity[1] * dt
        position[2] += velocity[2] * dt

        # Get the orientation as roll, pitch, yaw
        orientation = mpu9250_jmdev.quaternion_to_euler_angles(mpu.get_orientation())

        # Print the results
        print("Position: ({:.2f}, {:.2f}, {:.2f})".format(position[0], position[1], position[2]))
        print("Velocity: ({:.2f}, {:.2f}, {:.2f})".format(velocity[0], velocity[1], velocity[2]))
        print("Orientation: Roll={:.2f}, Pitch={:.2f}, Yaw={:.2f}".format(orientation[0], orientation[1], orientation[2]))

        # Update the last time
        last_time = curr_time

        # Wait for some time
        time.sleep(0.1)

except KeyboardInterrupt:
    pass
```

Thread 1071 (2022-12-12):

Improve calibration steps for IMU

Ezward, 2022-12-12:
We call the calibrateMPU6500 method, but we do no calibration of the magnetometer on the MPU9250.  We could do much better and we need to if we want to use the IMU to improve path following.  See this repo for a set of python scripts that do a more thorough calibration https://github.com/makerportal/mpu92-calibration

TCIII, 2022-12-12:
@Ezward,

The makerportal mpu92 calibration documentation is very impressive and through.

TCIII

Ezward, 2023-02-06:
Here are some links for integrating IMU and for fusing IMU with GPS

- https://pypi.org/project/droneposelib/. dronepose lib is a python library that will make pose estimates based on IMU data.
- https://pypi.org/project/imusensor/ library to make reading the IMU easy.  Look at the acknowledgements at the bottom of the page.
- https://github.com/micropython-IMU/micropython-fusion micro-python library implements Madgwick
- https://github.com/xioTechnologies/Fusion AHRS fusion in C with Python bindings.  Includes some error rejection.
- https://github.com/smahajan07/sensor-fusion Python fuse GPS with IMU for position and orientation estimation

Ezward, 2023-02-15:
The driver that we currently use also has calibration methods; https://pypi.org/project/mpu9250-jmdev/

Thread 1073 (2022-12-17):

Add Docker compose feature into this project

salamisodikiolawale, 2022-12-17:
Hello, my friend @rasamymargot@gmail.com would like to contribut in this project for add docker compose feature. This feature permit using projet easily.

Ezward, 2023-02-11:
I think we need to update our README.md to include a process for contributors.  We are glad to accept pull requests, which will be reviewed by the maintainers.  We will also need to test all contributions before we can merge a pull request.  Here is a draft of our contribution guidelines.

Thank you for contributing to the Donkeycar project.  Here are some guidelines that can help you be successful in getting your contributions merged into Donkeycar.

**What makes for a good Pull Request?**
- The code implements a bug fix or optimization/refactor to a preexisting feature or adds a new feature.
- If the code is adding a new feature, it would be advisable to open an Issue in the Donkeycar repo prior to opening the PR.  This would allow discussion on how the feature may be best implemented and even if the feature is something that would get accepted into Donkeycar.  The new feature should have fairly broad applicability; it should be a feature that would be useful to a lot of users.
- The code must work on our currently supported platforms; Raspberry Pi OS and the Jetson Nano for cars and Linux, Mac and WSL on Windows.
- The code should have unit tests.
- The code should work on the version of Python specified in the installation documentation at docs.donkeycar.com
- The PR should include instructions/steps telling how the feature/fix can be tested by a person.  In some cases you may want to create a video and link it from Youtube or Vimeo to show the process; for instance if it includes mounting hardware.
- For new features or changes to preexisting feature you should also open a PR in the documentation repo https://github.com/autorope/donkeydocs with updated docs.  A human tester will want to refer to that when testing.

**What makes for a Pull Request that is not likely to get accepted?**
- It adds a feature that is not useful to a broad audience or is too complex/complicated for the Donkeycar audience.  For instance, it adds a driver for a custom piece of hardware or a piece of hardware that is not generally obtainable.  In this case we will encourage you to maintain the feature in your own fork on Donkeycar and keep that fork up to date with the main branch.
- It does not have unit tests.
- The PR is opened and it receives comments and/or requests for change, but no response is made by the owner of the PR.  In this case we will eventually close the PR as unresponsive.

**Pull Request Process**
- Fork the Donkeycar repository into your own github account.  See [About Forks](https://docs.github.com/en/pull-requests/collaborating-with-pull-requests/working-with-forks/about-forks) in the github docs.
- Create a branch in your repository and make the changes.
- Open a pull request to the Donkeycar main repository.  If it is associated with a github issue then reference the issue in the pull request.  See [Creating a Pull Request from a Fork](https://docs.github.com/en/pull-requests/collaborating-with-pull-requests/proposing-changes-to-your-work-with-pull-requests/creating-a-pull-request-from-a-fork) in the github docs.
  - If the PR is associated with an Issue then link the issue in the PR description.
  - If the PR is associated with a documentation change then link to the associated PR in the documentation repo.
- The maintainers will be automatically notified of the pull request.
- Maintainers will provide comments and/or request for changes in the PR.  This could take a little while; we have a small volunteer team that is working on a number of initiatives.  You can get more visibility by announcing the PR in the software channel on the Discord.
- The owner of the PR should be checking it for comments and/or request for changes and responding.  In particular, if there are requests for changes but you cannot get to them reasonably quickly then add a comment in the PR that helps us understand your timeframe so that we don't close that PR as unresponsive.
- There is a possibility that we choose to not move forward with the PR and it will be closed.  You can minimize that chance by discussing the feature or fix in an Issue prior to opening a PR (see above).
- If once all requested changes are made then the PR can be accepted.  At this point one of the maintainers will merge the PR and the PR will be closed as completed.  Congratulations, you just made the world better.

Ezward, 2023-02-27:
@salamisodikiolawale what is the status here?  Do you plan to open a PR with your proposed fix?

Ezward, 2023-03-09:
Closing as unresponsive.

Closed 2023-03-09.

Thread 1074 (2022-12-17):

Error into  Dockerfile

salamisodikiolawale, 2022-12-17:
Hello, if I have to build a docker image with the current dockerfile project, I get this error:
> [C 08:34:18.925 NotebookApp] Bad config encountered during initialization:
> [C 08:34:18.925 NotebookApp] No such notebook dir: ''/app/notebooks''.

So I propose to solve this error with my current contribution #1073 with  commmand
> **RUN mkdir notebooks**
into Dockerfile if you don't mind.

Ezward, 2023-02-11:
Thank you for contributing to the Donkeycar project.  Here are some guidelines that can help you be successful in getting your contributions merged into Donkeycar.

**What makes for a good Pull Request?**
- The code implements a bug fix or optimization/refactor to a preexisting feature or adds a new feature.
- If the code is adding a new feature, it would be advisable to open an Issue in the Donkeycar repo prior to opening the PR.  This would allow discussion on how the feature may be best implemented and even if the feature is something that would get accepted into Donkeycar.  The new feature should have fairly broad applicability; it should be a feature that would be useful to a lot of users.
- The code must work on our currently supported platforms; Raspberry Pi OS and the Jetson Nano for cars and Linux, Mac and WSL on Windows.
- The code should have unit tests.
- The code should work on the version of Python specified in the installation documentation at docs.donkeycar.com
- The PR should include instructions/steps telling how the feature/fix can be tested by a person.  In some cases you may want to create a video and link it from Youtube or Vimeo to show the process; for instance if it includes mounting hardware.
- For new features or changes to preexisting feature you should also open a PR in the documentation repo https://github.com/autorope/donkeydocs with updated docs.  A human tester will want to refer to that when testing.

**What makes for a Pull Request that is not likely to get accepted?**
- It adds a feature that is not useful to a broad audience or is too complex/complicated for the Donkeycar audience.  For instance, it adds a driver for a custom piece of hardware or a piece of hardware that is not generally obtainable.  In this case we will encourage you to maintain the feature in your own fork on Donkeycar and keep that fork up to date with the main branch.
- It does not have unit tests.
- The PR is opened and it receives comments and/or requests for change, but no response is made by the owner of the PR.  In this case we will eventually close the PR as unresponsive.

**Pull Request Process**
- Fork the Donkeycar repository into your own github account.  See [About Forks](https://docs.github.com/en/pull-requests/collaborating-with-pull-requests/working-with-forks/about-forks) in the github docs.
- Create a branch in your repository and make the changes.
- Open a pull request to the Donkeycar main repository.  If it is associated with a github issue then reference the issue in the pull request.  See [Creating a Pull Request from a Fork](https://docs.github.com/en/pull-requests/collaborating-with-pull-requests/proposing-changes-to-your-work-with-pull-requests/creating-a-pull-request-from-a-fork) in the github docs.
  - If the PR is associated with an Issue then link the issue in the PR description.
  - If the PR is associated with a documentation change then link to the associated PR in the documentation repo.
- The maintainers will be automatically notified of the pull request.
- Maintainers will provide comments and/or request for changes in the PR.  This could take a little while; we have a small volunteer team that is working on a number of initiatives.  You can get more visibility by announcing the PR in the software channel on the Discord.
- The owner of the PR should be checking it for comments and/or request for changes and responding.  In particular, if there are requests for changes but you cannot get to them reasonably quickly then add a comment in the PR that helps us understand your timeframe so that we don't close that PR as unresponsive.
- There is a possibility that we choose to not move forward with the PR and it will be closed.  You can minimize that chance by discussing the feature or fix in an Issue prior to opening a PR (see above).
- If once all requested changes are made then the PR can be accepted.  At this point one of the maintainers will merge the PR and the PR will be closed as completed.  Congratulations, you just made the world better.

Ezward, 2023-02-27:
@salamisodikiolawale what is the status here?  Do you plan to open a PR with your proposed fix?

Ezward, 2023-03-09:
Closing as unresponsive.

Closed 2023-03-09.

Thread 1084 (2023-01-09):

Add support for 4 wheel differential drive trains

Ezward, 2023-01-09:
There are a number of cars that use 4 motors in a differential drive configuration.  It is a simple change to support such cars.  One such car is from Freenove.  I've added an issue in their github, hoping they would implement this; https://github.com/Freenove/Freenove_4WD_Smart_Car_Kit_for_Raspberry_Pi/issues/41  We do have a user [@jjakubassa](https://github.com/jjakubassa) with this car; they have opened a PR for this issue; [add support for four motors differential drive](https://github.com/autorope/donkeycar/pull/1082)

Ezward, 2023-01-09:
@jjakubassa have you been able to collect data and train an autopilot?

jjakubassa, 2023-02-20:
No, I didn't get this far. The car drives left and right as expected, but the turn radius isn't great (at least for the small place I drove in). I think, the radius could be reduced if one side would rotate backwards, as in the driving test in the freenove code. But even with the wide turn radius the vibrations from the friction were too much for the car (wheels or camera falling off). With a different a car design it might work better ([see](https://www.rakeshmondal.info/4-Wheel-Drive-Robot-Design)). Finally, I decided to go with a more standard donkey car build (which works great).

Ezward, 2023-02-27:
Thanks for the response @jjakubassa .  Yes our differential drive code just stops one wheel in the turn, it cannot drive it in reverse.  It is good info to know that these kind of chassis do not work well with donkeycar.  I'm closing the issue.  Thanks.

Closed 2023-02-27.

Thread 1096 (2023-02-15):

Implement calibrated camera images to produce a bird's eye view

Ezward, 2023-02-15:
We suggest a 120 degree to 160 degree camera lens for Donkeycar so the car, which is close to the ground, can still see both sides of the track.  Such a lens creates a distorted image.  This is generally ok in that the neural network can still produce good predictions.  However, it has a number of disadvantages in other use cases;
- It hampers efforts to create more general model using images from many users because they may have different camera lenses and each camera has different inherent distortions.
- It makes it difficult to use an image to figure out the relative position of an obstacle because distances and angles are distorted.

Project:
- Implement a utility to walk the user through getting the necessary image samples of a checkerboard and then calculate the camera calibration matrix.  Ideally it automatically snaps the images so the user does not have to press a button for each image, then it allows the user to decide if any images should be dropped and it more images should be taken, until they are happy.
- Note that this problem has been solved many times so we are not looking for a brand new implementation.  There are many open source projects that have code to do this; we want to use that code and integrate it into donkeycar like the `donkey createcar` or `donkey calibration` command; so add a new command like `donkey camera-calibration` and save the user's calibration in their mycar folder.
- Once we can save calibrations, write a part that will use the calibration to correct the camera image.  It's run() method will take the uncalibrated image and then use the calibration parameters to correct it.
- The corrected image should have an bird's eye view; see [Issue #910](https://github.com/autorope/donkeycar/issues/910) and jump to the section entitled `A Neural Network using 2D Lidar data`.  That project needs a bird's eye view image so it can merge it with 2D lidar data.  The bird's eye view is useful in other ways; it can be used to estimate the angle and distance from an obstacle for instance.
- Once we have a part that will produce bird's eye view images, integrate it into the [deep learning template](https://github.com/autorope/donkeycar/blob/main/donkeycar/templates/complete.py) so we can create an autopilot using bird's eye view images.

cfox570, 2023-02-15:
This might be helpful in the solution. https://docs.opencv.org/3.4.0/d9/dab/tutorial_homography.html#tutorial_homography_Demo3

Ezward, 2023-03-04:
See notes on Issue https://github.com/autorope/donkeycar/issues/97

Thread 1097 (2023-02-18):

Map controller button/axis changes to behavior

Ezward, 2023-02-18:
## Problem Statement

Our current system hard-codes behavior in the joystick parts.  This has unwanted side-effects;
- changes in linux drivers break our button/axis -> behavior mappings.
- users are stuck with the way we have mapped buttons/axis to behaviors; they cannot change which buttons do what (see Note 1 at bottom) and they cannot assign new behaviors.
- The current mappings assume the deep learning template.  However we also have the path follow and computer vision templates and they have very different needs for the controller buttons/axes.  In the near future we will make it easy for users to construct their own 'template'/vehicle and so they will need to decide how buttons should be mapped for their purposes.
- The code is complex, redundant and brittle.  Game controllers are difficult to add or modify because the code does too much.

We know that XBox joystick has different mapping under different SBCs and even within different releases of the OS on a given SBC.  We have split the joystick parts into two pieces;
- **Joystick**: Each kind of controller has a part subclassed from the Joystick() abstract class.  This maps axis (analog) values and button presses (boolean 0 or 1 values) to names.
- **JoystickController**: Each kind of controller also has a part subclassed from the JoystickController() class.  This calls functions and/or sets output values based on the changes in the axes and button states.

Together these two parts effectively map a button code to a function.  The problem is that different drivers for the same controller (different across drive versions or OS versions of SBC versions) output different codes.  So the 'X' button on an xbox controller may be 0x05 on one driver and 0x23 on another.  The breaks everything because the mapping of code to name in the Joystick() may be completely missing or may map to the wrong actually axis or button.  The canonical example is the difference between the x-box controller on RaspberryPi and Jetson Nano.

The other issue is that every JoystickController subclass must implement the behaviors itself.  (1) this is super redundant (2) this makes it very hard to modify what the axes and buttons do (3) this breaks if the driver changes the output codes and see (2). (4) We now have not just the deep learning template; we have the path follow and computer vision templates and they have different needs for the controller should behave.

## Goals:

- Make it easy to handle the fact that the same game controller may publish buttons and axes using different codes on different OS or version of an OS or SBC.
- Make it very easy to remap the behaviors the run when a given button is pressed or joystick is moved.  So make it easy using configuration to change which button toggles recording for instance.
- In the process greatly simplify how we support game controllers.

## Proposed Direction:
Replace hard-coded behavior we have in our controllers with an event system where the controller emits a event with a name and value when an axis/button changes, then an event handler (a part) can handle the event to implement the behavior.
    - We could implement this as a single-stage mapping where low-level codes are mapped directly to high level event names.  So we may map a button with code 0x05 to the 'toggle-recording' event.
    - OR we could implement a two-level mapping where we map low-level controller codes to low-level names, then map low-level names to high level events.  So we have a table that maps low-level button code 0x05 to 'button-1' and then we have a separate part to uses a lookup table to map 'button-1' to the 'toggle-recording'.

Using more generic low-level button names, like 'button-1' means we can assign these simply by asking the `/input/js0` device for the list of axes and buttons, then we just assign names base on order.  This is exactly what `pygame` does.  So then we would map these low level names to high-level events.  That second mapping is the one that we want to design so it is easy to change the mapping in configuration.  We will want a set of lookup tables that handle all of our current cases.

We would still be left with the issue that the button/axis names might differ between drivers.  We can handle differences between drivers by including extra tables.  So we might have 'xbox' lookup table to handle the xbox controller on Raspberry Pi and an 'xbox-jetson' lookup table to handle the same controller on the Jetson because the xbox driver on Jetson outputs a different set of button-#/axis-# names than it does on Raspberry Pi.

Beyond the mapping of low-level codes to high-level events (be that in a single-stage to two-stage system) we need a system that delivers the event to a part that implements the necessary behavior.  So we would have a part that handles toggling the recording state and it would run when we get a 'toggle-recording' event.
- The way I do this in path_follow is that I treat the high-level event name as a latched run_condition; when the event is emitted it is simply added to the vehicle memory using it's name.  Then there is a part that uses that name as it's run_condition; so it will run when the event name is added to the vehicle state.  At the end of the vehicle loop the event will be removed from the vehicle memory; this makes it so it only fires for one iteration the vehicle loop.  This system makes it easy to fix the ordering of event handling relative to other parts; it's just a normal vehicle part with a run_condition; it will run in the order it is added to the vehicle and only when the run condition exists.
- Alternatively we might add a true event pub/sub system. We have to think about the order that things run; a true pub-sub system might run thing in different order at different times.
- Perhaps we compromise and rather than create a full pub-sub system we enhance what we already have to use a 'subscribe=<event-name>' argument when adding a part; the part will run if an event is present with the name; all events are automatically cleared at the end of a vehicle loop.  This is basically like what I did using the run_condition, but it would not overload that system and it might have clearer semantics.  It would have the benefit of working like parts work now, including ordering guarantees.

Note 1: We have the JoystickWizard that creates a custom joystick part that maps low-level code to a low level name. So technically users can remap buttons/axes to existing functions; but they cannot assign new functions.  This is also complex; the Joystick Wizard ends up generating a Python class that it writes the the root of the my_car folder.  If the user change their joystick preference to "custom" then add_user_controller() looks for my_joystick.py in the my_car folder and imports it dynamically.  It would be much better if the wizard just wrote out a lookup table (a standard csv file) and the custom joystick always used that as it's lookup table.  Then we would not have to had the weird code that dynamically load the 'my_joystick.py' part.  The user could easily remap things by editing the file.

DocGarbanzo, 2023-02-18:
@Ezward - this is a very thorough and comprehensive description of the problem and the possible solutions. I had to  prototype a solution already in order to get the generic vehicle template approach to work, where we need to rely on all parts to communicate through the `run()` or `run_threaded()`.

Without spending too much time on a strategic solution, I directly implemented a solution where the controller would simply spit out a map of the buttons that are pressed or released. This map is returned from the `run()` or `run_threaded` method and then one only needs a new generic part, say `ButtonInterpreter` which translates the button map into boolean variables. These variables simply get added to the vehicle memory and can then be used as `inputs` or `run_condition` in other parts. Obviously this requires the updating of some Part's `run()` methods. For example, the `TubWriter` would need an additional `bool` argument to check if it should remove the last `n` records and similar. If we think we might create too many `bool` arguments, then we would need to pass all of them in another dictionary and share that dictionary as input parameter for all parts that allow for some 'special' controller interaction.

Note, I don't think these variables should get cleared at the end of the vehicle loop. The reason is that sometimes the parts topology in the car can become complicated, e.g. for some reason you would want the AI pilot to run before your controller and for some other reason you want to run it afterwards, usually because you have some cyclic dependencies, so part one's (`p1`) input depends on part two's (`p2`) output and `p2`'s input depends on `p1`s output. You simply put these part in the order where in which you want to reduce latency, say `p1` before `p2` and then `p1` will pick up `p2`'s output in the next vehicle loop. For buttons to delete records or switch some behaviour on-the-fly, a one-loop latency is absolutely no problem, but if we were to clear them at the end of the loop we would miss out on using the output like mentioned above.

As you say, the mapping of physical buttons to button names might be platform dependent, so it should be taken care of in the controller itself, I would think.  The mapping of buttons, say `X` to toggle recording should be happening in the vehicle design, because it depends on which vehicle or template you run and which controller you own and what your preferences are. I can also imagine to build an enhanced `ButtonInterpreter` which would allow some debouncing, or latching or distinguish between short and long presses. Something I have started using on my RC control, because it has only a single button (it's 3 channel).

Ezward, 2023-02-19:
@DocGarbanzo can you give me a link to the branch where you are developing generic vehicle template approach?

Ezward, 2023-02-19:
Looking at current Joystick and desired kinds of events, I think the layers wild be

- Joystick tracks low level device events.  This are retrieved, one at a time, by calling the poll() method.  Poll() blocks until an event is available, so it should be called in a thread.  Note that this is NOT a part; it is more like a device driver
  - button_change: (timestamp, button_id, button_value)
      - timestamp is milliseconds
      - button_id is string like, "button_1"
      - button_value is 1 for down and 0 for up
  - axis_change: (timestamp, axis_id, axis_value)
      - timestamp is milliseconds
      - axis_id is string like, "button_1"
      - axis_value is -32767 to 32767

- ControllerEvents - A threaded part that turns low level button_change events into clicks.  The update() continually calls the Joystick.poll() in a thread.  It maintains a two lists; a list of button events and a list of axis events.
  - button_change: these values are simply a pass through of that Joystick.poll() returns.
  - button_click: represents a button_down followed by button_up
    - timestamp is milliseconds of the button_up
    - button_id is string, like "button_1"
    - fast_click is a count of sequential fast_clicks, the number of clicks in sequence where the time between clicks is at or below the quick_threshold.  Basically this indicates double-click, triple-click, etc. without having to have explicit separate events.
    - long_click is a count of sequential long clicks; the number of clicks in sequence whose duration is at or above the long_threshold.
  - axis_change: these values are simply a pass through of what Joystick.poll() returns.
  - The run_threaded() method returns the button and axis event lists and then clears the internal queue to start new lists.

- AxisButtonEvents - A standard (non-threaded) part that takes as inputs the button and axis lists emitted by the ControllerEvents part expands the events into individual events for each button/axis.  This simply takes the most recent button click for a button and the most recent axis change for an axis and publishes them using the name of the button/axis.  For instance, "event/click/button_1" the the most recent button_1 click event.  The data include the timestamp, button_id, fast_click count and long_click count.  For an axis it might be "event/axis/axis_3" and the data would be the timestamp, axis_id and axis_value.

It is possible for parts that implement behavior to use the outputs of the ControlEvents part or the AxisButtonEvents part directly.  However, it may be better to have another layer that turns these device input events into high level events.  For instance, rather than a part that looks in the list of button events for a click event on "button_1" to toggle recording, it would be better to have a part that maps a "event/click/button_1" event to a "toggle-recording" event.

I think we don't want to have to have one part per translation.  Ideally this would be done in a single part.  We could use the order of the list of inputs and outputs as the association; so the first input would map to the first output, etc.  We could get the list of inputs and outputs from configuration.

We still have to deal with the different controller and os versions.  We might create a function that takes in the OS name and configured controller name and uses that to get the correct lookups for event translation.

DocGarbanzo, 2023-02-20:
> @DocGarbanzo can you give me a link to the branch where you are developing generic vehicle template approach?

@Ezward - this is here: https://github.com/DocGarbanzo/donkeycar/tree/part_factory

DocGarbanzo, 2024-01-14:
I have one more comment to the Event System. I think if we add one-shot events to the vehicle memory, these events must be cleared by the part that generates those. Say a one-click event would be registered, only if the button is pressed through at least 2 vehicle loops and or a double click requires at at least 2 vehicle loops between the single clicks. Such an event would be issued when registered from the controller and would be cleared in the next loop. This will allow the parts that react to that event to be placed either before or after the controller in the vehicle loop. I think it is important to have that flexibility, and we already have parts which are issuing data into the memory that will be picked up by other parts only in the next loop, for example the current tub index is read by the webcontroller only in the next iteration. The causal topology structure in the car is not a DAG.

For your questions above, how to correctly recognise short or long or double clicks, I am already using some of this for my channel 3 controller, so I have some code for it. The controller part will issue a different message when pressed long (for me this issues a Ctrl-C like event to stop the vehicle) vs pressing short (which will clear the last 1s of data from the tub).

Ezward, 2024-02-04:
@DocGarbanzo can you share your code with me?

Ezward, 2024-05-28:
A proof of concept is available on branch [1097-refactor-game-controller-system](https://github.com/autorope/donkeycar/tree/1097-refactor-game-controller-system).  I've also opened a [draft pull request](https://github.com/autorope/donkeycar/pull/1180) to make it easier to see the changes and to comment on the code; that PR is not intended to ever be merged.  Please address comments regarding the approach to replacing the legacy joystick code in this issue rather than the PR.  Make comment that are specific to the code in the PR.

This lengthy comment is a discussion of the approach taken to refactoring the joystick code as embodied in the branch.

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

The current Donkeycar game controller code has tightly bound many behaviors, like toggling the pilot mode with a button press or setting throttle with an joystick (axis) movement, to specific controls on specific makes of game controllers.  That legacy design is a problem because we can't remap buttons/axes to different behaviors.  That is a drag for two reasons; first it makes supporting new templates or new template behavior more difficult and second it makes supporting Dirk's declarative vehicle assembly basically impossible.  This POC shows how we can eliminate `JoystickController` completely and instead generate input events that can be handled by standard donkeycar parts. Once we can handle button presses and axis movements with standard parts, then we are open to remapping template behaviors to any input control that we want.  Further, because these behaviors are standard donkeycar parts, they can be assembled using Dirk's declarative syntax.

The first thing we need to do is surface input control changes as one-shot events.  The  POC implements a one-shot event as values in memory that exist for a single complete pass through the vehicle loop and are then removed.  Contrast this to 'normal' memory state, which is persistent for the entire life of the vehicle loop.  We want events to be one-shot so they can trigger code once in the loop when the are emitted and not over and over again on subsequent passes through the loop.

In addition to their one-shot nature, button and axis events must be named in a regular, predictable way so using them as inputs or run_conditions is easy.

We already have a set of classes that can read controller inputs and rename them to something predictable (to the name of the buttons/axes on the game controller that is configured).  That is the set of classes in [controller.py](https://github.com/autorope/donkeycar/blob/main/donkeycar/parts/controller.py) based on the [Joystick](https://github.com/autorope/donkeycar/blob/f81750df7fb626a553e757fd792880721fc7c11e/donkeycar/parts/controller.py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) class.  The 'Joystick' class is specifically to read input events from the linux `/dev/input/js0` device.  There are other classes in controller.py that implement other kinds of controller, like [RCReceiver](https://github.com/autorope/donkeycar/blob/f81750df7fb626a553e757fd792880721fc7c11e/donkeycar/parts/controller.py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) the class that to read buttons and steering/throttle from an RC controller.  This classes don't all conform to a uniform specification because there was not such specification.  The first part of the POC is to create that specification and refactor the code, where necessary to use it.  This begins by creating a standard input controller api, `AbstractInputController`, that all input controllers that want to participate in the input event system must implement.

**`AbstractInputController`**: an abstract class that all input controllers must be derived from.  The most important method is `poll()`, which returns a tuple which can contain one button state hange and one axis state change.  `poll()` must be called continuously to retrieve input changes otherwise device driver buffering can cause problems. This is the method called by InputControllerEvents() it its threaded `update()` loop so input changes are retrieved in the background.

**`LinuxGameController`**: an implementation of `AbstractInputController` for the linux `/dev/input/js0` devices.  The constructor can take a dictionary that maps from device-driver button/axis numbers to human readable button and axis names.  This is how we map to native game controller names for each make of game controller, like button 0x133 -> 'X' or 0x13b -> 'start' and axis 0x03 -> 'right_stick_horz' for the Logitech F710.  So the `LinuxGameController.poll()` method will emit state changes with the mapped button and axis names.  Any button or axis that is not mapped will get a default name based on the device driver control number; for instance the prior button/axis examples would be 'button(0x133)', 'button(0x13b)', 'axis(0x03)' if no mapping is provided for them.

**`LogitechJoystick`**: an implementation of `LinuxGameController` that provides a button/axis mapping for the Logitech F710 game controller.  This provides an example of how we would implement that mapping for the set of game controllers that we want to support directly.

If you look at `LogitechJoystick` you will see that it is verbatum the legacy joystick controller at [parts/controller.py#L694](https://github.com/autorope/donkeycar/blob/f81750df7fb626a553e757fd792880721fc7c11e/donkeycar/parts/controller.py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).  So the refactor at this point is pretty much much a very minor update to what we already have in order to read input control changes from the linux device driver; it really just formalizes the `AbstractInputController` interface so we can implement other kinds of input controllers that can with the new input event system.

The much more important change is in how we use input control changes to trigger code; for instance how we toggle through the pilot modes when a controller button is pressed.  The legacy code includes a set of classes based on [`JoystickController`](https://github.com/autorope/donkeycar/blob/f81750df7fb626a553e757fd792880721fc7c11e/donkeycar/parts/controller.py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) that tightly bind an input control to a specific behavior for each make of game controller.  We can refactor the behaviors hard-coded in `JoystickController` into individual donkeycar parts so they can use the new event system.

**`InputControllerEvents`**: a class that reads input control changes from an `AbstractInputController` by continuously calling its `poll()` method in a thread and turns those into one-shoy axis and button events.  The axis and button events are written into the vehicle memory as outputs so they can be used as inputs or run_conditions by any Donkeycar part. Importantly, the axis/button events that were output to vehicle memory on one pass through the vehicle loop are then removed from vehicle memory on the next pass through the vehicle loop.  This is what makes them 'events'; they do not persist indefinetly in memory, but they do exist long enough for all parts in the loop to have a chance to use them.  In addition to these one-shot events, `InputControllerEvents` also outputs the control's state as a persistent memory value when a control's state changes; this allows the state of one or more controls to be used inputs to a part.

It is worth noting that parts that are added to the loop after the InputControllerEvents is added will see the input events in the same pass through the vehicle loop as when the events were generated.  Parts that are added before the InputControllerEvents part is added will not see the event in memory until the next pass through the loop (so 50ms later assuming the default loop rate of 20hz).  For this reason we should move the addition of the InputControllerEvents to the very top of the vehicle loop.

So the nice part about adding events to memory is that they can be used by other parts as inputs and run_conditions.  So the remaining part of the POC is to show how we can refactor the hard-coded behaviors from the `JoystickController` based parts into individual donkeycar parts that can be trigged to run using input events.  The first example is `TogglePilotMode`, which refactors the code from [JoystickController.toggle_mode()](https://github.com/autorope/donkeycar/blob/f81750df7fb626a553e757fd792880721fc7c11e/donkeycar/parts/controller.py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) into a donkeycar part.

**`TogglePilotMode`**: a donkeycar part that increments the pilot mode once each time its `run()` method is called.  The pilot mode is incremented through this sequence; user -> local_angle -> local -> user -> etc.  Since the `run()` method will increment the mode each time it is called, it should only be called when the mode should be changed; so the part should be added with a run_condition that will trigger it to run when the mode should be incremented.  The most common time we would want that to happen is when an input controller button is pressed. For instance, if pressing 'button1' toggles the pilot mode, then the run condition should be `run_condition="/event/button/button1/press"` or if a double-click of the 'Y' toggles the pilot mode, then the run condition should be `run_condition="/event/button/Y/click/2"`.  Since the `TogglePilotMode` parts is supposed to change the pilot mode, it must take in the current value as an input and output new incremented value.  So adding the part would look somethin like:
```
    V.add(TogglePilotMode(), inputs=['user/mode'], outputs=['user/mode'], run_condition='/event/button/button1/press')
```

The run_condition combined with the event semantics enforced by `InputControllerEvents` where the event exists for exactly one full pass throught the vehicle loop guarantees that the toggle parts will be run only once when the assocated button event happens.  A similar pattern would be used to refactor the logic that toggles recording on and off (note that there is already a [`ToggleRecording`](https://github.com/autorope/donkeycar/blob/f81750df7fb626a553e757fd792880721fc7c11e/donkeycar/templates/complete.py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) part, but it is not what we want and it can be eliminated with individual parts that are triggered with events.

Sometimes we want to happen while a button is pressed or not pressed.  Or we might like to use one button as a modifier to another button's event, like a shift key.  For a button we can do this using the persistent state of the control.  For buttons this is a key, like `/button/X` which has the value 1 when that button (in this case the 'X' button) is pressed and 0 when it is not pressed.  In the case of an axis, we might want to use the value of the axis as a continous input so our part does not need maintain axis state by listening to axis events.  For axes a key like `/axis/right_stick_horz` would have the value of the axis as a float in the range -1 to 1.  The `StopVehicle` part in the POC uses this technique to create a 'gesture' for quitting the vehicle using a game controller

**`StopVehicle`**: a donkeycar part that quits the vehicle loop when it runs and a specific key is held down.  To avoid accidentally quitting, a key event can be used as the run_condition and a key state can be used as an input to indicate if the part should quit.  For instance, if the run_condition is a double-click event from the 'B' key and the input state is from the 'X' key, then the part will only quick when 'B' is double-clicked while holding down the 'X' button.

There are cases where, rather than use a run_condition, it would be better to take the events as inputs.  For instance, a part may already have a run_condition, but still needs to respond to a control event.  For another instance, a part may need to response to more than one button; this can simplify parts that would otherwise need to be separate parts that share state via memory.  Another example would be a part that wants to do something when a axis changes but does not want to run _unless_ the axis changes; in that case it can use the axis event as both a run condition _and_ as an input - the part will only run when the axis changes and the new value will be provided as an input.  The `UserThrottle` and `UserSteering` parts in the POC use this technique to minimize how often the part is executed.

**`UserThrottle`**: a donkeycar part that takes in an axis value and outputs a throttle value.  The part only needs to run when the associated axis emits an axis event; this can be done by using the axis event as both the input and the run_condition; the part will only run when the axis changes and the new value will be the input value.

**`UserSteering`**: a donkeycar part that takes in an axis value and outputs a steering value.  The part only needs to run when the associated axis emits an axis event; this can be done by using the axis event as both the input and the run_condition; the part will only run when the axis changes and the new value will be the input value.

So the input state and event semantics give quite a lot of flexibility while still leaving most cases simple.

The __main__ in the POC implements two modes.  By default it constructs a Vehicle loop by adding parts and starting the loop.  It can also be run in a mode that simulates the vehicle loop and output more detailed information on what events are emitted.  When run in this second mode, the format of the button and axis events and the order they are emitted can be seen.

Here are two separate clicks of the 'Y' button.  The clicks are separated by enough time that each is considered a single click indicated by the suffix '/click/1'.  Note how each click represents a completed press->release sequence; the 'press' and 'release' events are emitted just before the 'click' event.
```
'/event/button/Y/press' = '1716844802.4654794'
'/event/button/Y/release' = '1716844802.6975334'
'/event/button/Y/click/1' = '1716844802.6975334'
'/event/button/Y/press' = '1716844803.0975556'
'/event/button/Y/release' = '1716844803.4575663'
'/event/button/Y/click/1' = '1716844803.4575663'
```

The value of each button event is the time at which is was received.  Generally this is not a value that is needed; the InputControllerEvents part does the work of matching presses and releases and detecting ad counting multiple clicks.  However, if your part is interested a specific
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

Thread 1098 (2023-02-20):

Intel RealSense Depth_image problem

Ahrovan, 2023-02-20:
Hello

**Only color_images are saved. Depth_image are not saved. Please suggest a simple solution. Thank you**

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

**Related My CAR CONFIG (D435i+donkey v4.4.dev4)**

```
# #CAMERA
CAMERA_TYPE = "D435"   # (PICAM|WEBCAM|CVCAM|CSIC|V4L|D435|MOCK|IMAGE_LIST)
IMAGE_W = 424
IMAGE_H = 240
# IMAGE_DEPTH = 3         # default RGB=3, make 1 for mono

# # Intel Realsense D435 and D435i depth sensing camera
REALSENSE_D435_RGB = True       # True to capture RGB image
REALSENSE_D435_DEPTH = True     # True to capture depth as image array
REALSENSE_D435_IMU = False      # True to capture IMU data (D435i only)
# REALSENSE_D435_ID = None        # serial number of camera or None if you only have one camera (it will autodetect)
#
```

I see Depth_image clear in Code like this, but not saved
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

Ezward, 2023-02-20:
@Ahrovan the depth images should be saved at 16bit png files.  Are there any .png files in the images folder?

Ahrovan, 2023-02-20:
@Ezward
no all *.jpg files (Screanshot sent above)

Ezward, 2023-02-20:
@Ahrovan This must have gotten broken when the tub format was updated.
Yes, I just checked the code; the data type for the png is not there.  I can fix this tonight.

Ezward, 2023-02-20:
It is in version 4.1, but that saves the old tub format.   I'll port the code snippet to latest at lunch and you can try on a branch.
```
            elif typ == 'gray16_array':
                # save np.uint16 as a 16bit png
                img = Image.fromarray(np.uint16(val))
                name = self.make_file_name(key, ext='.png')
                img.save(os.path.join(self.path, name))
                json_data[key]=name
```
That snipped needs to be added to tub_v2.py at around line 65, after the `elif input_type == 'image_array':` clause.

https://github.com/autorope/donkeycar/blob/c4d90910e0e1b5056dc8961a09c7e5eb1ba18ffe/donkeycar/parts/tub_v2.py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

Ezward, 2023-02-20:
@Ahrovan I went ahead and made that change.  it is is this branch [1098-fix-saving-D435-depth-image](https://github.com/autorope/donkeycar/tree/1098-fix-saving-D435-depth-image).  From inside your donkeycar repo folder you can checkout the branch it that should fix the problem `git checkout 1098-fix-saving-D435-depth-image`

Ahrovan, 2023-02-20:
@Ezward thank you. I will check and send result here

Ezward, 2023-02-22:
@Ahrovan any results yet?

Ahrovan, 2023-02-23:
@Ezward
Just modify ext to extension and for apply any filter from cv, change uint16 to uint8 (tub_v2.py)
 ```
               elif input_type == 'gray16_array':
                    # save np.uint16 as a 16bit png
                    image = Image.fromarray(np.uint8(value))
                    name = Tub._image_file_name(self.manifest.current_index, key, extension='.png')
                    image_path = os.path.join(self.images_base_path, name)
                    image.save(image_path)
                    contents[key]=name
```

for cv ColorMap (realsense435i.py)
```
            self.depth_image_r = np.asanyarray(depth_frame.get_data(), dtype=np.uint16) if self.enable_depth else None
            self.depth_image= cv2.applyColorMap(cv2.convertScaleAbs(self.depth_image_r, alpha=0.01, beta=0), cv2.COLORMAP_JET)
```

[cv2.COLORMAP_JET](https://docs.opencv.org/3.4/d3/d50/group__imgproc__colormap.html) can use as parameter in myConfig.py.

and for modify image size (manage.py)
need to add IMAGE_W and IMAGE_H and IMAGE_DEPTH here:

```
cam = RealSense435i(
            enable_rgb=cfg.REALSENSE_D435_RGB,
            enable_depth=cfg.REALSENSE_D435_DEPTH,
            enable_imu=cfg.REALSENSE_D435_IMU,
            device_id=cfg.REALSENSE_D435_ID)
```

Ezward, 2023-02-23:
The issue with `uint8` is that it looses accuracy, that is why I am saving it as a png.

Ahrovan, 2023-02-23:
cv2.convertScaleAbs() function returns uint8. In this case, np.uint16 gives an error. should be changed to uint8. The main problem is the need to use COLORMAP_JET or more precisely colormap. Yes, uint16 has better quality. But the problem is that the depth output does not have a suitable range, it must be corrected. Duplicate values can be seen on depth.

Ezward, 2023-02-23:
@Ahrovan "Duplicate values can be seen on depth"  What do you mean?  There will certainly be some pixels that have the same depth as others; that would be normal.

To be clear, the depth image is NOT a visualization.  It is data.  It is the depth of each pixel in the RGB image as a 10bit value.

Ezward, 2023-02-23:
You can see that the test program does create a visualization; https://github.com/autorope/donkeycar/blob/c4d90910e0e1b5056dc8961a09c7e5eb1ba18ffe/donkeycar/parts/realsense435i.py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

Ezward, 2023-02-23:
There is an issue though; I don't save off the depth scale, so we have 10 bits of resolution, but without the depth scale it can't be converted back into meters.  The driver does print out the depth scale when it runs, but it is not saved anywhere.  A better format would just save out a 2d array of floats which represent the depth in meters for each pixel in the RGB image.

Ezward, 2023-02-27:
For now I'm going to save the data as-is, as a 16bit grayscale png.  The data can be easilly loaded by opencv or other that will load a png and the resulting image can be queried by pixel to get the distance in centimeters of that pixel.

Ezward, 2023-02-27:
@Ahrovan can you confirm that the greyscale data is being saved?

Ezward, 2023-03-06:
closed as unresponsive.

Ahrovan, 2023-03-07:
Please check this line
                   name = Tub._image_file_name(self.manifest.current_index, key, extension='.png')

or
                   name = Tub._image_file_name(self.manifest.current_index, key, ext='.png')

ext
or
extension
?
(https://github.com/autorope/donkeycar/pull/1106)
@Ezward

Closed 2023-03-06.

Thread 1104 (2023-02-26):

train done -Always no result

Ahrovan, 2023-02-26:
using donkey v4.4.dev6 ...

I have not been able to train and run for several days. I doubted my data. Finally, I repeated the work of train with your data

- [sim_warehouse_manual.tar.gz](https://github.com/autorope/donkey_datasets/blob/master/large_dataset/sim_warehouse_manual.tar.gz)
- myconfig.py not changed just added three lines
```
DONKEY_GYM = True
DONKEY_SIM_PATH = "...../projects/DonkeySimWin/donkey_sim.exe"
DONKEY_GYM_ENV_NAME = "donkey-generated-track-v0"
```
- Pilot throttle and angle always is constant or wrong
- please check and provide a solution.

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

Ezward, 2023-02-26:
I've made a change to the deep learning template that caused this.  It is saving steering data as 'user/steering' rather than 'user/angle'.  I've made a fix in this branch so that future data will again be recording as 'user/angle' https://github.com/autorope/donkeycar/tree/1104-fix-user-angle-in-deep-learning  Please give that a try and let me know if it is recording data correctly.  I'll look into how to fix the data that has been recorded as 'user/steering'

Ezward, 2023-02-27:
@Ahrovan Given the 'user/steering'->'user/angle' bug that was just fixed, can you checkout the latest main and rewrite your mycar folder (or whatever folder you use for the donkeycar application).  So from the root of your donkeycar repo:
```
git checkout main
donkey createcar --overwrite --path=<path-to-your-mycar>
```
and give it another try.

Ezward, 2023-02-27:
PS: I gathered data, trained and ran autopilot using the new code.  Remember that the steering data is labelled as 'user/angle' so if you changed that to 'user/steering' then you should change it back.

Ahrovan, 2023-02-27:
[sim_warehouse_manual.tar.gz](https://github.com/autorope/donkey_datasets/blob/master/large_dataset/sim_warehouse_manual.tar.gz) extracted again.

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

Ezward, 2023-02-27:
@Ahrovan Can you try training using the command line?  See https://docs.donkeycar.com/guide/deep_learning/train_autopilot/#train-a-model  That way we can see if it is DonkeyUI or the donkeycar train command itself.

PS: I trained a model yesterday from the command line on a Mac and it worked file.

Ezward, 2023-02-27:
@Ahrovan Also are you training a 'linear' model but running it as a 'categorical' model; that is what I see in the screen captures above.

Ahrovan, 2023-02-28:
@Ezward no, but is linear. Problem just related to recording. I know but need to same

Ahrovan, 2023-02-28:
@Ezward @DocGarbanzo

Python 3.7.16 | donkey v4.4.dev6 | tensorflow '2.2.0' | windows | linear model | Created New Conda Env today

- train always finish without any Error.
`INFO:donkeycar.parts.interpreter:Convert model C:\Users\Hadi\workspace\mycar\models\mypilot.h5 to TFLite C:\Users\Hadi\workspace\mycar\models\mypilot.tfl
`
- tested with donkey ui and command line
- [sim_warehouse_manual.tar.gz](https://github.com/autorope/donkey_datasets/blob/master/large_dataset/sim_warehouse_manual.tar.gz) used
- [h5 file ] 9,661 KB after train completed

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

Ezward, 2023-02-28:
@Ahrovan that does look wrong.  Can you try running tubplot with your model and data to see what it outputs; https://docs.donkeycar.com/utility/donkey/#plot-predictions

Ezward, 2023-02-28:
Please also check your data again; I believe you renamed 'user/angle' to 'user/steering';  if you did you need to restore it to 'user/angle'.

Ahrovan, 2023-02-28:
[sim_warehouse_manual.tar.gz](https://github.com/autorope/donkey_datasets/blob/master/large_dataset/sim_warehouse_manual.tar.gz) extracted without any change.
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
**'user/angle' exist.**

Ahrovan, 2023-03-01:
@Ezward The problem is related to train with gpu. If train operation is done with cpu, the problem will be solved.

- No error is reported during tarin with GPU. But the result has a fixed value.
- cuda is installed correctly.
- cudnn is installed correctly.
- Our GPU is from Nvidia series.
**- Important >> This problem occurred in Jetson Device Like NX, Nano** and PC, Windows and Ubuntu, WSL2

Ezward, 2023-03-01:
@Ahrovan can you try to train with an earlier version of donkeycar so we can see if it is a recently introduced bug?  Maybe checkout tag `4.3.6.2` or `4.4.0`

Ahrovan, 2023-03-02:
Report - donkey v4.4.dev6 worked on Jetson NX - Trained with GPU

Ezward, 2023-03-03:
to summarize
- train on cpu works
- train with v4.4.dev6 on Jetson NX GPU works
- train with TensorFlow version 2.3.1 | donkey v4.4.dev6 | windows | h5 model produces constant throttle/angle.  Assume training using GPU?
- train with Python 3.7.16 | donkey v4.4.dev6 | tensorflow '2.2.0' | windows | h5 model produces constant throttle/angle.  Assume training using GPU?

Is that correct?

On the failing system can you train using the command line and copy the console output here?

Ahrovan, 2023-03-03:
- donkey ui with GPU = wrong pilot play (Video first part)
- donkey ui without GPU = True result (Video second part)

This shows that the model has no problem. Only the ui display has a problem. I have tested this model on the robot. Robot runs without problems

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

Ezward, 2023-03-03:
Except that you also did a tubplot and it also showed constant throttle and steering.

Ahrovan, 2023-03-04:
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
[log.txt](https://github.com/autorope/donkeycar/files/10887869/log.txt)

Ezward, 2023-03-06:
I don't understand what is happening in the prior comment; can you add an explanation?

Ezward, 2023-03-11:
Maybe you are saying one of the modes is always getting that bad record NaN error?  And a white screen.  Is that the same thing that was going on before?  It looks different.

Ahrovan, 2023-03-12:
yes, white screen is related model trained with GPU always getting bad record NaN error. yes, i don't know

Ezward, 2023-03-13:
@DocGarbanzo have you seen this issue before in the DonkeyUI?  Do you know what this might be?

Ahrovan, 2023-03-16:
Problem solved.
cudnn 8.1 CUDA 11.2 TensorFlow 2.5 (CUDA >= 11)
now I am working on compatibility issues on Host and Jetson platform.

Ezward, 2023-03-18:
Great. I am glad you have a solution.  Closing this issue.

Closed 2023-03-18.

Thread 1108 (2023-03-02):

adafruit_python_pca9685 and adafruit_circuitpython_pca9685 conflict

quebeh, 2023-03-02:
Hey guys, i want to use the newer [adafruit_circuitpython_pca9685](https://pypi.org/project/adafruit-circuitpython-pca9685/) library for other utilities. But it seems like donkeycar is using the old, deprecated library [adafruit_python_pca9685](https://pypi.org/project/Adafruit-PCA9685/).

Is there any replacement for donkeycar.parts.actuator.PWMThrottle (ESC module) that uses the new library?
I have tried to download the old one's source code, but it seems like having both the modules having its own instances of PCA9685 objects will reduce the efficiency.

Any help is appreciated
Thank you

Ezward, 2023-03-02:
We have no plans to change that library, but we are definitely open to accepting a PR.

The old [PCA9685](https://github.com/autorope/donkeycar/blob/08adc76ec184dd6a0dde1c8f53aa82aaa8b5204c/donkeycar/parts/actuator.py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) class is being deprecated in favor of [PulseController](https://github.com/autorope/donkeycar/blob/08adc76ec184dd6a0dde1c8f53aa82aaa8b5204c/donkeycar/parts/actuator.py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) which takes a [PwmPin](https://github.com/autorope/donkeycar/blob/08adc76ec184dd6a0dde1c8f53aa82aaa8b5204c/donkeycar/parts/pins.py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) which can source Pwm from GPIO or PCA9685.  That is what [PWMSteering](https://github.com/autorope/donkeycar/blob/08adc76ec184dd6a0dde1c8f53aa82aaa8b5204c/donkeycar/parts/actuator.py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) and [PWMThrottle](https://github.com/autorope/donkeycar/blob/08adc76ec184dd6a0dde1c8f53aa82aaa8b5204c/donkeycar/parts/actuator.py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) use to source the PWM signal.  So there is no need to touch those; you want to change the implementation of the PCA9685 pwm pin at [PwmPinPCA9685](https://github.com/autorope/donkeycar/blob/08adc76ec184dd6a0dde1c8f53aa82aaa8b5204c/donkeycar/parts/pins.py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).

"both the modules having its own instances of PCA9685 objects will reduce the efficiency"

You are correct that the [PwmPinPCA9685](https://github.com/autorope/donkeycar/blob/08adc76ec184dd6a0dde1c8f53aa82aaa8b5204c/donkeycar/parts/pins.py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) implementation does use one PCA9685 instance per pin via the factory method [pca9685](https://github.com/autorope/donkeycar/blob/08adc76ec184dd6a0dde1c8f53aa82aaa8b5204c/donkeycar/parts/pins.py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).  I don't think this is an issue but you are free to change that implementation detail if you decide to open a PR.

quebeh, 2023-03-03:
Alright. Thank you very much. I'll get a better understanding of the pins.py code and possibly make a pull request.

Closed 2023-03-03.

Thread 1109 (2023-03-04):

Refactor Image Augmentations/Transformation to use parts

Ezward, 2023-03-04:
Currently image augmentations and transformation are a fixed set.  There is no way to add a custom augmentation or transformation without changing core code.  We can do better.

This was initiated after talking to a user on Discord that wanted to add Canny edge detection as a transformation.  They ended up just hacking the camera part to apply the Canny algorithm on the way out; so they end up with transformed data in their data sets, which is not ideal.

Goal:
- make it easy to add a custom augmentation or transformation to the training and inference pipelines.
- make it easier to maintain the training and inference pipelines; pulling code out of it and into a place where it can be more easily maintained.  As an example, we have a nasty bug caused by imgaug on the Jetson that makes it impossible to use cropping; it should be easy to work around this for even fix this.
- make code more composable and reusable.  We have a lot of parts in `cv.py` that could be used for augmentation or transformation. For instance, we have a part that will apply Canny edge detection to an image.  It takes an image in the run method and returns an image.  It was designed as a useful part for the computer vision template.  However, that should also be very easy to reuse as transformation.
- Make it easier for community to contribute.  Regarding hacking the camera part to apply the Canny algorithm; there is no way we would accept a PR that did that, so we cannot leverage that user's innovation.
- It would be ideal is user's did not have to change their configuration that uses the current standard set of augmentations and transformations.
- This could make it easy to do this in a declarative way; like we intend to do for vehicle construction.

Tasks:
- refactor the current augmentations and transformations into parts.  The constructor will take in whatever configuration is needed.  The `run()` method will take an image and return an image.
- implement a way in the pipeline code (`augmentations.py`) to add a part with a name to the pipeline.  So a part would be constructed, then `add(name, part)` method would be called with a name and the part instance, similar to how we add a part to the vehicle loop.  The pipeline would keep a dictionary of named parts that had had been added.
- Change how we manage the augmentations and transformations.  Current the pipeline uses what is effectively a switch/case statement in [`donkeycar/pipeline/augmentations.py`](https://github.com/autorope/donkeycar/blob/08adc76ec184dd6a0dde1c8f53aa82aaa8b5204c/donkeycar/pipeline/augmentations.py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).  Instead we will have a dictionary and we will lookup the part using it's name.
- Change how augmentation/transformation is applied.  The current augmentations/transformation call [`aug_img_arr = self.augmentations.augment_image(img_arr)`](https://github.com/autorope/donkeycar/blob/08adc76ec184dd6a0dde1c8f53aa82aaa8b5204c/donkeycar/pipeline/augmentations.py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); so the `augment_image()` method takes an image and returns an image.  This would be replaced by the part's `run(self, image)` method which would take an image and return an image.
- add code in `complete.py` that adds the standard augmentations and transformations to the pipeline using the current names as specified in [`cfg_complete.py`](https://github.com/autorope/donkeycar/blob/08adc76ec184dd6a0dde1c8f53aa82aaa8b5204c/donkeycar/templates/cfg_complete.py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).  This is how we handle backwards compatibility with folks' current `myconfig.py`.

I think that is all we need to do.  With that in place a user could add code to their manage.py to add a new augmentation or transformation using one of the cv.py parts or a part of their own creation.

PS: this is a way we can fix the imgaug issue as well; https://github.com/autorope/donkeycar/issues/970

Ezward, 2023-03-08:
See Branch https://github.com/autorope/donkeycar/tree/1109-refactor-augmentations and PR https://github.com/autorope/donkeycar/pull/1111

Ezward, 2023-03-21:
merged PR https://github.com/autorope/donkeycar/pull/1111

Closed 2023-03-21.

Thread 1112 (2023-03-10):

Support for Jetpack 4.6/5.1

thielepaul, 2023-03-10:
The donkeycar docs say that only jetpack 4.5.1 is currently supported: https://docs.donkeycar.com/guide/robot_sbc/setup_jetson_nano/

I would be interested, what the issues with newer jetpack versions such as 4.6 or 5.1 are and which steps would be necessary to get it working with the latest jetpack versions?

TCIII, 2023-03-10:
@thielepaul,
Unfortunately JP5.x will not run on a Nano 4GB Developer Kit though it will run on a Nano Orin SOC.
I have JP5.02 installed on a Xavier NX 8GB running DC 4.4.dev4.

I believe that JP4.6.1/2 is the last JP version that will run on the Nano 4GB Developer Kit and we are presently testing the DC tf_2_9 branch for the installation of DC 4.4.dev6 on JP4.6.1/2.
The tf_2_9 branch installs Python3.9, tf2.9 and opencv4.6 + GStreamer on JP4.6.1/2 using a Mambaforge environment in place of the Python environment.
We built a tf2.9 wheel for Python3.9, but opencv4.6 + GStreamer must be built from source which takes about two hours.
We are presently beta testing the DC JP4.6.1/2 installation instructions and should be able to push tf_2_9 into the DC main branch shortly.

TCIII

TCIII, 2023-03-10:
@thielepaul,

Hopefully you are familiar with CMake to build opencv4.6 + GStreamer from source.
I tried to build a wheel for opencv4.6 + GStreamer but was unsuccessful no matter what we tried.
I recommend having a fan on the Nano 4GB heat sink and the Nano plugged into a 5 vdc power supply using a UPS as the build portion uses all four processors and takes about two hours.
We had to build opencv4.6 + GStreamer from source because the conda version of opencv4.6 does not include GStreamer.
It took over 81 hours to successfully build the tensorflow 2.9 wheel.

TCIII

thielepaul, 2023-03-10:
Yes, it would be a far nicer use experience, if it would not be necessary to build it manually :grimacing:

Is it maybe possible to use a different base os, e.g. armbian so we can just install the packages in more recent versions from the distro repositories? https://www.armbian.com/jetson-nano/
latest download: https://github.com/armbian/community/releases/download/202307/Armbian_23.02.0-trunk_Jetson-nano_lunar_edge_6.2.0-rc6.img.xz
This seems to come with opencv4.6: https://packages.ubuntu.com/lunar/python3-opencv

I just started playing around with the jetson nano yesterday so I haven't tried much so far (I got DC 4.4 running on jetpack 4.5.1)

TCIII, 2023-03-11:
@thielepaul

Tensorflow 2.9 and opencv 4.6 are fairly recent versions, though not the latest, and have been found to work well with the DC training.
I doubt that armbian will be considered as a replacement for JP4.6.1/2/Ubuntu 18.04 as it is well supported by the IoT.

TCIII

Ahrovan, 2023-03-17:
Why not send us a basic manual for installing JP46 and TF29?
 Do we have to try and make mistakes ourselves?

TCIII, 2023-03-18:
@Ahrovan,
Are you willing to spend two hours building and installing opencv4.6 + GStreamer?
I run my Nano's 5 vdc power supply on a UPS so that powerline glitches and outages will not affect the building and installing opencv4.6 + GStreamer with CMake.
Additionally, we had to use mambaforge, in place of the Python env, to be able to install Python 3.9. Some users don't like conda.

TCIII

Ahrovan, 2023-03-18:
I am working about 1days on  ---JP46
It doesn't matter.
It will help if you provide how to do it.

TCIII, 2023-03-18:
@Ahrovan,

I am just a software/hardware tester who validated the DC tf_2_9 branch installation instructions so it will be up to DocGarbanzo as to the release of the Beta installation instructions.

TCIII

DocGarbanzo, 2023-03-20:
@Ahrovan - there is a branch `Update-to-tf-2_9` in the donkeydocs repo which contains the installation instructions for the `tf_2_9` branch. Feel free to try this out and let us know if you run into any problems because @TCIII and me are still updating these instructions.

Ahrovan, 2023-03-21:
@DocGarbanzo
Can not find instruction for install tensorflow for Jetson. Please help me how to install this for related JP. and JP must be 4.6 or 50 or ...

TCIII, 2023-03-22:
@Ahrovan,

Could you please the document the "with small changes in install steps"?

TCIII

DocGarbanzo, 2023-03-31:
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

If you don't do the changes mentioned here, does the install fail? Could you paste the error?

TCIII, 2023-03-31:
@DocGarbanzo,

`./Mambaforge-Linux-aarch64.sh` S/B `bash ./Mambaforge-Linux-aarch64.sh`

TCIII

TCIII, 2023-03-31:
@DocGarbanzo,

I have a spare Xavier NX that is running an older version of DC that I can attempt to install JP502 and the DC tf_2_9 branch this weekend.

TCIII

TCIII, 2023-03-31:
@Ahrovan,

Are you using your Xavier NX for training or driving? I use mine for training only.

Are you using a SSD with your Xavier NX?

I am running a 250 GB SSD on my Xavier NX and I have JP booting up on the SSD.

I did not install the swap file on the Xavier NX until I had JP booting up on the SSD.

I used the attached file to create a 8 GB swap file in addition to the 3.3 GB of zram.

[Create swap file on Xavier NX.txt](https://github.com/autorope/donkeycar/files/11127161/Create.swap.file.on.Xavier.NX.txt)

Ahrovan, 2023-04-01:
@TCIII
- Xavier NX for training and driving
- SSD, yes
- 128G SSD

@DocGarbanzo
My changes is not very important. main steps is correct. Just need some small modify. i will share Error if check Again

TCIII, 2023-04-01:
@Ahrovan,

Are you booting JP from the SSD?

If so, did you create a 6 GB swap file before or after moving JP from the microSD car to the SSD?

TCIII

Ahrovan, 2023-04-01:
@TCIII
Yes, booting from SSD

- First install OS on eMMC
- move eMMC to SSD
- Install JP
- Install DK (branch Update-to-tf-2_9)

TCIII, 2023-04-01:
@Ahrovan
Re: "just for test, donkey ui, don't work properly in JP502 @TCIII @DocGarbanzo"

Is this the error that you are seeing when you run `donkey ui` on the CLI:
`WARNING:kivy:stderr: ModuleNotFoundError: No module named 'kivy._clock`

I think I know what the problem is in the donkey ui Python code.

TCIII

Ahrovan, 2023-04-01:
@TCIII At first yes;  But later, some buttons did not work in the ui.  More related to

TCIII, 2023-04-02:
@Ahrovan,

How did you resolve the error and have donkey ui load successfully?

TCIII

Ahrovan, 2023-04-02:
@TCIII No. need to check later, donkey ui load, but "pilot arena" tab had problems.

TCIII, 2023-04-03:
@Ahrovan,

Could you please activate the donkey env, run `conda list`, and report what are the `kivy-jetson` and `kivy-garden` versions.

TCIII

Thread 1122 (2023-04-17):

[solved] [tf_2_9] Bad Jetson.GPIO version

BrianHenryIE, 2023-04-17:
When I tried to calibrate my car, I got the error `The current user does not have permissions...`

`$ donkey calibrate --pwm-pin=PCA9685.1:40.1`

```
________             ______                   _________      
___  __ \_______________  /___________  __    __  ____/_____ ________
__  / / /  __ \_  __ \_  //_/  _ \_  / / /    _  /    _  __ `/_  ___/
_  /_/ // /_/ /  / / /  ,<  /  __/  /_/ /     / /___  / /_/ /_  /
/_____/ \____//_/ /_//_/|_| \___/_\__, /      \____/  \__,_/ /_/
                                 /____/                      

using donkey v5.0.dev1 ...
Traceback (most recent call last):
  File "/home/brian/mambaforge/envs/donkey/bin/donkey", line 33, in <module>
    sys.exit(load_entry_point('donkeycar', 'console_scripts', 'donkey')())
  File "/home/brian/projects/donkeycar/donkeycar/management/base.py", line 626, in execute_from_command_line
    c.run(args[2:])
  File "/home/brian/projects/donkeycar/donkeycar/management/base.py", line 219, in run
    from donkeycar.parts.actuator import PulseController
  File "/home/brian/projects/donkeycar/donkeycar/parts/actuator.py", line 19, in <module>
    import RPi.GPIO as GPIO
  File "/home/brian/mambaforge/envs/donkey/lib/python3.9/site-packages/RPi/GPIO/__init__.py", line 1, in <module>
    from Jetson.GPIO import *
  File "/home/brian/mambaforge/envs/donkey/lib/python3.9/site-packages/Jetson/GPIO/__init__.py", line 1, in <module>
    from .gpio import *
  File "/home/brian/mambaforge/envs/donkey/lib/python3.9/site-packages/Jetson/GPIO/gpio.py", line 33, in <module>
    raise RuntimeError("The current user does not have permissions set to access the library functionalites. Please configure permissions or use the root user to run this. It is also possible that {} does not exist. Please check if that file is present.".format(_GPIOCHIP_ROOT))
RuntimeError: The current user does not have permissions set to access the library functionalites. Please configure permissions or use the root user to run this. It is also possible that /dev/gpiochip0 does not exist. Please check if that file is present.
```

I tried a few fixes, the [Jetson GPIO docs](https://github.com/NVIDIA/jetson-gpio/blob/master/README.md#setting-user-permissions) for setting user permissions:

```
sudo groupadd -f -r gpio
sudo usermod -a -G gpio $USER
sudo cp ~/mambaforge/envs/donkey/lib/python3.9/site-packages/Jetson/GPIO/99-gpio.rules /etc/udev/rules.d/
```

Which did not work.

Then tried `sudo chmod a+rw /dev/gpiochip0` ([as suggested](https://github.com/warthog618/gpiod/issues/10)) which changed the error to `TypeError: can only concatenate str (not "int") to str`

`$ donkey calibrate --pwm-pin=PCA9685.1:40.1`
```
________             ______                   _________      
___  __ \_______________  /___________  __    __  ____/_____ ________
__  / / /  __ \_  __ \_  //_/  _ \_  / / /    _  /    _  __ `/_  ___/
_  /_/ // /_/ /  / / /  ,<  /  __/  /_/ /     / /___  / /_/ /_  /
/_____/ \____//_/ /_//_/|_| \___/_\__, /      \____/  \__,_/ /_/
                                 /____/                      

using donkey v5.0.dev1 ...
Traceback (most recent call last):
  File "/home/brian/mambaforge/envs/donkey/bin/donkey", line 33, in <module>
    sys.exit(load_entry_point('donkeycar', 'console_scripts', 'donkey')())
  File "/home/brian/projects/donkeycar/donkeycar/management/base.py", line 626, in execute_from_command_line
    c.run(args[2:])
  File "/home/brian/projects/donkeycar/donkeycar/management/base.py", line 219, in run
    from donkeycar.parts.actuator import PulseController
  File "/home/brian/projects/donkeycar/donkeycar/parts/actuator.py", line 19, in <module>
    import RPi.GPIO as GPIO
  File "/home/brian/mambaforge/envs/donkey/lib/python3.9/site-packages/RPi/GPIO/__init__.py", line 1, in <module>
    from Jetson.GPIO import *
  File "/home/brian/mambaforge/envs/donkey/lib/python3.9/site-packages/Jetson/GPIO/__init__.py", line 1, in <module>
    from .gpio import *
  File "/home/brian/mambaforge/envs/donkey/lib/python3.9/site-packages/Jetson/GPIO/gpio.py", line 69, in <module>
    model, JETSON_INFO, _channel_data_by_mode = gpio_pin_data.get_data()
  File "/home/brian/mambaforge/envs/donkey/lib/python3.9/site-packages/Jetson/GPIO/gpio_pin_data.py", line 581, in get_data
    d = prefix + pwm_chip_name
TypeError: can only concatenate str (not "int") to str
```

I found the issue https://github.com/NVIDIA/jetson-gpio/issues/79 where the official response was:

> For Jetson Xavier and before you should be fine using version 2.0.21 for now.

The TF29 branch installs v2.1:

`$ conda list`
```
jetson-gpio               2.1.0                    pypi_0    pypi
```

I installed v2.0.21 using:

`pip install --force-reinstall -v "Jetson.GPIO==2.0.21"`

And the error went away.

TCIII, 2023-04-17:
@BrianHenryIE,

`Jetson.gpio` normally comes already installed on JP so this error that you experienced is very interesting.

TCIII

BrianHenryIE, 2023-04-17:
I see [v2.1.1 was released March 8](https://github.com/NVIDIA/jetson-gpio/releases/tag/v2.1.1) with the comment:

> Fix Jetson Nano ... implementation

I'll try install that when I get my car driving.

DocGarbanzo, 2023-04-21:
@BrianHenryIE - here is a solution from @Heavy02011: `sudo chmod 666 /dev/gpiochip*` who encountered the same issue - I'll add this to the docs after I figured out when exactly we have to run this.

BrianHenryIE, 2023-04-21:
I did a fresh install of the tf29 branch yesterday and just calibrated now. I can confirm `sudo chmod 666 /dev/gpiochip*` worked to fix the error from this thread.

This time `conda list` had `jetson-gpio               2.1.1                    pypi_0    pypi` (i.e. using 2.1.1 wasn't the solution as hoped).

TCIII, 2023-04-22:
@BrianHenryIE,

I don't encounter the permissions error when running `jetson-gpio` version 2.0.20, therefore getson-gpio version 2.1.1 is causing the error.

TCIII

TCIII, 2023-04-22:
@DocGarbanzo,

NVIDIA solution for jetson-gpio permissions issue:

```
If you installed Jetson.GPIO from a package, e.g. using pip into a virtual environment:

sudo cp venv/lib/pythonNN/site-packages/Jetson/GPIO/99-gpio.rules /etc/udev/rules.d/
For the new rule to take place, you either need to reboot or reload the udev rules by running:

sudo udevadm control --reload-rules && sudo udevadm trigger
```
TCIII

BrianHenryIE, 2023-04-22:
Our data from this thread is:

* 2.1.1 – error for me
* 2.1.0 – error for me
* 2.0.21 – no error for me
* 2.0.20 – no error for you

After `sudo chmod 666 /dev/gpiochip* `:

* 2.1.1 – no error for me

I'm under the impression, from https://github.com/NVIDIA/jetson-gpio/issues/79 and https://github.com/NVIDIA/jetson-gpio/releases/tag/v2.1.1, that this will be fixed by Nvidia in a later update.

I'm pretty sure I tried `sudo udevadm control --reload-rules && sudo udevadm trigger` earlier without effect but forgot to copy that into my original post. As I said, I did run the `cp ... 99-gpio.rules` line.

TCIII, 2023-04-22:
@BrianHenryIE,

Did you run `sudo cp venv/lib/pythonNN/site-packages/Jetson/GPIO/99-gpio.rules /etc/udev/rules.d/` before running `sudo udevadm control --reload-rules && sudo udevadm trigger` per the NVIDIA solution above?

TCIII

BrianHenryIE, 2023-04-22:
Yes. And rebooted. I tested that just now on a fresh install to be sure:

```
(donkey) brian@brian-desktop:~$ donkey calibrate --pwm-pin=PCA9685.1:40.1
________             ______                   _________      
___  __ \_______________  /___________  __    __  ____/_____ ________
__  / / /  __ \_  __ \_  //_/  _ \_  / / /    _  /    _  __ `/_  ___/
_  /_/ // /_/ /  / / /  ,<  /  __/  /_/ /     / /___  / /_/ /_  /
/_____/ \____//_/ /_//_/|_| \___/_\__, /      \____/  \__,_/ /_/
                                 /____/                      

using donkey v5.0.dev1 ...
Traceback (most recent call last):
  File "/home/brian/mambaforge/envs/donkey/bin/donkey", line 33, in <module>
    sys.exit(load_entry_point('donkeycar', 'console_scripts', 'donkey')())
  File "/home/brian/projects/donkeycar/donkeycar/management/base.py", line 626, in execute_from_command_line
    c.run(args[2:])
  File "/home/brian/projects/donkeycar/donkeycar/management/base.py", line 219, in run
    from donkeycar.parts.actuator import PulseController
  File "/home/brian/projects/donkeycar/donkeycar/parts/actuator.py", line 19, in <module>
    import RPi.GPIO as GPIO
  File "/home/brian/mambaforge/envs/donkey/lib/python3.9/site-packages/RPi/GPIO/__init__.py", line 1, in <module>
    from Jetson.GPIO import *
  File "/home/brian/mambaforge/envs/donkey/lib/python3.9/site-packages/Jetson/GPIO/__init__.py", line 1, in <module>
    from .gpio import *
  File "/home/brian/mambaforge/envs/donkey/lib/python3.9/site-packages/Jetson/GPIO/gpio.py", line 33, in <module>
    raise RuntimeError("The current user does not have permissions set to access the library functionalites. Please configure permissions or use the root user to run this. It is also possible that {} does not exist. Please check if that file is present.".format(_GPIOCHIP_ROOT))
RuntimeError: The current user does not have permissions set to access the library functionalites. Please configure permissions or use the root user to run this. It is also possible that /dev/gpiochip0 does not exist. Please check if that file is present.

(donkey) brian@brian-desktop:~$ sudo groupadd -f -r gpio
[sudo] password for brian:
(donkey) brian@brian-desktop:~$ sudo usermod -a -G gpio brian
(donkey) brian@brian-desktop:~$ sudo cp ~/mambaforge/envs/donkey/lib/python3.9/site-packages/Jetson/GPIO/99-gpio.rules /etc/udev/rules.d/
(donkey) brian@brian-desktop:~$ sudo udevadm control --reload-rules && sudo udevadm trigger

(donkey) brian@brian-desktop:~$ donkey calibrate --pwm-pin=PCA9685.1:40.1
________             ______                   _________      
___  __ \_______________  /___________  __    __  ____/_____ ________
__  / / /  __ \_  __ \_  //_/  _ \_  / / /    _  /    _  __ `/_  ___/
_  /_/ // /_/ /  / / /  ,<  /  __/  /_/ /     / /___  / /_/ /_  /
/_____/ \____//_/ /_//_/|_| \___/_\__, /      \____/  \__,_/ /_/
                                 /____/                      

using donkey v5.0.dev1 ...
Traceback (most recent call last):
  File "/home/brian/mambaforge/envs/donkey/bin/donkey", line 33, in <module>
    sys.exit(load_entry_point('donkeycar', 'console_scripts', 'donkey')())
  File "/home/brian/projects/donkeycar/donkeycar/management/base.py", line 626, in execute_from_command_line
    c.run(args[2:])
  File "/home/brian/projects/donkeycar/donkeycar/management/base.py", line 219, in run
    from donkeycar.parts.actuator import PulseController
  File "/home/brian/projects/donkeycar/donkeycar/parts/actuator.py", line 19, in <module>
    import RPi.GPIO as GPIO
  File "/home/brian/mambaforge/envs/donkey/lib/python3.9/site-packages/RPi/GPIO/__init__.py", line 1, in <module>
    from Jetson.GPIO import *
  File "/home/brian/mambaforge/envs/donkey/lib/python3.9/site-packages/Jetson/GPIO/__init__.py", line 1, in <module>
    from .gpio import *
  File "/home/brian/mambaforge/envs/donkey/lib/python3.9/site-packages/Jetson/GPIO/gpio.py", line 33, in <module>
    raise RuntimeError("The current user does not have permissions set to access the library functionalites. Please configure permissions or use the root user to run this. It is also possible that {} does not exist. Please check if that file is present.".format(_GPIOCHIP_ROOT))
RuntimeError: The current user does not have permissions set to access the library functionalites. Please configure permissions or use the root user to run this. It is also possible that /dev/gpiochip0 does not exist. Please check if that file is present.

(donkey) brian@brian-desktop:~$ sudo reboot now
Connection to 192.168.0.139 closed by remote host.
Connection to 192.168.0.139 closed.
(base) brianhenry@Brians-MacBook-Air-2 donkeycar % ssh brian@192.168.0.139
brian@192.168.0.139's password:
Welcome to Ubuntu 18.04.6 LTS (GNU/Linux 4.9.299-tegra aarch64)

 * Documentation:  https://help.ubuntu.com
 * Management:     https://landscape.canonical.com
 * Support:        https://ubuntu.com/advantage
This system has been minimized by removing packages and content that are
not required on a system that users do not log into.

To restore this content, you can run the 'unminimize' command.

Expanded Security Maintenance for Applications is not enabled.

0 updates can be applied immediately.

47 additional security updates can be applied with ESM Apps.
Learn more about enabling ESM Apps service at https://ubuntu.com/esm

Last login: Sat Apr 22 10:51:31 2023 from 192.168.0.193

(donkey) brian@brian-desktop:~$ donkey calibrate --pwm-pin=PCA9685.1:40.1
________             ______                   _________      
___  __ \_______________  /___________  __    __  ____/_____ ________
__  / / /  __ \_  __ \_  //_/  _ \_  / / /    _  /    _  __ `/_  ___/
_  /_/ // /_/ /  / / /  ,<  /  __/  /_/ /     / /___  / /_/ /_  /
/_____/ \____//_/ /_//_/|_| \___/_\__, /      \____/  \__,_/ /_/
                                 /____/                      

using donkey v5.0.dev1 ...
Traceback (most recent call last):
  File "/home/brian/mambaforge/envs/donkey/bin/donkey", line 33, in <module>
    sys.exit(load_entry_point('donkeycar', 'console_scripts', 'donkey')())
  File "/home/brian/projects/donkeycar/donkeycar/management/base.py", line 626, in execute_from_command_line
    c.run(args[2:])
  File "/home/brian/projects/donkeycar/donkeycar/management/base.py", line 219, in run
    from donkeycar.parts.actuator import PulseController
  File "/home/brian/projects/donkeycar/donkeycar/parts/actuator.py", line 19, in <module>
    import RPi.GPIO as GPIO
  File "/home/brian/mambaforge/envs/donkey/lib/python3.9/site-packages/RPi/GPIO/__init__.py", line 1, in <module>
    from Jetson.GPIO import *
  File "/home/brian/mambaforge/envs/donkey/lib/python3.9/site-packages/Jetson/GPIO/__init__.py", line 1, in <module>
    from .gpio import *
  File "/home/brian/mambaforge/envs/donkey/lib/python3.9/site-packages/Jetson/GPIO/gpio.py", line 33, in <module>
    raise RuntimeError("The current user does not have permissions set to access the library functionalites. Please configure permissions or use the root user to run this. It is also possible that {} does not exist. Please check if that file is present.".format(_GPIOCHIP_ROOT))
RuntimeError: The current user does not have permissions set to access the library functionalites. Please configure permissions or use the root user to run this. It is also possible that /dev/gpiochip0 does not exist. Please check if that file is present.

(donkey) brian@brian-desktop:~$ cd ~/mycar/
(donkey) brian@brian-desktop:~/mycar$ donkey calibrate --pwm-pin=PCA9685.1:40.1
________             ______                   _________      
___  __ \_______________  /___________  __    __  ____/_____ ________
__  / / /  __ \_  __ \_  //_/  _ \_  / / /    _  /    _  __ `/_  ___/
_  /_/ // /_/ /  / / /  ,<  /  __/  /_/ /     / /___  / /_/ /_  /
/_____/ \____//_/ /_//_/|_| \___/_\__, /      \____/  \__,_/ /_/
                                 /____/                      

using donkey v5.0.dev1 ...
Traceback (most recent call last):
  File "/home/brian/mambaforge/envs/donkey/bin/donkey", line 33, in <module>
    sys.exit(load_entry_point('donkeycar', 'console_scripts', 'donkey')())
  File "/home/brian/projects/donkeycar/donkeycar/management/base.py", line 626, in execute_from_command_line
    c.run(args[2:])
  File "/home/brian/projects/donkeycar/donkeycar/management/base.py", line 219, in run
    from donkeycar.parts.actuator import PulseController
  File "/home/brian/projects/donkeycar/donkeycar/parts/actuator.py", line 19, in <module>
    import RPi.GPIO as GPIO
  File "/home/brian/mambaforge/envs/donkey/lib/python3.9/site-packages/RPi/GPIO/__init__.py", line 1, in <module>
    from Jetson.GPIO import *
  File "/home/brian/mambaforge/envs/donkey/lib/python3.9/site-packages/Jetson/GPIO/__init__.py", line 1, in <module>
    from .gpio import *
  File "/home/brian/mambaforge/envs/donkey/lib/python3.9/site-packages/Jetson/GPIO/gpio.py", line 33, in <module>
    raise RuntimeError("The current user does not have permissions set to access the library functionalites. Please configure permissions or use the root user to run this. It is also possible that {} does not exist. Please check if that file is present.".format(_GPIOCHIP_ROOT))
RuntimeError: The current user does not have permissions set to access the library functionalites. Please configure permissions or use the root user to run this. It is also possible that /dev/gpiochip0 does not exist. Please check if that file is present.

(donkey) brian@brian-desktop:~/mycar$ sudo chmod 666 /dev/gpiochip*
[sudo] password for brian:
(donkey) brian@brian-desktop:~/mycar$ donkey calibrate --pwm-pin=PCA9685.1:40.1
________             ______                   _________      
___  __ \_______________  /___________  __    __  ____/_____ ________
__  / / /  __ \_  __ \_  //_/  _ \_  / / /    _  /    _  __ `/_  ___/
_  /_/ // /_/ /  / / /  ,<  /  __/  /_/ /     / /___  / /_/ /_  /
/_____/ \____//_/ /_//_/|_| \___/_\__, /      \____/  \__,_/ /_/
                                 /____/                      

using donkey v5.0.dev1 ...
WARNING:donkeycar.parts.pins:pigpio was not imported.
init pin PCA9685.1:40.1
Using PWM freq: 60

Enter a PWM setting to test ('q' for quit) (0-1500):

```

BrianHenryIE, 2023-04-23:
`sudo chmod 666 /dev/gpiochip*` does not persist across all reboots.

Ezward, 2023-05-20:
Marked as solved.  Discussion can continue if needed.

Closed 2023-05-20.

Thread 1123 (2023-04-17):

[solved] [tf_2_9] Unable to open CSICamera.

BrianHenryIE, 2023-04-17:
`$ python ~/mycar/manage.py drive`
```
________             ______                   _________      
___  __ \_______________  /___________  __    __  ____/_____ ________
__  / / /  __ \_  __ \_  //_/  _ \_  / / /    _  /    _  __ `/_  ___/
_  /_/ // /_/ /  / / /  ,<  /  __/  /_/ /     / /___  / /_/ /_  /
/_____/ \____//_/ /_//_/|_| \___/_\__, /      \____/  \__,_/ /_/
                                 /____/                      

using donkey v5.0.dev1 ...
INFO:donkeycar.config:loading config file: /home/brian/mycar/config.py
INFO:donkeycar.config:loading personal config over-rides from myconfig.py
INFO:__main__:PID: 8161
WARNING:donkeycar.parts.pins:pigpio was not imported.
cfg.CAMERA_TYPE CSIC
INFO:__main__:cfg.CAMERA_TYPE CSIC
Traceback (most recent call last):
  File "/home/brian/mycar/manage.py", line 1142, in <module>
    drive(cfg, model_path=args['--model'], use_joystick=args['--js'],
  File "/home/brian/mycar/manage.py", line 104, in drive
    add_camera(V, cfg, camera_type)
  File "/home/brian/mycar/manage.py", line 880, in add_camera
    cam = get_camera(cfg)
  File "/home/brian/mycar/manage.py", line 808, in get_camera
    cam = CSICamera(image_w=cfg.IMAGE_W, image_h=cfg.IMAGE_H, image_d=cfg.IMAGE_DEPTH,
  File "/home/brian/projects/donkeycar/donkeycar/parts/camera.py", line 218, in __init__
    self.init_camera()
  File "/home/brian/projects/donkeycar/donkeycar/parts/camera.py", line 246, in init_camera
    raise RuntimeError("Unable to open CSICamera.")
RuntimeError: Unable to open CSICamera.
```

I'm using a newer Jetson Nano, i.e. with two camera inputs, and the TF2.9 branch.

I was able to get past the error by adding to `donkeycar/parts/camera.py:237`, `CSICamera::init_camera()`:
```
if self.camera:
    self.camera.open(0)
```
I'm having another problem now so I'm not 100% sure this is fixed.

TCIII, 2023-04-17:
@BrianHenryIE,

Try running the following commands to ensure that GStreamer is installed on your Nano:
```
python
>>>import cv2
>>>print(cv2.getBuildInformation())   // Check for GStreamer installed version
```

TCIII

TCIII, 2023-04-17:
@BrianHenryIE,
Here is the CSCI camera output from running `manage.py drive`:

```
cfg.CAMERA_TYPE CSIC
INFO:__main__:cfg.CAMERA_TYPE CSIC
GST_ARGUS: Creating output stream
CONSUMER: Waiting until producer is connected...
GST_ARGUS: Available Sensor modes :
GST_ARGUS: 3264 x 2464 FR = 21.000000 fps Duration = 47619048 ; Analog Gain range min 1.000000, max 10.625000; Exposure Range min 13000, max 683709000;

GST_ARGUS: 3264 x 1848 FR = 28.000001 fps Duration = 35714284 ; Analog Gain range min 1.000000, max 10.625000; Exposure Range min 13000, max 683709000;

GST_ARGUS: 1920 x 1080 FR = 29.999999 fps Duration = 33333334 ; Analog Gain range min 1.000000, max 10.625000; Exposure Range min 13000, max 683709000;

GST_ARGUS: 1640 x 1232 FR = 29.999999 fps Duration = 33333334 ; Analog Gain range min 1.000000, max 10.625000; Exposure Range min 13000, max 683709000;

GST_ARGUS: 1280 x 720 FR = 59.999999 fps Duration = 16666667 ; Analog Gain range min 1.000000, max 10.625000; Exposure Range min 13000, max 683709000;

GST_ARGUS: 1280 x 720 FR = 120.000005 fps Duration = 8333333 ; Analog Gain range min 1.000000, max 10.625000; Exposure Range min 13000, max 683709000;

GST_ARGUS: Running with following settings:
   Camera index = 0
   Camera mode  = 5
   Output Stream W = 1280 H = 720
   seconds to Run    = 0
   Frame Rate = 120.000005
GST_ARGUS: Setup Complete, Starting captures for 0 seconds
GST_ARGUS: Starting repeat capture requests.
CONSUMER: Producer has connected; continuing.
[ WARN:0@3.619] global /home/thomas/opencv/modules/videoio/src/cap_gstreamer.cpp (1405) open OpenCV | GStreamer warning: Cannot query video position: status=0, value=-1, duration=-1
INFO:donkeycar.parts.camera:CSICamera opened...
INFO:donkeycar.parts.camera:...warming camera
INFO:donkeycar.parts.camera:CSICamera ready.
INFO:donkeycar.vehicle:Adding part CSICamera.
```
I would hazard a guess that either the CSIC camera ribbon cable is not connected to your Nano correctly or that GStreamer is not installed.
TCIII

BrianHenryIE, 2023-04-18:
```
python
>>>import cv2
>>>print(cv2.getBuildInformation())
```

```
GStreamer:                   NO
```

Full output:

```
General configuration for OpenCV 4.7.0 =====================================
  Version control:               4.7.0

  Platform:
    Timestamp:                   2023-02-22T13:23:24Z
    Host:                        Linux 5.3.0-28-generic aarch64
    CMake:                       3.25.2
    CMake generator:             Unix Makefiles
    CMake build tool:            /bin/gmake
    Configuration:               Release

  CPU/HW features:
    Baseline:                    NEON FP16

  C/C++:
    Built as dynamic libs?:      NO
    C++ standard:                11
    C++ Compiler:                /opt/rh/devtoolset-10/root/usr/bin/c++  (ver 10.2.1)
    C++ flags (Release):         -Wl,-strip-all   -fsigned-char -W -Wall -Wreturn-type -Wnon-virtual-dtor -Waddress -Wsequence-point -Wformat -Wformat-security -Wmissing-declarations -Wundef -Winit-self -Wpointer-arith -Wshadow -Wsign-promo -Wuninitialized -Wsuggest-override -Wno-delete-non-virtual-dtor -Wno-comment -Wimplicit-fallthrough=3 -Wno-strict-overflow -fdiagnostics-show-option -pthread -fomit-frame-pointer -ffunction-sections -fdata-sections    -fvisibility=hidden -fvisibility-inlines-hidden -O3 -DNDEBUG  -DNDEBUG
    C++ flags (Debug):           -Wl,-strip-all   -fsigned-char -W -Wall -Wreturn-type -Wnon-virtual-dtor -Waddress -Wsequence-point -Wformat -Wformat-security -Wmissing-declarations -Wundef -Winit-self -Wpointer-arith -Wshadow -Wsign-promo -Wuninitialized -Wsuggest-override -Wno-delete-non-virtual-dtor -Wno-comment -Wimplicit-fallthrough=3 -Wno-strict-overflow -fdiagnostics-show-option -pthread -fomit-frame-pointer -ffunction-sections -fdata-sections    -fvisibility=hidden -fvisibility-inlines-hidden -g  -O0 -DDEBUG -D_DEBUG
    C Compiler:                  /opt/rh/devtoolset-10/root/usr/bin/cc
    C flags (Release):           -Wl,-strip-all   -fsigned-char -W -Wall -Wreturn-type -Waddress -Wsequence-point -Wformat -Wformat-security -Wmissing-declarations -Wmissing-prototypes -Wstrict-prototypes -Wundef -Winit-self -Wpointer-arith -Wshadow -Wuninitialized -Wno-comment -Wimplicit-fallthrough=3 -Wno-strict-overflow -fdiagnostics-show-option -pthread -fomit-frame-pointer -ffunction-sections -fdata-sections    -fvisibility=hidden -O3 -DNDEBUG  -DNDEBUG
    C flags (Debug):             -Wl,-strip-all   -fsigned-char -W -Wall -Wreturn-type -Waddress -Wsequence-point -Wformat -Wformat-security -Wmissing-declarations -Wmissing-prototypes -Wstrict-prototypes -Wundef -Winit-self -Wpointer-arith -Wshadow -Wuninitialized -Wno-comment -Wimplicit-fallthrough=3 -Wno-strict-overflow -fdiagnostics-show-option -pthread -fomit-frame-pointer -ffunction-sections -fdata-sections    -fvisibility=hidden -g  -O0 -DDEBUG -D_DEBUG
    Linker flags (Release):      -L/ffmpeg_build/lib  -Wl,--gc-sections -Wl,--as-needed -Wl,--no-undefined
    Linker flags (Debug):        -L/ffmpeg_build/lib  -Wl,--gc-sections -Wl,--as-needed -Wl,--no-undefined
    ccache:                      YES
    Precompiled headers:         NO
    Extra dependencies:          /lib64/libopenblas.so /usr/local/lib/libpng.so /lib64/libz.so dl m pthread rt
    3rdparty dependencies:       libprotobuf ade ittnotify libjpeg-turbo libwebp libtiff libopenjp2 IlmImf quirc tegra_hal

  OpenCV modules:
    To be built:                 calib3d core dnn features2d flann gapi highgui imgcodecs imgproc ml objdetect photo python3 stitching video videoio
    Disabled:                    world
    Disabled by dependency:      -
    Unavailable:                 java python2 ts
    Applications:                -
    Documentation:               NO
    Non-free algorithms:         NO

  GUI:                           NONE
    VTK support:                 NO

  Media I/O:
    ZLib:                        /lib64/libz.so (ver 1.2.7)
    JPEG:                        libjpeg-turbo (ver 2.1.3-62)
    WEBP:                        build (ver encoder: 0x020f)
    PNG:                         /usr/local/lib/libpng.so (ver 1.6.37)
    TIFF:                        build (ver 42 - 4.2.0)
    JPEG 2000:                   build (ver 2.4.0)
    OpenEXR:                     build (ver 2.3.0)
    HDR:                         YES
    SUNRASTER:                   YES
    PXM:                         YES
    PFM:                         YES

  Video I/O:
    DC1394:                      NO
    FFMPEG:                      YES
      avcodec:                   YES (59.37.100)
      avformat:                  YES (59.27.100)
      avutil:                    YES (57.28.100)
      swscale:                   YES (6.7.100)
      avresample:                NO
    GStreamer:                   NO
    v4l/v4l2:                    YES (linux/videodev2.h)

  Parallel framework:            pthreads

  Trace:                         YES (with Intel ITT)

  Other third-party libraries:
    Lapack:                      YES (/lib64/libopenblas.so)
    Eigen:                       NO
    Custom HAL:                  YES (carotene (ver 0.0.1))
    Protobuf:                    build (3.19.1)

  OpenCL:                        YES (no extra features)
    Include path:                /io/opencv/3rdparty/include/opencl/1.2
    Link libraries:              Dynamic load

  Python 3:
    Interpreter:                 /opt/python/cp37-cp37m/bin/python3.7 (ver 3.7.16)
    Libraries:                   libpython3.7m.a (ver 3.7.16)
    numpy:                       /home/ci/.local/lib/python3.7/site-packages/numpy/core/include (ver 1.19.3)
    install path:                python/cv2/python-3

  Python (for build):            /bin/python2.7

  Java:                  
    ant:                         NO
    JNI:                         NO
    Java wrappers:               NO
    Java tests:                  NO

  Install to:                    /io/_skbuild/linux-aarch64-3.7/cmake-install
-----------------------------------------------------------------
```

I'm 99% sure I used `-D WITH_GSTREAMER=ON` when I installed OpenCV with CMake (I still have the text file open where I modified the command and copied it from).

I don't get the sensor modes as I start to drive the car:

```
using donkey v5.0.dev1 ...
INFO:donkeycar.config:loading config file: /home/brian/mycar/config.py
INFO:donkeycar.config:loading personal config over-rides from myconfig.py
INFO:__main__:PID: 8135
WARNING:donkeycar.parts.pins:pigpio was not imported.
cfg.CAMERA_TYPE CSIC
INFO:__main__:cfg.CAMERA_TYPE CSIC
INFO:donkeycar.parts.camera:CSICamera opened...
INFO:donkeycar.parts.camera:...warming camera
INFO:donkeycar.parts.camera:CSICamera ready.
INFO:donkeycar.vehicle:Adding part CSICamera.
INFO:donkeycar.parts.web_controller.web:Starting Donkey Server...
```

And the images that are recorded are just solid green.

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

And I tried the ribbon cable in both Jetson Nano connections.

I guess the best thing is to reinstall from scratch and ensure the CMake command is correct.

TCIII, 2023-04-18:
@BrianHenryIE,

From your Full Output:
You built opencv4.7 instead of opencv4.6, per the install instructions, and you are using Python 3.7 instead of Python 3.9: [tf_2_9 jetson46.yml](https://github.com/autorope/donkeycar/blob/tf_2_9/install/envs/jetson46.yml).

I have built opencv4.6 + GStreamer using the Q-Engineering manual install instructions and the accompanying modified CMake arguments four times for two Nano 4GBs and two Xavier NX 8GBs without issue once the CMake arguments were correctly determined.

Regards,
TCIII

BrianHenryIE, 2023-04-18:
Thanks. I think I know what happened. The traditional Donkey setup docs add a line to `~/.bashrc` to activate the virtual environment. The newer TF29 branch ones don't. I [already opened a PR](https://github.com/autorope/donkeydocs/pull/49/files) to address this:

TCIII, 2023-04-18:
@BrianHenryIE,

You must have missed this line, `source ~/.bashrc`, in the Nano JP4.6.1/2 [instructions](https://github.com/autorope/donkeydocs/blob/Update_to_tf_29/docs/guide/robot_sbc/setup_jetson_nano.md):
```
Step 3b: Setup Python Environment
The installation on JP 4.6.X is more tricky, because we need to use a newer version of tensorflow than what is packaged by NVidia for this OS version. Also, we need a compatible OpenCV version which needs to be built on the nano.

Step 1: Install mamba-forge
Download and install mambaforge. When you are asked to run conda init in the script, type yes.

wget https://github.com/conda-forge/miniforge/releases/latest/download/Mambaforge-Linux-aarch64.sh
chmod u+x ./Mambaforge-Linux-aarch64.sh
bash ./Mambaforge-Linux-aarch64.sh
source ~/.bashrc            // I believe that this is the line you are referring to?

TCIII

```

BrianHenryIE, 2023-04-22:
I reinstalled everything, confirmed GStreamer was present, then ran
`pip install -e .[nano] --user pip` because `donkey` wasn't working, and it seems to have disable GStreamer.
```
Python 3.9.16 | packaged by conda-forge | (main, Feb  1 2023, 22:05:40)
[GCC 11.3.0] on linux
Type "help", "copyright", "credits" or "license" for more information.
>>> import cv2
>>> print(cv2.getBuildInformation())

General configuration for OpenCV 4.6.0 =====================================
  Version control:               unknown

  Extra modules:
    Location (extra):            /home/brian/opencv_contrib/modules
    Version control (extra):     unknown

  Platform:
    Timestamp:                   2023-04-20T04:50:47Z
    Host:                        Linux 4.9.299-tegra aarch64
    CMake:                       3.10.2
    CMake generator:             Unix Makefiles
    CMake build tool:            /usr/bin/make
    Configuration:               RELEASE

  CPU/HW features:
    Baseline:                    NEON FP16
      required:                  NEON

  C/C++:
    Built as dynamic libs?:      YES
    C++ standard:                11
    C++ Compiler:                /usr/bin/c++  (ver 7.5.0)
    C++ flags (Release):         -fsigned-char -ffast-math -W -Wall -Wreturn-type -Wnon-virtual-dtor -Waddress -Wsequence-point -Wformat -Wformat-security -Wmissing-declarations -Wundef -Winit-self -Wpointer-arith -Wshadow -Wsign-promo -Wuninitialized -Wsuggest-override -Wno-delete-non-virtual-dtor -Wno-comment -Wimplicit-fallthrough=3 -Wno-strict-overflow -fdiagnostics-show-option -pthread -fomit-frame-pointer -ffunction-sections -fdata-sections    -fvisibility=hidden -fvisibility-inlines-hidden -fopenmp -O3 -DNDEBUG  -DNDEBUG
    C++ flags (Debug):           -fsigned-char -ffast-math -W -Wall -Wreturn-type -Wnon-virtual-dtor -Waddress -Wsequence-point -Wformat -Wformat-security -Wmissing-declarations -Wundef -Winit-self -Wpointer-arith -Wshadow -Wsign-promo -Wuninitialized -Wsuggest-override -Wno-delete-non-virtual-dtor -Wno-comment -Wimplicit-fallthrough=3 -Wno-strict-overflow -fdiagnostics-show-option -pthread -fomit-frame-pointer -ffunction-sections -fdata-sections    -fvisibility=hidden -fvisibility-inlines-hidden -fopenmp -g  -O0 -DDEBUG -D_DEBUG
    C Compiler:                  /usr/bin/cc
    C flags (Release):           -fsigned-char -ffast-math -W -Wall -Wreturn-type -Waddress -Wsequence-point -Wformat -Wformat-security -Wmissing-declarations -Wmissing-prototypes -Wstrict-prototypes -Wundef -Winit-self -Wpointer-arith -Wshadow -Wuninitialized -Wno-comment -Wimplicit-fallthrough=3 -Wno-strict-overflow -fdiagnostics-show-option -pthread -fomit-frame-pointer -ffunction-sections -fdata-sections    -fvisibility=hidden -fopenmp -O3 -DNDEBUG  -DNDEBUG
    C flags (Debug):             -fsigned-char -ffast-math -W -Wall -Wreturn-type -Waddress -Wsequence-point -Wformat -Wformat-security -Wmissing-declarations -Wmissing-prototypes -Wstrict-prototypes -Wundef -Winit-self -Wpointer-arith -Wshadow -Wuninitialized -Wno-comment -Wimplicit-fallthrough=3 -Wno-strict-overflow -fdiagnostics-show-option -pthread -fomit-frame-pointer -ffunction-sections -fdata-sections    -fvisibility=hidden -fopenmp -g  -O0 -DDEBUG -D_DEBUG
    Linker flags (Release):      -Wl,--gc-sections -Wl,--as-needed -Wl,--no-undefined
    Linker flags (Debug):        -Wl,--gc-sections -Wl,--as-needed -Wl,--no-undefined
    ccache:                      NO
    Precompiled headers:         NO
    Extra dependencies:          m pthread cudart_static dl rt nppc nppial nppicc nppicom nppidei nppif nppig nppim nppist nppisu nppitc npps cublas cudnn cufft -L/usr/local/cuda/lib64 -L/usr/lib/aarch64-linux-gnu
    3rdparty dependencies:

  OpenCV modules:
    To be built:                 alphamat aruco barcode bgsegm bioinspired calib3d ccalib core cudaarithm cudabgsegm cudacodec cudafeatures2d cudafilters cudaimgproc cudalegacy cudaobjdetect cudaoptflow cudastereo cudawarping cudev datasets dnn dnn_objdetect dnn_superres dpm face features2d flann freetype fuzzy gapi hdf hfs highgui img_hash imgcodecs imgproc intensity_transform line_descriptor mcc ml objdetect optflow phase_unwrapping photo plot python3 quality rapid reg rgbd saliency sfm shape stereo stitching structured_light superres surface_matching text tracking ts video videoio videostab wechat_qrcode xfeatures2d ximgproc xobjdetect xphoto
    Disabled:                    python2 world
    Disabled by dependency:      -
    Unavailable:                 cvv java julia matlab ovis viz
    Applications:                perf_tests apps
    Documentation:               NO
    Non-free algorithms:         YES

  GUI:                           GTK3
    GTK+:                        YES (ver 3.22.30)
      GThread :                  YES (ver 2.56.4)
      GtkGlExt:                  NO
    VTK support:                 NO

  Media I/O:
    ZLib:                        /usr/lib/aarch64-linux-gnu/libz.so (ver 1.2.11)
    JPEG:                        /usr/lib/aarch64-linux-gnu/libjpeg.so (ver 80)
    WEBP:                        /home/brian/mambaforge/envs/donkey/lib/libwebp.so (ver encoder: 0x020f)
    PNG:                         /usr/lib/aarch64-linux-gnu/libpng.so (ver 1.6.34)
    TIFF:                        build (ver 42 - 4.2.0)
    JPEG 2000:                   build (ver 2.4.0)
    OpenEXR:                     build (ver 2.3.0)
    HDR:                         YES
    SUNRASTER:                   YES
    PXM:                         YES
    PFM:                         YES

  Video I/O:
    DC1394:                      YES (2.2.5)
    FFMPEG:                      YES
      avcodec:                   YES (57.107.100)
      avformat:                  YES (57.83.100)
      avutil:                    YES (55.78.100)
      swscale:                   YES (4.8.100)
      avresample:                YES (3.7.0)
    GStreamer:                   YES (1.14.5)
    v4l/v4l2:                    YES (linux/videodev2.h)

  Parallel framework:            TBB (ver 2020.2 interface 11102)

  Trace:                         YES (with Intel ITT)

  Other third-party libraries:
    Lapack:                      YES (/usr/lib/aarch64-linux-gnu/liblapack.so /usr/lib/aarch64-linux-gnu/libcblas.so /usr/lib/aarch64-linux-gnu/libatlas.so)
    Eigen:                       YES (ver 3.3.4)
    Custom HAL:                  YES (carotene (ver 0.0.1))
    Protobuf:                    build (3.19.1)

  NVIDIA CUDA:                   YES (ver 10.2, CUFFT CUBLAS FAST_MATH)
    NVIDIA GPU arch:             53
    NVIDIA PTX archs:

  cuDNN:                         YES (ver 8.2.1)

  Python 3:
    Interpreter:                 /home/brian/mambaforge/envs/donkey/bin/python3 (ver 3.9.16)
    Libraries:                   /home/brian/mambaforge/envs/donkey/lib/libpython3.9.so (ver 3.9.16)
    numpy:                       /home/brian/mambaforge/envs/donkey/lib/python3.9/site-packages/numpy/core/include (ver 1.23.5)
    install path:                /home/brian/mambaforge/envs/donkey/lib/python3.9/site-packages/cv2/python-3.9

  Python (for build):            /usr/bin/python2.7

  Java:                  
    ant:                         NO
    JNI:                         NO
    Java wrappers:               NO
    Java tests:                  NO

  Install to:                    /home/brian/mambaforge/envs/donkey
-----------------------------------------------------------------
```
`$ donkey calibrate --pwm-pin=PCA9685.1:40.1`
```
-bash: donkey: command not found
```

`$ conda list`
```
# packages in environment at /home/brian/mambaforge/envs/donkey:
#
# Name                    Version                   Build  Channel
_openmp_mutex             4.5                  2_kmp_llvm    conda-forge
absl-py                   1.4.0                    pypi_0    pypi
aom                       3.5.0                headf329_0    conda-forge
astroid                   2.15.3           py39h4420490_0    conda-forge
astunparse                1.6.3                    pypi_0    pypi
attrs                     22.2.0             pyh71513ae_0    conda-forge
backports                 1.0                pyhd8ed1ab_3    conda-forge
backports.functools_lru_cache 1.6.4              pyhd8ed1ab_0    conda-forge
blas                      2.116                  openblas    conda-forge
blas-devel                3.9.0           16_linuxaarch64_openblas    conda-forge
bottleneck                1.3.7            py39hc7cda1a_0    conda-forge
brotli                    1.0.9                h4e544f5_8    conda-forge
brotli-bin                1.0.9                h4e544f5_8    conda-forge
brotlipy                  0.7.0           py39h0fd3b05_1005    conda-forge
bzip2                     1.0.8                hf897c2e_4    conda-forge
ca-certificates           2022.12.7            h4fd8a4c_0    conda-forge
cachetools                5.3.0                    pypi_0    pypi
catalogue                 2.0.8            py39h4420490_1    conda-forge
certifi                   2022.12.7          pyhd8ed1ab_0    conda-forge
cffi                      1.15.1           py39hb26bf21_3    conda-forge
charset-normalizer        3.1.0              pyhd8ed1ab_0    conda-forge
click                     8.0.4            py39ha65689a_0    conda-forge
codecov                   2.1.11             pyhd3eb1b0_0
colorama                  0.4.6              pyhd8ed1ab_0    conda-forge
contourpy                 1.0.7            py39hd9a2fea_0    conda-forge
coverage                  7.2.3            py39h599bc27_0    conda-forge
cryptography              40.0.2           py39h8a84b6a_0    conda-forge
cycler                    0.11.0             pyhd8ed1ab_0    conda-forge
cymem                     2.0.7            py39h3d8bfb9_1    conda-forge
cython-blis               0.7.9            py39hc870d11_1    conda-forge
dataclasses               0.8                pyhc8e2a94_3    conda-forge
decorator                 5.1.1              pyhd8ed1ab_0    conda-forge
dill                      0.3.6              pyhd8ed1ab_1    conda-forge
docopt                    0.6.2            py39hd43f75c_1
expat                     2.5.0                hd600fc2_1    conda-forge
fastai                    2.7.11             pyhd8ed1ab_0    conda-forge
fastcore                  1.5.29             pyhd8ed1ab_0    conda-forge
fastdownload              0.0.7              pyhd8ed1ab_0    conda-forge
fastprogress              1.0.3              pyhd8ed1ab_0    conda-forge
ffmpeg                    5.1.2           gpl_h8bd3c30_106    conda-forge
flatbuffers               1.12                     pypi_0    pypi
font-ttf-dejavu-sans-mono 2.37                 hab24e00_0    conda-forge
font-ttf-inconsolata      3.000                h77eed37_0    conda-forge
font-ttf-source-code-pro  2.038                h77eed37_0    conda-forge
font-ttf-ubuntu           0.83                 hab24e00_0    conda-forge
fontconfig                2.14.2               ha9a116f_0    conda-forge
fonts-conda-ecosystem     1                             0    conda-forge
fonts-conda-forge         1                             0    conda-forge
fonttools                 4.39.3           py39h24fc6b6_0    conda-forge
freetype                  2.12.1               hbbbf32d_1    conda-forge
gast                      0.4.0                    pypi_0    pypi
gettext                   0.21.1               ha18d298_0    conda-forge
giflib                    5.2.1                hb4cce97_3    conda-forge
gmp                       6.2.1                h7fd3ca4_0    conda-forge
gnutls                    3.7.8                h5e100cc_0    conda-forge
google-auth               2.17.3                   pypi_0    pypi
google-auth-oauthlib      0.4.6                    pypi_0    pypi
google-pasta              0.2.0                    pypi_0    pypi
grpcio                    1.54.0                   pypi_0    pypi
h5py                      3.7.0            py39hd2b9c60_0
hdf5                      1.10.6               h8b20701_1
icu                       72.1                 hcf00150_0    conda-forge
idna                      3.4                pyhd8ed1ab_0    conda-forge
imageio                   2.27.0             pyh24c5eb1_0    conda-forge
imageio-ffmpeg            0.4.8              pyhd8ed1ab_0    conda-forge
importlib-metadata        6.5.0                    pypi_0    pypi
importlib-resources       5.12.0             pyhd8ed1ab_0    conda-forge
importlib_resources       5.12.0             pyhd8ed1ab_0    conda-forge
iniconfig                 2.0.0              pyhd8ed1ab_0    conda-forge
isort                     5.12.0             pyhd8ed1ab_1    conda-forge
jinja2                    3.1.2              pyhd8ed1ab_1    conda-forge
joblib                    1.2.0              pyhd8ed1ab_0    conda-forge
jpeg                      9e                   h2a766a3_3    conda-forge
keras                     2.9.0                    pypi_0    pypi
keras-preprocessing       1.1.2                    pypi_0    pypi
keras-vis                 0.5.0                    pypi_0    pypi
kiwisolver                1.4.4            py39h110580c_1    conda-forge
lame                      3.100             h4e544f5_1003    conda-forge
langcodes                 3.3.0              pyhd8ed1ab_0    conda-forge
lazy-loader               0.2                      pypi_0    pypi
lazy-object-proxy         1.9.0            py39h24fc6b6_0    conda-forge
lcms2                     2.15                 h7576be9_0    conda-forge
ld_impl_linux-aarch64     2.40                 h2d8c526_0    conda-forge
lerc                      4.0.0                h4de3ea5_0    conda-forge
libblas                   3.9.0           16_linuxaarch64_openblas    conda-forge
libbrotlicommon           1.0.9                h4e544f5_8    conda-forge
libbrotlidec              1.0.9                h4e544f5_8    conda-forge
libbrotlienc              1.0.9                h4e544f5_8    conda-forge
libcblas                  3.9.0           16_linuxaarch64_openblas    conda-forge
libclang                  16.0.0                   pypi_0    pypi
libdeflate                1.17                 hb4cce97_0    conda-forge
libexpat                  2.5.0                hd600fc2_1    conda-forge
libffi                    3.4.2                h3557bc0_5    conda-forge
libgcc-ng                 12.2.0              h607ecd0_19    conda-forge
libgfortran-ng            12.2.0              he9431aa_19    conda-forge
libgfortran5              12.2.0              hf695500_19    conda-forge
libiconv                  1.17                 h9cdd2b7_0    conda-forge
libidn2                   2.3.4                h4e544f5_0    conda-forge
liblapack                 3.9.0           16_linuxaarch64_openblas    conda-forge
liblapacke                3.9.0           16_linuxaarch64_openblas    conda-forge
libnsl                    2.0.0                hf897c2e_0    conda-forge
libopenblas               0.3.21          pthreads_h6cb6f83_3    conda-forge
libopus                   1.3.1                hf897c2e_1    conda-forge
libpng                    1.6.39               hf9034f9_0    conda-forge
libprotobuf               3.21.12              h7fe2111_0    conda-forge
libsqlite                 3.40.0               hf9034f9_0    conda-forge
libstdcxx-ng              12.2.0              hc13a102_19    conda-forge
libtasn1                  4.19.0               h4e544f5_0    conda-forge
libtiff                   4.5.0                h4c1066a_2    conda-forge
libunistring              0.9.10               hf897c2e_0    conda-forge
libuuid                   2.38.1               hb4cce97_0    conda-forge
libvpx                    1.11.0               h01db608_3    conda-forge
libwebp                   1.2.4                h7bdf6e5_1    conda-forge
libwebp-base              1.2.4                h998d150_1
libxml2                   2.10.4               h430b14f_0    conda-forge
libzlib                   1.2.13               h4e544f5_4    conda-forge
llvm-openmp               16.0.1               h45eaed7_0    conda-forge
markdown                  3.4.3                    pypi_0    pypi
markupsafe                2.1.2            py39h599bc27_0    conda-forge
matplotlib                3.7.1            py39hd43f75c_1
matplotlib-base 
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

Thread 1128 (2023-05-13):

Use deep learning autopilot with gps autopilot

Ezward, 2023-05-13:
The path follow template currently relies on timely and accurate gps readings.  However in the real world gps can fail.  During a race this can lead to a crash as we have seen in the [Indy Autonomous Challenge](https://uwaterloo.ca/news/no-regrets-despite-indy-crash).  We have seen this at the first race at UCSD where the two finalists, one a Donkeycar and one an F1Tenth-like car running ROS, both [failed at the start](https://youtu.be/gqjypxnYq5I) due to gps issues.

This project would add the ability to run a deep learning autopilot in parallel with the gps autopilot.  The deep learning autopilot may be used as a fail safe if the gps fails or it may be used to increase autopilot quality when using a low quality gps.

The development would be in two parts:

1. Update the path follow template to allow it to optionally record data for the deep learning autopilot.  So each time through the vehicle loop we would save the image and the throttle and steering inputs.  Basically port the related code from the [deep learning template](https://github.com/autorope/donkeycar/blob/eedd7eddbfb209006066bb716eb8e68d5d68d3a5/donkeycar/templates/complete.py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).  We can assume the linear template, so only the image, steering and throttle need be saved.
2. Update the path follow template to allow it to run deep learning autopilot.  Here there is a lot of code to port from the deep learning template.  We may want refactor this into a function that can be shared between the deep learning template and the path follow template.  Here we want to have two different modes.
    - The first mode would only run the autopilot if the gps 'cuts out'; so if we detect that we are a) the gps name sentence is telling us that the reading is not reliable so we are not getting timely accurate gps readings b) we detect that the serial connection to the gps is lost so that we are not getting any gps readings.  So in this mode the deep learning autopilot is a fail safe.
    - The second mode would run the deep learning autopilot between gps readings.  So for cheaper gps modes the update rate may only be 5 hz.  However we could potentially run faster if we fill in the gaps with a deep learning model.

These two tasks can be accomplished independent of each other; so two different teams could do these tasks in parallel.  Indeed they can be used independently.  For instance, we can gather the data and train it using the deep learning template as we do now, and if we have the ability to run a deep learning model in the path follow template then just use the model in the path follow (so path follow does not have to save data). If we can gather data in the path follow template then we can use it to train a deep learning autopilot for the deep learning template (so path follow does not have run a deep learning autopilot).  But once we have both then we can have a combined template that can use either or both.

TCIII, 2023-05-13:
@Ezward,

A very ambitious undertaking to say the least.

TCIII

TCIII, 2023-06-24:
@Ezward,

I believe a simpler solution would be to use IMU input in place of image, throttle and steering inputs.
This is basically what the u-Blox ZED-F9R RTK GPS module does which has an integrated IMU on the RTK GPS module for sensor fusion.
If the vehicle momentarily loses GPS input, the IMU can hold the vehicle on the intended course during the loss period.

TCIII

ShuanSong, 2024-01-10:
en. I think this ideal is great that achieve the goal: donkey car can drive  from A point to B point  , then to C point in the counrty.
I think there are another  way to achieve this goal.
· creat a new template  ,let's GPS data [x,y] and  imu data  as another channel into the  CNN net.

Thread 1151 (2023-12-07):

JETSON ORIN NANO JETPACK5.1.2 When I use python3 manage.py drive is error OSError: [Errno 16] Device or resource busy

seed0097, 2023-12-07:
I have installed the DONKEYCAR project on the ORIN NANO JETPACK 5.1.2 system using the following URL, but I encountered the following error when running the program. The camera in use is C270.

https://github.com/Heavy02011/donkeycar-test-DC50dev3/blob/main/logs/Try03_test-result.md

It's error
(env) jetson@orin-nano:~/mycar$ python3 manage.py drive
________             ______                   _________
___  __ \_______________  /___________  __    __  ____/_____ ________
__  / / /  __ \_  __ \_  //_/  _ \_  / / /    _  /    _  __ `/_  ___/
_  /_/ // /_/ /  / / /  ,<  /  __/  /_/ /     / /___  / /_/ /_  /
/_____/ \____//_/ /_//_/|_| \___/_\__, /      \____/  \__,_/ /_/
                                 /____/

using donkey v5.0.dev3 ...
INFO:donkeycar.config:loading config file: /home/jetson/mycar/config.py
INFO:donkeycar.config:loading personal config over-rides from myconfig.py
INFO:__main__:PID: 4018
WARNING:donkeycar.parts.pins:pigpio was not imported.
cfg.CAMERA_TYPE WEBCAM
INFO:__main__:cfg.CAMERA_TYPE WEBCAM
pygame 2.5.2 (SDL 2.28.3, Python 3.8.10)
Hello from the pygame community. https://www.pygame.org/contribute.html
INFO:donkeycar.parts.camera:Opening Webcam...
Xlib:  extension "RANDR" missing on display "localhost:10.0".
INFO:donkeycar.parts.camera:Available cameras ['/dev/video0', '/dev/video1']
INFO:donkeycar.parts.camera:Webcam opened at /dev/video0 ...
INFO:donkeycar.parts.camera:...warming camera
INFO:donkeycar.parts.camera:...warming camera
INFO:donkeycar.parts.camera:...warming camera
INFO:donkeycar.parts.camera:...warming camera
INFO:donkeycar.parts.camera:Webcam ready.
INFO:donkeycar.vehicle:Adding part Webcam.
INFO:donkeycar.parts.web_controller.web:Starting Donkey Server...
INFO:donkeycar.parts.web_controller.web:You can now go to orin-nano.local:8887 to drive your car.
INFO:donkeycar.vehicle:Adding part LocalWebController.
INFO:donkeycar.vehicle:Adding part Pipe.
INFO:donkeycar.vehicle:Adding part ExplodeDict.
INFO:donkeycar.vehicle:Adding part Lambda.
INFO:donkeycar.vehicle:Adding part Lambda.
INFO:donkeycar.vehicle:Adding part Lambda.
INFO:donkeycar.vehicle:Adding part Lambda.
INFO:donkeycar.vehicle:Adding part Lambda.
INFO:donkeycar.vehicle:Adding part ThrottleFilter.
INFO:donkeycar.vehicle:Adding part UserPilotCondition.
INFO:donkeycar.vehicle:Adding part RecordTracker.
INFO:donkeycar.vehicle:Adding part AiLaunch.
INFO:donkeycar.vehicle:Adding part DriveMode.
INFO:donkeycar.vehicle:Adding part ToggleRecording.
Traceback (most recent call last):
  File "manage.py", line 1142, in <module>
    drive(cfg, model_path=args['--model'], use_joystick=args['--js'],
  File "manage.py", line 468, in drive
    add_drivetrain(V, cfg)
  File "manage.py", line 953, in add_drivetrain
    pwm_pin=pins.pwm_pin_by_id(dt["PWM_STEERING_PIN"]),
  File "/home/jetson/donkeycar/donkeycar/parts/pins.py", line 266, in pwm_pin_by_id
    return pwm_pin(pin_provider, pin_number, i2c_bus=i2c_bus, i2c_address=i2c_address, frequency_hz=frequency_hz)
  File "/home/jetson/donkeycar/donkeycar/parts/pins.py", line 385, in pwm_pin
    return PwmPinPCA9685(pin_number, pca9685(i2c_bus, i2c_address, frequency_hz))
  File "/home/jetson/donkeycar/donkeycar/parts/pins.py", line 635, in pca9685
    pca = PCA9685(busnum, address, frequency)
  File "/home/jetson/donkeycar/donkeycar/parts/pins.py", line 581, in __init__
    self.pwm = Adafruit_PCA9685.PCA9685(address=address)
  File "/usr/local/lib/python3.8/dist-packages/Adafruit_PCA9685/PCA9685.py", line 75, in __init__
    self.set_all_pwm(0, 0)
  File "/usr/local/lib/python3.8/dist-packages/Adafruit_PCA9685/PCA9685.py", line 111, in set_all_pwm
    self._device.write8(ALL_LED_ON_L, on & 0xFF)
  File "/usr/local/lib/python3.8/dist-packages/Adafruit_GPIO/I2C.py", line 114, in write8
    self._bus.write_byte_data(self._address, register, value)
  File "/usr/local/lib/python3.8/dist-packages/Adafruit_PureIO/smbus.py", line 315, in write_byte_data
    self._select_device(addr)
  File "/usr/local/lib/python3.8/dist-packages/Adafruit_PureIO/smbus.py", line 154, in _select_device
    ioctl(self._device.fileno(), I2C_SLAVE, addr & 0x7F)
OSError: [Errno 16] Device or resource busy

Heavy02011, 2023-12-07:
There are two cameras present on your orin. typically /dev/video0 is the CSI and /dev/video1 should be USB. You seem to try using /dev/video0 as WEBCAM which results in the error, as its a CSI type.

Please adjust the camera settings in myconfig.py into /dev/video1. Then it should work.

seed0097, 2023-12-08:
Thank you for your reply.
I have changed the video in config.py to 1, but another error occurs.
When using video 0, the LED on the camera is on until an error occurs and then goes out. This indicates that video 0 should be correct.

Is there still a possibility of I2C being occupied? Currently, I am using BUS 7 with the address 0x40 according to the following website. BUS 1 seems to be using 0x40.
https://jetsonhacks.com/nvidia-jetson-orin-nano-gpio-header-pinout/

#9865, over rides only if needed, ie. TX2..
PCA9685_I2C_ADDR = 0x40     #I2C address, use i2cdetect to validate this number
PCA9685_I2C_BUSNUM = 7   #None will auto detect, which is fine on the pi. But other platforms should specify the bus num.

nano ~/projects/donkeycar/donkeycar/parts/camera.py
class Webcam(BaseCamera):
    def __init__(self, image_w=160, image_h=120, image_d=3,
                 framerate=20, camera_index=1):

It's error in video1
(env) jetson@orin-nano:~/mycar$ python3 manage.py drive
________             ______                   _________
___  __ \_______________  /___________  __    __  ____/_____ ________
__  / / /  __ \_  __ \_  //_/  _ \_  / / /    _  /    _  __ `/_  ___/
_  /_/ // /_/ /  / / /  ,<  /  __/  /_/ /     / /___  / /_/ /_  /
/_____/ \____//_/ /_//_/|_| \___/_\__, /      \____/  \__,_/ /_/
                                 /____/

using donkey v5.0.dev3 ...
INFO:donkeycar.config:loading config file: /home/jetson/mycar/config.py
INFO:donkeycar.config:loading personal config over-rides from myconfig.py
INFO:__main__:PID: 3107
WARNING:donkeycar.parts.pins:pigpio was not imported.
cfg.CAMERA_TYPE WEBCAM
INFO:__main__:cfg.CAMERA_TYPE WEBCAM
pygame 2.5.2 (SDL 2.28.3, Python 3.8.10)
Hello from the pygame community. https://www.pygame.org/contribute.html
INFO:donkeycar.parts.camera:Opening Webcam...
Xlib:  extension "RANDR" missing on display "localhost:10.0".
INFO:donkeycar.parts.camera:Available cameras ['/dev/video0', '/dev/video1']
Traceback (most recent call last):
  File "/home/jetson/donkeycar/donkeycar/parts/camera.py", line 136, in init_camera
    self.cam.start()
SystemError: ioctl(VIDIOC_S_FMT) failure: no supported formats

The above exception was the direct cause of the following exception:

Traceback (most recent call last):
  File "manage.py", line 1142, in <module>
    drive(cfg, model_path=args['--model'], use_joystick=args['--js'],
  File "manage.py", line 104, in drive
    add_camera(V, cfg, camera_type)
  File "manage.py", line 880, in add_camera
    cam = get_camera(cfg)
  File "manage.py", line 802, in get_camera
    cam = Webcam(image_w=cfg.IMAGE_W, image_h=cfg.IMAGE_H, image_d=cfg.IMAGE_DEPTH)
  File "/home/jetson/donkeycar/donkeycar/parts/camera.py", line 106, in __init__
    self.init_camera(image_w, image_h, image_d, camera_index)
  File "/home/jetson/donkeycar/donkeycar/parts/camera.py", line 153, in init_camera
    raise CameraError("Unable to open Webcam.\n"
donkeycar.parts.camera.CameraError: Unable to open Webcam.
If more than one camera is available then make sure your 'CAMERA_INDEX' is correct in myconfig.py

Heavy02011, 2023-12-08:
can you please paste a link to your myconfig.py

seed0097, 2023-12-08:
There is myconfig.py and config.py
https://drive.google.com/drive/folders/1kf6A8L85rkjjGP6ORhDVD0NM491Lr8SE?usp=sharing

Using video 0 open the camera normally.
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

use video1
(env) jetson@orin-nano:~/mycar$ python3 test_camera-usb.py
[ WARN:0] global /tmp/pip-req-build-frgo6bcn/opencv/modules/videoio/src/cap_v4l.cpp (890) open VIDEOIO(V4L2:/dev/video1): can't open camera by index
Traceback (most recent call last):
  File "test_camera-usb.py", line 10, in <module>
    cv2.imshow('frame',frame)
cv2.error: OpenCV(4.5.4) /tmp/pip-req-build-frgo6bcn/opencv/modules/highgui/src/window.cpp:1006: error: (-215:Assertion failed) size.width>0 && size.height>0 in function 'imshow'

seed0097, 2023-12-11:
Thank you for your reply.

When I use
donkey calibrate --channel 0 --bus=7
The wheels can rotate normally, but when executing python3 manage.py drive, those errors occur. Changing it to 1 also displays the same errors.

Because BUS 1 seems to be using 0x40???
https://jetsonhacks.com/nvidia-jetson-orin-nano-gpio-header-pinout/

Thread 1158 (2023-12-30):

error: (-215) scn == 3 || scn == 4 in function cvtColor   (JP=4.5.1)(DC=4.2.1)

0jeetparmar0, 2023-12-30:
using donkey v4.2.1 ...
loading config file: /home/jetson/mycar/config.py
loading personal config over-rides from myconfig.py
INFO:root:PID: 8536
INFO:root:cfg.CAMERA_TYPE CSIC
cfg.CAMERA_TYPE CSIC
INFO:donkeycar.vehicle:Adding part CSICamera.
Adding part CSICamera.
Starting Donkey Server...... you can now go to jetson.local:8887 to drive your car.
INFO:donkeycar.vehicle:Adding part LocalWebController.
Adding part LocalWebController.
INFO:donkeycar.vehicle:Adding part ThrottleFilter.
Adding part ThrottleFilter.
INFO:donkeycar.vehicle:Adding part PilotCondition.
Adding part PilotCondition.
INFO:donkeycar.vehicle:Adding part RecordTracker.
Adding part RecordTracker.
INFO:donkeycar.vehicle:Adding part DriveMode.
Adding part DriveMode.
INFO:donkeycar.vehicle:Adding part AiLaunch.
Adding part AiLaunch.
INFO:donkeycar.vehicle:Adding part AiRunCondition.
Adding part AiRunCondition.
PWM Steering created
Init ESC
PWM Throttle created
INFO:donkeycar.vehicle:Adding part PWMSteering.
Adding part PWMSteering.
INFO:donkeycar.vehicle:Adding part PWMThrottle.
Adding part PWMThrottle.
Using catalog /home/jetson/mycar/data/catalog_1.catalog
INFO:donkeycar.vehicle:Adding part TubWriter.
Adding part TubWriter.
You can now go to <your hostname.local>:8887 to drive your car.
INFO:donkeycar.vehicle:Starting vehicle at 20 Hz
Starting vehicle at 20 Hz
OpenCV Error: Assertion failed (scn == 3 || scn == 4) in cvtColor, file /build/opencv-XDqSFW/opencv-3.2.0+dfsg/modules/imgproc/src/color.cpp, line 9716
Exception in thread Thread-1:
Traceback (most recent call last):
  File "/usr/lib/python3.6/threading.py", line 916, in _bootstrap_inner
    self.run()
  File "/usr/lib/python3.6/threading.py", line 864, in run
    self._target(*self._args, **self._kwargs)
  File "/home/jetson/projects/donkeycar/donkeycar/parts/camera.py", line 174, in update
    self.init_camera()
  File "/home/jetson/projects/donkeycar/donkeycar/parts/camera.py", line 169, in init_camera
    self.poll_camera()
  File "/home/jetson/projects/donkeycar/donkeycar/parts/camera.py", line 181, in poll_camera
    self.frame = cv2.cvtColor(frame, cv2.COLOR_BGR2RGB)
cv2.error: /build/opencv-XDqSFW/opencv-3.2.0+dfsg/modules/imgproc/src/color.cpp:9716: error: (-215) scn == 3 || scn == 4 in function cvtColor

TCIII, 2023-12-30:
@0jeetparmar0
What single board computer and OS are you using?
TCIII

0jeetparmar0, 2023-12-30:
using jetson nano with jetpack 4.5.1 and ubuntu 18.04

0jeetparmar0, 2023-12-30:
> @0jeetparmar0 What single board computer and OS are you using? TCIII

the motors are spinning according  to command but the webserver video output is not working

TCIII, 2023-12-30:
@0jeetparmar0
Are you using a Waveshare product? If so, did you follow their instructions to install Donkey Car 4.2.1?

0jeetparmar0, 2023-12-30:
> @0jeetparmar0 Are you using a Waveshare product? If so, did you follow their instructions to install Donkey Car 4.2.1?

i am using waveshare product but i installed the robocar donkey car again and  got the same error i installed everything as stated over there

0jeetparmar0, 2023-12-31:
hey can you help me to remove this error?

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

TCIII, 2023-12-31:
@0jeetparmar0,
I think that it would be best to post in the DC Discord Software forum as there are number of members there that can provide more assistance than I can to help resolve your issue.
TCIII

Ezward, 2024-02-04:
I am closing this as not a bug.  @TCIII thank you for redirecting the user to the discord for support.

Closed 2024-02-04.

Thread 1176 (2024-05-02):

I2C messages are sent too close to each other

Prototyx, 2024-05-02:
Hello,

I made a donkey car with a RPi 4 (CM4) connected to an Arduino UNO via I2C.

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

Basically my Arduino UNO is replacing the PCA9685. I have my ESC and my servo attached to some PWM pins on my arduino.

It seems that there is one thread for the steering, and another one for the throttle. And each thread send their command via I2C too close to each other.

Issue : I2C messages too close to each other
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

Is there a way to not have both thread sending I2C commands at the same  time ? I think PCA9685 can manage 2 I2C messages very close to each other but on for my Uno it seems  very difficult. I have a lot of I/O  Errors. When I do the calibration for only the steering or throttle  it works well.

Solution :
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

Thanks for your help.

Ezward, 2024-05-08:
@Prototyx what type of Arduino are you using?  Is it 5v or 3.3v?  How are you handling the logic-level conversion between the RPi and the Arduino if the Arduino is 5v?

Prototyx, 2024-05-08:
Hello, The arduino is 5V (it's Atmega328p, same as uno board).  I am using a logic level converter between the Arduino and RPi  designed for I2C communications (PCA9306).
I made some investigations today :
- I2C in Fast mode (400kbit/s) --> A lot of I/O errors
- I2C in Standard mode (100kbit/s)  -->  Something like 1 error per minute

When I put the scope on I2C lines, in fast mode the frequency is not stable at all, I think the RPi has to deal with others tasks with higher priority and decreases the frequency, maybe it is for this reason that it causes a lot of errors, because the arduino is not able to manage this frequency variation.

Anyway, after decreasing the I2C speed, I was able to drive the car without problem, and I did my first autonomous session. I was very impressed !

Ezward, 2024-05-12:
@Prototyx Thank you for detailing the resolution.  I'm closing this issue.

Closed 2024-05-12.

Thread 1177 (2024-05-12):

I2c package needs to be update to work on bookworm

Ezward, 2024-05-12:
Users have indicated that PCA9685 is not working on RaspberryPi OS Bookworm.  This is likely because we are using a very old an deprecated library that was not updated to handle the change in how gpio is addressed in RaspberryPi OS.

The old dependency is [Adafruit_PCA9685](https://github.com/adafruit/Adafruit_Python_PCA9685), which is marked as deprecated and suggests using [Adafruit_CircuitPython_PCA9685](https://github.com/adafruit/Adafruit_CircuitPython_PCA9685).

Adafruit_CircuitPython_PCA9685 has two pieces we need, the [PCA9685](https://github.com/adafruit/Adafruit_CircuitPython_PCA9685/blob/874545d908077baed0be8055cbbc63280a00c034/adafruit_pca9685.py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) class which initialized the PCA9685 bus, address and frequency, and the [PWMChannel](https://github.com/adafruit/Adafruit_CircuitPython_PCA9685/blob/874545d908077baed0be8055cbbc63280a00c034/adafruit_pca9685.py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) class, which controls a specific servo channel on the board.

We need to update the code in two places to use the new classes.  The first is in the pin specifiers code, [pins.py](https://github.com/autorope/donkeycar/blob/main/donkeycar/parts/pins.py).  The [pins.py:PCA9685](https://github.com/autorope/donkeycar/blob/45dc516d918db177ee5e49dc75a7d6e23e6d9978/donkeycar/parts/pins.py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) class should now import the [Adafruit_CircuitPython_PCA9685:PCA9685](https://github.com/adafruit/Adafruit_CircuitPython_PCA9685/blob/874545d908077baed0be8055cbbc63280a00c034) class to initialize the board.  Then for each pin that is created, it will instantiate a [Adafruit_CircuitPython_PCA9685:PWMChannel]((https://github.com/adafruit/Adafruit_CircuitPython_PCA9685/blob/874545d908077baed0be8055cbbc63280a00c034/adafruit_pca9685.py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) to control the pin.

The other place to update is the legacy [donkeycar/parts/actuator.py:PCA9685](https://github.com/autorope/donkeycar/blob/45dc516d918db177ee5e49dc75a7d6e23e6d9978/donkeycar/parts/actuator.py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) actuator class.  Here we can eliminate duplication by instantiating a pwm pin using the pin providers [PwmPinPCA9685](https://github.com/autorope/donkeycar/blob/45dc516d918db177ee5e49dc75a7d6e23e6d9978/donkeycar/parts/pins.py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) function, calling it with the [pca9685](https://github.com/autorope/donkeycar/blob/45dc516d918db177ee5e49dc75a7d6e23e6d9978/donkeycar/parts/pins.py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) factory method to get the shared driver.  If we do that then all the PCA9685 code is in one place.

Ezward, 2024-05-12:
Removing the old driver and install the new one only changes that one package; all the other related packages are not affected.  That is good news.
```
(env) ed@raspberrypi5:~/projects/donkeycar $ pip uninstall Adafruit_PCA9685
Found existing installation: Adafruit-PCA9685 1.0.1
Uninstalling Adafruit-PCA9685-1.0.1:
  Would remove:
    /home/ed/projects/donkeycar/env/lib/python3.11/site-packages/Adafruit_PCA9685-1.0.1.dist-info/*
    /home/ed/projects/donkeycar/env/lib/python3.11/site-packages/Adafruit_PCA9685/*
Proceed (Y/n)? Y
  Successfully uninstalled Adafruit-PCA9685-1.0.1
(env) ed@raspberrypi5:~/projects/donkeycar $ pip3 install adafruit-circuitpython-pca9685
Looking in indexes: https://pypi.org/simple, https://www.piwheels.org/simple
Collecting adafruit-circuitpython-pca9685
  Downloading https://www.piwheels.org/simple/adafruit-circuitpython-pca9685/adafruit_circuitpython_pca9685-3.4.15-py3-none-any.whl (6.0 kB)
Requirement already satisfied: Adafruit-Blinka in ./env/lib/python3.11/site-packages (from adafruit-circuitpython-pca9685) (8.39.1)
Requirement already satisfied: adafruit-circuitpython-register in ./env/lib/python3.11/site-packages (from adafruit-circuitpython-pca9685) (1.9.18)
Requirement already satisfied: adafruit-circuitpython-busdevice in ./env/lib/python3.11/site-packages (from adafruit-circuitpython-pca9685) (5.2.9)
Requirement already satisfied: Adafruit-PlatformDetect>=3.62.0 in ./env/lib/python3.11/site-packages (from Adafruit-Blinka->adafruit-circuitpython-pca9685) (3.62.0)
Requirement already satisfied: Adafruit-PureIO>=1.1.7 in ./env/lib/python3.11/site-packages (from Adafruit-Blinka->adafruit-circuitpython-pca9685) (1.1.11)
Requirement already satisfied: pyftdi>=0.40.0 in ./env/lib/python3.11/site-packages (from Adafruit-Blinka->adafruit-circuitpython-pca9685) (0.55.4)
Requirement already satisfied: adafruit-circuitpython-typing in ./env/lib/python3.11/site-packages (from Adafruit-Blinka->adafruit-circuitpython-pca9685) (1.10.3)
Requirement already satisfied: RPi.GPIO in /usr/lib/python3/dist-packages (from Adafruit-Blinka->adafruit-circuitpython-pca9685) (0.7.1a4)
Requirement already satisfied: rpi-ws281x>=4.0.0 in ./env/lib/python3.11/site-packages (from Adafruit-Blinka->adafruit-circuitpython-pca9685) (5.0.0)
Requirement already satisfied: sysv-ipc>=1.1.0 in ./env/lib/python3.11/site-packages (from Adafruit-Blinka->adafruit-circuitpython-pca9685) (1.1.0)
Requirement already satisfied: typing-extensions~=4.0 in ./env/lib/python3.11/site-packages (from adafruit-circuitpython-register->adafruit-circuitpython-pca9685) (4.11.0)
Requirement already satisfied: adafruit-circuitpython-requests in ./env/lib/python3.11/site-packages (from adafruit-circuitpython-typing->Adafruit-Blinka->adafruit-circuitpython-pca9685) (3.2.8)
Requirement already satisfied: pyusb!=1.2.0,>=1.0.0 in ./env/lib/python3.11/site-packages (from pyftdi>=0.40.0->Adafruit-Blinka->adafruit-circuitpython-pca9685) (1.2.1)
Requirement already satisfied: pyserial>=3.0 in /usr/lib/python3/dist-packages (from pyftdi>=0.40.0->Adafruit-Blinka->adafruit-circuitpython-pca9685) (3.5)
Requirement already satisfied: Adafruit-Circuitpython-ConnectionManager in ./env/lib/python3.11/site-packages (from adafruit-circuitpython-requests->adafruit-circuitpython-typing->Adafruit-Blinka->adafruit-circuitpython-pca9685) (2.0.0)
Installing collected packages: adafruit-circuitpython-pca9685
Successfully installed adafruit-circuitpython-pca9685-3.4.15
```

Ezward, 2024-05-13:
Branch: https://github.com/autorope/donkeycar/tree/1177-update-i2c-driver-for-bookwork

Ezward, 2024-05-20:
I've tested main (donkey 5.1dev1) and it works fine on a RaspberryPi 5 with RaspberryPi OS bookworm.  So I am closing this issue because we do not need it right now. I'm closing the associated PR https://github.com/autorope/donkeycar/pull/1178 as well. That code has some bug i the throttle output, but is mostly complete, so I'll keep the branch around in case we decide we want to do this work in the future.

Closed 2024-05-20.

Thread 1187 (2024-06-12):

Enconter

1328032567, 2024-06-12:
After successfully configuring all the necessary environment dependencies for the donkeycar project, an error originating from the manage.py script. The specific error message reads:

```bash
(env) ➜  mycar python ~/mycar/manage.py drive
________             ______                   _________
___  __ \_______________  /___________  __    __  ____/_____ ________
__  / / /  __ \_  __ \_  //_/  _ \_  / / /    _  /    _  __ `/_  ___/
_  /_/ // /_/ /  / / /  ,<  /  __/  /_/ /     / /___  / /_/ /_  /
/_____/ \____//_/ /_//_/|_| \___/_\__, /      \____/  \__,_/ /_/
                                 /____/

using donkey v5.2.dev0 ...
INFO:donkeycar.config:loading config file: /home/admin/mycar/config.py
INFO:donkeycar.config:loading personal config over-rides from myconfig.py
INFO:donkeycar.templates.complete:cfg.CAMERA_TYPE PICAM
[1:07:46.745294712] [8708]  INFO Camera camera_manager.cpp:284 libcamera v0.2.0+120-eb00c13d
[1:07:46.771282844] [8714]  WARN RPiSdn sdn.cpp:40 Using legacy SDN tuning - please consider moving SDN inside rpi.denoise
[1:07:46.773854867] [8714]  INFO RPI vc4.cpp:446 Registered camera /base/soc/i2c0mux/i2c@1/ov5647@36 to Unicam device /dev/media4 and ISP device /dev/media1
[1:07:46.773972477] [8714]  INFO RPI pipeline_base.cpp:1102 Using configuration file '/usr/share/libcamera/pipeline/rpi/vc4/rpi_apps.yaml'
[1:07:46.776431630] [8708]  INFO Camera camera_manager.cpp:284 libcamera v0.2.0+120-eb00c13d
[1:07:46.801027418] [8717]  WARN RPiSdn sdn.cpp:40 Using legacy SDN tuning - please consider moving SDN inside rpi.denoise
[1:07:46.803092184] [8717]  INFO RPI vc4.cpp:446 Registered camera /base/soc/i2c0mux/i2c@1/ov5647@36 to Unicam device /dev/media4 and ISP device /dev/media1
[1:07:46.803200128] [8717]  INFO RPI pipeline_base.cpp:1102 Using configuration file '/usr/share/libcamera/pipeline/rpi/vc4/rpi_apps.yaml'
INFO:picamera2.picamera2:Initialization successful.
INFO:picamera2.picamera2:Camera now open.
INFO:picamera2.picamera2:Camera configuration has been adjusted!
[1:07:46.810740716] [8708]  INFO Camera camera.cpp:1183 configuring streams: (0) 320x240-BGR888 (1) 640x480-SGBRG10_CSI2P
[1:07:46.811147639] [8717]  INFO RPI vc4.cpp:621 Sensor: /base/soc/i2c0mux/i2c@1/ov5647@36 - Selected sensor format: 640x480-SGBRG10_1X10 - Selected unicam format: 640x480-pGAA
INFO:picamera2.picamera2:Configuration successful!
INFO:picamera2.picamera2:Camera started
INFO:donkeycar.parts.camera:PiCamera opened...
INFO:donkeycar.parts.camera:...warming camera
INFO:donkeycar.parts.camera:PiCamera ready.
INFO:donkeycar.vehicle:Adding part PiCamera.
INFO:donkeycar.parts.web_controller.web:Starting Donkey Server...
INFO:donkeycar.parts.web_controller.web:You can now go to donkey.local:8887 to drive your car.
INFO:donkeycar.vehicle:Adding part LocalWebController.
INFO:donkeycar.vehicle:Adding part ExplodeDict.
INFO:donkeycar.vehicle:Adding part UserPilotCondition.
INFO:donkeycar.vehicle:Adding part LineFollower.
INFO:donkeycar.vehicle:Adding part ToggleRecording.
Toggle recording button is option
Decrement PID P button is L2
Increment PID P button is R2
INFO:donkeycar.vehicle:Adding part DriveMode.
INFO:donkeycar.parts.actuator:PWM Steering created
INFO:donkeycar.parts.actuator:Init ESC
INFO:donkeycar.parts.actuator:PWM Throttle created
INFO:donkeycar.vehicle:Adding part PWMSteering.
INFO:donkeycar.vehicle:Adding part PWMThrottle.
Traceback (most recent call last):
  File "/home/admin/mycar/manage.py", line 260, in <module>
    drive(cfg, use_joystick=args['--js'], camera_type=args['--camera'])
  File "/home/admin/mycar/manage.py", line 202, in drive
    tub_writer = TubWriter(tub_path, inputs=inputs, types=types, metadata=meta)
                 ^^^^^^^^^^^^^^^^^^^^^^^^^^^^^^^^^^^^^^^^^^^^^^^^^^^^^^^^^^^^^^
  File "/home/admin/projects/donkeycar/parts/tub_v2.py", line 125, in __init__
    self.tub = Tub(base_path, inputs, types, metadata, max_catalog_len)
               ^^^^^^^^^^^^^^^^^^^^^^^^^^^^^^^^^^^^^^^^^^^^^^^^^^^^^^^^
  File "/home/admin/projects/donkeycar/parts/tub_v2.py", line 30, in __init__
    self.manifest = Manifest(base_path, inputs=inputs, types=types,
                    ^^^^^^^^^^^^^^^^^^^^^^^^^^^^^^^^^^^^^^^^^^^^^^^
  File "/home/admin/projects/donkeycar/parts/datastore_v2.py", line 254, in __init__
    self._read_contents()
  File "/home/admin/projects/donkeycar/parts/datastore_v2.py", line 352, in _read_contents
    manifest_inputs = json.loads(self.seekeable.readline())
                      ^^^^^^^^^^^^^^^^^^^^^^^^^^^^^^^^^^^^^
  File "/usr/lib/python3.11/json/__init__.py", line 346, in loads
    return _default_decoder.decode(s)
           ^^^^^^^^^^^^^^^^^^^^^^^^^^
  File "/usr/lib/python3.11/json/decoder.py", line 337, in decode
    obj, end = self.raw_decode(s, idx=_w(s, 0).end())
               ^^^^^^^^^^^^^^^^^^^^^^^^^^^^^^^^^^^^^^
  File "/usr/lib/python3.11/json/decoder.py", line 355, in raw_decode
    raise JSONDecodeError("Expecting value", s, err.value) from None
json.decoder.JSONDecodeError: Expecting value: line 1 column 1 (char 0)
INFO:picamera2.picamera2:Camera stopped
INFO:picamera2.picamera2:Camera closed successfully.
```

## OS
```bash
admin@donkey
OS: Debian GNU/Linux 12 (bookworm) aarch64
Host: Raspberry Pi 4 Model B Rev 1.5
Kernel: 6.6.20+rpt-rpi-v8
```

Ezward, 2024-06-12:
I looks like it failed trying to load the manifest file from the /data folder.  Has the /data folder been modified?

1328032567, 2024-06-13:
> @1328032567 It looks like it failed trying to load the manifest file from the mycar/data folder. Has the /data folder been modified? Generally you should not modify anything in the mycar/data folder. So you should either restore it to the previous state or delete it and recreate a new empty mycar/data folder. Please let us know.

thank you!!!!!guys, it does work!!!Our group regenerate the directory "mycar"by the command "donkey createcar --template=cv_control --path ~/mycar" and rerun this command, and successfully solved this problem! Then our group modify the file "myconfig.py" again, and it still works. We think that there is some operates we may ignore.So next time our group would like to try Git to manage this project and track the modifies.
Finally, ty again for you in time replying!!!

Thread 1190 (2024-07-01):

When using the mpu9250-jmdev library with the mpu9250 IMU an OSError: [Errno 121] Remote I/O error occurs

TCIII, 2024-07-01:
Hardware: RPi 4B 4GB
OS: Bullseye
DC: v5.0.dev3
MPU: mpu9250 on Robo HAT MM1 at hex address 0x69

IMU configuration in myconfg.py:
# IMU for imu model
HAVE_IMU = True
IMU_SENSOR = 'mpu9250'          # (mpu6050|mpu9250)
IMU_ADDRESS = 0x69
IMU_DLP_CONFIG = 3

Result when running `manage.py drive` from the CLI:
```
using donkey v5.0.dev3 ...
INFO:donkeycar.config:loading config file: /home/tciii/mycar/config.py
INFO:donkeycar.config:loading personal config over-rides from myconfig.py
Traceback (most recent call last):
  File "/home/tciii/env/lib/python3.9/site-packages/mpu9250_jmdev/mpu_9250.py", line 96, in configure
    self.configureAK8963(self.mfs, self.mode)
  File "/home/tciii/env/lib/python3.9/site-packages/mpu9250_jmdev/mpu_9250.py", line 232, in configureAK8963
    self.writeAK(AK8963_CNTL1, 0x00, 0.1)
  File "/home/tciii/env/lib/python3.9/site-packages/mpu9250_jmdev/mpu_9250.py", line 1012, in writeAK
    self.bus.write_byte_data(self.address_ak, register, value)
  File "/usr/local/lib/python3.9/dist-packages/smbus2/smbus2.py", line 455, in write_byte_data
    ioctl(self.fd, I2C_SMBUS, msg)
OSError: [Errno 121] Remote I/O error

During handling of the above exception, another exception occurred:

Traceback (most recent call last):
  File "/home/tciii/env/lib/python3.9/site-packages/mpu9250_jmdev/mpu_9250.py", line 96, in configure
    self.configureAK8963(self.mfs, self.mode)
  File "/home/tciii/env/lib/python3.9/site-packages/mpu9250_jmdev/mpu_9250.py", line 232, in configureAK8963
    self.writeAK(AK8963_CNTL1, 0x00, 0.1)
  File "/home/tciii/env/lib/python3.9/site-packages/mpu9250_jmdev/mpu_9250.py", line 1012, in writeAK
    self.bus.write_byte_data(self.address_ak, register, value)
  File "/usr/local/lib/python3.9/dist-packages/smbus2/smbus2.py", line 455, in write_byte_data
    ioctl(self.fd, I2C_SMBUS, msg)
OSError: [Errno 121] Remote I/O error

During handling of the above exception, another exception occurred:

Traceback (most recent call last):
  File "/home/tciii/mycar/manage.py", line 494, in <module>
    drive(cfg, use_joystick=args['--js'], camera_type=args['--camera'])
  File "/home/tciii/mycar/manage.py", line 113, in drive
    add_imu(V, cfg)
  File "/home/tciii/projects/donkeycar/donkeycar/templates/complete.py", line 917, in add_imu
    imu = IMU(sensor=cfg.IMU_SENSOR, addr=cfg.IMU_ADDRESS,
  File "/home/tciii/projects/donkeycar/donkeycar/parts/imu.py", line 55, in __init__
    self.sensor.configure()
  File "/home/tciii/env/lib/python3.9/site-packages/mpu9250_jmdev/mpu_9250.py", line 101, in configure
    self.configure(retry - 1)
  File "/home/tciii/env/lib/python3.9/site-packages/mpu9250_jmdev/mpu_9250.py", line 101, in configure
    self.configure(retry - 1)
  File "/home/tciii/env/lib/python3.9/site-packages/mpu9250_jmdev/mpu_9250.py", line 104, in configure
    raise err
  File "/home/tciii/env/lib/python3.9/site-packages/mpu9250_jmdev/mpu_9250.py", line 96, in configure
    self.configureAK8963(self.mfs, self.mode)
  File "/home/tciii/env/lib/python3.9/site-packages/mpu9250_jmdev/mpu_9250.py", line 232, in configureAK8963
    self.writeAK(AK8963_CNTL1, 0x00, 0.1)
  File "/home/tciii/env/lib/python3.9/site-packages/mpu9250_jmdev/mpu_9250.py", line 1012, in writeAK
    self.bus.write_byte_data(self.address_ak, register, value)
  File "/usr/local/lib/python3.9/dist-packages/smbus2/smbus2.py", line 455, in write_byte_data
    ioctl(self.fd, I2C_SMBUS, msg)
OSError: [Errno 121] Remote I/O error
```
Since the mpu9250 is a combination of the mpu6050 imu and the the AK8963 magnetometer, using the mpu6050-raspberrypi library in place of the mpu9250-jmdev library allows error free access to only the mpu6050 imu.

TCIII

TCIII, 2024-07-01:
A recommended solution for the Remote I/O error that occurs when attempting to access the AK8963 magnetometer on the mpu9250 imu/magnetometer module is to use the [imusensor library](https://pypi.org/project/imusensor/) in place of the mpu9250-jmdev library,
Error free access to both the mpu6050 imu and the AK8963 magnetometer when using the imusensor library was validated using the following code snippet:

```
import os
import sys
import time
import smbus

from imusensor.MPU9250 import MPU9250

address = 0x68
bus = smbus.SMBus(1)
imu = MPU9250.MPU9250(bus, address)
imu.begin()

while True:
    imu.readSensor()
    imu.computeOrientation()

    print ("Accel x: {0} ; Accel y : {1} ; Accel z : {2}".format(imu.AccelVals[0], imu.AccelVals[1], imu.AccelVals[2]))
    print ("Gyro x: {0} ; Gyro y : {1} ; Gyro z : {2}".format(imu.GyroVals[0], imu.GyroVals[1], imu.GyroVals[2]))
    print ("Mag x: {0} ; Mag y : {1} ; Mag z : {2}".format(imu.MagVals[0], imu.MagVals[1], imu.MagVals[2]))
    print ("roll: {0} ; pitch : {1} ; yaw : {2}".format(imu.roll, imu.pitch, imu.yaw))
    time.sleep(0.1)
```
When running this code snippet the CLI displayed uncalibrated imu and magnetometer values without an I/O error. To use the imusensor library with the Donkey Car [imu.py](url) part will require a rewrite of the mpu9250 def to remove references to the mpu9250-jmdev library and replace them with the imusensor library.

TCIII

Thread 1201 (2024-10-21):

Error when running model using python manage.py drive --model

LuckyYoon, 2024-10-21:
Both my .savemodel and .tflite models don't work, producing separate errors. I've both models were trained using the donkey ui with around ~11000 pictures. The host computer that was used to trained the model is running donkey v5.2 and the raspberry pi 5 on the car is running donkey v5.1

The .saved model produces the following error:
```
(env) donkey@backseat:~/mycar $ python manage.py drive --model ~/mycar/models/pilot_24-10-17_0.savedmodel --myconfig myconfig.py
________             ______                   _________
___  __ \_______________  /___________  __    __  ____/_____ ________
__  / / /  __ \_  __ \_  //_/  _ \_  / / /    _  /    _  __ `/_  ___/
_  /_/ // /_/ /  / / /  ,<  /  __/  /_/ /     / /___  / /_/ /_  /
/_____/ \____//_/ /_//_/|_| \___/_\__, /      \____/  \__,_/ /_/
                                 /____/

using donkey v5.1.0 ...
INFO:donkeycar.config:loading config file: /home/donkey/mycar/config.py
INFO:donkeycar.config:loading personal config over-rides from myconfig.py
INFO:__main__:PID: 2172
cfg.CAMERA_TYPE PICAM
INFO:__main__:cfg.CAMERA_TYPE PICAM
[0:09:21.170190240] [2172]  INFO Camera camera_manager.cpp:325 libcamera v0.3.2+27-7330f29b
[0:09:21.177607207] [2175]  INFO RPI pisp.cpp:695 libpisp version v1.0.7 28196ed6edcf 29-08-2024 (16:33:32)
[0:09:21.187056736] [2175]  INFO RPI pisp.cpp:1154 Registered camera /base/axi/pcie@120000/rp1/i2c@88000/ov5647@36 to CFE device /dev/media0 and ISP device /dev/media2 using PiSP variant BCM2712_C0
[0:09:21.188278462] [2172]  INFO Camera camera_manager.cpp:325 libcamera v0.3.2+27-7330f29b
[0:09:21.195650595] [2178]  INFO RPI pisp.cpp:695 libpisp version v1.0.7 28196ed6edcf 29-08-2024 (16:33:32)
[0:09:21.205536088] [2178]  INFO RPI pisp.cpp:1154 Registered camera /base/axi/pcie@120000/rp1/i2c@88000/ov5647@36 to CFE device /dev/media0 and ISP device /dev/media2 using PiSP variant BCM2712_C0
INFO:picamera2.picamera2:Initialization successful.
INFO:picamera2.picamera2:Camera now open.
INFO:picamera2.picamera2:Camera configuration has been adjusted!
[0:09:21.208895746] [2172]  INFO Camera camera.cpp:1197 configuring streams: (0) 128x120-BGR888 (1) 640x480-GBRG_PISP_COMP1
[0:09:21.209008969] [2178]  INFO RPI pisp.cpp:1450 Sensor: /base/axi/pcie@120000/rp1/i2c@88000/ov5647@36 - Selected sensor format: 640x480-SGBRG10_1X10 - Selected CFE format: 640x480-PC1g
INFO:picamera2.picamera2:Configuration successful!
INFO:picamera2.picamera2:Camera started
INFO:donkeycar.parts.camera:PiCamera opened...
INFO:donkeycar.parts.camera:...warming camera
INFO:donkeycar.parts.camera:PiCamera ready.
INFO:donkeycar.vehicle:Adding part PiCamera.
INFO:donkeycar.parts.web_controller.web:Starting Donkey Server...
INFO:donkeycar.parts.web_controller.web:You can now go to backseat.local:8887 to drive your car.
INFO:donkeycar.vehicle:Adding part LocalWebController.
INFO:donkeycar.vehicle:Adding part Pipe.
INFO:donkeycar.vehicle:Adding part ExplodeDict.
INFO:donkeycar.vehicle:Adding part Lambda.
INFO:donkeycar.vehicle:Adding part Lambda.
INFO:donkeycar.vehicle:Adding part Lambda.
INFO:donkeycar.vehicle:Adding part Lambda.
INFO:donkeycar.vehicle:Adding part Lambda.
INFO:donkeycar.vehicle:Adding part ThrottleFilter.
INFO:donkeycar.vehicle:Adding part UserPilotCondition.
INFO:donkeycar.vehicle:Adding part RecordTracker.
INFO:donkeycar.utils:get_model_by_type: model type is: linear
INFO:donkeycar.parts.keras:Created KerasLinear with interpreter: KerasInterpreter
loading model /home/donkey/mycar/models/pilot_24-10-17_0.savedmodel
INFO:donkeycar.parts.keras:Loading model /home/donkey/mycar/models/pilot_24-10-17_0.savedmodel
INFO:donkeycar.parts.interpreter:Loading model /home/donkey/mycar/models/pilot_24-10-17_0.savedmodel
finished loading in 0.9478845596313477 sec.
INFO:donkeycar.vehicle:Adding part FileWatcher.
INFO:donkeycar.vehicle:Adding part FileWatcher.
INFO:donkeycar.vehicle:Adding part DelayedTrigger.
INFO:donkeycar.vehicle:Adding part TriggeredCallback.
Adding inference transformations
INFO:__main__:Adding inference transformations
INFO:donkeycar.parts.image_transformations:Creating ImageTransformations []
INFO:donkeycar.vehicle:Adding part ImageTransformations.
INFO:donkeycar.vehicle:Adding part KerasLinear.
INFO:donkeycar.vehicle:Adding part AiLaunch.
INFO:donkeycar.vehicle:Adding part DriveMode.
INFO:donkeycar.vehicle:Adding part ToggleRecording.
INFO:donkeycar.parts.actuator:PWM Steering created
INFO:donkeycar.parts.actuator:Init ESC
INFO:donkeycar.parts.actuator:PWM Throttle created
INFO:donkeycar.vehicle:Adding part PWMSteering.
INFO:donkeycar.vehicle:Adding part PWMThrottle.
INFO:donkeycar.parts.datastore_v2:Found datastore at /home/donkey/mycar/data
INFO:donkeycar.parts.datastore_v2:Using last catalog /home/donkey/mycar/data/catalog_14.catalog
INFO:donkeycar.vehicle:Adding part TubWriter.
You can now go to <your hostname.local>:8887 to drive your car.
You can now move your controller to drive your car.
INFO:donkeycar.vehicle:Starting vehicle at 20 Hz
Traceback (most recent call last):
  File "/home/donkey/env/lib/python3.11/site-packages/donkeycar/vehicle.py", line 155, in start
    self.update_parts()
  File "/home/donkey/env/lib/python3.11/site-packages/donkeycar/vehicle.py", line 209, in update_parts
    outputs = p.run(*inputs)
              ^^^^^^^^^^^^^^
  File "/home/donkey/env/lib/python3.11/site-packages/donkeycar/parts/keras.py", line 116, in run
    return self.inference_from_dict(input_dict)
           ^^^^^^^^^^^^^^^^^^^^^^^^^^^^^^^^^^^^
  File "/home/donkey/env/lib/python3.11/site-packages/donkeycar/parts/keras.py", line 124, in inference_from_dict
    output = self.interpreter.predict_from_dict(input_dict)
             ^^^^^^^^^^^^^^^^^^^^^^^^^^^^^^^^^^^^^^^^^^^^^^
  File "/home/donkey/env/lib/python3.11/site-packages/donkeycar/parts/interpreter.py", line 163, in predict_from_dict
    outputs = self.model(input_dict, training=False)
              ^^^^^^^^^^^^^^^^^^^^^^^^^^^^^^^^^^^^^^
  File "/home/donkey/env/lib/python3.11/site-packages/keras/src/utils/traceback_utils.py", line 70, in error_handler
    raise e.with_traceback(filtered_tb) from None
  File "/home/donkey/env/lib/python3.11/site-packages/keras/src/engine/input_spec.py", line 298, in assert_input_compatibility
    raise ValueError(
ValueError: Input 0 of layer "linear" is incompatible with the layer: expected shape=(None, 120, 160, 3), found shape=(1, 120, 128, 3)
INFO:donkeycar.vehicle:Shutting down vehicle and its parts...
INFO:donkeycar.parts.camera:Stopping PiCamera
INFO:picamera2.picamera2:Camera stopped
INFO:picamera2.picamera2:Camera closed successfully.
INFO:donkeycar.parts.tub_v2:Closing tub /home/donkey/mycar/data
INFO:donkeycar.parts.datastore_v2:Closing manifest /home/donkey/mycar/data
INFO:donkeycar.vehicle:Part Profile Summary: (times in ms)
INFO:donkeycar.vehicle:
+------+-----+-----+-----+-----+-----+-----+-------+
| part | max | min | avg | 50% | 90% | 99% | 99.9% |
+------+-----+-----+-----+-----+-----+-----+-------+
+------+-----+-----+-----+-----+-----+-----+-------+
```

And the .tflite model produces the following error:

```
(env) donkey@backseat:~/mycar $ python manage.py drive --model ~/mycar/models/pilot_24-10-17_0.tflite --myconfig myconfig.py --type tflite_linear
________             ______                   _________
___  __ \_______________  /___________  __    __  ____/_____ ________
__  / / /  __ \_  __ \_  //_/  _ \_  / / /    _  /    _  __ `/_  ___/
_  /_/ // /_/ /  / / /  ,<  /  __/  /_/ /     / /___  / /_/ /_  /
/_____/ \____//_/ /_//_/|_| \___/_\__, /      \____/  \__,_/ /_/
                                 /____/

using donkey v5.1.0 ...
INFO:donkeycar.config:loading config file: /home/donkey/mycar/config.py
INFO:donkeycar.config:loading personal config over-rides from myconfig.py
INFO:__main__:PID: 2149
cfg.CAMERA_TYPE PICAM
INFO:__main__:cfg.CAMERA_TYPE PICAM
[0:07:45.574593072] [2149]  INFO Camera camera_manager.cpp:325 libcamera v0.3.2+27-7330f29b
[0:07:45.582140306] [2152]  INFO RPI pisp.cpp:695 libpisp version v1.0.7 28196ed6edcf 29-08-2024 (16:33:32)
[0:07:45.591667266] [2152]  INFO RPI pisp.cpp:1154 Registered camera /base/axi/pcie@120000/rp1/i2c@88000/ov5647@36 to CFE device /dev/media0 and ISP device /dev/media2 using PiSP variant BCM2712_C0
[0:07:45.592922120] [2149]  INFO Camera camera_manager.cpp:325 libcamera v0.3.2+27-7330f29b
[0:07:45.600254705] [2155]  INFO RPI pisp.cpp:695 libpisp version v1.0.7 28196ed6edcf 29-08-2024 (16:33:32)
[0:07:45.609871850] [2155]  INFO RPI pisp.cpp:1154 Registered camera /base/axi/pcie@120000/rp1/i2c@88000/ov5647@36 to CFE device /dev/media0 and ISP device /dev/media2 using PiSP variant BCM2712_C0
INFO:picamera2.picamera2:Initialization successful.
INFO:picamera2.picamera2:Camera now open.
INFO:picamera2.picamera2:Camera configuration has been adjusted!
[0:07:45.613163170] [2149]  INFO Camera camera.cpp:1197 configuring streams: (0) 128x120-BGR888 (1) 640x480-GBRG_PISP_COMP1
[0:07:45.613268263] [2155]  INFO RPI pisp.cpp:1450 Sensor: /base/axi/pcie@120000/rp1/i2c@88000/ov5647@36 - Selected sensor format: 640x480-SGBRG10_1X10 - Selected CFE format: 640x480-PC1g
INFO:picamera2.picamera2:Configuration successful!
INFO:picamera2.picamera2:Camera started
INFO:donkeycar.parts.camera:PiCamera opened...
INFO:donkeycar.parts.camera:...warming camera
INFO:donkeycar.parts.camera:PiCamera ready.
INFO:donkeycar.vehicle:Adding part PiCamera.
INFO:donkeycar.parts.web_controller.web:Starting Donkey Server...
INFO:donkeycar.parts.web_controller.web:You can now go to backseat.local:8887 to drive your car.
INFO:donkeycar.vehicle:Adding part LocalWebController.
INFO:donkeycar.vehicle:Adding part Pipe.
INFO:donkeycar.vehicle:Adding part ExplodeDict.
INFO:donkeycar.vehicle:Adding part Lambda.
INFO:donkeycar.vehicle:Adding part Lambda.
INFO:donkeycar.vehicle:Adding part Lambda.
INFO:donkeycar.vehicle:Adding part Lambda.
INFO:donkeycar.vehicle:Adding part Lambda.
INFO:donkeycar.vehicle:Adding part ThrottleFilter.
INFO:donkeycar.vehicle:Adding part UserPilotCondition.
INFO:donkeycar.vehicle:Adding part RecordTracker.
INFO:donkeycar.utils:get_model_by_type: model type is: tflite_linear
INFO:donkeycar.parts.keras:Created KerasLinear with interpreter: TfLite
loading model /home/donkey/mycar/models/pilot_24-10-17_0.tflite
INFO:donkeycar.parts.keras:Loading model /home/donkey/mycar/models/pilot_24-10-17_0.tflite
INFO:donkeycar.parts.interpreter:Loading model /home/donkey/mycar/models/pilot_24-10-17_0.tflite
finished loading in 0.0006306171417236328 sec.
INFO:donkeycar.vehicle:Adding part FileWatcher.
INFO:donkeycar.vehicle:Adding part FileWatcher.
INFO:donkeycar.vehicle:Adding part DelayedTrigger.
INFO:donkeycar.vehicle:Adding part TriggeredCallback.
Adding inference transformations
INFO:__main__:Adding inference transformations
INFO:donkeycar.parts.image_transformations:Creating ImageTransformations []
INFO:donkeycar.vehicle:Adding part ImageTransformations.
INFO:donkeycar.vehicle:Adding part KerasLinear.
INFO:donkeycar.vehicle:Adding part AiLaunch.
INFO:donkeycar.vehicle:Adding part DriveMode.
INFO:donkeycar.vehicle:Adding part ToggleRecording.
INFO:donkeycar.parts.actuator:PWM Steering created
INFO:donkeycar.parts.actuator:Init ESC
INFO:donkeycar.parts.actuator:PWM Throttle created
INFO:donkeycar.vehicle:Adding part PWMSteering.
INFO:donkeycar.vehicle:Adding part PWMThrottle.
INFO:donkeycar.parts.datastore_v2:Found datastore at /home/donkey/mycar/data
INFO:donkeycar.parts.datastore_v2:Using last catalog /home/donkey/mycar/data/catalog_14.catalog
INFO:donkeycar.vehicle:Adding part TubWriter.
You can now go to <your hostname.local>:8887 to drive your car.
You can now move your controller to drive your car.
INFO:donkeycar.vehicle:Starting vehicle at 20 Hz
Traceback (most recent call last):
  File "/home/donkey/env/lib/python3.11/site-packages/donkeycar/vehicle.py", line 155, in start
    self.update_parts()
  File "/home/donkey/env/lib/python3.11/site-packages/donkeycar/vehicle.py", line 209, in update_parts
    outputs = p.run(*inputs)
              ^^^^^^^^^^^^^^
  File "/home/donkey/env/lib/python3.11/site-packages/donkeycar/parts/keras.py", line 116, in run
    return self.inference_from_dict(input_dict)
           ^^^^^^^^^^^^^^^^^^^^^^^^^^^^^^^^^^^^
  File "/home/donkey/env/lib/python3.11/site-packages/donkeycar/parts/keras.py", line 124, in inference_from_dict
    output = self.interpreter.predict_from_dict(input_dict)
             ^^^^^^^^^^^^^^^^^^^^^^^^^^^^^^^^^^^^^^^^^^^^^^
  File "/home/donkey/env/lib/python3.11/site-packages/donkeycar/parts/interpreter.py", line 278, in predict_from_dict
    outputs = self.runner(**input_dict)
              ^^^^^^^^^^^^^^^^^^^^^^^^^
  File "/home/donkey/env/lib/python3.11/site-packages/tensorflow/lite/python/interpreter.py", line 243, in __call__
    self._interpreter_wrapper.AllocateTensors(self._subgraph_index)
RuntimeError: tensorflow/lite/kernels/reshape.cc:92 num_input_elements != num_output_elements (4608 != 0)Node number 5 (RESHAPE) failed to prepare.
INFO:donkeycar.vehicle:Shutting down vehicle and its parts...
INFO:donkeycar.parts.camera:Stopping PiCamera
INFO:picamera2.picamera2:Camera stopped
INFO:picamera2.picamera2:Camera closed successfully.
INFO:donkeycar.parts.tub_v2:Closing tub /home/donkey/mycar/data
INFO:donkeycar.parts.datastore_v2:Closing manifest /home/donkey/mycar/data
INFO:donkeycar.vehicle:Part Profile Summary: (times in ms)
INFO:donkeycar.vehicle:
+------+-----+-----+-----+-----+-----+-----+-------+
| part | max | min | avg | 50% | 90% | 99% | 99.9% |
+------+-----+-----+-----+-----+-----+-----+-------+
+------+-----+-----+-----+-----+-----+-----+-------+
```

The myconfig.py file has the pilot mode set to local.

LuckyYoon, 2024-10-21:
FIXED: The Picam was recording in 120 x 128 despite myconfig.py specifying 120 x 160. Thus, the model was trained with the wrong input size. I couldn't figure out a way to get my camera to record in 120 x 160, so I trained a new model with an input size of (None, 120, 128, 3) by changing the IMAGE_W and IMAGE_H in myconfig.py to 128 and 120. Now, the model works with the new size but I'm still not sure why my camera is stuck in this resolution.

Closed 2024-10-21.

Thread 1211 (2025-07-27):

adding support for BeagleY-AI and aarch64 with Specifics

silver2row, 2025-07-27:
Hello,

My name is Seth. I tried to port Donkey Car to a TI based am67a chip (aarch64) without success, e.g. as I do not use libraries outside of `gpiod` and some .dts files for PWM access.

I have PWM access on the board for pushing DC motors forward and in reverse but:

1. I will not be using a PCA9685 for PWM access
2. I will not be using the "RPI_GPIO" or "PIGPIO" libraries
3. If I push some requests with source, can I use that source in Donkey Car

I am seemingly getting wrapped up in changing many pages of source without success. `pins.py` is the main file I have been altering for use with `gpiod` and how beagleboard.org personnel seems to want to promote PWM access.

Anyway, `gpiod` in python3 for input on rising can be found here:

```
import gpiod
from datetime import timedelta
from gpiod.line import Bias, Edge

def watch_rising_edge(chip_path, line_offset):
    """
    Watches for rising edge events on a specified GPIO line.
    """
    with gpiod.request_lines(
        chip_path,
        consumer="rising-edge-detector",
        config={
            line_offset: gpiod.LineSettings(
                edge_detection=Edge.RISING,
                bias=Bias.PULL_DOWN, # Assuming a button connecting to VCC, so pull down
                debounce_period=timedelta(milliseconds=50), # Add debounce for physical buttons
            )
        },
    ) as request:
        print(f"Waiting for rising edge on {chip_path} line {line_offset}...")
        while True:
            # Blocks until at least one event is available
            for event in request.read_edge_events():
                if event.event_type is event.Type.RISING_EDGE:
                    print(f"Rising edge detected on line {event.line_offset} at {event.timestamp_ns} ns")

if __name__ == "__main__":
    # Customize these values for your specific setup
    # For Raspberry Pi 5, external GPIOs are often on gpiochip4
    # For older Raspberry Pis, they are often on gpiochip0
    gpio_chip_path = "/dev/gpiochip0"
    gpio_line_offset = 21  # Replace with your actual GPIO line number

    try:
        watch_rising_edge(gpio_chip_path, gpio_line_offset)
    except OSError as ex:
        print(f"Error: {ex}\nEnsure the chip path and line offset are correct for your system.")
    except KeyboardInterrupt:
        print("\nExiting program.")
```

At first, I tried altering where the `RPI_GPIO` library is imported and exchanged it out for `import gpiod as GPIO`.

Then, in the source above, I changed `gpiod` for `GPIO`, e.g. `GPIO.request_lines()` instead of `gpiod.request_lines()`.

Also, the `./manage.py drive` command returns error no matter what I do. My error is as follows:

```
/Testing_Donkey/donkeycar-5.1.0/lib/python3.11/site-packages/donkeycar/parts/pins.py", line 262, in output_pin_by_id
    raise ValueError(f"Unknown pin provider {parts[0]}")
ValueError: Unknown pin provider PWM
```

I tried with associating PWM as in the `class PinProvider:` and in the `class PinScheme:` but without success.

Do you know where I can look to alter the source in your library for handling such tasks?

Seth

P.S. I think I can make I/O work for GPIO but not PWM so far for some reason (unknown to me thus far).

silver2row, 2025-07-27:
That `gpiod` source was accumulated from AI online via the Google browser. I can alter that source to handle GPIO I/O easily but I am afraid that I do not know where it belongs within our source nor do I understand what keeps me from utilizing it.

TCIII, 2025-07-27:
@silver2row,
Is there a specific reason that you don't want to use the PCA9685 to generate PWM signals as it sounds like its use would negate your issue?
TCIII

DocGarbanzo, 2025-07-28:
@silver2row - I don't think it makes sense for Donkey Car to support the beagle board officially. We used to support the RPi and Jetson Nano, but it has turned out to be very difficult to keep Donkey Car working on both platforms, and only the RPi works with all versions. There is simply not enough people maintaining a wider set of hardware within the Donkey Car group. If you want to add/change the code such that it works with the beagle board, then you will be better off to fork the repo and get everything working on your hardware.

Closed 2025-07-28.
