autorope/donkeycar/donkeycar/parts/actuator.py

"""
actuators.py
Classes to control the motors and servos. These classes 
are wrapped in a mixer class before being used in the drive loop.
"""

from abc import ABC, abstractmethod
import time
import logging
from typing import Tuple

import donkeycar as dk
from donkeycar import utils
from donkeycar.utils import clamp

logger = logging.getLogger(__name__)

try:
    import RPi.GPIO as GPIO
except ImportError as e:
    logger.warning(f"RPi.GPIO was not imported. {e}")
    globals()["GPIO"] = None

from donkeycar.parts.pins import OutputPin, PwmPin, PinState
from donkeycar.utilities.deprecated import deprecated

logger = logging.getLogger(__name__)


#
# pwm/duty-cycle/pulse
# - Standard RC servo pulses range from 1 millisecond (full reverse)
#   to 2 milliseconds (full forward) with 1.5 milliseconds being neutral (stopped).
# - These pulses are typically send at 50 hertz (every 20 milliseconds).
# - This means that, using the standard 50hz frequency, a 1 ms pulse
#   represents a 5% duty cycle and a 2 ms pulse represents a 10% duty cycle.
# - The important part is the length of the pulse;
#   it must be in the range of 1 ms to 2ms.
# - So this means that if a different frequency is used, then the duty cycle
#   must be adjusted in order to get the 1ms to 2ms pulse.
# - For instance, if a 60hz frequency is used, then a 1 ms pulse requires
#   a duty cycle of 0.05 * 60 / 50 = 0.06 (6%) duty cycle
# - We default the frequency of our PCA9685 to 60 hz, so pulses in
#   config are generally based on 60hz frequency and 12 bit values.
#   We use 12 bit values because the PCA9685 has 12 bit resolution.
#   So a 1 ms pulse is 0.06 * 4096 ~= 246, a neutral pulse of 0.09 duty cycle
#   is 0.09 * 4096 ~= 367 and full forward pulse of 0.12 duty cycles
#   is 0.12 * 4096 ~= 492
# - These are generalizations that are useful for understanding the underlying
#   api call arguments.  The final choice of duty-cycle/pulse length depends
#   on your hardware and perhaps your strategy (you may not want to go too fast,
#   and so you may choose is low max throttle pwm)
#

def duty_cycle(pulse_ms:float, frequency_hz:float) -> float:
    """
    Calculate the duty cycle, 0 to 1, of a pulse given
    the frequency and the pulse length

    :param pulse_ms:float the desired pulse length in milliseconds
    :param frequency_hz:float the pwm frequency in hertz
    :return:float duty cycle in range 0 to 1
    """
    ms_per_cycle = 1000 / frequency_hz
    duty = pulse_ms / ms_per_cycle
    return duty


def pulse_ms(pulse_bits:int) -> float:
    """
    Calculate pulse width in milliseconds given a
    12bit pulse (as a PCA9685 would use).
    Donkeycar throttle and steering PWM values are
    based on PCA9685 12bit pulse values, where
    0 is zero duty cycle and 4095 is 100% duty cycle.

    :param pulse_bits:int 12bit integer in range 0 to 4095
    :return:float pulse length in milliseconds
    """
    if pulse_bits < 0 or pulse_bits > 4095:
        raise ValueError("pulse_bits must be in range 0 to 4095 (12bit integer)")
    return pulse_bits / 4095


class PulseController:
    """
    Controller that provides a servo PWM pulse using the given PwmPin
    See pins.py for pin provider implementations.
    """

    def __init__(self, pwm_pin:PwmPin, pwm_scale:float = 1.0, pwm_inverted:bool = False) -> None:
        """
        :param pwm_pin:PwnPin pin that will emit the pulse.
        :param pwm_scale:float scaling the 12 bit pulse value to compensate
                        for non-standard pwm frequencies.
        :param pwm_inverted:bool True to invert the duty cycle
        """
        self.pwm_pin = pwm_pin
        self.scale = pwm_scale
        self.inverted = pwm_inverted
        self.started = pwm_pin.state() != PinState.NOT_STARTED

    def set_pulse(self, pulse:int) -> None:
        """
        Set the length of the pulse using a 12 bit integer (0..4095)
        :param pulse:int 12bit integer (0..4095)
        """
        if pulse < 0 or pulse > 4095:
            logging.error("pulse must be in range 0 to 4095")
            pulse = clamp(pulse, 0, 4095)

        if not self.started:
            self.pwm_pin.start()
            self.started = True
        if self.inverted:
            pulse = 4095 - pulse
        self.pwm_pin.duty_cycle(int(pulse * self.scale) / 4095)

    def run(self, pulse:int) -> None:
        """
        Set the length of the pulse using a 12 bit integer (0..4095)
        :param pulse:int 12bit integer (0..4095)
        """
        self.set_pulse(pulse)


@deprecated("Deprecated in favor or PulseController.  This will be removed in a future release")
class PCA9685(PulseController):
    '''
    PWM motor controler using PCA9685 boards.
    This is used for most RC Cars.

    Kept as a thin PulseController over a PwmPinPCA9685 so that the pulse
    scaling, clamping and start-on-first-use behaviour live in one place.
    '''
    def __init__(self, channel, address=0x40, frequency=60, busnum=1,
                 init_delay=0.1):
        from donkeycar.parts.pins import PwmPinPCA9685

        if busnum is None:
            # The old implementation took None to mean "whichever bus the
            # Adafruit_GPIO default happened to be".  There is no such
            # default now, and a pin id always carries a bus number, so be
            # explicit rather than guessing.
            busnum = 1
            logger.warning("PCA9685 busnum was None; defaulting to bus 1. "
                           "Set busnum explicitly (see PCA9685_I2C_BUSNUM).")
        pwm_pin = PwmPinPCA9685(channel, busnum, address, frequency)
        super().__init__(pwm_pin, frequency / 60, False)
        self.channel = channel
        time.sleep(init_delay) # "Tamiya TBLE-02" makes a little leap otherwise

    def set_high(self):
        self.pwm_pin.pca_pin.set_high()

    def set_low(self):
        self.pwm_pin.pca_pin.set_low()

    def set_duty_cycle(self, duty_cycle):
        if duty_cycle < 0 or duty_cycle > 1:
            logging.error("duty_cycle must be in range 0 to 1")
            duty_cycle = clamp(duty_cycle, 0, 1)
        self.pwm_pin.pca_pin.set_duty_cycle(duty_cycle)


class VESC:
    ''' 
    VESC Motor controler using pyvesc
    This is used for most electric scateboards.
    
    inputs: serial_port---- port used communicate with vesc. for linux should be something like /dev/ttyACM1
    has_sensor=False------- default value from pyvesc
    start_heartbeat=True----default value from pyvesc (I believe this sets up a heartbeat and kills speed if lost)
    baudrate=115200--------- baudrate used for communication with VESC
    timeout=0.05-------------time it will try before giving up on establishing connection
    
    percent=.2--------------max percentage of the dutycycle that the motor will be set to
    outputs: none
    
    uses the pyvesc library to open communication with the VESC and sets the servo to the angle (0-1) and the duty_cycle(speed of the car) to the throttle (mapped so that percentage will be max/min speed)
    
    Note that this depends on pyvesc, but using pip install pyvesc will create a pyvesc file that
    can only set the speed, but not set the servo angle. 
    
    Instead please use:
    pip install git+https://github.com/LiamBindle/PyVESC.git@master
    to install the pyvesc library
    '''
    def __init__(self, serial_port, percent=.2, has_sensor=False, start_heartbeat=True, baudrate=115200, timeout=0.05, steering_scale = 1.0, steering_offset = 0.0 ):
        
        try:
            import pyvesc
        except Exception as err:
            print("\n\n\n\n", err, "\n")
            print("please use the following command to import pyvesc so that you can also set")
            print("the servo position:")
            print("pip install git+https://github.com/LiamBindle/PyVESC.git@master")
            print("\n\n\n")
            time.sleep(1)
            raise
        
        assert percent <= 1 and percent >= -1,'\n\nOnly percentages are allowed for MAX_VESC_SPEED (we recommend a value of about .2) (negative values flip direction of motor)'
        self.steering_scale = steering_scale
        self.steering_offset = steering_offset
        self.percent = percent
        
        try:
            self.v = pyvesc.VESC(serial_port, has_sensor, start_heartbeat, baudrate, timeout)
        except Exception as err:
            print("\n\n\n\n", err)
            print("\n\nto fix permission denied errors, try running the following command:")
            print("sudo chmod a+rw {}".format(serial_port), "\n\n\n\n")
            time.sleep(1)
            raise
        
    def run(self, angle, throttle):
        self.v.set_servo((angle * self.steering_scale) + self.steering_offset)
        self.v.set_duty_cycle(throttle*self.percent)


@deprecated("Deprecated in favor or PulseController.  This will be removed in a future release")
class PiGPIO_PWM():
    '''
    # Use the pigpio python module and daemon to get hardware pwm controls from
    # a raspberrypi gpio pins and no additional hardware. Can serve as a replacement
    # for PCA9685.
    #
    # Install and setup:
    # sudo apt update && sudo apt install pigpio python3-pigpio
    # sudo systemctl start pigpiod
    #
    # Note: the range of pulses will differ from those required for PCA9685
    # and can range from 12K to 170K
    #
    # If you use a control circuit that inverts the steering signal, set inverted to True
    # Default multipler for pulses from config etc is 100
    #
    #
    '''

    def __init__(self, pin, pgio=None, freq=75, inverted=False):
        import pigpio
        self.pin = pin
        self.pgio = pgio or pigpio.pi()
        self.freq = freq
        self.inverted = inverted
        self.pgio.set_mode(self.pin, pigpio.OUTPUT)
        self.dead_zone = 37000

    def __del__(self):
        self.pgio.stop()

    def set_pulse(self, pulse):
#
        self.output = pulse * 200
        if self.output > 0:
            self.pgio.hardware_PWM(self.pin, self.freq, int(self.output if self.inverted == False else 1e6 - self.output))


    def run(self, pulse):
        self.set_pulse(pulse)


class PWMSteering:
    """
    Wrapper over a PWM pulse controller to convert angles to PWM pulses.
    """
    LEFT_ANGLE = -1
    RIGHT_ANGLE = 1

    def __init__(self, controller, left_pulse, right_pulse):

        if controller is None:
            raise ValueError("PWMSteering requires a set_pulse controller to be passed")
        set_pulse = getattr(controller, "set_pulse", None)
        if set_pulse is None or not callable(set_pulse):
            raise ValueError("controller must have a set_pulse method")
        if not utils.is_number_type(left_pulse):
            raise ValueError("left_pulse must be a number")
        if not utils.is_number_type(right_pulse):
            raise ValueError("right_pulse must be a number")

        self.controller = controller
        self.left_pulse = left_pulse
        self.right_pulse = right_pulse
        self.pulse = dk.utils.map_range(0, self.LEFT_ANGLE, self.RIGHT_ANGLE,
                                        self.left_pulse, self.right_pulse)
        self.running = True
        logger.info('PWM Steering created')

    def update(self):
        while self.running:
            self.controller.set_pulse(self.pulse)

    def run_threaded(self, angle):
        # map absolute angle to angle that vehicle can implement.
        angle = utils.clamp(angle, self.LEFT_ANGLE, self.RIGHT_ANGLE)
        self.pulse = dk.utils.map_range(angle,
                                        self.LEFT_ANGLE, self.RIGHT_ANGLE,
                                        self.left_pulse, self.right_pulse)

    def run(self, angle):
        self.run_threaded(angle)
        self.controller.set_pulse(self.pulse)

    def shutdown(self):
        # set steering straight
        self.pulse = 0
        time.sleep(0.3)
        self.running = False


class PWMThrottle:
    """
    Wrapper over a PWM pulse controller to convert -1 to 1 throttle
    values to PWM pulses.
    """
    MIN_THROTTLE = -1
    MAX_THROTTLE = 1

    def __init__(self, controller, max_pulse, min_pulse, zero_pulse):

        if controller is None:
            raise ValueError("PWMThrottle requires a set_pulse controller to be passed")
        set_pulse = getattr(controller, "set_pulse", None)
        if set_pulse is None or not callable(set_pulse):
            raise ValueError("controller must have a set_pulse method")

        self.controller = controller
        self.max_pulse = max_pulse
        self.min_pulse = min_pulse
        self.zero_pulse = zero_pulse
        self.pulse = zero_pulse

        # send zero pulse to calibrate ESC
        logger.info("Init ESC")
        self.controller.set_pulse(self.max_pulse)
        time.sleep(0.01)
        self.controller.set_pulse(self.min_pulse)
        time.sleep(0.01)
        self.controller.set_pulse(self.zero_pulse)
        time.sleep(1)
        self.running = True
        logger.info('PWM Throttle created')

    def update(self):
        while self.running:
            self.controller.set_pulse(self.pulse)

    def run_threaded(self, throttle):
        throttle = utils.clamp(throttle, self.MIN_THROTTLE, self.MAX_THROTTLE)
        if throttle > 0:
            self.pulse = dk.utils.map_range(throttle, 0, self.MAX_THROTTLE,
                                            self.zero_pulse, self.max_pulse)
        else:
            self.pulse = dk.utils.map_range(throttle, self.MIN_THROTTLE, 0,
                                            self.min_pulse, self.zero_pulse)

    def run(self, throttle):
        self.run_threaded(throttle)
        self.controller.set_pulse(self.pulse)

    def shutdown(self):
        # stop vehicle
        self.run(0)
        self.running = False


#
# This seems redundant.  If it's really emulating and PCA9685, then
# why don't we just use that code?
# - this is not used in any templates
# - this is not documented in docs or elsewhere
# - this seems redundant; if it emultates a PCA9685 then we should be able to use that code.
# - there is an intention to implement a Firmata driver in pins.py.
#   Teensy can run Firmata, so that is a way to get Teensy support.
#   See https://www.pjrc.com/teensy/td_libs_Firmata.html
#
@deprecated("JHat is unsupported/undocumented in the framework.  It will be removed in a future release.")
class JHat:
    ''' 
    PWM motor controller using Teensy emulating PCA9685.
    '''
    def __init__(self, channel, address=0x40, frequency=60, busnum=None):
        logger.info("Firing up the Hat")
        # Adafruit_PCA9685 is deprecated and is no longer installed by any
        # extra, because its Adafruit-GPIO -> spidev dependency has to be
        # compiled.  This class drives a Teensy emulating a PCA9685 through
        # Adafruit_GPIO internals that the CircuitPython driver does not
        # expose, so it has not been ported.  Install it by hand if needed:
        #     pip install Adafruit_PCA9685
        try:
            import Adafruit_PCA9685
        except ImportError as e:
            raise ImportError(
                f"{type(self).__name__} needs the deprecated Adafruit_PCA9685 "
                "library, which donkeycar no longer installs. Install it with "
                "'pip install Adafruit_PCA9685' (it needs build-essential and "
                "python3-dev), or use PinProvider.PCA9685 instead."
            ) from e
        LED0_OFF_L = 0x08
        # Initialise the PCA9685 using the default address (0x40).
        if busnum is not None:
            from Adafruit_GPIO import I2C
            # replace the get_bus function with our own
            def get_bus():
                return busnum
            I2C.get_default_bus = get_bus
        self.pwm = Adafruit_PCA9685.PCA9685(address=address)
        self.pwm.set_pwm_freq(frequency)
        self.channel = channel
        self.register = LED0_OFF_L+4*channel

        # we install our own write that is more efficient use of interrupts
        self.pwm.set_pwm = self.set_pwm
        
    def set_pulse(self, pulse):
        self.set_pwm(self.channel, 0, pulse) 

    def set_pwm(self, channel, on, off):
        # sets a single PWM channel
        self.pwm._device.writeList(self.register, [off & 0xFF, off >> 8])
        
    def run(self, pulse):
        self.set_pulse(pulse)


#
# JHatReader is on the chopping block for removal
# - it is not integrated into any templates
# - it is not documented in docs or elsewhere
# This appears to be a way to read RC receiving input.  As such
# it would more appropriately be integrated into controllers.py.
# If that can be addressed then we would keep this,
# otherwise this should be removed.
#
@deprecated("JHatReader is unsupported/undocumented in the framework.  It may be removed in a future release.")
class JHatReader:
    ''' 
    Read RC controls from teensy 
    '''
    def __init__(self, channel, address=0x40, frequency=60, busnum=None):
        # Adafruit_PCA9685 is deprecated and is no longer installed by any
        # extra, because its Adafruit-GPIO -> spidev dependency has to be
        # compiled.  This class drives a Teensy emulating a PCA9685 through
        # Adafruit_GPIO internals that the CircuitPython driver does not
        # expose, so it has not been ported.  Install it by hand if needed:
        #     pip install Adafruit_PCA9685
        try:
            import Adafruit_PCA9685
        except ImportError as e:
            raise ImportError(
                f"{type(self).__name__} needs the deprecated Adafruit_PCA9685 "
                "library, which donkeycar no longer installs. Install it with "
                "'pip install Adafruit_PCA9685' (it needs build-essential and "
                "python3-dev), or use PinProvider.PCA9685 instead."
            ) from e
        self.pwm = Adafruit_PCA9685.PCA9685(address=address)
        self.pwm.set_pwm_freq(frequency)
        self.register = 0 #i2c read doesn't take an address
        self.steering = 0
        self.throttle = 0
        self.running = True
        #send a reset
        self.pwm._device.writeRaw8(0x06)

    def read_pwm(self):
        '''
        send read requests via i2c bus to Teensy to get
        pwm control values from last RC input  
        '''
        h1 = self.pwm._device.readU8(self.register)
        # first byte of header must be 100, otherwize we might be reading
        # in the wrong byte offset
        while h1 != 100:
            logger.debug("skipping to start of header")
            h1 = self.pwm._device.readU8(self.register)
        
        h2 = self.pwm._device.readU8(self.register)
        # h2 ignored now

        val_a = self.pwm._device.readU8(self.register)
        val_b = self.pwm._device.readU8(self.register)
        self.steering = (val_b << 8) + val_a
        
        val_c = self.pwm._device.readU8(self.register)
        val_d = self.pwm._device.readU8(self.register)
        self.throttle = (val_d << 8) + val_c

        # scale the values from -1 to 1
        self.steering = (self.steering - 1500.0) / 500.0  + 0.158
        self.throttle = (self.throttle - 1500.0) / 500.0  + 0.136

    def update(self):
        while(self.running):
            self.read_pwm()
        
    def run_threaded(self):
        return self.steering, self.throttle

    def shutdown(self):
        self.running = False
        time.sleep(0.1)


#
# Adafruit_DCMotor_Hat support is on the block for removal
# - it is not integrated into any templates
# - It is not documented in the docs or otherwise
# A path forward would be to add a drive train option
# DRIVE_TRAIN_TYPE = "DC_TWO_WHEEL_ADAFRUIT"
# and integrate this into complete.py
#
@deprecated("This appears to be unsupported/undocumented in the framework. This may be removed in a future release")
class Adafruit_DCMotor_Hat:
    ''' 
    Adafruit DC Motor Controller 
    Used for each motor on a differential drive car.
    '''
    def __init__(self, motor_num):
        from Adafruit_MotorHAT import Adafruit_MotorHAT, Adafruit_DCMotor
        import atexit
        
        self.FORWARD = Adafruit_MotorHAT.FORWARD
        self.BACKWARD = Adafruit_MotorHAT.BACKWARD
        self.mh = Adafruit_MotorHAT(addr=0x60) 
        
        self.motor = self.mh.getMotor(motor_num)
        self.motor_num = motor_num
        
        atexit.register(self.turn_off_motors)
        self.speed = 0
        self.throttle = 0
    
        
    def run(self, speed):
        '''
        Update the speed of the motor where 1 is full forward and
        -1 is full backwards.
        '''
        if speed > 1 or speed < -1:
            raise ValueError( "Speed must be between 1(forward) and -1(reverse)")
        
        self.speed = speed
        self.throttle = int(dk.utils.map_range(abs(speed), -1, 1, -255, 255))
        
        if speed > 0:            
            self.motor.run(self.FORWARD)
        else:
            self.motor.run(self.BACKWARD)
            
        self.motor.setSpeed(self.throttle)
        

    def shutdown(self):
        self.mh.getMotor(self.motor_num).run(Adafruit_MotorHAT.RELEASE)


#
# Maestro Servo Controller support is on the block for removal
# - it is not integrated into any templates
# - It is not documented in the docs or otherwise
# - It seems to require a separate AStar microcontroller for which there is no firmware included or referenced
# If that can be addressed, then we can add Maestro support to the pin provide api in pins.py
# so it can be used a source of TTL and PWM for the generalized motor drivers.
# Perhaps the AStar controller is not integral to using this as a source of servo pulses in which
# case it seems pretty straight forward to integrate this into pins.py and then delete this class.
#
@deprecated("This appears to be unsupported/undocumented in the framework. This may be removed in a future release")
class Maestro:
    '''
    Pololu Maestro Servo controller
    Use the MaestroControlCenter to set the speed & acceleration values to 0!
    See https://www.pololu.com/docs/0J40/all
    '''
    import threading

    maestro_device = None
    astar_device = None
    maestro_lock = threading.Lock()
    astar_lock = threading.Lock()

    def __init__(self, channel, frequency = 60):
        import serial

        if Maestro.maestro_device == None:
            Maestro.maestro_device = serial.Serial('/dev/ttyACM0', 115200)

        self.channel = channel
        self.frequency = frequency
        self.lturn = False
        self.rturn = False
        self.headlights = False
        self.brakelights = False

        if Maestro.astar_device == None:
            Maestro.astar_device = serial.Serial('/dev/ttyACM2', 115200, timeout= 0.01)

    def set_pulse(self, pulse):
        # Recalculate pulse width from the Adafruit values
        w = pulse * (1 / (self.frequency * 4096)) # in seconds
        w *= 1000 * 1000  # in microseconds
        w *= 4  # in quarter microsenconds the maestro wants
        w = int(w)

        with Maestro.maestro_lock:
            Maestro.maestro_device.write(bytearray([ 0x84,
                                                     self.channel,
                                                     (w & 0x7F),
                                                     ((w >> 7) & 0x7F)]))

    def set_turn_left(self, v):
        if self.lturn != v:
            self.lturn = v
            b = bytearray('L' if v else 'l', 'ascii')
            with Maestro.astar_lock:
                Maestro.astar_device.write(b)

    def set_turn_right(self, v):
        if self.rturn != v:
            self.rturn = v
            b = bytearray('R' if v else 'r', 'ascii')
            with Maestro.astar_lock:
                Maestro.astar_device.write(b)

    def set_headlight(self, v):
        if self.headlights != v:
            self.headlights = v
            b = bytearray('H' if v else 'h', 'ascii')
            with Maestro.astar_lock:
                Maestro.astar_device.write(b)

    def set_brake(self, v):
        if self.brakelights != v:
            self.brakelights = v
            b = bytearray('B' if v else 'b', 'ascii')
            with Maestro.astar_lock:
                Maestro.astar_device.write(b)

    def readline(self):
        ret = None
        with Maestro.astar_lock:
            # expecting lines like
            # E n nnn n
            if Maestro.astar_device.inWaiting() > 8:
                ret = Maestro.astar_device.readline()

        if ret is not None:
            ret = ret.rstrip()

        return ret


#
# Teensy support is on the chopping block.
# - It is not integrated into any template
# - It is not documented in the docs or otherwise
# - It presumably requires a firmware to be uploaded to the teensy, but no firmware is referenced.
# If that can be addressed, then we can add Teensy support to the pin provide api in pins.py
# so it can be used a source of TTL and PWM for the generalized motor drivers.
# Another route is to implement Firmata protocol (perhaps a version of the Arduino sketch,
# see ArduinoFirmata below)
#
@deprecated("This appears to be unsupported/undocumented in the framework. This may be removed in a future release")
class Teensy:
    '''
    Teensy Servo controller
    '''
    import threading

    teensy_device = None
    astar_device = None
    teensy_lock = threading.Lock()
    astar_lock = threading.Lock()

    def __init__(self, channel, frequency = 60):
        import serial

        if Teensy.teensy_device == None:
            Teensy.teensy_device = serial.Serial('/dev/teensy', 115200, timeout = 0.01)

        self.channel = channel
        self.frequency = frequency
        self.lturn = False
        self.rturn = False
        self.headlights = False
        self.brakelights = False

        if Teensy.astar_device == None:
            Teensy.astar_device = serial.Serial('/dev/astar', 115200, timeout = 0.01)

    def set_pulse(self, pulse):
        # Recalculate pulse width from the Adafruit values
        w = pulse * (1 / (self.frequency * 4096)) # in seconds
        w *= 1000 * 1000  # in microseconds

        with Teensy.teensy_lock:
            Teensy.teensy_device.write(("%c %.1f\n" % (self.channel, w)).encode('ascii'))

    def set_turn_left(self, v):
        if self.lturn != v:
            self.lturn = v
            b = bytearray('L' if v else 'l', 'ascii')
            with Teensy.astar_lock:
                Teensy.astar_device.write(b)

    def set_turn_right(self, v):
        if self.rturn != v:
            self.rturn = v
            b = bytearray('R' if v else 'r', 'ascii')
            with Teensy.astar_lock:
                Teensy.astar_device.write(b)

    def set_headlight(self, v):
        if self.headlights != v:
            self.headlights = v
            b = bytearray('H' if v else 'h', 'ascii')
            with Teensy.astar_lock:
                Teensy.astar_device.write(b)

    def set_brake(self, v):
        if self.brakelights != v:
            self.brakelights = v
            b = bytearray('B' if v else 'b', 'ascii')
            with Teensy.astar_lock:
                Teensy.astar_device.write(b)

    def teensy_readline(self):
        ret = None
        with Teensy.teensy_lock:
            # expecting lines like
            # E n nnn n
            if Teensy.teensy_device.inWaiting() > 8:
                ret = Teensy.teensy_device.readline()

        if ret != None:
            ret = ret.rstrip()

        return ret

    def astar_readline(self):
        ret = None
        with Teensy.astar_lock:
            # expecting lines like
            # E n nnn n
            if Teensy.astar_device.inWaiting() > 8:
                ret = Teensy.astar_device.readline()

        if ret != None:
            ret = ret.rstrip()

        return ret


class MockController(object):
    def __init__(self):
        pass

    def run(self, pulse):
        pass

    def shutdown(self):
        pass


class L298N_HBridge_3pin(object):
    """
    Motor controlled with an L298N hbridge,
    chosen with configuration DRIVETRAIN_TYPE=DC_TWO_WHEEL_L298N
    Uses two OutputPins to select direction and
    a PwmPin to control the power to the motor.
    See pins.py for pin provider implementations.

    See https://www.electronicshub.org/raspberry-pi-l298n-interface-tutorial-control-dc-motor-l298n-raspberry-pi/
    for a discussion of how the L298N hbridge module is wired in 3-pin mode.
    This also applies to the some other driver chips that emulate
    the L298N, such as the TB6612FNG motor driver.
    """

    def __init__(self, pin_forward:OutputPin, pin_backward:OutputPin, pwm_pin:PwmPin, zero_throttle:float=0, max_duty=0.9):
        """
        :param pin_forward:OutputPin when HIGH the motor will turn clockwise
                        using the output of the pwm_pin as a duty_cycle
        :param pin_backward:OutputPin when HIGH the motor will turn counter-clockwise
                            using the output of the pwm_pin as a duty_cycle
        :param pwm_pin:PwmPin takes a duty cycle in the range of 0 to 1,
                    where 0 is fully off and 1 is fully on.
        :param zero_throttle: values at or below zero_throttle are treated as zero.
        :param max_duty: the maximum duty cycle that will be send to the motors

        NOTE: if pin_forward and pin_backward are both LOW, then the motor is
            'detached' and will glide to a stop.
            if pin_forward and pin_backward are both HIGH, then the motor
            will be forcibly stopped (can be used for braking)
        """
        self.pin_forward = pin_forward
        self.pin_backward = pin_backward
        self.pwm_pin = pwm_pin
        self.zero_throttle = zero_throttle
        self.throttle = 0
        self.max_duty = max_duty
        self.pin_forward.start(PinState.LOW)
        self.pin_backward.start(PinState.LOW)
        self.pwm_pin.start(0)

    def run(self, throttle:float) -> None:
        """
        Update the speed of the motor
        :param throttle:float throttle value in range -1 to 1,
                        where 1 is full forward and -1 is full backwards.
        """
        if throttle is None:
            logger.warning("TwoWheelSteeringThrottle throttle is None")
            return
        if throttle > 1 or throttle < -1:
            logger.warning( f"TwoWheelSteeringThrottle throttle is {throttle}, but it must be between 1(forward) and -1(reverse)")
            throttle = clamp(throttle, -1, 1)
        
        self.speed = throttle
        self.throttle = dk.utils.map_range_float(throttle, -1, 1, -self.max_duty, self.max_duty)
        if self.throttle > self.zero_throttle:
            self.pwm_pin.duty_cycle(self.throttle)
            self.pin_backward.output(PinState.LOW)
            self.pin_forward.output(PinState.HIGH)
        elif self.throttle < -self.zero_throttle:
            self.pwm_pin.duty_cycle(-self.throttle)
            self.pin_forward.output(PinState.LOW)
            self.pin_backward.output(PinState.HIGH)
        else:
            self.pwm_pin.duty_cycle(0)
            self.pin_forward.output(PinState.LOW)
            self.pin_backward.output(PinState.LOW)

    def shutdown(self):
        self.pwm_pin.stop()
        self.pin_forward.stop()
        self.pin_backward.stop()


class TwoWheelSteeringThrottle(object):
    """
    Modify individual differential drive wheel throttles
    in order to implemeht steering.
    """

    def run(self, throttle:float, steering:float) -> Tuple[float, float]:
        """
        :param throttle:float throttle value in range -1 to 1,
                        where 1 is full forward and -1 is full backwards.
        :param steering:float steering value in range -1 to 1,
                        where -1 is full left and 1 is full right.
        :return: tuple of left motor and right motor throttle values in range -1 to 1
                 where 1 is full forward and -1 is full backwards.
        """
        if throttle is None:
            logger.warning("TwoWheelSteeringThrottle throttle is None")
            return
        if steering is None:
            logger.warning("TwoWheelSteeringThrottle steering is None")
            return
        if throttle > 1 or throttle < -1:
            logger.warning( f"TwoWheelSteeringThrottle throttle is {throttle}, but it must be between 1(forward) and -1(reverse)")
            throttle = clamp(throttle, -1, 1)
        if steering > 1 or steering < -1:
            logger.warning( f"TwoWheelSteeringThrottle steering is {steering}, but it must be between 1(right) and -1(left)")
            steering = clamp(steering, -1, 1)

        left_motor_speed = throttle
        right_motor_speed = throttle

        if steering < 0:
            left_motor_speed *= (1.0 - (-steering))
        elif steering > 0:
            right_motor_speed *= (1.0 - steering)

        return left_motor_speed, right_motor_speed

    def shutdown(self) -> None:
        pass


class L298N_HBridge_2pin(object):
    """
    Motor controlled with an 'mini' L298N hbridge using 2 PwmPins,
    one for forward pwm and for reverse pwm.
    Chosen with configuration DRIVETRAIN_TYPE=DC_TWO_WHEEL
    See pins.py for pin provider implementations.

    See https://www.instructables.com/Tutorial-for-Dual-Channel-DC-Motor-Driver-Board-PW/
    for how an L298N mini-hbridge modules is wired.
    This driver can also be used for an L9110S/HG7881 motor driver.  See
    https://electropeak.com/learn/interfacing-l9110s-dual-channel-h-bridge-motor-driver-module-with-arduino/
    for how an L9110S motor driver module is wired.
    """

    def __init__(self, pin_forward:PwmPin, pin_backward:PwmPin, zero_throttle:float=0, max_duty = 0.9):
        """
        pin_forward:PwmPin Takes a duty cycle in the range of 0 to 1,
                        where 0 is fully off and 1 is fully on.
                        When the duty_cycle > 0 the motor will turn clockwise
                        proportial to the duty_cycle
        pin_backward:PwmPin Takes a duty cycle in the range of 0 to 1,
                            where 0 is fully off and 1 is fully on.
                            When the duty_cycle > 0 the motor will turn counter-clockwise
                            proportial to the duty_cycle
        zero_throttle: values at or below zero_throttle are treated as zero.
        max_duty: the maximum duty cycle that will be send to the motors

        NOTE: if pin_forward and pin_backward are both at duty_cycle == 0,
            then the motor is 'detached' and will glide to a stop.
            if pin_forward and pin_backward are both at duty_cycle == 1,
            then the motor will be forcibly stopped (can be used for braking)
        max_duty is from 0 to 1 (fully off to fully on). I've read 0.9 is a good max.
        """
        self.pin_forward = pin_forward
        self.pin_backward = pin_backward
        self.zero_throttle = zero_throttle
        self.max_duty = max_duty

        self.throttle=0
        self.speed=0
        
        self.pin_forward.start(0)
        self.pin_backward.start(0)

    def run(self, throttle:float) -> None:
        """
        Update the speed of the motor
        :param throttle:float throttle value in range -1 to 1,
                        where 1 is full forward and -1 is full backwards.
        """
        if throttle is None:
            logger.warning("TwoWheelSteeringThrottle throttle is None")
            return
        if throttle > 1 or throttle < -1:
            logger.warning( f"TwoWheelSteeringThrottle throttle is {throttle}, but it must be between 1(forward) and -1(reverse)")
            throttle = clamp(throttle, -1, 1)

        self.speed = throttle
        self.throttle = dk.utils.map_range_float(throttle, -1, 1, -self.max_duty, self.max_duty)
        
        if self.throttle > self.zero_throttle:
            self.pin_backward.duty_cycle(0)
            self.pin_forward.duty_cycle(self.throttle)
        elif self.throttle < -self.zero_throttle:
            self.pin_forward.duty_cycle(0)
            self.pin_backward.duty_cycle(-self.throttle)
        else:
            self.pin_forward.duty_cycle(0)
            self.pin_backward.duty_cycle(0)

    def shutdown(self):
        self.pin_forward.stop()
        self.pin_backward.stop()

    
#
# This is being replaced by pins.py and PulseController.
# GPIO pins can be configured using RPi.GPIO or PIGPIO,
# so this is redundant
#
@deprecated("This will be removed in a future release in favor of PulseController")
class RPi_GPIO_Servo(object):
    '''
    Servo controlled from the gpio pins on Rpi
    '''
    def __init__(self, pin, pin_scheme=None, freq=50, min=5.0, max=7.8):
        self.pin = pin
        if pin_scheme is None:
            pin_scheme = GPIO.BCM
        GPIO.setmode(pin_scheme)
        GPIO.setup(self.pin, GPIO.OUT)

        self.throttle = 0
        self.pwm = GPIO.PWM(self.pin, freq)
        self.pwm.start(0)
        self.min = min
        self.max = max

    def run(self, pulse):
        '''
        Update the speed of the motor where 1 is full forward and
        -1 is full backwards.
        '''
        # I've read 90 is a good max
        self.throttle = dk.map_frange(pulse, -1.0, 1.0, self.min, self.max)
        # logger.debug(pulse, self.throttle)
        self.pwm.ChangeDutyCycle(self.throttle)

    def shutdown(self):
        self.pwm.stop()
        GPIO.cleanup()


#
# This is being replaced by pins.py.  GPIO pins can be
# configured using RPi.GPIO or PIGPIO, so ServoBlaster is redundant
#
@deprecated("This will be removed in a future release in favor of PulseController")
class ServoBlaster(object):
    '''
    Servo controlled from the gpio pins on Rpi
    This uses a user space service to generate more efficient PWM via DMA control blocks.
    Check readme and install here:
    https://github.com/richardghirst/PiBits/tree/master/ServoBlaster
    cd PiBits/ServoBlaster/user
    make
    sudo ./servod
    will start the daemon and create the needed device file:
    /dev/servoblaster

    to test this from the command line:
    echo P1-16=120 > /dev/servoblaster

    will send 1200us PWM pulse to physical pin 16 on the pi.

    If you want it to start on boot:
    sudo make install
    '''
    def __init__(self, pin):
        self.pin = pin
        self.servoblaster = open('/dev/servoblaster', 'w')
        self.min = min
        self.max = max

    def set_pulse(self, pulse):
        s = 'P1-%d=%d\n' % (self.pin, pulse)
        self.servoblaster.write(s)
        self.servoblaster.flush()

    def run(self, pulse):
        self.set_pulse(pulse)

    def shutdown(self):
        self.run((self.max + self.min) / 2)
        self.servoblaster.close()

#
# TODO: integrate ArduinoFirmata support into pin providers, then we can remove all of this code and use PulseController
#
# Arduino/Microcontroller PWM support.
# Firmata is a specification for configuring general purpose microcontrollers remotey.
# The implementatino for Arduino is used here.
#
# See https://docs.donkeycar.com/parts/actuators/#arduino for how to set this up.
# Firmata Protocol https://github.com/firmata/protocol
# Arduino implementation https://github.com/firmata/arduino
#
# NOTE: to create a general purpose InputPin/OutputPin/PwmPin with support for servo pulses between 1ms and 2ms
#       with good resolution, it is likely we will need to create our own sketch based on the Arduino Firmata
#       examples.  By default, analog write is not adequate to support servos; it is good for motor duty cycles
#       but is poor for servos because of the low resolution and poor control of frequency.  So we need to
#       use the Servo.h library and dynamically add a Servo instance to a pin when it is configured for
#       analog output.  Further, we should use writeMicroseconds for output and so interpret values
#       to the pin as microseconds for the on part of the pulse.  See the various flavors of examples
#       in the Arduino Firmata repo linked above.
#
@deprecated("This will be removed in a future release and Arduino support will be added to pins.py")
class ArduinoFirmata:
    '''
    PWM controller using Arduino board.
    This is particularly useful for boards like Latte Panda with built it Arduino.
    Standard Firmata sketch needs to be loaded on Arduino side.
    Refer to docs/parts/actuators.md for more details
    '''

    def __init__(self, servo_pin = 6, esc_pin = 5):
        from pymata_aio.pymata3 import PyMata3
        self.board = PyMata3()
        self.board.sleep(0.015)
        self.servo_pin = servo_pin
        self.esc_pin = esc_pin
        self.board.servo_config(servo_pin)
        self.board.servo_config(esc_pin)

    def set_pulse(self, pin, angle):
        try:
            self.board.analog_write(pin, int(angle))
        except:
            self.board.analog_write(pin, int(angle))

    def set_servo_pulse(self, angle):
        self.set_pulse(self.servo_pin, int(angle))

    def set_esc_pulse(self, angle):
        self.set_pulse(self.esc_pin, int(angle))


@deprecated("This will be removed in a future release and Arduino PWM support will be add to pins.py")
class ArdPWMSteering:
    """
    Wrapper over a Arduino Firmata controller to convert angles to PWM pulses.
    """
    LEFT_ANGLE = -1
    RIGHT_ANGLE = 1

    def __init__(self,
                 controller=None,
                 left_pulse=60,
                 right_pulse=120):

        self.controller = controller
        self.left_pulse = left_pulse
        self.right_pulse = right_pulse
        self.pulse = dk.utils.map_range(0, self.LEFT_ANGLE, self.RIGHT_ANGLE,
                                        self.left_pulse, self.right_pulse)
        self.running = True
        logger.info('Arduino PWM Steering created')

    def run(self, angle):
        # map absolute angle to angle that vehicle can implement.
        self.pulse = dk.utils.map_range(angle,
                                        self.LEFT_ANGLE, self.RIGHT_ANGLE,
                                        self.left_pulse, self.right_pulse)
        self.controller.set_servo_pulse(self.pulse)

    def shutdown(self):
        # set steering straight
        self.pulse = dk.utils.map_range(0, self.LEFT_ANGLE, self.RIGHT_ANGLE,
                                        self.left_pulse, self.right_pulse)
        time.sleep(0.3)
        self.running = False


@deprecated("This will be removed in a future release and Arduino PWM support will be add to pins.py")
class ArdPWMThrottle:

    """
    Wrapper over Arduino Firmata controller to convert -1 to 1 throttle
    values to PWM pulses.
    """
    MIN_THROTTLE = -1
    MAX_THROTTLE = 1

    def __init__(self,
                 controller=None,
                 max_pulse=105,
                 min_pulse=75,
                 zero_pulse=90):

        self.controller = controller
        self.max_pulse = max_pulse
        self.min_pulse = min_pulse
        self.zero_pulse = zero_pulse
        self.pulse = zero_pulse

        # send zero pulse to calibrate ESC
        logger.info("Init ESC")
        self.controller.set_esc_pulse(self.max_pulse)
        time.sleep(0.01)
        self.controller.set_esc_pulse(self.min_pulse)
        time.sleep(0.01)
        self.controller.set_esc_pulse(self.zero_pulse)
        time.sleep(1)
        self.running = True
        logger.info('Arduino PWM Throttle created')

    def run(self, throttle):
        if throttle > 0:
            self.pulse = dk.utils.map_range(throttle, 0, self.MAX_THROTTLE,
                                            self.zero_pulse, self.max_pulse)
        else:
            self.pulse = dk.utils.map_range(throttle, self.MIN_THROTTLE, 0,
                                            self.min_pulse, self.zero_pulse)
        self.controller.set_esc_pulse(self.pulse)

    def shutdown(self):
        # stop vehicle
        self.run(0)
        self.running = False
