autorope/donkeycar/donkeycar/parts/serial_controller.py

#!/usr/bin/env python3
"""
Scrits to read signals from Arduino and convert into steering and throttle outputs
Arduino input signal range: 0 to 200
Output range: -1.00 to 1.00
"""

import serial
import time

class SerialController:
    def __init__(self):
        print("Starting Serial Controller")

        self.angle = 0.0
        self.throttle = 0.0
        self.mode = 'user'
        self.recording = False
        self.serial = serial.Serial('/dev/ttyS0', 115200, timeout=1) #Serial port - laptop: 'COM3', Arduino: '/dev/ttyACM0'


    def update(self):
        # delay on startup to avoid crashing
        print("Warming Serial Controller")
        time.sleep(3)

        while True:
            line = str(self.serial.readline().decode()).strip('\n').strip('\r')
            output = line.split(", ")
            if len(output) == 2:
                if output[0].isnumeric() and output[1].isnumeric():
                    self.angle = (float(output[0])-1500)/500
                    self.throttle = (float(output[1])-1500)/500
                    if self.throttle > 0.01:
                        self.recording = True
                        print("Recording")
                    else:
                        self.recording = False
                    time.sleep(0.01)

    def run(self, img_arr=None):
        return self.run_threaded()

    def run_threaded(self, img_arr=None):
        #print("Signal:", self.angle, self.throttle)
        return self.angle, self.throttle, self.mode, self.recording
