autorope/donkeycar/donkeycar/parts/oak_d.py

"""
Author: Brian Henry & Manav Gagvani
File: oak_d.py
Date: February 13 2022, revised July 10, 2025
Notes:
    Based on realsense435i.py by Ed Murphy: https://github.com/autorope/donkeycar/blob/454be3068ea5dfbac226c3be4d84b0a61d1cec84/donkeycar/parts/realsense435i.py
    Based on https://github.com/luxonis/depthai-tutorials/blob/d571473911f876b0d4ac52b7ffdc0fb2beae1641/1-hello-world/hello_world.py

    https://docs.luxonis.com/en/latest/pages/tutorials/first_steps/#first-steps-with-depthai
    > If you are using a Linux system, in most cases you have to add a new udev rule for our script to be able to access the device correctly. You can add and apply new rules by running
    $ echo 'SUBSYSTEM=="usb", ATTRS{idVendor}=="03e7", MODE="0666"' | sudo tee /etc/udev/rules.d/80-movidius.rules
    $ sudo udevadm control --reload-rules && sudo udevadm trigger
    (or: "RuntimeError: No DepthAI (Oak-D-Lite) device (camera) found!")

    `sudo pip3 install --extra-index-url https://developer.download.nvidia.com/compute/redist/jp/v461 tensorflow`
"""

import argparse
import string
import time
import sys

import numpy as np  # numpy - manipulate the packet data returned by depthai
import cv2 as cv2  # opencv - display the video stream
import depthai  # depthai - access the camera and its data packets
from depthai import Pipeline, DataOutputQueue, ImgFrame, ImgDetections, ImgDetection
from numpy import ndarray
from typing import List

WIDTH = 640
HEIGHT = 480


class OakD(object):
    """
    Donkeycar part for the Oak-D camera
    Intel Movidius based depth sensing camera
    https://docs.luxonis.com/projects/hardware/en/latest/pages/DM9095.html
    https://www.kickstarter.com/projects/opencv/opencv-ai-kit-oak-depth-camera-4k-cv-edge-object-detection
    https://shop.luxonis.com/
    """

    def __init__(
        self,
        width=WIDTH,
        height=HEIGHT,
        enable_rgb=True,
        enable_depth=True,
        device_id=None,
        rgb_output_mode="isp",
        rgb_isp_scale_num=1,
        rgb_isp_scale_den=6,
        rgb_sensor_crop_x=None,
        rgb_sensor_crop_y=None,
    ):
        self.device_id = device_id  # "18443010C1E4681200" # serial number of device to use|None to use default|"list" to list devices and exit
        self.enable_rgb = enable_rgb
        self.enable_depth = enable_depth
        self.rgb_output_mode = rgb_output_mode
        self.rgb_isp_scale_num = rgb_isp_scale_num
        self.rgb_isp_scale_den = rgb_isp_scale_den
        self.rgb_sensor_crop_x = rgb_sensor_crop_x
        self.rgb_sensor_crop_y = rgb_sensor_crop_y

        self.width = width
        self.height = height

        # TODO: Accommodate using device native resolutions to avoid resizing.
        self.resize = (width != WIDTH) or (height != HEIGHT)
        if self.resize:
            print(
                f"The output images will be resized from {(WIDTH, HEIGHT)} to {(self.width, self.height)} using OpenCV. Device resolution in use is 640x480."
            )

        self.pipeline = None
        if self.enable_depth or self.enable_rgb:
            self.pipeline = depthai.Pipeline()

            device_info = self.get_depthai_device_info(device_id)

            if self.enable_depth:
                self.setup_depth_camera(WIDTH, HEIGHT)

            if self.enable_rgb:
                self.setup_rgb_camera(WIDTH, HEIGHT)

            self.oak_d_device = depthai.Device(self.pipeline, device_info)

        # initialize frame state
        self.color_image = None
        self.depth_image = None
        self.frame_count = 0
        self.start_time = time.time()
        self.frame_time = self.start_time

        self.running = True

    # Taken from the demo application.
    def get_depthai_device_info(self, device_id: string):
        device_infos = depthai.Device.getAllAvailableDevices()
        if len(device_infos) == 0:
            raise RuntimeError("No DepthAI (Oak-D-Lite) device (camera) found!")
        else:
            print("Available devices:")
            for i, deviceInfo in enumerate(device_infos):
                print(f"[{i}] {deviceInfo.getMxId()} [{deviceInfo.state.name}]")

            # Set the deviceId to "list" in order to list the connected devices' ids.
            if device_id == "list":
                raise SystemExit(0)
            elif device_id is not None:
                matching_device = next(
                    filter(lambda info: info.getMxId() == device_id, device_infos), None
                )
                if matching_device is None:
                    raise RuntimeError(
                        f"No DepthAI device found with id matching {device_id} !"
                    )
                return matching_device
            elif len(device_infos) == 1:
                return device_infos[0]
            else:
                val = input("Which DepthAI Device you want to use: ")
                try:
                    return device_infos[int(val)]
                except:
                    raise ValueError(f"Incorrect value supplied: {val}")

    def setup_depth_camera(self, width, height):
        # Set up left and right cameras
        mono_left = self.get_mono_camera(self.pipeline, True)
        mono_right = self.get_mono_camera(self.pipeline, False)

        # Combine left and right cameras to form a stereo pair
        stereo: depthai.node.StereoDepth = self.get_stereo_pair(
            self.pipeline, mono_left, mono_right
        )

        # Define and name output depth map
        xout_depth = self.pipeline.createXLinkOut()
        xout_depth.setStreamName("depth")

        stereo.depth.link(xout_depth.input)

    def setup_rgb_camera(self, width, height):
        cam_rgb = self.pipeline.create(depthai.node.ColorCamera)

        # 'video' is always center-cropped to 16:9 (max 4K) before scaling,
        # regardless of setResolution(), which clips the sensor's full FOV.
        # 'isp' preserves the full sensor FOV, so downscale from there
        # instead; setIspScale() can't land on an exact pixel size, so
        # _poll() resizes the result down to the exact requested dimensions.
        res = depthai.ColorCameraProperties.SensorResolution.THE_13_MP
        cam_rgb.setResolution(res)

        xout_rgb = self.pipeline.create(depthai.node.XLinkOut)
        xout_rgb.setStreamName("rgb")

        if self.rgb_output_mode == "video":
            if self.rgb_sensor_crop_x is not None or self.rgb_sensor_crop_y is not None:
                cam_rgb.setSensorCrop(
                    0.0 if self.rgb_sensor_crop_x is None else self.rgb_sensor_crop_x,
                    0.0 if self.rgb_sensor_crop_y is None else self.rgb_sensor_crop_y,
                )
            cam_rgb.setVideoSize(self.width, self.height)
            cam_rgb.video.link(xout_rgb.input)
        else:
            cam_rgb.setIspScale(self.rgb_isp_scale_num, self.rgb_isp_scale_den)
            cam_rgb.isp.link(xout_rgb.input)

    def get_mono_camera(self, pipeline: Pipeline, is_left: bool):
        # Configure mono camera
        mono = pipeline.createMonoCamera()

        # Set camera resolution
        mono.setResolution(depthai.MonoCameraProperties.SensorResolution.THE_480_P)

        if is_left:
            # Get left camera
            mono.setBoardSocket(depthai.CameraBoardSocket.LEFT)
        else:
            # Get right camera
            mono.setBoardSocket(depthai.CameraBoardSocket.RIGHT)

        return mono

    def get_stereo_pair(self, pipeline: Pipeline, mono_left, mono_right):
        # Configure the stereo pair for depth estimation
        new_stereo = pipeline.createStereoDepth()
        # Checks occluded pixels and marks them as invalid
        new_stereo.setLeftRightCheck(True)

        # Configure left and right cameras to work as a stereo pair
        mono_left.out.link(new_stereo.left)
        mono_right.out.link(new_stereo.right)

        return new_stereo

    def get_frame(self, queue: DataOutputQueue):
        # Get frame from queue
        new_frame: ImgFrame = queue.get()
        # Convert to OpenCV format
        return new_frame.getCvFrame()

    def _poll(self):
        last_time = self.frame_time
        self.frame_time = time.time() - self.start_time
        self.frame_count += 1

        #
        # convert camera frames to images
        #
        # RGB and depth queues are initialized independently based on which
        # streams are enabled; querying a queue for a disabled stream raises
        # a RuntimeError since no XLinkOut was ever wired for it.
        if self.enable_rgb:
            self.rgb_queue: DataOutputQueue = self.oak_d_device.getOutputQueue(
                "rgb", maxSize=1, blocking=False
            )
            rgb_frame = self.get_frame(self.rgb_queue)
            if rgb_frame.shape[1] != self.width or rgb_frame.shape[0] != self.height:
                # setIspScale() lands on an approximate size; resize to the
                # exact requested dimensions without re-cropping the FOV.
                rgb_frame = cv2.resize(
                    rgb_frame, (self.width, self.height), interpolation=cv2.INTER_NEAREST
                )
            self.color_image = rgb_frame
        else:
            self.color_image = None   # Explicitly set None to prevent AttributeError later

        if self.enable_depth:
            self.depth_queue: DataOutputQueue = self.oak_d_device.getOutputQueue(
                name="depth", maxSize=1, blocking=False
            )
            depth_frame = self.get_frame(self.depth_queue)
            self.depth_image = depth_frame
        else:
            self.depth_image = None   # Explicitly set None to prevent AttributeError later


        if self.resize:
            if self.width != WIDTH or self.height != HEIGHT:
                self.color_image = (
                    cv2.resize(
                        self.color_image, (self.width, self.height), cv2.INTER_NEAREST
                    )
                    if self.enable_rgb
                    else None
                )
                self.depth_image = (
                    cv2.resize(
                        self.depth_image, (self.width, self.height), cv2.INTER_NEAREST
                    )
                    if self.enable_depth
                    else None
                )

    def update(self):
        """
        When running threaded, update() is called from the background thread
        to update the state.  run_threaded() is called to return the latest state.
        """
        while self.running:
            self._poll()

    def run_threaded(self):
        """
        Return the latest state read by update().  This will not block.
        All 4 states are returned, but may be None if the feature is not enabled when the camera part is constructed.
        For gyroscope, x is pitch, y is yaw and z is roll.
        :return: (rbg_image: nparray, depth_image: nparray, acceleration: (x:float, y:float, z:float), gyroscope: (x:float, y:float, z:float))
        """
        return self.color_image, self.depth_image

    def run(self):
        """
        Read and return frame from camera.  This will block while reading the frame.
        see run_threaded() for return types.
        """
        self._poll()
        return self.run_threaded()

    def shutdown(self):
        self.running = False
        time.sleep(2)  # give thread enough time to shutdown

        # done running
        self.oak_d_device.close()


#
# self test
#
if __name__ == "__main__":

    parser = argparse.ArgumentParser()

    parser.add_argument(
        "--rgb", default=False, action="store_true", help="Stream RGB camera"
    )
    parser.add_argument(
        "--depth", default=False, action="store_true", help="Stream depth camera"
    )
    parser.add_argument(
        "--device_id",
        help='Camera id (if more than one camera connected), or "list" to print the connected device ids',
    )
    args = parser.parse_args()

    if not (args.rgb or args.depth):
        print("Must specify one or more of --rgb, --depth")
        parser.print_help()
        sys.exit(0)

    show_opencv_window = (
        args.rgb or args.depth
    )  # True to show images in opencv window: note that default donkeycar environment is not configured for this.
    if show_opencv_window:
        import cv2

    enable_rgb = args.rgb
    enable_depth = args.depth

    devices = depthai.Device.getAllAvailableDevices()

    device_id = args.device_id  # getMxId

    width = 640
    height = 480
    channels = 3

    profile_frames = 0  # set to non-zero to calculate the max frame rate using given number of frames

    camera = None
    try:
        camera = OakD(
            width=width,
            height=height,
            enable_rgb=enable_rgb,
            enable_depth=enable_depth,
            device_id=device_id,
        )

        frame_count = 0
        start_time = time.time()
        frame_time = start_time
        while True:
            #
            # read data from camera
            #
            color_image, depth_image = camera.run()

            # maintain frame timing
            frame_count += 1
            last_time = frame_time
            frame_time = time.time()

            # Show images
            if show_opencv_window and not profile_frames:
                cv2.namedWindow("Oak-D", cv2.WINDOW_AUTOSIZE)
                if enable_rgb or enable_depth:
                    # make sure depth and color images have same number of channels so we can show them together in the window
                    if 3 == channels:
                        depth_colormap = (
                            cv2.applyColorMap(
                                cv2.convertScaleAbs(depth_image, alpha=0.03),
                                cv2.COLORMAP_JET,
                            )
                            if enable_depth
                            else None
                        )
                    else:
                        depth_colormap = (
                            cv2.cvtColor(
                                cv2.applyColorMap(
                                    cv2.convertScaleAbs(depth_image, alpha=0.03),
                                    cv2.COLORMAP_JET,
                                ),
                                cv2.COLOR_RGB2GRAY,
                            )
                            if enable_depth
                            else None
                        )

                    # Stack both images horizontally (i.e. side by side).
                    images = None
                    if enable_rgb:
                        images = (
                            np.hstack((color_image, depth_colormap))
                            if enable_depth
                            else color_image
                        )
                    elif enable_depth:
                        images = depth_colormap

                    if images is not None:
                        cv2.imshow("Oak-D", images)

                # Press esc or 'q' to close the image window
                key = cv2.waitKey(1)
                if key & 0xFF == ord("q") or key == 27:
                    cv2.destroyAllWindows()
                    break
            if profile_frames > 0:
                if frame_count == profile_frames:
                    print(
                        f"Acquired {frame_count} frames in {frame_time - start_time} seconds for {frame_count / (frame_time - start_time)} fps"
                    )

                    break
            else:
                time.sleep(0.05)
    finally:
        if camera is not None:
            camera.shutdown()
