autorope/donkeycar/donkeycar/parts/keras.py

"""

keras.py

Methods to create, use, save and load pilots. Pilots contain the highlevel
logic used to determine the angle and throttle of a vehicle. Pilots can
include one or more models to help direct the vehicles motion.

"""
import datetime
from datetime import datetime
from os import path
from abc import ABC, abstractmethod
from collections import deque

import numpy as np
from typing import Dict, Tuple, Optional, Union, List, Sequence, Callable, Any
import logging

import donkeycar as dk
from donkeycar.utils import normalize_image, linear_bin
from donkeycar.pipeline.types import TubRecord
from donkeycar.parts.interpreter import (
    Interpreter,
    KerasInterpreter,
    _is_metal_installed,
)

try:
    import tensorflow as tf
    from tensorflow import keras
    from tensorflow.keras.layers import (Dense, Input, Convolution2D,
        MaxPooling2D, Activation, Dropout, Flatten, LSTM, BatchNormalization,
        Conv3D, MaxPooling3D, Conv2DTranspose)
    from tensorflow.keras.layers import TimeDistributed as TD
    from tensorflow.keras.layers import concatenate
    from tensorflow.keras.models import Model
    from tensorflow.keras.callbacks import (EarlyStopping, ModelCheckpoint,
        TensorBoard)
    logging.getLogger('tensorflow').setLevel(logging.WARNING)
except ImportError:
    tf = None
    keras = None

ONE_BYTE_SCALE = 1.0 / 255.0


def _tshape(shape):
    """Shape helper for LiteRT-only Pi inference when TensorFlow is absent."""
    if isinstance(shape, (int, np.integer)):
        shape = (int(shape),)
    else:
        shape = tuple(shape)
    return tf.TensorShape(shape) if tf is not None else shape

# type of x
XY = Union[float, np.ndarray, Tuple[Union[float, np.ndarray], ...]]


logger = logging.getLogger(__name__)


class KerasPilot(ABC):
    """
    Base class for Keras models that will provide steering and throttle to
    guide a car.
    """
    def __init__(self,
                 interpreter: Interpreter = KerasInterpreter(),
                 input_shape: Tuple[int, ...] = (120, 160, 3)) -> None:
        # self.model: Optional[Model] = None
        self.input_shape = input_shape
        self.optimizer = "adam"
        self.interpreter = interpreter
        self.interpreter.set_model(self)
        logger.info(f'Created {self} with interpreter: {interpreter}')

    def load(self, model_path: str) -> None:
        logger.info(f'Loading model {model_path}')
        self.interpreter.load(model_path)

    def load_weights(self, model_path: str, by_name: bool = True) -> None:
        self.interpreter.load_weights(model_path, by_name=by_name)

    def shutdown(self) -> None:
        pass

    def compile(self) -> None:
        pass

    @abstractmethod
    def create_model(self):
        pass

    def set_optimizer(self, optimizer_type: str,
                      rate: float, decay: float) -> None:
        # decay is emulated via ExponentialDecay (Keras 3 removed the
        # per-step decay kwarg from optimizer constructors).
        lr = keras.optimizers.schedules.ExponentialDecay(
            rate, decay_steps=1, decay_rate=1 - decay) if decay else rate
        if optimizer_type == "adam":
            optimizer = keras.optimizers.Adam(learning_rate=lr)
        elif optimizer_type == "sgd":
            optimizer = keras.optimizers.SGD(learning_rate=lr)
        elif optimizer_type == "rmsprop":
            optimizer = keras.optimizers.RMSprop(learning_rate=lr)
        else:
            raise Exception(f"Unknown optimizer type: {optimizer_type}")
        self.interpreter.set_optimizer(optimizer)

    def get_input_shape(self, input_name):
        return self.interpreter.get_input_shape(input_name)

    def seq_size(self) -> int:
        return 0

    def use_lap_pct(self) -> bool:
        return False

    def run(self, img_arr: np.ndarray, *other_arr: List[float]) \
            -> Tuple[Union[float, np.ndarray], ...]:
        """
        Donkeycar parts interface to run the part in the loop.

        :param img_arr:     uint8 [0,255] numpy array with image data
        :param other_arr:   numpy array of additional data to be used in the
                            pilot, like IMU array for the IMU model or a
                            state vector in the Behavioural model
        :return:            tuple of (angle, throttle)
        """
        norm_img_arr = normalize_image(img_arr)
        np_other_array = tuple(np.array(arr) for arr in other_arr)
        # create dictionary on the fly, we expect the order of the arguments:
        # img_arr, *other_arr to exactly match the order of the
        # self.output_shape() first dictionary keys, because that's how we
        # set up the model
        values = (norm_img_arr, ) + np_other_array
        # note output_shapes() returns a 2-tuple of dicts for input shapes
        # and output shapes(), so we need the first tuple here
        input_dict = dict(zip(self.output_shapes()[0].keys(), values))
        return self.inference_from_dict(input_dict)

    def inference_from_dict(self, input_dict: Dict[str, np.ndarray]) \
            -> Tuple[Union[float, np.ndarray], ...]:
        """ Inferencing using the interpreter
            :param input_dict:  input dictionary of str and np.ndarray
            :return:            typically tuple of (angle, throttle)
        """
        output = self.interpreter.predict_from_dict(input_dict)
        return self.interpreter_to_output(output)

    @abstractmethod
    def interpreter_to_output(
            self,
            interpreter_out: Sequence[Union[float, np.ndarray]]) \
            -> Tuple[Union[float, np.ndarray], ...]:
        """ Virtual method to be implemented by child classes for conversion
            :param interpreter_out:  input data
            :return:                 output values, possibly tuple of np.ndarray
        """
        pass

    def train(self,
              model_path: str,
              train_data: Any,
              train_steps: int,
              batch_size: int,
              validation_data: Any,
              validation_steps: int,
              epochs: int,
              verbose: int = 1,
              min_delta: float = .0005,
              patience: int = 5,
              show_plot: bool = False):
        """
        trains the model
        """
        assert isinstance(self.interpreter, KerasInterpreter)
        dev = tf.config.list_physical_devices('GPU')
        if not dev:
            logger.warning("No GPU found for training")

        model = self.interpreter.model
        self.compile()
        if _is_metal_installed() and batch_size < 512:
            logger.info(
                'Metal eager training may need BATCH_SIZE >= 512 '
                'for a clear speedup over CPU. Current BATCH_SIZE=%s.',
                batch_size,
            )

        callbacks = [
            EarlyStopping(monitor='val_loss',
                          patience=patience,
                          min_delta=min_delta),
            ModelCheckpoint(monitor='val_loss',
                            filepath=model_path,
                            save_best_only=True,
                            verbose=verbose)]

        # Create a TensorBoard callback
        log_path = path.join(path.dirname(model_path),
                             "logs", datetime.now().strftime("%Y%m%d-%H%M%S"))
        board = TensorBoard(
            log_dir=log_path,
            histogram_freq=1,
            profile_batch=(0, 4))
        callbacks.append(board)

        tic = datetime.now()
        logger.info('////////// Starting training //////////')
        history = self.interpreter.fit(
            x=train_data,
            steps_per_epoch=train_steps,
            batch_size=batch_size,
            callbacks=callbacks,
            validation_data=validation_data,
            validation_steps=validation_steps,
            epochs=epochs,
            verbose=verbose)
        toc = datetime.now()
        logger.info(f'////////// Finished training in: {toc - tic} //////////')

        if show_plot:
            try:
                import matplotlib.pyplot as plt
                from pathlib import Path

                plt.figure(1)
                # Only do accuracy if we have that data
                # (e.g. categorical outputs)
                if 'angle_out_acc' in history.history:
                    plt.subplot(121)

                # summarize history for loss
                plt.plot(history.history['loss'])
                plt.plot(history.history['val_loss'])
                plt.title('model loss')
                plt.ylabel('loss')
                plt.xlabel('epoch')
                plt.legend(['train', 'validate'], loc='upper right')

                # summarize history for acc
                if 'angle_out_acc' in history.history:
                    plt.subplot(122)
                    plt.plot(history.history['angle_out_acc'])
                    plt.plot(history.history['val_angle_out_acc'])
                    plt.title('model angle accuracy')
                    plt.ylabel('acc')
                    plt.xlabel('epoch')

                plt.savefig(Path(model_path).with_suffix('.png'))
                # plt.show()

            except Exception as ex:
                print(f"problems with loss graph: {ex}")
            
        return history.history

    def x_transform(
            self,
            record: Union[TubRecord, List[TubRecord]],
            img_processor: Callable[[np.ndarray], np.ndarray]) \
            -> Dict[str, Union[float, np.ndarray]]:
        """ Transforms the record into dictionary for x for training the
        model to x,y, and applies an image augmentation. Here we assume the
        model only takes the image as input. All model input layer's names
        must be matched by dictionary keys."""
        assert isinstance(record, TubRecord), "TubRecord required"
        img_arr = record.image(processor=img_processor)
        return {'img_in': img_arr}

    def y_transform(self, record: Union[TubRecord, List[TubRecord]]) \
            -> Dict[str, Union[float, List[float]]]:
        """ Transforms the record into dictionary for y for training the
        model to x,y. All model outputs layer's names must be matched by
        dictionary keys. """
        raise NotImplementedError(f'y_transform for {self} not implemented')

    def w_transform(self, records: Union[TubRecord, List[TubRecord]]) \
            -> Dict[str, Union[float, List[float]]]:
        """ Transforms the record into dictionary for weights for training the
        model to x,y. All model outputs layer's names must be matched by
        dictionary keys, i.e the format of the dictionary here has to match
        the output of y_transform. """
        raise NotImplementedError(f'w_transform for {self} not implemented')

    def output_types(self) -> Tuple[Dict[str, np.typename], ...]:
        """ Used in tf.data, assume all types are doubles"""
        shapes = self.output_shapes()
        types = tuple({k: tf.float64 for k in d} for d in shapes)
        return types

    def output_shapes(self) -> dict:
        return {}

    def __str__(self) -> str:
        """ For printing model initialisation """
        return type(self).__name__

    def get_num_last_layers_to_train(self):
        """ Find the canonically named Flatten layer and return number of
        layers after that"""
        assert isinstance(self.interpreter, KerasInterpreter) and \
               self.interpreter.model, "Wrong interpreter or no model set"
        i = 0
        while self.interpreter.model.layers[i].name != 'flattened':
            i += 1
        return len(self.interpreter.model.layers) - i - 1

    def freeze_first_layers(self, num_last_layers_to_train=None):
        if num_last_layers_to_train is None:
            num_last_layers_to_train = self.get_num_last_layers_to_train()
        assert isinstance(self.interpreter, KerasInterpreter), \
            'Can only freeze layers in Keras model but not in TfLite and others'
        num_to_freeze = len(self.interpreter.model.layers) - num_last_layers_to_train
        frozen_layers = []
        for i in range(num_to_freeze):
            self.interpreter.model.layers[i].trainable = False
            frozen_layers.append(self.interpreter.model.layers[i].name)
        logger.info(f'Freezing layers {frozen_layers}')
        return num_to_freeze
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
