autorope/donkeycar/(commit log)

2016-12-11 updated camera
2016-12-12 working camera, fixed gitignore
2016-12-12 fixed keyboard imput to adjust global speed and angles from a thread
2016-12-13 separated threaded camera
2016-12-14 fixed numpy issue from lower version
    [image.py]
2016-12-14 added streaming video camera object
2016-12-14 camera udpates
2016-12-16 switched name to car
2016-12-16 separated keras predictors so rpi won't error'
    [base.py, keras.py]
2016-12-20 updated files for fake camera with a images from recent drive
2016-12-20 made fake camera it's own thread so its more like PiCamera
2016-12-22 resize camera resolution
2016-12-24 add dataset and fix train bug
    [keras.py]
2016-12-27 change max throttle on monitor
2016-12-28 fixed port for heroku
    [whip.py]
2016-12-28 add print statement
2016-12-30 fix stuff to work on pi
    [actuators.py]
2016-12-30 fixed demos and readme
    [keras.py]
2017-01-02 update actuator values
2017-01-05 updated steering actuator defaults
2017-01-10 Added Hardware.
    Added Ardware
    [Adjustable Camera Holder.stl, Camera Holder.stl, Roll Cage 2nd Version.stl, Top And Bottom Plate-Will Car.dwg]
2017-01-10 added joystick
    [Adjustable Camera Holder.stl, Camera Holder.stl, Roll Cage 2nd Version.stl, Top And Bottom Plate-Will Car.dwg]
2017-01-25 Implemented actuator mixer
2017-01-27 docs update and renaming
    [Camera Holder.stl, camera_holder.stl, hellion_conquest-base_plates.dwg, hellion_conquest-roll_bars.stl]
2017-01-28 Separated mixers and actuators into different files; added an additional hardware abstraction layer for actuators
2017-01-28 Updated Hardware and Documentation
    [Camera Holder.stl, Car Top Plate - Helion Conquest.dwg, Car Top Plate - Trooper.dxf]
2017-01-28 moved hardware folder
    [hellion_conquest-top_plate.dwg, trooper-top_plate.dxf]
2017-02-01 bug fixes on car
    [actuators.py]
2017-02-09 multicar support & web pilot switching
2017-02-09 fixed joystick, added opencv to setup, print request lag time
2017-02-09 remove print statements
2017-02-11 upped camera frame rate
2017-02-13 added differential motor control
2017-02-13 changed steering angels to range betwee -1 and 1"
2017-02-15 fixes to front steering
    [actuators.py]
2017-02-21 Default pwm settings for Exceed Magnet truck
2017-02-23 add throttle backoff when requests timeout
2017-02-26 custom training results name, updated test params, print current test
2017-02-26 flushed print statements to print in nohup
2017-02-26 Wr/explore models (#51)
    * script to search for better models
    * custom training results name, updated test params, print current test
2017-02-28 Draggable multiselect and turn icons (#53)
    * revert to jquery selectable, use filters for performance
    * add turn icons
    * div width fix
2017-03-01 Dev (#49)
    * removed munge
    * add lag logging, added session to remote clients, added timeout to request
    * add throttle backoff when requests timeout
    * added car config file
    * add config folder
    * updated scripts and refactors sessions
    * fixed and tested upload to s3 scripts
    * flushed print statements to print in nohup
    * Wr/explore models (#51)
    * update explore scripts
    * added datafile name to results
    * update training scripts
    * vixe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
2017-03-27 Version 0.2 (#70)
    * Small screen UI with control by deviceOrientation (#64)
    * Dev (#49)
    * update explor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
    [actuators.py]
2017-04-01 Add constant throttle option (#79)
    * add constant throttle option, replace will's hardcoded model path with path to default model
    * correct steering PWM settings in default vehicle.ini for magnet
2017-04-02 add more granularity to max throttle
2017-04-21 fix mounting in the docker instance
2017-04-23 fixed volume mount for docker
2017-04-25 fixed steering angles to match my car
    hopefully this is standard for all cars the same model
2017-04-28 updated calibrate script
2017-04-30 First untested cut of the Pololu Meastro support
2017-05-11 Add support for some LED blinky lights
2017-05-14 First attempt to add a speed sensor and handle the extra data all the way
2017-05-15 More fixes for the addition of the speed data
    [actuators.py]
2017-05-17 Trying to push the brake/stop/drive state to the vehicle
2017-05-17 Print the drive value as well
2017-05-17 PID setup for traottle
2017-05-18 Initialize the target speed in the user case
2017-06-04 add button to download zip file of session images
2017-06-04 remove Servo Utility
2017-06-13 update calibrate docs
2017-07-02 More problems with the speed/imu sensors
2017-07-04 moved parts to their own directories
    [camera_holder.stl, hellion_conquest-base_plates.dwg, hellion_conquest-roll_bars.stl, hellion_conquest-top_plate.dwg, trooper-top_plate.dxf]
2017-07-07 switched index to use pandas, separated tub writer and reader
2017-07-08 fixed calibrate script
2017-07-08 fixed actuator
2017-07-08 add custom PWM settings
2017-07-08 add shutdown for steering and throttle
2017-07-08 reduced frame rate
2017-07-15 Donkey2 with Odometer (#96)
    * odometer part and example vehicle script
    * rename file to match class name
    * declare in parts init
    * fix output syntax
    * bug fix
    * attempt to prevent shutdown error
    * fix isr arg
    * new filename
    * add distance to odometer output
    * change output path
    * clean up the comments
    [rotary_encoder.py]
2017-07-15 Fix the linaccel == None case
2017-07-24 Fix the usage of the RC input
    [actuators.py, teensy_rcin.py]
2017-08-09 refactored actuators to work again
2017-08-14 V2.1 - Refactor to modular architecture. (#89)
    * First untested cut of the Pololu Meastro support
    * Move the import of the serial module to the class where it is needed
    * Fix some sh/bash problems
    * Make the web app selfcontained so it does not rely on an internet connection
    * Get the pyserial into the docker image as well
    * Add tornado.gen import. Not sure how that worked without it
    * Use a USB webcam instead of the RaspiCam
    * Add support for some LED blinky lights
    * Adapt the drive.py to the Maestro & webcam used with the TK1
    * Wrong module for requests.ReadTimeout?
    * Apparently my webcam can not do the small resolution, do it explicitly
    * First attempt to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
    [camera_holder.stl, hellion_conquest-base_plates.dwg, hellion_conquest-roll_bars.stl, hellion_conquest-top_plate.dwg, trooper-top_plate.dxf]
2017-08-17 add numpy import before keras to try to fix np_utils error in travis ci
    [keras.py]
2017-08-19 update docs with calibration steps
2017-09-10 Dev - 2.1.3 (#114)
    * add ImgCrop part
    * tests
    * tawn > dev (error fixes and ps3 joystic) (#120)
    * fixed web ui joystick for iphone 5s, 6, ipad 2
    * turned off print
    * adding startup script for my car
    * fix batch size
    * added physical joystick controller
    * added mock camera and mock controller to test some car code on my laptop
    * added requirements.txt
    * some changes to fix windows setup
    * add environment file to init conda environment
    * some windows howto docs, pi anaconda env file and setup script
    * fix arm platform detection
    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
    [actuators.py, cameras.py, cv.py, keras.py, test_keras.py]
2017-09-11 Update calibrate.md (#123)
    Fixing spelling mistake.
2017-09-11 Update calibrate.md (#124)
2017-09-11 Doc changes (#125)
    * changes to get init config files
    * fixes
    * more tweaks
    * wip on training script
    * readme changes
    * readme edits
    * remove large file
    * fix for web ui on iphone
    * added sessions to make_pa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
2017-09-13 Doc changes (#130)
    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
    [cameras.py, cv.py]
2017-09-14 Doc changes (#132)
    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
2017-09-16 add more button controls to PS3
2017-09-17 Tub view (#129)
    * --tub is now optional for train subcommand. It also takes comma-separated format
    * new train docopt parameters
    * ... causes wierd behavior in docopt
    * Tornado server runs with views and apis
    * Play tub as video stream now
    * Split clips and mark to delete works
    * Select clip to play
    * Affix preview to the top. UI fine tunes
    * API to delete checked clips
    * UI finish-up
    * Final UI tweakings and minor UI bugs.
    * rewind button
    * playback speed options
    * fix the problem of jumpping affix div
    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
    [base.py]
2017-09-17 Wr/config (#137)
    * hot keys
    * disable submit button while submitting to improvie usability
    * car.py -> manage.py
    * add config object to read/store car setti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
    [base.py, keras.py]
2017-09-18 Add PID controller part (#138)
    * add PID controller
    * fix typo
2017-09-18 Rotary encoder updates (#139)
    * bug fixes for rotary encoder
    * add debug flag to rotary encoder console output
    * update odometry template
    * remove template that should not have been re-added
    [rotary_encoder.py]
2017-09-19 Tub viewer improvements (#142)
    * Dynamatically generates clips based on timestamps so that it's always up to date
    * Change POST to using dynamic clip recognition
    * remove animation from steering progress bar to reveal jitterness of steering angles
    * car.py -> manage.py. Ghost rebase commits keep coming back
    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
2017-09-22 BUG: record generator needs to throw StopIterator exception so that itertool.chain can move on to next tub (#144)
2017-09-22 Fix a crash when simulation tries to load a model (#145)
    * slightly more concise code
    * Minor bug fix for simulation to load a model
    * Minor bug in unbin_Y
    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
2017-09-25 calculate step size for training dynamically based on sample count
2017-09-28 added command line option/sticky config to use joystick in manage.py. Added option to record on non-zero throttle
2017-09-29 fix conflict with triangle button
2017-09-29 refer to new config.py when setting pwm channels
2017-10-12 V 2.1.4 - better docs, makemovie (#157)
    * joystick doc fixes
    * specify keras and tensorflow version for linux desktop install
    * create a movie from a tub
    * improve error handling and usage for making movie from tub
    * added docs for donkey commands
    * use config instead of magic num
    * rename movie command to makemovie
    * smaller increment on delta max throttle
    [base.py]
2017-10-22 V 2.1.5 - Simulator, analysis and bug fixes. (#167)
    * create a tub for training against stack of N records through time
    * added sdsandbox integration. testing time stack.
    * added donkey sim integration
    * added deps to setup.py
    * added simulator docs
    * fix sim steering scale. added steering plot analysis.
    * more comments. added steer sc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
    [base.py, cv.py, keras.py]
2017-10-26 hot fix to prevent pi from failing to load socketio
2017-11-01 V 2.2.0 - better tubs, opencv, bug fixes (#173)
    * clean up how groups of tubs are handled by adding a TubGroup class (#172)
    * Extra steps for Mac installation of simulator
    * clean up how groups of tubs are handled by adding a TubGroup class
    * hot fix to prevent pi from failing to load socketio
    * clean up how groups of tubs are handled by adding a TubGroup class
    * fixed split paths for multiple tub groups
    * made merging dataframes faster
    * made merging dataframes faster
    * refactor parts
    * merge refactor branch
    * name changes
    * updated some of the commands (tubcheck, tubhist)
    * cleaned up commands
    * remove extra code, add tests
    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
    [actuator.py, base.py, camera.py, controller.py, cv.py, encoder.py, keras.py]
2017-11-03 removed calibrate error
2017-11-06 added part for mpu6050 imu
2017-11-06 added poll delay to imu part
2017-11-06 added keras imu pilot and model def
2017-11-06 added comments for training imu model. added tests
2017-11-06 added imu docs
2017-11-08 changed order of camera resolution parameters tobe height x width
2017-11-08 fix js double thread launch. hot load js
    [controller.py]
2017-11-09 fix imu run. eliminate def delay on js
    [controller.py, keras.py]
2017-11-13 fixed missing arg from tubcheck
    [base.py]
2017-11-13 V 2.2.1 - IMU, script tests, change camera resolution config order (#179)
    * add tests for donkey script commands (incomplete)
    * added part for mpu6050 imu
    * added poll delay to imu part
    * added keras imu pilot and model def
    * added comments for training imu model. added tests
    * added imu docs
    * update documentation for donkey2 manage.py commands
    * fixed tub path discovery
    * changed order of camera resolution parameters tobe height x width
    * fix js double thread launch. hot load js
    * fix camera resolution mismatch
    * fix imu run. eliminate def delay on js
    * add tests for running scripts
    * fix script tests for py34
    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
    [base.py, camera.py, controller.py, imu.py, keras.py]
2017-12-01 added led status, throttle filter, new templates, train script.
2017-12-01 fix config default settings, other small fixes
    [throttle_filter.py]
2017-12-02 fix camera res
2017-12-03 Update install instructions (#192)
    Update login and network location to match the current pre-built install that is referenced at the beginning of the tutorial.
2017-12-14 added a button map for specifying joystick controls
2017-12-16 add led part to rnn manage. fix cam res
    [camera.py]
2017-12-16 add model switching
2017-12-22 add hbridge and two wheel control
2018-01-05 added stero camera option
2018-01-06 fix i2c bus
2018-01-06 add back two wheel
2018-01-17 added cat throttle to default model. fix plots
    [base.py, keras.py]
2018-01-22 add config for led, camera type, 9865 bus
2018-01-22 add common anode led support
2018-01-23 fix i2c address for pi
2018-02-03 added pc connected ps3, fixed pub
    [controller.py]
2018-02-03 fixes to network js
    [actuator.py, controller.py]
2018-02-24 added rpi gpio servo
2018-03-04 Fix kernel_size typo (#216)
    [cv.py]
2018-03-08 update battery link fixes #220
2018-03-13 update tornado version to fix error in 5.0
    [test_scripts.py]
2018-03-14 added servoblaster part
2018-03-15 servoblaster a little more like pca8685 now
2018-03-17 R=1 learns higher thottle. fix err
    [keras.py]
2018-03-21 added servoblaster/hbridge drive config
2018-03-23 Updated roll your own section and added bom for donkeystore
2018-03-25 replace keras inports with tensorflow keras imports
    [keras.py]
2018-03-26 give better error msg when too few records to train
    [base.py]
2018-03-30 Clarification on how to begin calibration
    I tried to run calibration by going into the donkey environment on my Mac instead of ssh-ing into my Pi. Hopefully adding this line will enable others to avoid my mistake and wasting time.
2018-03-30 Added Amazon link for LiPo battery
    I bought mine on Amazon so I put the link in there as an option.
2018-04-02 Fix validation steps computing
    [keras.py]
2018-04-02 Screw location for Pi cam can result in short
    Due to screw head size and placement, using top screw holes on Pi cam can cause a short. Using bottom two holes avoids this potential issue.
    Reported by @Ezward on the Donkey Car Slack: https://donkeycar.slack.com/archives/C487786DC/p1522638679000068?thread_ts=1522442985.000360&cid=C487786DC
2018-04-10 Disable additional shuffling while training
    Before this change dataset was shuffled once and
    then on every step random sample was returned.
    Problem is that this way we do not guarantee that
    all samples from dataset will be used.
2018-04-13 some fixes for behavior model
    [base.py, keras.py]
2018-04-20 pin tensorflow version to 1.7
2018-05-12 Fix an error when using the donkey tubplot command
    [base.py]
2018-05-29 fix import for keras model
    [keras.py]
2018-06-11 fix nested tf results
    [keras.py]
2018-06-16 new instructions for camera
2018-06-16 camera file
2018-06-21 Deploy to pypi only once when using build matrix
    Makes use of TravisCI build stages. Note that this feature is still
    in beta.
2018-07-10 Fix source code of parts directory, to follow PEP8 rules
    [actuator.py, camera.py, keras.py, simulation.py, transform.py]
2018-07-11 added la, geom
2018-07-21 added bus and address args to calibrate
2018-08-04 fixed lidar parts
2018-08-04 constant steering chaos monkey
2018-08-25 fix rnn and 3d types
    [keras.py]
2018-08-30 fix teensy
2018-08-31 work on fix for ps3 controller
    [controller.py]
2018-09-09 default to 1m range on lidar
2018-09-12 moved RGB LED under feature switch.
2018-09-12 record count led status
2018-09-16 rudimentary localization via categorical id of track section
2018-09-22 switched default ps3 controller to deb stretch version
2018-09-24 fix some keras2 api warnings
    [keras.py]
2018-09-25 added coordconv submodule, fixed localizer, added donkey_gym part
    [dgym.py, keras.py]
2018-09-25 change printed version, added lib install
2018-09-26 better seguay into calibrate and driving
2018-10-13 more robust and user-friendly calibration
2018-10-13 Add support for Switch Pro Controllers. To use that, set JOYSTICK_THROTTLE_AXIS = 'ry' in config.py, so that 'Right Stick' key on the controller can be used to move the car forth and back by setting 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
2018-10-16 Added Validation of user input for PWM calibration
    * Simple exception handling to avoid failing
    [base.py]
2018-10-19 Print message when setting PWM fails.
    This prevents the car from completely stopping if there is a weak connection
    between the host and the peripheral motor board. Otherwise, a single failed
    set_pwm call will halt the host.
    [actuator.py]
2018-11-04 fixes after testing on car
    [actuator.py]
2018-11-17 fixed polling for initial controller connect
    [controller.py]
2018-12-09 Clarify top plate orientation to roll cage
    This was not originally clear and I ended up attaching it upside down during my build.
2018-12-12 fix moviemaker default. better error handling for missing frames
    [base.py]
2018-12-16 Prints a jitter message when loop rate is not maintained.
2019-01-04 some work on learning a latent vector of the track
2019-01-07 pin tornado to an older version to fix web controller
2019-01-12 udp camera transmit w salient vis
2019-01-12 add config for max learned throttle range
2019-01-20 camera pub/sub worked well with mqtt
2019-01-22 Update install_software.md
    I'm following the doc to install on my Pi : https://github.com/autorope/donkeycar/blob/dev/docs/guide/install_software.md#get-the-raspberry-pi-working. There's section says "If you are using the prebuilt image specified above, then your Pi is ready to go. You should see a mycar and donkey directory." I think it should be placed after the "Create your car app" section because I don't see the 'mycar' directory comes with the image
2019-02-12 Wait 0.1s after initializing the PWM controller.
    The ESC "Tamiya TBLE-02" makes a little leap otherwise.
    This leap does not happen at the first time after power on,
    but on all subsequent starts of the Donkeycar driving program.
2019-02-15 print when file modified, if verbose
2019-02-19 add steering distribution visualizer
2019-03-05 Fixed link to photo of Latrax -- case sensitive
    Alternative would be to rename the asset Latrax.JPG to Latrax.jpg
2019-03-11 add pigpio pwm part
2019-03-16 Fixed camera streaming for firefox
2019-04-05 Changed encoder.py to use GPIO Board
    Updated encoder.py to reflect the standard of GPIO Board used by all the other parts. This is so that you can have all the parts playing nicely together.
2019-04-15 config switches for xbox nimbus controllers
2019-05-03 minor fixes to actuator.py
    [actuator.py]
2019-05-10 added ai throttle scale
2019-05-25 updates to actuator.py and serail_controller.py - I havee fixed these issues like 3 times. hopefully no more.
    [actuator.py, serial_controller.py]
2019-06-12 doc change from jamestharpe
    [test_web_controller.py]
2019-06-12 fix some problems found in unit test
    [keras.py, simulation.py, test_scripts.py, test_vehicle.py]
2019-06-13 adding docs for jetson nano setup
2019-06-16 XBox controller has throttle reversed, so added throttle_dir config
    [controller.py]
2019-06-17 CSIC camera now threaded
2019-06-18 added a V4L camera with fewer dependencies
2019-06-18 added V4L camera to config
2019-06-19 updating hardware instructions with the NVIDIA Jetson Nano
2019-06-20 Fix "salient" operation by adding tensorflow.python prefix to "keras" imports. Fix "ShowCnnActivations" by adding tensorflow.python prefix to "keras" imports.
    [base.py]
2019-06-20 Fix typo in help text of ShowPredictionPlots 'type' argument
    [base.py]
2019-06-21 fix for donkey sim from donkey3 manage
    [dgym.py]
2019-06-21 Update tubclean webinterface + If clip is playing then speed changes from dropdown take effect immediately. + Clicking an image in the clip timeline will jump to that frame.
2019-06-21 Add script to allow remote cam viewing when images are published by donkeycar using TcpServer (set by "PUB_CAMERA_IMAGES = True" in config file in current codebase)
2019-06-25 Fix tubplot to NOT provide its own default model type. Add the model type to the tubplot title.
    [base.py]
2019-06-26 Added tests to test_train.py that would highlight the issue with the original code.
    [test_train.py]
2019-06-26 Reintroduce the much improved Calibrate function that was in a previous codebase: Does not have 10-loop limit, provides interactive method to exit from utility.
2019-06-26 Add axis names and button names to Joystick.
    * This step helps discover mappings not already pre-existing and
    provides a way to dicover and modify defaults.
    * Adds Forza mode for the XboxOne controller.
2019-06-27 Fixes issue where images come out as BGR instead of RGB
    [camera.py]
2019-06-28 Cv2 Import now in poll camera function
2019-06-29 print some diagnostics for Adam
2019-06-29 disable print
2019-06-29 fixed a few stragler lazy keras imports to tf.keras
    [profile.py]
2019-06-29 print joystick controls on startup
2019-06-30 Minor update to RotaryEncoder in encoder.py part (fix shutdown code)
    [encoder.py]
2019-07-01 fix test for launcher
    [launch.py]
2019-07-01 disable debug prints
2019-07-01 pin TF to 1.13.1
2019-07-01 print the training time
2019-07-01 kill throttle hack scale
2019-07-03 CSI camera: Config option to flip the cam frame orientation
    If the camera is mounted in a rotated position, provide an option
    to flip the camera frame.
    CSICamera Jetson nano part is implemented using gstreamer. Passing
    the flip parameter to the gstreamer pipeline will do this.
    [camera.py]
2019-07-06 Allow TF 1.13.1 to use GPU correctly
    [keras.py]
2019-07-07 Support for TensorRTLinear model.
    * This PR adds support for Tensor RT.
    * There are probably more minor improvements I can make to
    `tensorrt.py`, but I think this is a good starting point.
    * `freeze_model.py` exports metadata about the model which helps us
    reconstruct the TensorRT model.
    * Make sure `pycuda.autoinit` is never loaded during training, as it
    interferes with TF-GPU (when training).
    Test: Tested this on my Jetson Nano.
    [freeze_model.py, keras.py]
2019-07-10 Improvements to TensorRT Pipeline.
    * Reverse throttle and steering.
    * Reduce the number of nodes in the frozen graph further.
    Test: Tested with donkey tubplot.
    [freeze_model.py]
2019-07-10 Update controllers.md
    PS3 controller is not compatible with Jetson Nano
2019-07-13 MakeMovie improvements: * Use index to correctly go from first to last frame * Use index from tub instead of try/catching on continuous frames * Use picture frame size to determine mid of and length 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
    [base.py]
2019-07-13 update sample code
2019-07-15 Allow PWM freq. of PCA9685 to be specified (default value remains as before) Also includes code to scale PWM values appropriately based on the freq. specified.
2019-07-15 Update MakeMovie to allow plotting of user data only (no model) - useful for determining quality of user input. Also fix the confusing mix of model argument being None vs "None".
    [base.py]
2019-07-16 handle too large end for makemovie
    [base.py]
2019-07-18 Enable throttle scaling while controlling manual throttle
2019-07-25 Fix image handling (img_crop, normalize_and_crop, load_scaled_image_arr) to deal with greyscale images correctly. Also various spelling fixes.
    [camera.py]
2019-07-26 map F710 dpad to max throttle adjust
2019-08-08 encoder gives delta dist
2019-08-10 few fixes for coral support
    [coral.py, profile.py]
2019-08-15 updates to jetson nano
2019-08-20 improve CSIC camera
2019-08-24 Fix slow salient mask overlay by: * unrolling the salient method in keras-vis into 2 parts * putting the optimizer which can be kept static into the initialization * also remove unused code and impor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
    [makemovie.py]
2019-08-24 Set MakeMovie start argument to frame 0 instead of 1
2019-09-05 Fix typos in setup_raspberry_pi.md
    Fix these typos: it's/its, you're/your, insterting/inserting
2019-09-24 Improve performance by replacing division /255 with multiplications and adding some pep-8 formatting. Also fixing jitter output to be in ms
2019-10-06 removed joystick mode for R2 trigger as additional throttle
2019-10-17 retry of pwm.set_pwm on first exception due to I2C timing errors
    [actuator.py]
2019-10-19 Expand .travis matrix
    * Add stages for makrdownlint, yamllint, mkdocs
    * Update travis config so that it no longer generates warnings if pasted
    into https://config.travis-ci.com/explore
    * Speed up linting phase (skip install)
    * Move docs build earlier
    * Allow yamllint and makrdownlint to fail
2019-10-26 Support PWMThrottle and PWMSteering as threaded part to improve performance. Minor (most whitespace) code cleanups (pep-8).
2019-10-26 Fix typo vebose -> verbose.
    [test_train.py]
2019-11-09 Update setup_raspberry_pi.md
    * ensure docs guide how to handle SD card in a safe way
    * make formatting more consistent
    * ensure headers about optional steps are easier to spot
    * add more details about setting up hostname and discovering IP of the device
    * minor fixes
2019-11-22 add configs: CAMERA_VFLIP, CAMERA_HFLIP
2019-11-22 add PiCamera arguments: framerate, vflip, hflip
2019-11-27 448 protected DriveMode from None throttle or steering
2019-11-27 dumping ground for latest commits since June
2019-11-27 updated actuator.py
2019-11-27 Added in RoboHAT MM1 ACTUATOR_MODE variable.
2019-11-28 502 fixed import error
    [actuator.py]
2019-12-05 Adding class WebFpv which is a simple web server which only serves the donkey car camera * Reduced the sleep time in the VideoAPI from 100ms to 10ms in order to achieve a less lagging web camera pict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
2019-12-05 Adding class WebFpv which is a simple web server which only serves the donkey car camera * Add socket to dependencies
2019-12-05 Adding class WebFpv which is a simple web server which only serves the donkey car camera * Socket module not needed - this is part of standard python
2019-12-22 Revert "Adding class WebFpv which is a simple web server which only serves the donkey car camera * Socket module not needed - this is part of standard python"
    This reverts commit 1238b5fd
2019-12-22 Revert "Adding class WebFpv which is a simple web server which only serves the donkey car camera * Add socket to dependencies"
    This reverts commit 46931d2d
2019-12-22 Revert "Adding class WebFpv which is a simple web server which only serves the donkey car camera * Reduced the sleep time in the VideoAPI from 100ms to 10ms in order to achieve a less lagging web cam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
    This reverts commit a2e49d93
2019-12-23 wqAdd support for a PiOLED display to show useful information.
    * Connect the PiOLED display over I2C, and configure the bus number.
    * Change `myconfig.py` to update the bus number, and the display automatically shows useful information.
    * Uses the `Adafruit_SSD1306` library.
2019-12-30 parts/actuator.py: Add Arduino drive-train support
    Arduino board can be used to generate the PWM signals for controlling
    steering/throttle of the car.
    Standard Firmata sketch needs to be loaded on the Arduino to allow it
    to be managed from the host-cpu runnig python app.
    Native arduino drive train support is particularly useful for combo
    boards like LattePanda with builtin cpu/Arduino.
2019-12-30 management/base.py: Calibration switch for Arduino
    Arduino calibration values vary from 0 - 180. This is different from
    PCA9685 for which the calibration values vary from 0 - 1500.
    Add --arduino switch to the calibrate command to accomodate this.
    More details in actuators.md -
    "Note that 90 is the usual midpoint (i.e. 1.5 ms pulse width at 50 Hz),
    so it is recommended to start with 90 and adjust +/- 5 until you figure
    the desired range for steering / throttle."
2020-01-03 docs/parts/actuators.md: document arduino drive train support
    Document the following:
    1. How to connect Arduino pins to servo/ESC.
    2. What sketch to load onto the Arduino side
    3. Explain calibration mechanism for Arduino drive train.
    4. Provide sample snippets showing how to make use of this part.
2020-01-03 templates/arduino_drive.py: Arduino drive train template
    A template meant to familiarize users with Arduino drivetrain related
    config options and sample code.
    Allows users to control a an Arduino drivetrain car with a joystick.
2020-01-16 Update faq.md
    add "sensored" to brushless motor reference
2020-01-17 pin numpy to a working version on jetson nano
2020-01-18 RealSense-part added realsense435i to read rgb, depth and imu
2020-01-19 RealSense-part added code to realsense435i.py to calculate framerate
2020-01-25 print some online instructions
2020-01-25 added sample calib.json
2020-01-30 Update build_hardware.md
    For rPi 4B and Jetson Nano processor boards the higher power comes at a price of higher input power and since the voltage remains the same( 5V ) the current must increase. So it's recommended you get a USB battery pack with 3A output capabilities or higher.
2020-02-05 Fix issues with xboxswapped controller
    Add option to do nothing on older axes, otherwise both joystics were
    reacting in the same time to throttle and steering, which made it
    totally unusable.
    [controller.py]
2020-02-07 - pulled out pipeline shutdown into it's own method. - give thread more time to quit. - give camera more time to warm up.
2020-02-08 - added exception handler in Vehicle.py to print any exception that terminates the vehicle loop, other than a keyboard interupt.
2020-02-08 - added traceback in Vehicle.py to print any exception that terminates the vehicle loop, other than a keyboard interupt.
2020-02-08 - removed redundant print in the exception handler.
2020-02-10 - Eat frames at start to allow imu and/or auto-exposure to settle - Changed to allows use default time for wait_for_frames() - Those above changes were verified in realsense_viewer.py in the realsens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
2020-02-20 Update setup_jetson_nano.md
    updated path for OpenCV module for Jetson Nano
2020-03-02 [#549] - Fix accelerometer scale
    [imu.py]
2020-03-02 [#549] - use calibration to zero accel/gyro bias
2020-03-02 [#550] MpuIMU->IMU, alias mpu6050->MPU6050
2020-03-03 [#550] - add support for configurable DLP (both sensors), fix missing temp
    [imu.py]
2020-03-06 1. Decouple MM1 dependency from RC controller. Now MM1 can act as a joystick and a drive train independently. 2. Add config for MM1 max throttle and steering adjustment 3. Add test case to robohat.py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
    [robohat.py, test_robohat.py, test_util_data.py]
2020-03-21 1. Add websocket drive api 2. Switch web controller to use the websocket api
2020-03-23 Added inverted parameter to PiGPIO_PWM
    [actuator.py]
2020-03-23 Added PGPIO_PWM as drivetrain type
2020-03-23 Cast pulse to int, scale pwm by default 100
2020-03-23 Default pins for PWM to match Raspberry hardware PWM pins
2020-04-02 better error messages for path problems to simulator
    [dgym.py]
2020-04-08 fix webcontrol print when changing port
2020-04-12 quick fix to get PS4 controller running with pygame
    [controller.py]
2020-04-21 add joystick device filename to config
2020-04-25 Adding MM1_SERIAL_PORT to config.
    Easier to swap between.
    [robohat.py]
2020-04-25 remove comment, update Driver MM1
2020-04-25 Enhance augmentation on tub data: * Add image augmentation as a standalone Tub member function which replaces the images in place. * Refactor the augmentation to separate into conversion between nump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
    [base.py]
2020-04-25 Improve the --inplace argument to be a switch & update docs
2020-04-30 fix roi for rnn,3d,imu models
    [keras.py]
2020-05-07 Fix on saving tubhist to tub_path dir instead of root dir
    [base.py]
2020-05-17 default to mountain track now
2020-06-04 catch exception if failed to send message to web socket client
2020-06-05 added the missing out arg
    [base.py]
2020-06-05 Fix image which was simply black after casting [0,1) values to int.
    [profile.py]
2020-06-07 1. Add calibrate.py 2. Add wsCalbirate and calibrate endpoint on web controller
2020-06-11 Simpify pwm value logic and add additional checking for invalid value.
2020-06-12 add missing dependency ffor code.py running on mm1 board
2020-07-20 New parts - Stop sign detector (#606)
    * Add rearlight support to mm1 circuitpython
    * Add more validation on incoming calibration value
    * Add stop sign detection
2020-10-09 Improvements to the car app and handling of KerasPilot parts: (#648)
    * Improvements to the car app and handling of KerasPilot parts:
    * Created a simpler webserver or joystick car app by modifying and renaming the basic_web into basic template and switched this on as default. Also renamed the target from 'manage.py' to 'drive.py' because there is only driving and no training included
    * Simplified the handling of uint8 and float32 numpy image arrays. KerasPilot.run() now expects uint8 data, transforms into float32 and delegates to its children. The corresponding rescaling step is gone from the car app
    * smaller updates/fixes to environment and config files
    * added support for tflite pilots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
    [base.py, camera.py, image.py, keras.py]
2020-10-12 Add testing for training: (#651)
    * added example tub data as tar.gz in tests with 1000 records
    * check validation data size in train
    * created new test_train.py
    * added support for read-only tub, required to create r/o tub in tmp dir
    * changed loss in categorical model to equally weight throttle and steering
    * changed mod on scripts to u+x
2020-10-17 Rename `drive.py` to `manage.py` to preserve CLI compat. (#656)
    * Train still prompts you to move to then new entry point.
    * Also fixes https://github.com/autorope/donkeycar/issues/655
    [base.py]
2020-10-24 added in brake functionality for simulator only
    fix typo in drivemode return which checked pilot/throttle instead of brake
    [dgym.py]
2020-12-01 Switch to using memory-mapped files when reading. (#691)
    * This makes reading a 100x faster.
2020-12-09 A configurable training pipeline. (#693)
    * Implement a Lazy transformable pipeline.
    * Implement basic batching. However, this will need to be improved
    further for models with multiple outputs.
    * Replace the old `Sequence` implementation used with a new `Pipeline`.
    Test: Ran end to end tests.
    [test_pipeline.py]
2020-12-16 Fix sequence iterators (#704)
    [test_pipeline.py]
2020-12-17 Change training pipeline from tf.Sequence to tf.data (#701)
    * Improve pipeline use: move from building list of pipelines of single transforms to building a single pipeline with a list of transforms (actually just looping through function to go from TubRecord -> image -> augment -> normalise -> x and TubRecord -> y).
    Fixed TfmIterators and TfmIterables.
    * Iterables are the containers and are sized - these are the user objects
    * Iterators are protocol objects to allow iteration, they have no logic and are local to the Iterables
    * build/map_pipeline both return sized Iterables
    * removed all batch logic, this is not required
    * still commented but left code that uses generator based pipel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
    [base.py, camera.py, keras.py, preview_augumentations.py, test_pipeline.py, test_train.py]
2020-12-21 * Add support for multi-dimensional model input and making the x, y interface symmetrical on the model / training interface: (#707)
    - x/y_transform extract x, y as numpy arrays or floats out of the record
    - x/y_translate convert the numpy arrays of floats into tf-readable dictionaries used in tf data.
    * Simplify model interface by implementing output_types() directly in the base class using output_shapes() dictionary.
    * Adding developer guide for own model development
    * Updated donkey command documentation
    * Improve asserts and type hints in keras.py
    * Added missing __init__.py in parts module.
    * Add cool ascii text for donkey init and update yml and setup files including mypy
    * Re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
    [keras.py, test_pipeline.py, test_train.py]
2020-12-23 Minor changes for 4.1 in tub conversion script and developer doc (#708)
    * Minor changes for 4.1
    * Update conversion script to translate discontinuous data.
    * In developer guide add disclaimer for version and correct intra-page links.
    * * Update doc with donkey train command.
    * Update doc with developer section for building own models in donkey 4.1
    * Integrate changes from PR feedback
    * Incorporate PR feedback
    * Add empty records concept to tub
    * Minor updates to conversion script
    * Incorporate PR feedback
    * Add empty record type into conversion script
    [convert_to_tub_v2.py, tub_v2.py]
2020-12-29 Added the ability to train PyTorch models (#706)
    * Added in PyTorch and PyTorch Lightning to train a DC model
    Successfully able to train a ResNet18-based model using PyTorch
    Lightning.
    * Removed hard-coded max number of epochs (used for debugging)
    * Added an inference transform to ResNet18 to convert PIL -> tensor
    * Unsqueezed input tensor during inference for batch dimension
    * Reshaped ResNet output from (1, 2) to (2,)
    * Added the ability to resume training from a checkpoint
    * Added helper print message when tensorboard logging is enabled
    * Updated docopt arguments for train.py. Made checkpoint optional
    * Changed TorchTubDataset from sub-classing Dataset to Itera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
2021-01-04 Merge Changes from `master` to `dev`. (#722)
    * - Update tensorflow version to 1.15.0
    - Add doc for Jetpack 4.4
    - Remove opencv installation
    * Add dataset and pre-trained model page
    * fix issue #634 (#646)
    - remove jquery dependency
    - add clearTimeout
    * Allow overriding WEB_CONTROL_PORT from env variable
    * pin h5py version
    * fix h5py version for mac
    * * Update doc with donkey train command. (#709)
    * Integrate changes from PR feedback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
2021-01-13 Switched to standard Webserver
2021-01-16 Fixed FindCar function for RPi4
    [base.py]
2021-01-16 Tub improvements: * Fixed manifest iterator to avoid too deep recursive function calls which segfaults when deleting many records * Automatic addition of '_session_id' field in the Tub. This mimics t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
    Tub GUI development:
    * Support starting from 'donkey ui' command
    * All relevant settings are stored in ~/.donkeyrc file which is editable
    Training improvements:
    * You can now put a predicate for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
    [base.py, convert_to_tub_v2.py, datastore_v2.py, keras.py, test_torch.py, test_train.py, test_tub_v2.py]
2021-01-16 Follow up on code review: * Renamed function for session id creation in manifest and stored dictionary of last_id, last_full_id and all_full_ids in the metadata so no parsing needs to happen. Added m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
    [datastore_v2.py, test_tub_v2.py, test_tubwriter.py, tub_v2.py]
2021-01-18 Pin tf to 2.2.0 in setup for pip and yaml for conda. (#752)
2021-01-19 Pin tf to 2.2.0 in setup for pip and yaml for conda - fix wrong operator in pip.
2021-01-26 Fix tf2 lite nano camera support (#762)
    Fix tflite input/output conversion.
2021-01-28 Run loop in update() to avoid blocking run_threaded() (#768)
    [oled.py]
2021-01-28 Fix freeze_model.py in Tensorflow 2.2 (#773)
    [freeze_model.py]
2021-02-02 new: add logging instead of prints (#766)
2021-02-14 feat: enables to store position, gyro, accel, vel of simulator car into tub files
2021-02-14 feat: PR2 with CI issue cleared for position, gyro, accel, vel of simulator car in tub files
2021-03-06 Cosmetic typo
    Spelled "stopping" correctly
    [camera.py]
2021-03-10 Replace Travis CI with GitHub Actions (#801)
    * Add github action files and remove travis files
    * Suppress train tests in github actions
    [test_torch.py, test_train.py]
2021-03-16 Fixed XboxOne keycodes (#814)
    * Fixed XboxOne keycodes
    [controller.py]
2021-03-18 Added basic odometry
2021-03-19 Added docs for lidar
2021-03-19 Added lidar to Complete template
2021-03-20 Merge master to dev (#813)
    * Donkey 4.x is now official (#723)
    * Update nano install docs - python3-opencv vs libopencv-python
    * change slack to discord on readme
    * Donkeycar 4.x release. (#644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
2021-03-21 Missed lidar variable renaming in doc
2021-03-21 Add back missing default ai framework
2021-03-21 Correct bool test function.
    [test_lidar.py]
2021-03-27 Updated default Lidar limits to something more reasonable
2021-04-02 Fix pytorch lightning error (#830)
    * Predictions are now scaled between [0, 1] for training and validation
    Previously the predictions were between [-1, 1] for velocity and
    steering, but PyTorch Lightning v1.2.4 introduced changes that
    prevented this from working.
    Now scaling to be between [0, 1] for training and inference and
    then unscaling the predictions for running.
    * Replaced accuracy and precision metrics with mean squared error
    It didn't make sense to use accuracy and precision when predicted
    values could take on a continious range of values. MSE is a better
    metric.
    PyTorch Lightning also would throw an error when trying to use
    accuracy or precision with non-intege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
2021-04-02 Adding support for L298N motor controller (#829)
2021-04-02 Take out Tensorflow from automated windows installation (#824)
    * Take out Tensorflow from automated windows installation because it's causing … …an error with latest conda
    * Changed pc.yml to windows.yml
    * Rename pc.yml to windows.yml
    * Create ubuntu.yml
    (cherry picked from commit 8d5740d5d3622f21dbd633faaf05438a091bdee0)
2021-04-06 Kivy UI and minor fixes to templates and configs. (#823)
    Also: extensions to training supporting comments, auto-naming, transfer models. Small improvement in deleting/restoring tub records in bulk.
    [base.py, convert_to_tub_v2.py, datastore_v2.py]
2021-04-08 Added support for encoders
2021-04-12 Add info to docs
    Change tub select label against toggle button to allow not creating a new directory, i.e. call rsync pi@donkeypi:~/mycar/data/ instead of rsync pi@donkeypi:~/mycar/data. The latter command will create a new data/ folder within the target data/ folder which we don't want.
    Fix ui issues: check for existing config entries in ssh poll and correct path to start screen image.
2021-04-12 updates for connector screen
2021-04-13 Remove Lidar from basic config Combined lidar tests into single file and marked as skip, because it requires the necessary hardwar Updated docs for RC receiver
    [actuator.py, lidar.py, test_lidar.py]
2021-04-23 Virtual lidar support (#848)
    * added virtual lidar support
    * removed useless line
2021-04-28 Make clear you need to change the resolution for a CSIC camera (#852)
2021-04-29 Merge master to dev (#855)
    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
2021-05-09 Switched inferencing from predict -> call as this is faster! (#861)
2021-05-27 Update Lidar part to use new Adafruit library (#872)
2021-05-27 Update OLED part to use non-deprecated library and add rotation (#871)
    * Update to CircuitPython OLED library
    * Per code review
    * Added the OLED library to Nano installation, too
2021-06-03 Fix deletion of last records in tub (#877)
    * Fix delete_last_n_records in tub.
    * Pep-8: remove whitespace
    * Add test.
    [test_tub_v2.py, tub_v2.py]
2021-06-12 Refactored RC control for GPIO pins (#860)
    * WIP
    * Fixed web server
    * Got the basics woprking
    * Fixed some logic, trapped some error conditions
    Also changed "SERVO_ESC" drivetrain type, which doesn't really mean anything, to "I2C_SERVO", which actually describes the board used
    * removed RC class stub
    * Basic port done
    * cleanup
    * Fixed mode switch
    * Fixed joystick import issue
    * Changed option name to "PIGPIO_RC" which is more clear
    * changed rc controller option config to "pigpio_rc"
    * typo
    * Fixed comment to align with nomenclature
    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
    [actuator.py, controller.py, test_web_socket.py]
2021-06-24 fix saliency map bugs (#886)
    - tf2 version incomplatibility
    - uint8 conversion bug
    [makemovie.py]
2021-06-26 Add support for all other (except KerasLatent) models: (#884)
    * Factor out model from interpreter so each model can be saved and run in .h5 / .savedmodel keras format, in tflite format or in tensorrt format
    * Improved KerasPilot interfaces to support the above
    * Added test for all models and all interpreters (TFflite excluded for 3d CNN and TRT excluded for LSTM as these are not supported respectively)
    * use expand_dims and squeeze instead of reshape and [0]
    UI improvements:
    * Add support for all model / interpreter combinations in training and model arena
    * Add options to sync only h5, savedmodel, tflite or tensorrt pilots to car
    * Fixed disabling of keyboard when switching from on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
    [base.py, graph.py, interpreter.py]
2021-07-21 fix bugs and improve the approach making frames (#900)
    1. fix the bugs originated from the latest commit b544241fec146edcbb708edf58c813cef0b727b2 (Add support for all other (except KerasLatent) models: (autorope#884))
    2. improve the approach for calculating saliency maps,
    2.1 evaluate the effects of all output layers instead of one
    2.2 correct the problematic math (blending the gradients of angle and throttle output layers together) from direct sum to square norm
    2.3 calculate the saliency depending on the model type "linear" and "categorical"
    3. modify the "draw_user_input", "draw_model_prediction", and "draw_steering_distribution" methods, seperate the image array for inference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
    [makemovie.py]
2021-08-05 * Dispatch between augmentations which change the training data and transformations, like multiply and crop which manipulate the images in training, validation and inferencing (driving). * Adding tra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
    [preview_augumentations.py, test_train.py]
2021-08-21 Fix for memory model run() function to run in car application without passing previous steering/throttle values (#922)
    Switched history vector to deque for performance
    [keras.py]
2021-09-02 fix-encoder-pipeline (#929)
    - the complete.py template hooked up the encoder parts
    using hard-coded values or defaults and ignored
    the configurations for MM_PER_TICK and ODOM_DEBUG.
    - In addition, the RotaryEncoder was given a
    hard coded value for the pin rather than use ODOM_PIN.
    - Finally, the RotaryEncoder was also using a default
    value for the poll_delay so polling was incorrect
    in anything exception the default vehicle loop rate.
    - This commit fixes the building of the pipeline
    in complete.py to use the correct configuration.
    It also calculates the poll_delay for the RotaryEncoder
    based on the DRIVE_LOOP_HZ configuration.
2021-09-03 added an image buffer to fix the artificial latency 6479fed22a72d72a4bce1fab7ebcd54a35b69000 (#919)
    author Maxime Ellerbach <maxime@ellerbach.net> 1629036953 +0200
    committer Maxime Ellerbach <maxime@ellerbach.net> 1630618548 +0200
    added an image buffer to fix the artificial latency
    [dgym.py]
2021-09-04 Add PS3 controller mapping for sixad (#931)
    Add PS3JoystickSixAdController to avoid conflict with original PS3JoystickController
    [controller.py]
2021-09-25 √937-import-imageaugmentation-causes-error (#939)
    ImageAugmentation is used during training. It is needed around line 467 of complete.py where cfg.TRANSFORMATIONS is used to determine if image augmentations will be applied during training. This breaks on a RaspberryPi when trying to drive because imgaug dependency is not installed. To fix this, we should move the import of ImageAugmentation from the top of complete.py to line 467 inside the if statement where it is needed, so no attempt is made to import it unless it is needed.
2021-11-28 954-fix-csic-camera-capture (#955)
    - csic camera would crash using resolution of 160x120
    on a Jetson Nano
    - this fixes it so it starts camera capture resolution to
    be the same as the image resolution, which fixes that issue.
    - the keras-viz CI error is completely independent of this change
2021-12-11 Install Jetson.GPIO on [nano] (#964)
    - it was incorrectly installing the raspberry pi only
    library RPi.GPIO
2021-12-11 * Add command `donkey models` to show the model database (#962)
    * Increase default MULTIPLY range from 1.5 to 3.0 as sunlight effects seem to have larger brightness effects than 1.5
    * Bump version to 4.3.1
    * Add option to delete pilots from the pilot database
    * Fix small issues in the UI, in particular in the car screen, like the file transfer bars and error handling, and using deepcopy in the UI's OverlayImage, to avoid manipulating the input record
    * Set default MODEL_CATEGORICAL_THROTTLE_RANGE to 0.8, as 0.5 is just too low. We have many tubs w/ throttle values larger 0.5.
    [base.py]
2021-12-23 961 protect from empty camera image (#967)
    * Protect warm PiCamera and CiscCamera until frame is available
    - prior code just waited a couple of seconds.
    - this new code now starts asking for frames and will wait
    until a frame is return or a timeout happens
    - Generally this is a more reliable and faster way to warm
    the camera; if it is going to work it will return a frame
    quickly. So start up is faster.
    - The warmup code also declares a better error if the camera can't
    start; it raises the error in the camera part rather than
    downstream where the image is used or later in the pipeline.
    That makes it easier to diagnose what is going on.
    * Protect cv_control.py from N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
    [camera.py]
2021-12-30 Fix missing import for UI and added windows support where tensorrt is not available (#975)
    * Fixed missing pyyaml in conda / pip setup. Also moved trt import into conversion function so the interpreter import doesn't fail on windows where trt is not fully supported.
    * * Add missing plotly in setup.py
    * * Bump version
    * Update superlinter to v4, as there are known issues with version 3, which we are hitting in this PR, too: https://github.com/github/super-linter/issues/2253
    [interpreter.py]
2022-01-04 945 refactor motor drivers (#951)
    * Create higher level abstraction for pins
    - abstract classes InputPin, OutputPin and PwmPin
    define interface for pin types.
    - input_pin_by_id(), output_pin_by_id(), pwm_pin_by_id()
    are factories for creating pins using various
    underlying technologies.
    - the point is to decouple the control of things like
    motors or encoders from a particular pin library,
    so we don't have to create a whole new redundant
    part if we want to use a different set of hardward.
    - For instance, our L298N motor driver parts use
    RPi.GPIO for enable pins and pwm pins. This means
    if you have a robot that uses a PCA9685 to control
    the enable and pwm for yo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
2022-01-20 Improve CI times by switching from conda to mamba (#981)
    * Improvement to the CI:
    * remove push docs, as this is legacy
    * in package and test:
    - break the job into small tasks with separate names, like checkout, install env, run tests, etc
    - switch from conda to mamba in order to speed up the conda env creation which has become very on many occasions
    * Bump version
2022-01-30 clamp differential drive throttle and steering (#983)
    - the throttle and steering passed to TwoWheelSteeringThrottle
    where just a 3/1000 over 1, but where triggering the
    check against a max of 1.
    - this commit simply clamps out of range values to the
    allowed range of -1 to 1 inclusive.
2022-02-01 970 enable rc controller in webui (#985)
    * Update web/rc/game controllers to share state
    https://github.com/autorope/donkeycar/issues/973
    Now controllers take mode and recording as inputs
    and use those as defaults. The idea is that if
    one of the controllers get's user input that
    changes that state, then it get's propagated
    to the next controller via these defaults.
    * Add code to update webui if controller changes modes/state
    - web.py will send websocket message with changes to the client
    - client will iterate through the changes and update fields in state
    - If state actually changed then client we redraw the UI
    * Fix code to send websocket message when mode changes
    * Make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
    [controller.py, robohat.py]
2022-02-23 Adding FastAI(pytorch) as a first class citizen to the pipeline (#982)
    * Squashing commits
    * Fixed basic issues
    * Refactored to use torch_data and removed specialised torch datasets.
    * Added fastai to training tests
    * Test will now do fastai test
    I will need to remove the code around tflite and tensor rt for fastai.
    * Added Fastai to the training tests and fixed issue with fastai implementation
    * Fixing namedtuple to have correct number of args
    [fastai.py, interpreter.py, keras.py, test_train.py]
2022-03-11 fix syntax error in the joystick creator (#995)
    [joystick_creator.py]
2022-03-17 989 namespace drivetrain configurations (#994)
    * Use python dict to namespace the various drivetrain configurations
    - There is one configuration for choosing the drivetrain.
    - However, each drivetrain has it's own lengthy set of configurations.
    - Some of these are shared among several drivetrains OR to avoid
    that they are prefixed and so identifiers become very long.
    - This commit moves each drivetrain's configuration into a python
    dict, effectively namespacing the configuration.
    - This allowed me to shorten the names of some configs since
    a prefix is not needed to disambiguate them. So some config
    names have changed
    - The bigger issue for users is that now, if they want t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
2022-03-31 Fix torch imports for rpi (#1004)
    * Moving torch imports into functions such that donkeycar can continue to work w/o pytorch installation. This is the default setup on RPi.
    * Bumped version
    [interpreter.py]
2022-04-21 1005 fix recording yet again (#1009)
    * fix JoystickController so it correctly latches recording state
    - needed to set latch when auto-record-on-throttle changed state
    - needed to set latch when toggling manual recording state
    - needed to apply latched state in run_threaded
    * Update logging in controller to be less verbose
    - also use real logging rather then print statements.
    * version=4.3.11
    [controller.py]
2022-04-22 Add gps.py part (#992)
    * Add gps.py part
    - reads gps coordinates as tuple (timestamp, longitude, latitude)
    * add utm dependency for gps part
    * big refactor to make it threadsafe and handle serial errors
    - note that currently it is not able to check for buffered
    chars on the mac; the Serial.in_waiting always returns 0.
    - this is a problem; it would be better to have the loop
    continue if no chars are waiting, rather than block.
    - I will test this on raspberrypi and nano and see if
    i can get that feature to work
    * Added in_waiting tests and multiple hit tests
    - Serial.in_waiting always returns 0 on mac, but it works on
    raspberrypi os, so I added it back in.
    - Added pl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
    [gps.py]
2022-04-22 Fixed bug introduced in PR #997 (#1011)
    Added missing argument in `donkey train`
    [base.py]
2022-04-26 Next gen lidar parts (#918)
    * update lidar.py with RPlidar2 and __main__
    - added a new part that streams measurements rather than scans
    in order to reduce the latency between retrieving full scans.
    - The part also will filter measurements by angle and distance.
    - The part will also adjust angles so that they increase in
    a counter-clockwise direction as is expected generally.
    The default is still angles increasing in a clockwise direction,
    since that is what the RPLidar does naturally.
    - The part will also adjust the zero-heading. This will adjust
    for different mounting of the lidar such that the physical
    front of the lidar is not longer pointing in the logical
    front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
2022-05-22 feat: dgym.py corrected for storing lidar data in sim (#1013)
    * feat: dgym.py corrected for storing lidar data in sim
    * docs: update setup.py with version
    [dgym.py]
2022-05-31 Update NMEA parser to handle bad chars (#1014)
    * Update NMEA parser to handle bad chars
    - it turns out that it is common for the first set of
    data returned by a gps module to include incorrectly
    framed characters that break the unicode conversion.
    - This change ignores exceptions thrown by the
    unicode decoder and keeps on going until it
    can read a correctly framed line.
    * return early if gps/nmea checksum is wrong
    - prior to this change it just kept going,
    but it should not try to parse a linve
    with a back checksum.
    * Remove debugging cruft
    * version="4.3.17"
    [gps.py]
2022-06-23 Fix passing of tub metadata (#1017)
    * According to the docopt string, the complete template should allow to a read tub metadata as --meta=foo:bar --meta=baz:44, but it doesn't. This change fixes it.
    * Move tub metadata parsing into Manifest and allow merging of metadata between command line and config METADATA
    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
    [datastore_v2.py]
2022-07-05 Adding VESC support to DonkeyCar (#1018)
    * Integrating Ivan's (@ivanferrier) changes for VESC
    * Adding steering scale and offset for different controllers
    * Changing to multiplication and updating config
    * Added comments on VESC parameters
    * Changed default offset to 0.5
    * Bumping setup.py version
2022-08-08 Add support for TFMini Lidar (#1031)
    * add tfmini code (not working)
    * it works now (and added other stuff)
    * fix for review
    * change logger scope and add note on poll delay
    [tfmini.py]
2022-08-09 Fix loss of steering in path_follow template (#1033)
    * Fix loss of steering in path_follow template
    - the CTE PID algorithm in path follow was predicting steering
    values that were way out of the -1 to 1 range.
    - This triggered a check that threw an exception.
    - Since the part was being run in a thread, throwing the exception
    kill the thread, so so the user would lose all steering control.
    - Even the auto-pilot would lose steering.
    - Part 1 of fix is to not throw an exception, but instead log
    and error and return.
    - Part 2 of the fix is to clamp all out of range values so
    that if the PID predicted an out of range value, it would be
    brought back into range.
    * remove bad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
    [actuator.py, test_actuator.py]
2022-08-14 1022 add programable buttons to webui (#1026)
    * Refactor webui into 2 columns mobile friendly layout
    * Update memory to take a single key/value pair
    - if key is a string, set the value directly.
    * Add ExplodeDict part to explode dictionary into memory
    - this will take a dictionary and add each individual
    key/value pair to vehicle memory
    - it will optionally insert a prefix into the output key/value
    - this will be used to write the button presses returned
    by the webUI into working memory.
    * Update webui to have 5 generic buttons
    - buttons, "w1" to "w5"
    - button presses are returned by the LocalWebController part
    - the dictionary of button presses isthen processed in the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
2022-08-18 Fix calibrate script (#1034)
    * Fix calibrate app after changes to the complete config to use the new pin identifiers
    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
2022-10-08 Move adding camera, controller, drivetrain into functions (#1042)
    - refactored complete.py to move adding of common parts
    into functions that can be shared with other templates
2022-10-15 UI Fixes / improvements
    Improve UI to allow filter in tub manager to be passed through into the trainer.
    Fix UI behaviour to better cope with uninitialised widgets when the user has no config or no tub loaded and starts clicking buttons.
2022-10-23 Robothat auto record on throttle (#1055)
    * Update robohat controller to honor AUTO_RECORD_ON_THROTTLE configuration
    - port mode and recording latching code from joystick controller
    because auto-record on throttle was not working correctly
    with the robohat MM1.
    * make RoboHATController.read_serial() latch recording change
    - when throttle changes then latch the new recording state
    [robohat.py]
2022-10-25 Try to fix test by creating mock outside of assignment. (#1049)
    [test_web_socket.py]
2022-11-05 Improve training performance when using augmentations / crop and minor model improvements (#1050)
    * Move the image processing into the TubRecord.image() function so it's result can be cached, too.
    * Move the image normalisation outside of the image processing in training so only the augmented images are getting cached - and they are uint8.
    * Simplified the pipeline function x_transform_and_process, x_translate, y_transform, y_translate by combining the transform / translate functions into the transform function because we can operate in a pipeline on the dictionaries that are returned by translate directly
    * Enable switching off image caching by re-introducing CACHE_IMAGES optionally in t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
2022-11-26 Add IMU_ADDRESS configuration (#1064)
    The MPU6050 and MPU9250 allow for two different I2C addresses based on how an input line is set. Our code does not support the secondary address, which is how the MM1 hat is setup. This code allows those IMUs to be used with their secondary address.
    - move construction of IMU part and addition to vehicle
    into a method in complete.py and make complete.py and
    path_follow.py use it.
    - add IMU_ADDRESS defaulted to 0x68 to cfg_complete.py
    and cfg_path_follow.py
    - make path follow use add_imu()
2022-11-26 1043 Handle crossing paths in path follow (#1058)
    Issue https://github.com/autorope/donkeycar/issues/1043
    Update the path_follow template so that it can handle paths that have cross-overs. The current code tests every point in the path to find the closest point. This means that it is possible that a point on a cross-over going in the opposite direction may get selected. The approach to fix this is to make the search start at the most recent closest point and limit the search to a configurable number of points. So for instance, consider a perfectly symmetrical figure 8 path with 1000 waypoints in the path whose origin is at the top of the figure 8; then the intersection as at point 250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
    [path.py, test_path.py]
2022-12-02 pin protobuf to 3.20.3 (#1067)
2022-12-15 Upgrade to newest version of pytorch (#1070)
    * Update to newest version of pytorch:
    * A couple of interface changes when creating the resnet model, in the Trainer and the model summary
    * Updated the yaml files to remove pytorch versions
    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
2022-12-16 Rebased on main and bumped version (#1069)
    Fix imu input in the complete template. The imu keras part expects an array for the imu data.
2023-02-03 Support velocity target on a waypoint in `path_follow` (#1068)
    * Create new CsvVelocityPath class
    * Record velocities with new CsvVelocityPath
    * Implement variable velocities in PIDPilot
    * Rename "velocity" references to "throttle" for clarity
    * Create new CsvVelocityPath class
    * Record velocities with new CsvVelocityPath
    * Implement variable velocities in PIDPilot
    * Rename "velocity" references to "throttle" for clarity
    * Convert to f-string
    * Update missing file info statement to warning
    * Add type hints
    * Record throttle path using a minimum throttle variable
    * Add return annotations
    * Implement `reset()` in csv throttle path class
    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
    [path.py, test_path.py]
2023-02-13 Adding VESC to the complete.py comments (#1087)
2023-02-16 921 kinematics pose estimation (#1089)
    * Add tachometer, odometer and kinematics part
    - tachometer takes an encoder and returns revolutions
    - odometer coverts revolutions to distance and velocity
    - kinematics converts odometry to pose estimates
    - BicyclePose part implements the pose estimation pipeline for a
    car-like vehicle (fixed back wheels, turnable front wheels)
    - UnicyclePose part implements the pose estimation pipeline
    for differential drive vehicles.
    * refactor pose estimation into a single part
    - UnicyclePose handles encoder/tachometer/odometer/kinematics
    for differential drive.
    - BicyclePose handles encoder/tachometer/odomter/kinematics
    for car-like vehicle
    -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
    [actuator.py, encoder.py, explode.py, kinematics.py, mono_encoder.ino]
2023-02-25 Fixing initialization of self.info (#1088)
    Fix do donkey gym lidar part
    [dgym.py]
2023-02-25 1085 upgrade computer vision template (#1091)
    * move LineFollower part into it's own file
    * Update cv_control template to use standard parts
    - uses methods in complete.py to add cameras, joystick,
    web controller, and drive trains.
    - update doc opts and the way the template launches to
    be more standard.
    * Cleanup cv.py a little
    - add logging
    - protect methods agains None image
    - fix spacing and remove unneed empty parens in class declaration
    to remove those lint warnings
    * fix output label of joystick controller to be 'cam/image_array'
    * Add code and config to convert BRG image to RGB image
    - my 'cvcam' outputs BRG by default. This change adds
    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
    [cv.py, line_follower.py]
2023-02-27 1104 fix user angle in deep learning (#1105)
    * fix user/angle in complete.py
    - that had been renamed user/steering in the PR that
    merged the computer vision template.
    - Much code in the deep learning pipeline explicitly
    hard-codes the literal `user/angle` so the deep learning
    code needs to continue to use that label.
    - This fix uses the Pipe() part to rename 'user/steering'
    to 'user/angle' immediately after it is emitted by the
    controller part.
    * pilot/steering -> pilot/angle
    * Fix pipe.py and complete.py
    - Pipe.py would output a bad tuple if only one argument
    was being passed throught. Now it explictly checks.
    - This caused complete.py to have invalid 'user/ang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
    [pipe.py]
2023-02-27 Added hsv_picker.sh script to support cv template (#1102)
    * Added hsv_picker.sh script to support cv template
    - this allow a user to select an area on an image
    and sample the low and high HSV value to create
    a mask, like is used in the cv_control template.
    - hsv_picker.sh script support picking from an image file
    or a video camera
2023-03-21 1109 refactor augmentations/transformations (#1111)
    * moved transformations to cv.py; added colorspace transforms
    * add parts for crop and trapeze transformations
    * Update training to use new transformations
    - image_transformations.py use cv.py parts for transforms
    - augmentations2.py remove old transformations
    - training.py updated to allow for transformations
    both before and after training augmentation.
    - cfg_complete.py added new tranformation config
    and a lot of documentation comments.
    * Port albumentations augmentations from Dirk's branch
    - replace imgaug with albumentations
    - update install to include albumentations
    * transforms from gray to color, cvcam resizes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
    [cv.py, image_transformations.py]
2023-06-20 Upgrade to python 3.9 and TF 2.9 (#1119)
    * Updating TF to 2.9 and python to 3.9
    * On Jetson 5.0.X use system python 3.8 with Nvidia's TF 2.9
    * Tensorrt models cannot be build on the PC any longer, but can be created at runtime on the Jetson during first inference. This might be slow.
    * Update gh actions accordingly
    * Small updates in the UI
    * On RPi use 64-bit Bullseye using Picamera2
    * Switch to using savedmodel format by default instead of legacy h5
    * Factor out predict method into interpreter base class, as now TF interfaces between different interpreters are aligned and can all be called by input dictionary.
    * Complying with pep-440 for version numbering of dev versions
2023-06-26 fix cv color conversions (#1133)
    - several of the color conversions were not correctly returning
    the converted image; return None instead.
    - this commit fixes those and makes all color conversions
    similar in how they return that converted image
    - This also adds a new transform; a version of the trapezoid
    mask that takes values from the edges of the image like
    the crop transform does (rather than absoluted image coordinates
    as the pre-existing trapezoid transform does).
    [cv.py]
2023-06-27 add a __main__ self-test configured with a json file (#1134)
    * add a __main__ self-test configured with a json file
    - the __main__ self-test can load an image from a file
    or use the video stream from a camera
    - It takes the path to a json file that specifies a
    list of image transforms, there order and their arguments
    - functions have been added to load and parse the json file
    and use it to construct the transform pipeline.
    - The transform pipeline is implemented with a run() method
    that applies the transforms in order.
    - Comments in the code document the json file format.
    * version=5.0.dev2
2023-07-05 Fixing setup.py for jetson (#1135)
    * Remove albumentations from jetson setup and move pyyaml into the required section, so it also installs on RPi.
    * Correct kivy/plotly install on jetson. There is no UI support on jetson nano, only on xavier, etc where we have JP 5.0.X.
2023-12-11 Comment: Updated test expression to remove logical short circuit. (#1144)
    Could not re-run the CI tests, but change is correct.
    [makemovie.py]
2023-12-20 Release 5.0 and installation with pip (#1153)
    * Created setup.cfg and pyproject.toml for DC install.
    * Remove obsolete conda yml files.
    * Avoid moviepy import error and fix ui behavior of merging deleted indexes which was missing its implementation in the datastore.
    * Adding Pi user and hostname, as this is required by the ui.
    * Add missing opencv for RPi
    * include scripts folder in pypi package
    * Make torch import local in test
    * Fixed tubwriter test after updating of session_id to be a tuple
    * Froze nano versions for numpy
    * Added target macos for install on apple arm in setup.cfg
    * Set version to right version for main branch commit.
    * Remove obsolete argument in tub
    [datastore_v2.py, makemovie.py, profile.py, test_torch.py, tub_v2.py]
2024-03-27 Upgrade to python 3.11 and TensorFlow 2.15.X (#1170)
    * Updating to py 3.11 and tf 2.15 / 2.13
    * Fix python version 3.11 in CI
    * Removed deprecated padding in ui and used modern form of package versioning in setup.
    * Fix telemetry test after paho upgrade
    [telemetry.py, test_telemetry.py, test_torch.py]
2024-04-01 Small fixes and updates for the python 3.11 upgrade (#1172)
    * Removed deprecated padding in ui
    * Used modern form of package versioning in setup.
    * Fix tensorrt interpreter for tf 2.15, which now returns a list instead of a dictionary.
    * Peg pytorch to version 2.1 to avoid incompatibilities with nvidia libraries
    * Fix warnings caused by using legacy warn() method instead of warning().
    * Switch of fastai trying to use cuda as this crashes if an Nvidia GPU is found.
    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
    [actuator.py, controller.py, fastai.py, interpreter.py, kinematics.py, pins.py, serial_port.py, tachometer.py]
2024-05-25 Fix augmentations and matplotlib (#1179)
    * * skip augmentations when list is empty
    * replacye spurios __file__ in load_config with os.getcwd()
    * pin matplotlib versions to 3.8.*
    * fix log statement in training
    * * fix layout height for ui widgets in macos (i.e. platform darwin)
    * * pin pytest to 8.1 for non-backwards compatible change
    * Fix test selection to correctly identify RPi hardware as 'aarch64' and not 'arm64' which is what Apple Silicon is now reporting.
2025-06-30 Update to new albumentations (#1209)
    * Fixed augmentation imports and test_train.py to use the new import paths.
    * Add reruns in pytest ini to fix flaky web socket tests.
    [test_train.py]
2025-07-24 Fix usage of Mock instances
    [test_web_socket.py]
2025-08-01 Web based track editor (#1206)
    * add new folder with files
    * Add TrackSpeedPlanner as regular folder
    * Updated for Tornado
    * Cleaned up to remove Node.js and Docker
    * Fixed some bugs
    CSVs now load properly without a header and file dialog has option to load from either Pi or local/laptop
    * Deleting unneeded files
    * Removed unnecessary files
    * Fixed local save
    * Make sure that exiting the program doesn't stop the Tornado server
    * Got rid of unnecessary shell script
    * Fix routing issue and create comprehensive documentation (#1210)
    * Fix routing issue and create comprehensive documentation
    - Fixed MainHandler routing conflict that prevented print statements from showing
    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
    [donkey_path (1)_1749922476174.csv, test_path.csv]
2025-08-01 Fix MQTT telemetry test reliability by replacing network dependency with mocks
    The original test relied on external MQTT broker connection which caused intermittent failures. This change:
    - Replaces real MQTT client with mocked instances to eliminate network dependency
    - Adds comprehensive test coverage for both success and error scenarios
    - Removes timing-dependent sleep calls and retry logic that caused flakiness
    - Ensures consistent test execution across all environments
    [test_telemetry.py]
2025-08-04 Fix WebSocket test race conditions with async polling
    Replace fixed sleep() calls with proper async polling to eliminate race conditions
    in WebSocket calibration tests. The tests were failing on macOS CI due to
    insufficient wait time for WebSocket message processing.
    Changes:
    - Add wait_for_attribute_value() helper method with 5-second timeout
    - Replace all sleep(SLEEP) calls with async polling in 7 tests
    - Remove unused imports (tornado.ioloop, time.sleep, SLEEP constant)
    - Add proper timeout error messages for better debugging
    Fixes intermittent test failures on slower CI environments while maintaining
    fast execution on local machines.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
    [test_web_socket.py]
2026-01-18 Disable camera alignment for Pi5 compatibility (#1221)
    Comment out camera alignment to fix resolution issues on Pi5.
    [camera.py]
2026-02-12 Fixed a bug in the TFLite PR (#1224)
    [interpreter.py, robohat.py]
2026-03-15 Add GPS/IMU sensor fusion class with EKF-based pose estimation
    Create a Class named GpsImuFusion that will do sensor fusion of the
    positions retrieved from GPS with the IMU data to maintain a car
    robot's pose (x, y, angle).
    - expect the GPS positions to come in between 5 to 20 samples per second.
    - the IMU data can be read much faster than this.
    - the Class should include a update(self) method that will be called in
    a thread to update values.
    - the Class should include a run_threaded(self) method that will return
    the most recently calculated robot pose.
    - Write a main function that will run the code in a loop and show
    position updates visually.
    - Save the result in parts/gps_imu_fused.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
2026-04-13 Upgrade main branch for Python 3.13 and LiteRT
    ## Summary
    - port the scoped Python 3.13 upgrade work onto a clean branch from
    `docgarbanzo/main`
    - add a step-by-step branch plan in `MAIN_PY313_UPGRADE_PLAN.md`
    - keep the detailed upgrade notes in `PYTHON313_UPGRADE.md`
    ## Dependency and CI updates
    - require Python 3.13 in `setup.cfg`
    - update TensorFlow / tf-keras to the Python 3.13-compatible 2.21 series
    - switch Pi TFLite runtime dependency to `ai-edge-litert`
    - update the conda CI workflow to test Python 3.13
    ## TensorFlow / Keras compatibility
    - replace deprecated `tensorflow.python.*` imports with supported
    `tensorflow.keras.*` and `tf.saved_model.*` APIs
    - update Keras 3 model sa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
    [base.py, datastore_v2.py, interpreter.py, keras.py, makemovie.py]
2026-04-18 Remove tensorflow-metal from macos extra (no Python 3.13 wheel)
    tensorflow-metal has no wheel for Python 3.13, causing installation to
    fail on macOS. Removing it until Apple ships a compatible release; TF
    2.21 will run CPU-only on macOS under Python 3.13.
2026-04-19 Migrate to Python 3.12 + uv; consolidate package metadata in pyproject.toml
    - Replace conda with uv for environment management; document venv locations
    (Pi: ~/env, Mac/PC: ~/.venvs/donkeycar) and activation in shell profile
    - Migrate all setup.cfg and MANIFEST.in content into pyproject.toml; delete
    both files so pyproject.toml is the single source of package metadata
    - Pin TF to 2.19.* across pc and macos extras — highest version compatible
    with tensorflow-metal 1.2.0 (TF 2.20+ breaks Metal GPU on macOS)
    - Add tensorflow-metal==1.2.0 to macos extra (first release with cp312 wheel)
    - Replace conda-based CI with uv + astral-sh/setup-uv@v5 on Python 3.12;
    rename workflow file to pytho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
2026-04-19 Support Python 3.13 on Pi; fix camera system-package install docs
    On Raspberry Pi OS Trixie the system Python is 3.13 and picamera2/libcamera
    are Debian packages (not pip-installable). The venv must use Python 3.13 with
    --system-site-packages to access them. Updated requires-python to <3.14,
    added Python 3.13 classifier, and documented the correct Pi setup in README.
2026-04-19 Clarify 3.12/3.13 platform split in migration docs
    Pi uses system Python 3.13 (camera libraries are Debian packages, not pip).
    Mac/PC must stay on Python 3.12 (TF 2.19 + tensorflow-metal broken on 3.13).
    Corrects stale claims about uv bundled CPython on Pi and updates install
    workflow, dependency table, and document title accordingly.
2026-04-19 Remove SavedModel as user-facing format; migrate to .keras for Keras 3
    Keras 3 (TF 2.16+) no longer supports saving/loading Keras models as
    SavedModel directories via keras.models.load_model(). The native format
    is now .keras. SavedModel is retained only as an internal intermediate
    for TensorRT conversion.
    - Replace .savedmodel with .keras in all UI filters and transfer logic
    - Remove dead guard in training.py that checked for .savedmodel input
    - Update KerasInterpreter.load() comment to reflect export-time losses
    - Remove broken TensorRT.load() branch that tried to load .savedmodel
    as a Keras model (broken in Keras 3; users should use .trt instead)
    - Update test variable names f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
    [convert_to_tflite.py, interpreter.py, test_keras.py]
2026-04-19 Drop nano extra; Jetson Nano does not support Python 3.12
    The nano extra pinned numpy==1.23.* which conflicts with the project's
    numpy>=1.26.0 base dependency. Jetson Nano hardware cannot run Python
    3.12, so the extra is dead code on this branch.
2026-04-19 Fix test markers and CI Python version pinning
    - KerasLSTM: mark xfail (CudnnRNNV3 op not supported in TFLite without CUDA)
    - Keras3D_CNN: remove xfail (Flex delegate now auto-loaded via ai-edge-litert)
    - CI: explicitly create venv with matrix Python version before installing,
    so tests always run on the correct Python rather than the system default
    [test_keras.py]
2026-04-19 Fix KerasLSTM xfail strictness and add .venv to .gitignore
    CudnnRNNV3 is unsupported in TFLite on macOS but works on Linux; using
    strict=False allows XPASS on Linux and XFAIL on macOS without failing CI.
    Also add .venv to .gitignore to prevent accidental project-local venv commits.
    [test_keras.py]
2026-05-09 Upgrade torch to 2.11, fix optional-dep test skipping, update env docs
    - pyproject.toml: bump torch 2.6→2.11, torchvision 0.21→0.26,
    torchaudio 2.6→2.11 (latest compatible set)
    - test_torch.py: skip whole module with install instructions when torch
    is absent (allow_module_level=True), remove per-test skipif decorators
    - test_train.py: replace in-test importorskip with pytest.param marks
    pattern for fastai test case
    - train_screen.py: clear Keras session before training to avoid layer
    name conflicts; improve error logging with full traceback
    - pilot_screen.kv: replace f-string with .format() for KV compatibility
    [test_torch.py, test_train.py]
2026-05-09 Switch from abandoned docopt to maintained docopt-ng
    Fixes SyntaxWarnings on Python 3.12/3.13 caused by unescaped backslashes
    in docopt's regex strings. docopt-ng is a drop-in replacement with no
    import or API changes required.
2026-05-14 Fix tensorflow-metal compatibility and deprecation warnings
    - Disable XLA/JIT in Keras 3 (jit_compile=False) to fix tensorflow-metal gradient corruption on macOS
    - Update Keras 3 optimizer API: lr= → learning_rate=, decay → ExponentialDecay schedule
    - Enable PyTorch MPS (Apple GPU) support in torch_train; fix dead gpus variable never passed to Trainer
    - Replace deprecated logger.warn with logger.warning (Python 3.12+)
    - Add filter='data' to tarfile.extractall to fix Python 3.14 deprecation
    - Update torchvision ResNet18 API: pretrained= → weights=ResNet18_Weights.IMAGENET1K_V1
    [interpreter.py, keras.py, test_scripts.py, test_torch.py, test_train.py]
2026-05-15 - add Metal-specific training-step handling to keep compiled training fast while avoiding incorrect Adam updates - wire the Metal training path through Keras/interpreter compilation and fitting - pre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
    - `donkeycar/parts/interpreter.py`
    - `donkeycar/parts/keras.py`
    - `donkeycar/pipeline/training.py`
    - `donkeycar/tests/test_metal_gradients.py`
    - `CLAUDE.md`
    - `pytest`
    - result: `505 passed, 19 skipped, 1 xfailed`
    - forced commit/push requested by user because tool-level test gate still reported fa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
    [interpreter.py, keras.py, test_metal_gradients.py]
2026-08-08 Fixed OAK-D FOV cropping and single-stream RuntimeError from previous PR (#1238)
    * Fixed OAK-D FOV cropping and single-stream RuntimeError from previous PR
    * Added new config parameters for FOV behaviors
    ---------
    [oak_d.py]
2026-08-17 Migrate to Python 3.12/3.13, uv, and Keras 3 (.keras format) (#1233)
    * Upgrade main branch for Python 3.13 and LiteRT
    `t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
    [base.py, convert_to_tflite.py, datastore_v2.py]
2026-11-02 Replace the deprecated Adafruit_PCA9685 library with the CircuitPython driver (#1251)
    * Add ExplicitBusI2C, an I2C bus addressed by number
    The CircuitPython drivers want a busio.I2C, which Blinka builds from board pin
    objects and so needs adafruit-platformdetect to recognise the board. It does
    not recognise every Linux SBC -- on an Arduino Uno Q it reports both chip and
    board as None, so `import board` raises even though /dev/i2c-* work fine.
    ExplicitBusI2C opens a bus by number instead, which suits donkeycar anyway:
    the bus number is already part of a pin id ("PCA9685.1:40.7") and of
    PCA9685_I2C_BUSNUM.
    Blinka's generic-Linux backend already covers most of the busio.I2C surface,
    so this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
